peteryates1/jop-spinalhdl/docs/architecture/system-configuration.md

# JOP System Configuration Reference

This document describes the configuration parameters for JOP system generation.
All configuration is via Scala case classes — no external config files are needed.

## Configuration Hierarchy

```
JopConfig                               # Top-level: assembly + systems
├── assembly: SystemAssembly            # Physical hardware (board, FPGA, devices)
│   ├── fpgaBoard: Board                # Board with devices, pin mappings, LEDs
│   └── fpga: FpgaDevice                # FPGA chip (family, package, speed grade)
├── systems: Seq[JopSystem]             # Processor cluster(s)
│   └── JopSystem                       # A single processor system
│       ├── memory: String              # Memory device name or role ("bram" for on-chip)
│       ├── bootMode: BootMode          # Serial, Flash, or Simulation
│       ├── clkFreq: HertzNumber        # System clock frequency (after PLL)
│       ├── cpuCnt: Int                 # Number of CPU cores
│       ├── coreConfig: JopCoreConfig   # Default core configuration
│       ├── perCoreConfigs: Option[Seq[JopCoreConfig]]  # Per-core overrides
│       └── devices: Map[String, DeviceInstance]  # I/O devices (DeviceType + params + board part); core 0 gets them
├── interconnect: Option[InterconnectConfig]  # Cross-system (multi-system only)
└── monitors: Seq[MonitorConfig]        # Hardware monitors (watchdog, etc.)

JopTop(config: JopConfig)              # Unified FPGA top-level Component
├── PLL factory                        # Board-specific PLL BlackBox
├── ResetGenerator                     # 3-bit counter gated by PLL locked
├── JopCluster                         # N cores + arbiter + CmpSync
├── MemoryControllerFactory            # BRAM / SDR / DDR3 dispatch
└── HangDetector                       # Optional diagnostic UART mux

JopCluster                             # Instantiated by JopTop
├── cpuCnt: Int                        # Number of CPU cores
├── baseConfig: JopCoreConfig          # Shared core configuration
│   ├── memConfig: JopMemoryConfig     # Memory layout and bus parameters
│   ├── devices: Map[String, DeviceInstance]  # This core's I/O devices (empty: core 0 takes the system's)
│   ├── useStackCache: Boolean         # 3-bank rotating stack cache with DMA spill/fill
│   └── useIhlu: Boolean               # Per-object hardware locking (vs global lock)
├── debugConfig: DebugConfig           # Optional on-chip debug subsystem
└── separateStackDmaBus: Boolean       # Separate BMB bus for stack DMA (test harness only)
```

### Verilog Generation

All Verilog is generated through `JopTopVerilog` with named presets:

```bash
sbt "runMain jop.system.JopTopVerilog <preset> [args]"
```

| Preset | Board | Memory | Entity Name |
|---|---|---|---|
| `ep4cgx150Serial` | QMTECH EP4CGX150 | SDR SDRAM | `JopSdramTop` |
| `ep4cgx150Smp N` | QMTECH EP4CGX150 | SDR SDRAM | `JopSmpSdramTop` |
| `ep4cgx150HwMath` | QMTECH EP4CGX150 | SDR SDRAM | `JopSdramTop` |
| `ep4cgx150HwFloat` | QMTECH EP4CGX150 | SDR SDRAM | `JopSdramTop` |
| `cyc5000Serial` | Trenz CYC5000 | SDR SDRAM | `JopCyc5000Top` |
| `auSerial` | Alchitry Au V2 | DDR3 | `JopDdr3Top` |
| `wukongSdram` | Wukong XC7A100T | SDR SDRAM | `JopSdramWukongTop` |
| `wukongDdr3` | Wukong XC7A100T | DDR3 | `JopDdr3WukongTop` |
| `wukongBram` | Wukong XC7A100T | BRAM | `JopBramWukongTop` |
| `wukongDdr3AllCu` | Wukong XC7A100T | DDR3 | `JopDdr3WukongTop` |
| `wukongSdrAllCu` | Wukong XC7A100T | SDR SDRAM | `JopSdramWukongTop` |
| `wukongFull` | Wukong XC7A100T | DDR3 | `JopDdr3WukongTop` |
| `wukongSdrFull` | Wukong XC7A100T | SDR SDRAM | `JopSdramWukongTop` |
| `wukongSmp N` | Wukong XC7A100T | DDR3 | `JopSmpDdr3WukongTop` |
| `wukongDualIndependent` | Wukong XC7A100T | DDR3 + SDR | `JopDualWukongTop` |
| `wukongDualSmp N` | Wukong XC7A100T | DDR3 + SDR | `JopDualWukongTop` |
| `ep4cgx150DbFull` | QMTECH EP4CGX150 + DB_FPGA V4 | SDR SDRAM | `JopSdramTop` |
| `ep4cgx150DbV5Mii`, `ep4cgx150DbV5Eth` | QMTECH EP4CGX150 + DB_FPGA V5 | SDR SDRAM | `JopSdramTop` |
| `ae115fbDdr2`, `ae115fbDdr2Eth` | A-E115FB EP4CE115 | DDR2 | `JopDdr2Ae115fbTop` |
| `xc7a100tDbSerial`, `xc7a100tDbEth` | QMTECH XC7A100T + DB_FPGA V5 | DDR3 | `JopDdr3Top` |
| `colorlightI5Sdram` | Colorlight i5 (ECP5) | SDR SDRAM | `JopSdramI5Top` |
| `colorlightDbI9PlusSdram`, `colorlightDbI9PlusEth` | Colorlight i9+ (XC7A50T) on its base board | SDR SDRAM | `JopSdramI9PlusTop` |
| `minimum` | QMTECH EP4CGX150 | SDR SDRAM | `JopSdramTop` |
| `max1000Sdram` | Arrow MAX1000 | SDR SDRAM | `JopMax1000SdramTop` |
| `ep4ce6Sdram` | Generic EP4CE6 | SDR SDRAM | `JopEp4ce6SdramTop` |

This is a selection: the `match` in `JopTopVerilog.scala` is the complete list
(about fifty presets). The entity name is derived, not chosen —
`JopConfig.entityName` builds `Jop[Smp]<memory><board>Top` — so presets for one
board share it.

The `max1000Sdram` and `ep4ce6Sdram` presets use `smallFpgaMemConfig` which disables
object and array caches (`useOcache = false`, `useAcache = false`) to save ~1,900 LEs.
They also auto-select `MemoryStyle.AlteraLpm` for BRAM inference via LPM megafunctions.

Entity names are backward-compatible with existing Quartus/Vivado projects.

## Memory Layout

### Physical Address Space

JOP uses a 32-bit address space partitioned by the top 2 bits:

| Bits [31:30] | Range | Use |
|:---:|---|---|
| `00` | `0x00000000`–`0x3FFFFFFF` | Main memory (BRAM / SDRAM / DDR3) |
| `01` | `0x40000000`–`0x7FFFFFFF` | Reserved |
| `10` | `0x80000000`–`0xBFFFFFFF` | Scratchpad RAM (4KB) |
| `11` | `0xC0000000`–`0xFFFFFFFF` | I/O space |

### Main Memory Map

Without stack cache (`useStackCache = false`):

```
Word Address
0x000000  ┌──────────────────┐
          │   .jop program   │  Code, class data, constants
          │                  │
appEnd    ├──────────────────┤
          │  Handle area     │  handle_cnt * 8 words
          ├──────────────────┤
          │     Heap         │  Object/array data (GC managed)
          │  (grows up →)    │
mem_size  └──────────────────┘
```

With stack cache and per-core stack regions (`stackRegionWordsPerCore > 0`):

```
Word Address
0x000000  ┌──────────────────┐
          │   .jop program   │  Code, class data, constants
          │                  │
appEnd    ├──────────────────┤
          │   Handle area    │  handle_cnt * 8 words
          ├──────────────────┤
          │       Heap       │  Object/array data (GC managed)
          │   (grows up →)   │
memEnd    ├──────────────────┤  memEnd = memWords - cpuCnt * stackRegion
          │  Core N-1 stack  │  Highest-numbered core (lowest address)
          ├──────────────────┤
          │       ...        │
          ├──────────────────┤
          │  Core 1 stack    │
          ├──────────────────┤
          │  Core 0 stack    │  Core 0 at highest address
memWords  └──────────────────┘  Top of physical memory
```

The Java runtime reads `IO_MEM_SIZE` (Sys register 14) to determine `memEnd`.
When `IO_MEM_SIZE` returns 0, `Startup` falls back to `appEnd + 262144`, 1 MB of
heap past the image. JopSim answers the register too, with the end of its own
memory, since 2026-11-11 ([item 154](../current-status.md#item-154)).

### Stack Cache Spill Addressing

Each core's stack spill region starts at `spillBaseAddr` and grows upward:

```
spillBaseAddr = memWords - (cpuId + 1) * stackRegionWordsPerCore
```

Within the region, bank data is written at offset `(bankBase - scratchSize)` words
from `spillBaseAddr`. The 3-bank rotating cache spills/fills individual 192-word
banks via DMA as the virtual stack pointer crosses bank boundaries.

## JopCoreConfig

Unified configuration for a single JOP core. Defined in `jop/config/JopCoreConfig.scala`.

### Core Parameters

| Parameter | Type | Default | Description |
|---|---|---|---|
| `dataWidth` | Int | 32 | Data path width (fixed) |
| `pcWidth` | Int | 11 | Microcode PC width (2K ROM) |
| `instrWidth` | Int | 10 | Microcode instruction width |
| `jpcWidth` | Int | **13** | Java PC width (**8KB** method cache). Was 11 (2KB) until 2026-08-20; raising it is worth **+35 % Kfl** — see current-status item 51 |
| `ramWidth` | Int | 8 | Stack RAM address width (256 entries) |
| `blockBits` | Int | **6** | Method cache block bits (**64 blocks** x 32 words). Block COUNT caps how many methods are resident, and is the parameter that mattered. Costs LUTs (a comparator per block); `jpcWidth` costs only BRAM — see [tuning-guide.md](tuning-guide.md) |

### Memory and I/O

| Parameter | Type | Default | Description |
|---|---|---|---|
| `memConfig` | JopMemoryConfig | default | Memory system configuration |
| `devices` | Map[String, DeviceInstance] | empty | This core's I/O devices, e.g. `"eth" -> DeviceInstance(DeviceType.Ethernet, params = Map("gmii" -> true))`. Empty on core 0 means the system's `devices` |
| `clkFreq` | HertzNumber | 100 MHz | System clock frequency (for Sys microsecond prescaler) |
| `supersetJumpTable` | JumpTableInitData | simulation | Superset jump table (all HW handlers present). Patched by `resolveJumpTable()`. |

### CPU

| Parameter | Type | Default | Description |
|---|---|---|---|
| `cpuId` | Int | 0 | CPU identifier (set per-core by JopCluster) |
| `cpuCnt` | Int | 1 | Total CPU count (set by JopCluster) |

### Feature Flags

| Parameter | Type | Default | Description |
|---|---|---|---|
| `useIhlu` | Boolean | false | Use IHLU per-object lock (vs CmpSync global lock) |
| `useStackCache` | Boolean | false | Enable 3-bank rotating stack cache with DMA |
| `spillBaseAddrOverride` | Option[Int] | None | Override spill address (e.g., `Some(0)` for dedicated spill BRAM) |
| `useDspMul` | Boolean | false | Use 1-cycle DSP multiplier in ALU (bypasses CU for imul) |
| `useSyncRam` | Option[Boolean] | None | Stack RAM read mode: `None` = auto (always sync), `Some(true)` = force readSync, `Some(false)` = force readAsync. Auto-resolved by `JopConfig.resolvedSystems`. |
| `memoryStyle` | Option[MemoryStyle] | None | Memory primitive style: `None` = auto (AlteraLpm for Altera, Generic for others). `AlteraLpm` instantiates `lpm_rom`/`lpm_ram_dp` BlackBoxes with .mif initialization (required for MAX10 BRAM inference). `Generic` uses SpinalHDL `Mem` with init. Auto-resolved by `JopConfig.resolvedSystems` from FPGA manufacturer. |

### Per-Bytecode Implementation Fields

Each field selects the `Implementation` for one bytecode (see below).

**Integer** (IntegerComputeUnit):

| Parameter | Default | Description |
|---|---|---|
| `imul` | Microcode | Microcode=shift-add ~35cyc, Hardware=CU ~22cyc or DSP 2cyc |
| `idiv` | Hardware | Hardware=IntegerComputeUnit DivUnit ~36cyc |
| `irem` | Hardware | Hardware=IntegerComputeUnit DivUnit ~36cyc |

**Float** (FloatComputeUnit):

| Parameter | Default | Description |
|---|---|---|
| `fadd` | Java | IEEE 754 single-precision add |
| `fsub` | Java | IEEE 754 single-precision subtract |
| `fmul` | Java | IEEE 754 single-precision multiply |
| `fdiv` | Java | IEEE 754 single-precision divide |
| `fneg` | Java | Hardware = microcode XOR sign bit (no CU needed) |
| `i2f` | Java | int-to-float conversion |
| `f2i` | Java | float-to-int conversion |
| `fcmpl` | Java | float compare (NaN → -1) |
| `fcmpg` | Java | float compare (NaN → 1) |

**Long** (LongComputeUnit):

| Parameter | Default | Description |
|---|---|---|
| `ladd` | Microcode | 64-bit add |
| `lsub` | Microcode | 64-bit subtract |
| `lmul` | Microcode | 64-bit multiply |
| `lneg` | Microcode | 64-bit negate (implemented as lsub(0L - value)) |
| `lshl` | Microcode | 64-bit shift left |
| `lshr` | Microcode | 64-bit arithmetic shift right |
| `lushr` | Microcode | 64-bit logical shift right |
| `lcmp` | Microcode | 64-bit compare |

**Double** (DoubleComputeUnit):

| Parameter | Default | Description |
|---|---|---|
| `dadd` | Java | IEEE 754 double-precision add |
| `dsub` | Java | IEEE 754 double-precision subtract |
| `dmul` | Java | IEEE 754 double-precision multiply |
| `ddiv` | Java | IEEE 754 double-precision divide |
| `i2d` | Java | int-to-double conversion |
| `d2i` | Java | double-to-int conversion |
| `l2d` | Java | long-to-double conversion |
| `d2l` | Java | double-to-long conversion |
| `f2d` | Java | float-to-double conversion |
| `d2f` | Java | double-to-float conversion |
| `dcmpl` | Java | double compare (NaN → -1) |
| `dcmpg` | Java | double compare (NaN → 1) |

### Per-Bytecode Implementation

Every configurable bytecode has three implementation options:

| Option | Jump Table | Meaning |
|---|---|---|
| `Implementation.Java` | sys_noim | JOPizer replaces with invokestatic -> Java runtime |
| `Implementation.Microcode` | alt handler | Pure microcode handler (no HW compute unit) |
| `Implementation.Hardware` | HW handler | Microcode triggers `sthw` -> compute unit |

Not all options are valid for every bytecode:
- **IMP_ASM bytecodes** (imul, long ops): Java is invalid -- JOPizer doesn't replace them
- **IMP_JAVA bytecodes** (double ops): Microcode is invalid -- no SW handler exists

Derived hardware instantiation:
- `needsIntegerCompute` = any of imul/idiv/irem is Hardware -> IntegerComputeUnit
- `needsFloatCompute` = any float op is Hardware -> FloatComputeUnit
- `needsLongCompute` = any long op is Hardware -> LongComputeUnit
- `needsDoubleCompute` = any double op is Hardware -> DoubleComputeUnit

When `useDspMul = true` and `imul = Hardware`, the jump table is patched to a DSP-specific
handler (`imul_dsp`) that uses a 1-cycle DSP multiply instead of the radix-4 iterative path.

### Superset ROM + Jump Table Patching

The old model of per-variant ROMs (simulationFpu, serialDsp, etc.) has been replaced.
Three superset ROMs exist -- one per boot mode (serial, flash, simulation). Each contains
ALL microcode handlers (HW and SW). At elaboration, `resolveJumpTable` patches entries:

| Boot Mode | Superset ROM | Jump Table |
|---|---|---|
| Serial | `JumpTableInitData.serial` | Patched by `resolveJumpTable` |
| Flash | `JumpTableInitData.flash` | Patched by `resolveJumpTable` |
| Simulation | `JumpTableInitData.simulation` | Patched by `resolveJumpTable` |

`resolveJumpTable` reads the per-bytecode `Implementation` from `JopCoreConfig` and patches:
- **Java** -> `disable(bc)` (redirect to sys_noim)
- **Microcode** -> `useAlt(bc)` (use alternate SW handler)
- **Hardware** -> keep default HW handler (or `useDspAlt(bc)` for DSP imul)

## JopMemoryConfig

Memory system parameters. Defined in `jop/memory/JopMemoryConfig.scala`.

| Parameter | Type | Default | Description |
|---|---|---|---|
| `dataWidth` | Int | 32 | Data path width (fixed) |
| `addressWidth` | Int | 24 | Word address width including 2 type bits (24 = 64MB, 28 max = 256MB) |
| `mainMemSize` | BigInt | 8MB | Main memory size in bytes |
| `scratchSize` | BigInt | 4KB | Scratchpad RAM size in bytes |
| `burstLen` | Int | 0 | DMA burst length: 0=BRAM, 4=SDR, 8=DDR3 |
| `useOcache` | Boolean | true | Enable object cache (16-entry, 8 fields) |
| `ocacheWayBits` | Int | 4 | Object cache entries (log2) |
| `ocacheIndexBits` | Int | 3 | Fields per cache entry (log2) |
| `ocacheMaxIndexBits` | Int | 8 | Max field index (256 fields/object) |
| `useAcache` | Boolean | true | Enable array cache (16-entry, 4 elements/line) |
| `acacheWayBits` | Int | 4 | Array cache entries (log2) |
| `acacheFieldBits` | Int | 2 | Elements per cache line (log2) |
| `acacheMaxIndexBits` | Int | 24 | Max array index width |
| `stackRegionWordsPerCore` | Int | 0 | Per-core stack region size in words (0 = legacy) |

### burstLen Values

| Value | Memory Type | Description |
|:---:|---|---|
| 0 | BRAM | Pipelined single-word reads (no burst) |
| 4 | SDR SDRAM | 4-word burst (16 bytes) |
| 8 | DDR3 | 8-word burst (32 bytes) |

**Note:** `burstLen=0` is incompatible with SMP (`cpuCnt > 1`) due to BMB arbiter
interleaving during BC_FILL. SMP requires `burstLen >= 4`.

### stackRegionWordsPerCore

When set to a non-zero value, each core gets a dedicated stack spill region at the
top of main memory. The usable memory for heap is reduced accordingly. The value is
exposed to the Java runtime via the `IO_MEM_SIZE` I/O register.

Recommended values:
- **8192** (32KB) — sufficient for most Java applications
- **16384** (64KB) — deep recursion or large stack frames

## StackCacheConfig

Stack cache parameters (active when `useStackCache = true`).
Defined in `jop/pipeline/StackStage.scala`.

| Parameter | Type | Default | Description |
|---|---|---|---|
| `numBanks` | Int | 3 | Bank count (fixed: active + ready + anti-thrash) |
| `bankSize` | Int | 192 | Usable entries per bank |
| `scratchSize` | Int | 64 | Scratch area size (addresses 0-63, never rotated) |
| `virtualSpWidth` | Int | 16 | Virtual SP/VP/AR register width |
| `spillBaseAddr` | Int | 0x780000 | Spill area base word address (auto-computed) |
| `burstLen` | Int | 4 | DMA burst length (inherited from JopMemoryConfig) |
| `wordAddrWidth` | Int | 24 | Word address width |

The `spillBaseAddr` is normally computed automatically by `JopCoreConfig`:
- **stackRegionWordsPerCore > 0**: `memWords - (cpuId + 1) * stackRegionWordsPerCore`
- **Legacy BRAM** (burstLen=0): `memWords * 3/4 + cpuId * 4096`
- **Legacy SDRAM/DDR3**: `0x780000 + cpuId * 0x8000`

## Device Configuration

I/O devices are declared per-system via `devices: Map[String, DeviceInstance]`.
Device presence queries (`hasUart`, `hasEth`, etc.) are derived from the device map.
Per-core device distribution is handled by `JopSystem.coreConfigs` (core 0 inherits
system devices, cores 1+ empty by default; `perCoreConfigs` with explicit devices overrides).

### Available Device Types

| Device Type | BMB Component | Description |
|---|---|---|
| `uart` | Uart | TX/RX with 16-entry FIFOs |
| `ethernet` | Eth + Mdio | Ethernet MAC (params: `gmii`, `phyDataWidth`) |
| `sdspi` | SdSpi | SD card via SPI mode |
| `sdnative` | SdNative | SD card native 4-bit mode |
| `vgadma` | VgaBmbDma | VGA framebuffer with DMA |
| `vgatext` | VgaText | VGA text-mode controller |
| `cfgflash` | BmbCfgFlash | SPI config flash (W25Q128/SST26) |

### I/O Address Map

Addresses are dynamically allocated by `IoAddressAllocator`. Fixed addresses:

| ioAddr Range | Peripheral | Notes |
|:---:|---|---|
| `0xEE–0xEF` | Boot device (UART or cfgFlash) | Fixed |
| `0xF0–0xFF` | Sys (system registers) | Fixed |
| `0x80–0xED` | Other devices | Dynamically allocated |

## DebugConfig

On-chip debug subsystem. Defined in `jop/debug/DebugConfig.scala`.

| Parameter | Type | Default | Description |
|---|---|---|---|
| `numBreakpoints` | Int | 4 | Hardware breakpoint slots per core (0-8) |
| `baudRate` | Int | 1000000 | Debug UART baud rate in Hz |
| `hasMemAccess` | Boolean | true | Enable BMB master for memory access |

## CacheConfig (DDR3 L2)

L2 write-back cache for DDR3 memory path. Defined in `jop/ddr3/CacheConfig.scala`.

| Parameter | Type | Default | Description |
|---|---|---|---|
| `addrWidth` | Int | 28 | Address width in bits |
| `dataWidth` | Int | 128 | Cache line width in bits (must be byte-aligned) |
| `setCount` | Int | 256 | Cache sets (must be power-of-2) |
| `wayCount` | Int | 4 | Associativity (1, 2, or 4 way only) |

## Sys I/O Register Map

System I/O device at base address `0xFFFFFF80` (`Const.IO_BASE`).
4-bit sub-address (registers 0-15).

| Addr | Read | Write | Java Constant |
|:---:|---|---|---|
| 0 | Clock cycle counter | Interrupt enable | `IO_CNT` / `IO_INT_ENA` |
| 1 | Microsecond counter | Timer compare value | `IO_US_CNT` / `IO_TIMER` |
| 2 | Interrupt source number | SW interrupt trigger | `IO_INTNR` / `IO_SWINT` |
| 3 | — | Watchdog | `IO_WD` |
| 4 | Exception type | Exception trigger | `IO_EXCPT` |
| 5 | Lock status (halted, error) | Lock acquire | `IO_LOCK` |
| 6 | CPU ID | Lock release | `IO_CPU_ID` / `IO_UNLOCK` |
| 7 | Signal (boot sync) | Signal set | `IO_SIGNAL` |
| 8 | — | Interrupt mask | `IO_INTMASK` |
| 9 | — | Clear all interrupts | `IO_INTCLEARALL` |
| 10 | — | Deadline | `IO_DEADLINE` |
| 11 | CPU count | — | `IO_CPUCNT` |
| 12 | — | Performance counter reset | `IO_PERFCNT` |
| 13 | — | GC halt (freeze other cores) | `IO_GC_HALT` |
| 14 | Usable memory end (words) | — | `IO_MEM_SIZE` |
| 15 | FPU capability (1=present) | — | `IO_FPU_CAP` |

## Board Configurations (JopConfig Presets)

All board configurations are defined as `JopConfig` presets in `jop/config/JopConfig.scala`.
The unified `JopTop(config)` component handles all boards — no per-board top files needed.

### QMTECH EP4CGX150 — SDR SDRAM (Primary)

```scala
JopConfig.ep4cgx150Serial
// JopConfig(
//   assembly = SystemAssembly.qmtechWithDb,
//   systems = Seq(JopSystem(
//     name = "main", memory = "W9825G6JH6", bootMode = BootMode.Serial,
//     clkFreq = 80 MHz,
//     drivers = Seq(DeviceDriver.Uart, DeviceDriver.EthGmii, DeviceDriver.SdNative))))
// SDRAM: W9825G6JH6, 256Mbit, CAS=3
// SMP: JopConfig.ep4cgx150Smp(n) for 2-16 cores
```

### Trenz CYC5000 — SDR SDRAM

```scala
JopConfig.cyc5000Serial
// JopConfig(
//   assembly = SystemAssembly.cyc5000,
//   systems = Seq(JopSystem(
//     name = "main", memory = "W9864G6JT", bootMode = BootMode.Serial,
//     clkFreq = 100 MHz, drivers = Seq(DeviceDriver.UartFt2232))))
// SDRAM: W9864G6JT, 64Mbit, CAS=2
```

### Alchitry Au V2 — DDR3

```scala
JopConfig.auSerial
// JopConfig(
//   assembly = SystemAssembly.alchitryAuV2,
//   systems = Seq(JopSystem(
//     name = "main", memory = "MT41K128M16JT-125:K", bootMode = BootMode.Serial,
//     clkFreq = 250/3 MHz, drivers = Seq(DeviceDriver.UartFt2232))))
// DDR3: MT41K128M16JT, 2Gbit (256MB)
// Write-back cache: 32KB L2 (4-way, 512 sets)
// GC: MAX_HANDLES=65536 caps handle table for large memory
```

### QMTECH XC7A100T Wukong V3 — DDR3 / SDR / BRAM

```scala
JopConfig.wukongDdr3     // DDR3 via MIG, WukongMigBlackBox (no CS pin)
JopConfig.wukongSdram    // SDR SDRAM via SdramCtrlNoCke
JopConfig.wukongBram     // On-chip BRAM (simulation boot mode)
JopConfig.wukongFull     // DDR3 + full HW: ICU+FCU+LCU+DCU+DSP imul, Ethernet, SD
JopConfig.wukongSdrFull  // SDR + full HW: ICU+FCU+LCU+DCU+DSP imul, Ethernet, SD
// All single-system use SystemAssembly.wukong with DeviceDriver.UartCh340

// Dual-cluster (two independent JOP clusters in one bitstream):
JopConfig.wukongDualIndependent  // DDR3 + SDR, both 100 MHz, IDENTICAL cores, 1+1
JopConfig.wukongDualSmp(n)       // DDR3 (all CUs, 100 MHz) + SDR (no CUs, 80 MHz), N+N cores
// wukongDualIndependent is a MEASUREMENT rig: it exists to compare two memory
// systems on one die, so both halves must stay identical in everything except
// the memory (idiv/irem=hw, no DSP multiply, same clock, perf counters on).
// It used to differ -- all CUs one side, defaults the other -- which put a
// compute difference inside a memory experiment. Do not re-introduce one.
// DDR3 -> PICO_UART1 (F4/H4), SDR -> J11_UART (A5/A4): the CH340N at E3/F3 is
// hardwired on the PCB and cannot be tapped, so the on-board Pico 2 W provides
// both ports and the two halves can be profiled simultaneously.
// Entity name: JopDualWukongTop
```

### Compute Unit Presets

| Preset | Compute Units | Notes |
|---|---|---|
| `ep4cgx150HwMath` | ICU (idiv+irem) | IntegerComputeUnit only |
| `ep4cgx150HwFloat` | ICU + FCU | Integer + Float compute |
| `wukongFull` | ICU + FCU + LCU + DCU + DSP imul | All 4 CUs + DSP multiply |
| `wukongSdrFull` | ICU + FCU + LCU + DCU + DSP imul | SDR variant of wukongFull |
| `minimum` | None | Pure microcode imul, Java idiv/irem |

### Minimum Resources

```scala
JopConfig.minimum  // Pure microcode imul, Java idiv/irem, UART only
```

### Simulation Harnesses

```scala
// Unified JopTop BRAM simulation (JopTopBramSim)
JopTop(
  config = JopConfig.wukongBram,
  romInit = romData, ramInit = ramData,
  mainMemInit = Some(mainMemData), mainMemSize = 256 * 1024,
  simulation = true  // Bypasses PLL/reset/MIG for Verilator
)

// Legacy BRAM simulation (JopCoreTestHarness — still works)
JopCoreConfig(
  memConfig = JopMemoryConfig(mainMemSize = 256 * 1024)  // 256KB
)

// Stack cache simulation (JopStackCacheTestHarness)
JopCoreConfig(
  memConfig = JopMemoryConfig(mainMemSize = 512 * 1024),
  useStackCache = true,
  spillBaseAddrOverride = Some(0)  // Dedicated spill BRAM at address 0
)
// Uses separateStackDmaBus=true with 64KB dedicated spill BRAM
```

## JopCluster

System-level integration. Defined in `jop/system/JopCluster.scala`.

| Parameter | Type | Default | Description |
|---|---|---|---|
| `cpuCnt` | Int | (required) | Number of CPU cores (1 = single-core, 2+ = SMP) |
| `baseConfig` | JopCoreConfig | (required) | Base core config (cpuId/cpuCnt overridden per core) |
| `debugConfig` | Option[DebugConfig] | None | Debug subsystem (None = no debug, zero cost) |
| `romInit` | Option[Seq[BigInt]] | None | Microcode ROM initialization |
| `ramInit` | Option[Seq[BigInt]] | None | Stack RAM initialization |
| `jbcInit` | Option[Seq[BigInt]] | None | JBC RAM initialization |
| `separateStackDmaBus` | Boolean | false | Route stack DMA to separate BMB port |
| `perCoreConfigs` | Option[Seq[JopCoreConfig]] | None | Per-core config overrides (devices, bytecodes) |

### SMP Behaviour

- **cpuCnt = 1**: Direct BMB connection (no arbiter overhead)
- **cpuCnt >= 2**: Round-robin BMB arbiter + CmpSync (or IHLU) for synchronization
- Each core gets a unique `cpuId` (0 to cpuCnt-1)
- Devices are per-core: core 0 inherits system `devices`, cores 1+ get empty by default
- Per-core UART: put UART in each core's `perCoreConfigs` devices for SMP debug
- Boot: Core 0 runs init; other cores wait for `IO_SIGNAL`
