peteryates1/jop-spinalhdl/docs/architecture/dual-subsystem-design.md

# Dual-Subsystem Architecture

**Status**: Implemented (Phase 2) — dual independent clusters running concurrently.

**Target board**: QMTECH XC7A100T Wukong V3 (DDR3 + SDR SDRAM on-board).

## Contents

- [Overview](#overview)
- [Motivation](#motivation)
- [Architecture](#architecture)
  - [SDR Subsystem — I/O Cores](#sdr-subsystem--io-cores)
  - [DDR3 Subsystem — Compute Cores](#ddr3-subsystem--compute-cores)
  - [Inter-Subsystem Message Queues](#inter-subsystem-message-queues)
  - [Independent Watchdog FSM](#independent-watchdog-fsm)
- [Hardware Resources](#hardware-resources)
  - [Memory Bandwidth Budget](#memory-bandwidth-budget)
  - [FPGA Resource Budget](#fpga-resource-budget)
- [Software Model](#software-model)
  - [Message Queue I/O Registers](#message-queue-io-registers)
  - [Work Offload Pattern](#work-offload-pattern)
  - [Boot Sequence](#boot-sequence)
- [Implementation Plan](#implementation-plan)
- [Future Extensions](#future-extensions)

## Overview

The QMTECH Wukong V3 board has two independent memory subsystems on-board:
DDR3 (256 MB, 1.35V, Bank 16) and SDR SDRAM (32 MB, 3.3V, Bank 15). This
design exploits both by running two independent JOP clusters — lightweight
cores on SDR for I/O tasks, heavyweight cores on DDR3 for computation — with
FIFO-based message passing and an independent hardware watchdog.

```
┌──────────────────────────────┐    ┌──────────────────────────────┐
│     SDR SDRAM Subsystem      │    │      DDR3 Subsystem          │
│        (100 MHz)             │    │        (100 MHz)             │
│                              │    │                              │
│  Light JOP cores (1-4)       │    │  Heavy JOP cores (1-4)       │
│  - Integer-only microcode    │    │  - DSP multiply              │
│  - No compute units          │    │  - HW integer divider        │
│  - Small method cache        │    │  - Long/Float/Double units   │
│                              │    │  - Larger caches             │
│  I/O peripherals:            │    │  Compute duties:             │
│  - Ethernet (GMII)           │    │  - Application logic         │
│  - SD card (native 4-bit)    │    │  - Math-heavy workloads      │
│  - UART (USB CH340N)         │    │  - Data processing           │
│  - VGA text (80x30)          │    │  - VGA DMA framebuffer       │
│  - GPIO / LEDs               │    │                              │
│                              │    │                              │
│   tx_fifo ──────────────────────────────────────────► rx_fifo    │
│   rx_fifo ◄────────────────────────────────────────── tx_fifo    │
│                              │    │                              │
│   heartbeat ─┐               │    │               ┌─ heartbeat   │
│              │               │    │               │              │
└──────────────┼───────────────┘    └───────────────┼──────────────┘
               │                                    │
        ┌──────┴────────────────────────────────────┴──────┐
        │              Watchdog FSM (pure RTL)             │
        │                                                  │
        │  heartbeat_sdr ──► timeout counter ──► reset_sdr │
        │  heartbeat_ddr3 ──► timeout counter ──► reset_ddr│
        │                                                  │
        │  Clock: raw 50 MHz oscillator (independent)      │
        │  Outputs: reset_n, status LEDs, error flag       │
        └──────────────────────────────────────────────────┘
```

## Motivation

### Heterogeneous Core Complexity

JOP cores vary significantly depending on which bytecode compute units are
enabled:

| Core Variant | Compute Units | Approx. LUTs | Approx. BRAMs |
|---|---|---|---|
| Minimal (integer-only) | None | ~2,000 | ~6 |
| With DSP multiply | `IntMul` | ~2,500 | ~6 |
| With DSP mul + HW div | `IntMul` + `IntDiv` | ~3,500 | ~6 |
| Full (Long/Float/Double) | All | ~10,000-15,000 | ~15-20 |

Putting heavyweight cores on I/O polling tasks wastes FPGA resources. A light
core handles Ethernet MAC polling, SD card transfers, and UART I/O just as
effectively as a full core — bytecodes like `getfield`, `putfield`, `iaload`,
`iastore`, and I/O reads/writes are all integer operations.

### Fault Isolation

Two independent subsystems provide natural fault domains:

- A runaway computation on DDR3 cannot starve I/O cores of memory bandwidth
- A misbehaving peripheral cannot crash the compute subsystem
- The watchdog FSM is pure RTL with no software — nothing can crash it
- Either subsystem can be independently reset without affecting the other

### Bandwidth Matching

| Memory | Peak BW | Effective BW | Suitable For |
|---|---|---|---|
| SDR SDRAM (16-bit, 100 MHz) | ~400 MB/s | ~100-130 MB/s | I/O + 1-4 light cores |
| DDR3 (16-bit, DDR3-1333) | ~2,670 MB/s | ~1,600-1,900 MB/s | Compute + 1-4 heavy cores |

Ethernet at 1 Gbps is ~125 MB/s — SDR handles this alongside a few light
cores. DDR3 is free for computation without I/O contention.

## Architecture

### SDR Subsystem — I/O Cores

Runs on the existing JOP SDRAM controller (`JopSdramTop` style), 100 MHz
system clock derived from the 50 MHz oscillator via PLL.

**Cores**: 1-4 lightweight JOP cores with integer-only microcode. No DSP
multiply, no HW divider, no floating-point units. Stack cache optional
(DMA burst length 4 for SDR).

**Peripherals** (directly connected via BMB I/O):
- Ethernet MAC (GMII, RTL8211EG PHY)
- SD card (native 4-bit interface)
- UART (CH340N USB bridge)
- VGA text controller (80x30, optional)
- GPIO (LEDs, buttons)
- Message queue registers (to DDR3 subsystem)
- Watchdog heartbeat register

**Memory map**: Standard JOP layout — code + heap in SDR SDRAM, I/O at
`0xC0000000`, scratchpad at `0x80000000`.

### DDR3 Subsystem — Compute Cores

Runs on the DDR3 MIG controller (`JopDdr3Top` style), 100 MHz system clock
from MIG `ui_clk`. LruCacheCore L2 cache between BMB arbiter and MIG.

**Cores**: 1-4 heavyweight JOP cores with full compute units enabled:
- DSP multiply (`useDspMul = true`)
- HW integer divider (`useHwDiv = true`)
- Long arithmetic unit (future)
- Float unit (future)
- Double unit (future)

Uses `perCoreConfigs` if cores need different compute unit mixes.

**Peripherals** (minimal I/O):
- Message queue registers (to SDR subsystem)
- Watchdog heartbeat register
- VGA DMA framebuffer (optional — 640x480 or 1080p@30 depending on use case)
- Debug UART (optional, separate from main UART)

**Memory map**: Standard JOP layout — code + heap in DDR3, I/O at
`0xC0000000`, scratchpad at `0x80000000`.

### Inter-Subsystem Message Queues

Two `StreamFifoCC` instances provide bidirectional clock-domain-crossing
communication between the 100 MHz SDR domain and 100 MHz DDR3 domain.

```
     SDR domain (100 MHz)             DDR3 domain (100 MHz)
           │                                   │
           ├──► StreamFifoCC(32 bits, depth N) ►│   SDR → DDR3
           │                                   │
           │◄── StreamFifoCC(32 bits, depth N) ◄┤   DDR3 → SDR
           │                                   │
```

**FIFO parameters**:
- Data width: 32 bits (one JOP word per entry)
- Depth: 16-64 entries (configurable, power of 2 for StreamFifoCC)
- CDC: Gray-code pointer synchronization (built into StreamFifoCC)

**Message format** (application-defined, example):

| Word | Content |
|---|---|
| 0 | Command / message type (upper 8 bits) + length (lower 24 bits) |
| 1..N | Payload words |

Multi-word messages are sent as sequential FIFO pushes. Software is
responsible for framing — the hardware just moves words.

**Backpressure**: StreamFifoCC provides `full` and `empty` signals. Software
polls status before push/pop. No flow control beyond FIFO capacity — sender
must check `full` before writing.

### Independent Watchdog FSM

A pure-RTL finite state machine, outside both JOP clusters, clocked from the
raw 50 MHz oscillator (not from either PLL). This ensures the watchdog runs
even if a PLL loses lock.

**Inputs**:
- `heartbeat_sdr` — toggle signal from SDR subsystem (synchronized to 50 MHz)
- `heartbeat_ddr3` — toggle signal from DDR3 subsystem (synchronized to 50 MHz)

**Outputs**:
- `reset_sdr_n` — active-low reset to SDR subsystem
- `reset_ddr3_n` — active-low reset to DDR3 subsystem
- `status_leds[1:0]` — alive indicators (directly on board LEDs)
- `wd_error` — sticky error flag (optional, directly readable)

**Operation**:
1. Each subsystem toggles its heartbeat register periodically (e.g. every
   10 ms from a timer interrupt or a software loop)
2. The watchdog detects toggles via edge detection (XOR with previous sample)
3. Each toggle resets that subsystem's timeout counter
4. If a counter reaches the timeout threshold (e.g. 50 ms at 50 MHz =
   2,500,000 cycles), the watchdog asserts reset for that subsystem
5. Reset is held for a minimum pulse width (e.g. 1 ms), then released
6. Optional: if one subsystem fails N consecutive times, reset both

**Resource cost**: ~50 LUTs, 2 synchronizer chains, 2 counters. Negligible.

**Software interface**: Each subsystem has a single I/O register. Writing any
value toggles the heartbeat output. Typical usage:

```java
// In main loop or timer interrupt
Native.wr(heartbeat, Native.rd(heartbeat) ^ 1);
```

## Hardware Resources

### Memory Bandwidth Budget

**SDR Subsystem** (W9825G6KH-6, 16-bit, 100 MHz — bandwidth figures below were
computed at the original 80 MHz and have not been rescaled):

| Consumer | Bandwidth | Notes |
|---|---|---|
| 2 light JOP cores | ~100-150 MB/s | ~50-75 MB/s per core |
| Ethernet DMA | ~125 MB/s | 1 Gbps wire rate, bursty |
| VGA text | ~2 MB/s | 80x30 @ 60 Hz, minimal |
| **Total** | ~230-280 MB/s | Fits in ~320 MB/s peak |

With 2 light cores and Ethernet, SDR utilization is ~70-85%. A third core is
possible if Ethernet traffic is bursty (typical). Four cores would need
careful bandwidth management.

**DDR3 Subsystem** (MT41K128M16JT-125, 16-bit, DDR3-1333):

| Consumer | Bandwidth | Notes |
|---|---|---|
| 4 heavy JOP cores | ~200-400 MB/s | ~50-100 MB/s per core |
| VGA DMA (optional) | ~50-150 MB/s | 640x480: 50, 1080p@30: 150 |
| **Total** | ~250-550 MB/s | Well within ~1,600 MB/s effective |

DDR3 utilization with 4 heavy cores + VGA DMA is ~15-35%. Substantial
headroom for memory-intensive workloads or more cores.

### FPGA Resource Budget

XC7A100T-FGG676: 63,400 LUTs, 135,680 FFs, 270 BRAMs (36Kb), 240 DSP48E1.

| Component | LUTs | BRAMs | DSP48 | Notes |
|---|---|---|---|---|
| **SDR Subsystem** | | | | |
| SDR memory controller | ~500 | 0 | 0 | |
| 2x light JOP cores | ~4,000 | ~12 | 0 | Integer-only |
| Ethernet MAC + buffers | ~2,000 | ~4 | 0 | |
| SD card controller | ~500 | ~1 | 0 | |
| UART + VGA text | ~1,000 | ~4 | 0 | Including font ROM |
| BMB arbiter + I/O | ~500 | 0 | 0 | |
| **SDR subtotal** | **~8,500** | **~21** | **0** | |
| **DDR3 Subsystem** | | | | |
| MIG controller | ~5,000 | ~5 | 0 | Xilinx IP |
| LruCacheCore L2 | ~2,000 | ~8 | 0 | 16KB 4-way |
| 2x heavy JOP cores | ~20,000-30,000 | ~30-40 | ~8-16 | Full compute |
| VGA DMA (optional) | ~1,000 | ~2 | 0 | |
| BMB arbiter + I/O | ~500 | 0 | 0 | |
| **DDR3 subtotal** | **~28,500-38,500** | **~45-55** | **~8-16** | |
| **Shared** | | | | |
| Message FIFOs (2x) | ~200 | 0 | 0 | Distributed RAM |
| Watchdog FSM | ~50 | 0 | 0 | |
| PLLs (3x) | 0 | 0 | 0 | MMCM primitives |
| **Shared subtotal** | **~250** | **0** | **0** | |
| | | | | |
| **Total** | **~37,000-47,000** | **~66-76** | **~8-16** | |
| **Available** | 63,400 | 270 | 240 | |
| **Utilization** | 58-74% | 24-28% | 3-7% | |

Comfortable fit. Room for additional cores or larger compute units.

## Software Model

### Message Queue I/O Registers

Each subsystem sees the message queue as memory-mapped I/O registers:

| Offset | Register | R/W | Description |
|---|---|---|---|
| +0 | `MSG_STATUS` | R | Bit 0: TX FIFO full, Bit 1: RX FIFO empty |
| +1 | `MSG_TX` | W | Push one word to TX FIFO (SDR→DDR3 or DDR3→SDR) |
| +2 | `MSG_RX` | R | Pop one word from RX FIFO |

```java
public class MsgQueue {
    public static final int IO_MSG = IO_BASE + 0x50;  // example offset

    public static boolean canSend() {
        return (Native.rd(IO_MSG) & 1) == 0;  // TX not full
    }

    public static boolean hasMessage() {
        return (Native.rd(IO_MSG) & 2) == 0;  // RX not empty
    }

    public static void send(int word) {
        Native.wr(IO_MSG + 1, word);
    }

    public static int receive() {
        return Native.rd(IO_MSG + 2);
    }
}
```

### Work Offload Pattern

The I/O subsystem receives external data (Ethernet packet, SD block, sensor
reading) and offloads processing to the compute subsystem:

```
SDR core                          DDR3 core
   │                                  │
   │  receive Ethernet packet         │
   │  extract payload                 │
   │  send(CMD_PROCESS | len)    ──►  │  receive command
   │  send(word0)                ──►  │  receive data
   │  send(word1)                ──►  │  receive data
   │  ...                             │  process...
   │                                  │  send(RSP_RESULT | len)
   │  receive response           ◄──  │  send(result0)
   │  send reply over Ethernet        │
   │                                  │
```

The message protocol is application-defined. The hardware provides raw
word-level FIFO transport.

### Boot Sequence

Both subsystems boot independently from their respective memories:

1. FPGA configuration loads bitstream from SPI flash
2. Watchdog FSM releases both resets
3. **SDR subsystem** boots from embedded BRAM (or config flash loader),
   initializes I/O peripherals
4. **DDR3 subsystem** waits for MIG calibration, then boots from BRAM
5. Both subsystems begin toggling heartbeat
6. SDR subsystem can optionally load DDR3 application code via message
   queue (enables updating compute firmware over Ethernet/SD)

Alternative: both subsystems have their own config flash loader and boot
independently from SPI flash partitions.

## Implementation Status

### Phase 1: Single-Subsystem DDR3 -- DONE

JOP cluster running on DDR3 via MIG on Wukong. Validated DDR3 memory path,
MIG integration, and pin assignments. Serial boot + GC + 59/59 JVM tests.

### Phase 2: Dual Memory Controllers -- DONE

Two independent JOP clusters running concurrently in a single bitstream.
Each cluster has its own clock domain, memory controller, and UART.

**Implementation**:
- `JopTop` extended with multi-system support: iterates `config.systems`,
  instantiating one `JopCluster` + memory controller per system
- Cluster 0 (DDR3): All compute units (ICU+FCU+LCU+DCU+DSP imul), 100 MHz
  (MIG `ui_clk`), CH340N UART (E3/F3)
- Cluster 1 (SDR SDRAM): No compute units, 100 MHz (`sdr_clk`, was `clk_wiz_1`), J11 header
  UART (A5/A4)
- Each cluster boots independently via serial download on its own UART
- Entity name: `JopDualWukongTop`

**Presets**:
- `wukongDualIndependent` — 1 DDR3 core + 1 SDR core (independent serial boot)
- `wukongDualSmp N` — N DDR3 cores + N SDR cores (SMP within each cluster)

**FPGA utilization** (XC7A100T-2FGG676):

| Config | LUTs | % | WNS |
|---|:----:|:-:|:---:|
| 1+1 cores (`wukongDualIndependent`) | 28,043 | 44.2% | +0.034 ns |
| 2+2 cores (`wukongDualSmp 2`) | 46,644 | 73.6% | +0.013 ns |

**FPGA build**:
```bash
cd fpga/qmtech-xc7a100t-wukong
make dual-generate       # sbt "runMain jop.system.JopTopVerilog wukongDualIndependent"
make ddr3-create-ip      # MIG IP (once); each half's PLL is built with the design
make dual-build          # Vivado synth + impl + bitstream
```

**Clock domains**:
- DDR3 cluster: 100 MHz from MIG `ui_clk` (derived from 200 MHz MIG reference)
- SDR cluster: 100 MHz from `sdr_clk` (was `clk_wiz_1`; 50 MHz oscillator input). 80 MHz hangs
  on hardware -- see "Phase 2 Resolved" below before changing this.
- Both PLLs run from the same 50 MHz board oscillator (M21)

#### Phase 2 Debug: SDR Cluster Hang (2026-03-15)

**Symptom**: DDR3 cluster boots and runs "Hello World" successfully. SDR cluster
accepts serial download (XOR checksum passes) but hangs during GC init — UART
outputs `.Small boot.GC init....` then stops.

**Ruled out by simulation and analysis**:

1. **SdramCtrlNoCke logic at 80 MHz**: `JopSdram80MhzSim` passes with burstLen=0
   at 80 MHz. Takes ~9M cycles (vs ~500k with burstLen=4) because every BC_FILL
   word is an individual SDRAM access. Previous 2M cycle limit was too short.
2. **burstLen=0 logic bug**: Sim passes cleanly. The `buildMultiCoreConfigs` sets
   burstLen=0 for single-core SDR, which is correct — just slower.
3. **Generated Verilog wiring**: All clock domains, reset, SDRAM signals, UART MUX
   verified correct in `JopDualWukongTop.v`.
4. **Internal SDR timing**: clk_100_sdr_clk (was clk_100_clk_wiz_1) domain meets timing (WNS=+0.229ns).
   DDR3 domain (clk_pll_i) also meets (WNS=+0.006ns).
5. **Clock phase shift**: -108° at 80 MHz gives 3.75 ns lead (more margin than
   100 MHz's 3.0 ns). W9825G6KH-6 requires 1.5 ns setup, 0.8 ns hold.

**Suspected at the time — DQ writeEnable IOB packing failure** (later disproved,
see below):

The timing report shows 16 failing endpoints, all `chip_sdram_DQ_writeEnable_reg`
paths from clk_100_sdr_clk (was clk_100_clk_wiz_1) to SDRAM output ports. WNS=-0.378ns. The
writeEnable register (at SLICE_X0Y110) controls the DQ tri-state buffer (OBUFT).
Path breakdown: FDRE C→Q (0.379ns) + routing (1.652ns, fanout=16) + OBUFT
(3.347ns) = 5.378ns vs 5.0ns `set_max_delay` constraint.

This is significant because `writeEnable` controls the DQ tri-state direction.
If it switches late, the FPGA may still drive DQ when SDRAM tries to return read
data (bus contention on reads), or the tri-state may not enable in time for
writes (SDRAM sees floating data lines).

The download checksum does NOT detect this — it's computed from UART-received
data, not SDRAM readback. (Confirmed in microcode: `asm/src/jvm.asm:881`
accumulates `b ^= c` from the word just received, immediately after `stmwd`, so a
completely dead SDRAM still returns a correct checksum. Any future "it downloads
but won't run" symptom should skip the checksum as evidence.)

**Test harness**: `JopSdram80MhzSim` — 80 MHz, burstLen=0, 10M cycle limit.

#### Phase 2 Resolved: SDR Cluster Hang (2026-08-08)

**Fix**: run the dual build's SDR cluster at **100 MHz**, not 80 MHz. This is the
frequency the standalone SDR presets have always used. With it, both clusters run
`DoAll` **66/66 concurrently** from a single programming (SDR on the J11 UART at
115200, DDR3 on the CH340 at 2 Mbaud).

The frequency lived in three uncoupled places that had to agree, and nothing
checked them — `sdrClkMhz` in `JopConfig`, the `getOrElse` defaults in
`JopTopVerilog`, and CLKOUT1/CLKOUT2 in `create_sdram_clk_wiz.tcl`. Since
2026-11-02 (status item 173) each half defines its own PLL from its own clock,
and the build makes the IP from that definition: `sdrClkMhz` is the only place.

(Was `create_sdram_clk_wiz_1.tcl` until 2026-08-17. The dual cluster's SDR clock
had been raised 80→100 MHz, making that script config-identical to the standalone
one, so the two were collapsed into a single function-named `sdr_clk` that both
the dual and standalone SDR flows share. The DDR3 cluster's wizard is `ddr3_clk`;
neither can clobber the other now. Since 2026-11-02 each is the design's own,
generated into the build's `ip/` with its Verilog.)

**The IOB-packing suspect above was disproved by measurement.** Opening both
post-route checkpoints and querying the register directly:

| | standalone (**works**) | dual @80 MHz (**hangs**) |
|---|---|---|
| `chip_sdram_DQ_writeEnable_reg` count | 1 | 1 |
| fanout | 17 | 17 |
| placement | SLICE_X48Y57 | SLICE_X0Y110 |
| `IOB` property | unset | TRUE |

Neither design packs the register into an IOB — with fanout 17 it cannot be, as a
tri-state IOB register serves exactly one pin. The *working* design does not pack
it either, and is placed considerably further from the I/O bank. So the packing
failure is real but is not what breaks the cluster.

Also disproved, for the record:

- **The `set_max_delay 5.0` violation is not the fault.** It persisted unchanged
  across the fix (-0.376 ns at 80 MHz, -0.365 ns at 100 MHz) while behaviour went
  from hanging to 66/66. Note the standalone builds do **not** apply this
  constraint at all, so their WNS figures are for unrelated internal core paths
  and must not be compared against the dual's.
- **Clock frequency was not compensating for the phase shift.** Lowering to
  70 MHz (which changes the `sdram_clk` lead from 3.75 to 4.29 ns) moved WNS by
  0.011 ns and did not help — as expected, since `set_max_delay` is an absolute
  budget and cannot be relaxed by slowing the clock.

**The mechanism remains unexplained.** 80 MHz is the *slower*, nominally easier
operating point, it passes in simulation (`JopSdram80MhzSim`), and it meets
internal timing. Only 100 MHz is validated on hardware; treat any other SDR
frequency in this design as unproven until it is run on a board. If 80 MHz is
wanted for the bandwidth/resource reasons in the Motivation section above, it
needs a proper investigation rather than a config change.

### Phase 3: Message Queues -- Future

`StreamFifoCC` pair between subsystems for cross-cluster communication.

### Phase 4: Watchdog FSM -- Future

Independent watchdog clocked from raw 50 MHz oscillator.

### Phase 5: Heterogeneous Cores -- Partially Done

The dual-cluster design already achieves heterogeneous core differentiation:
DDR3 cluster has full compute units, SDR cluster is integer-only. Remaining
work is I/O peripheral migration (Ethernet, SD to SDR cluster only).

## Open Questions

- **Message queue depth**: 16 vs 64 entries — depends on message size and
  latency tolerance. Larger FIFOs buffer more but cost distributed RAM.
- **Shared BRAM vs FIFO-only**: For bulk data (e.g. Ethernet frames), a
  shared dual-port BRAM may be more efficient than streaming through FIFOs.
  Trade-off is added complexity and potential coherence issues.
- **Boot coordination**: Currently both clusters boot independently via
  serial download. Future: SDR subsystem loads DDR3 firmware, or both boot
  from flash partitions.
- **Interrupt vs polling**: Message arrival could trigger an interrupt instead
  of polling. Adds hardware complexity but reduces latency.
- **Watchdog policy**: Should failure of one subsystem reset the other?
  Application-dependent — safety-critical vs fault-tolerant designs differ.

## Future Extensions

- **DVI-D / HDMI output**: Drive HDMI connector from DDR3 subsystem via
  OSERDESE2 TMDS serializers. VGA DMA framebuffer feeds pixel data.
  640x480@60 or 1080p@30 (74.25 MHz pixel clock).

- **Remote firmware update**: SDR I/O core receives new DDR3 firmware
  over Ethernet, loads via message queue, then triggers DDR3 reset.

- **Hardware mailbox**: Extend message queue with interrupt support
  (IRQ on message arrival) to replace polling.

- **Shared memory region**: Small dual-port BRAM accessible from both
  subsystems for bulk data transfer (bypassing FIFO for large payloads).

- **Triple modular redundancy**: Three light cores on SDR with voting
  for safety-critical I/O control.
