peteryates1/jop-spinalhdl/docs/current-status.md

# Where we are

> ## How to read this file
>
> | you want | go to |
> |---|---|
> | **what to work on next** | [§1 Outstanding now](#1-outstanding-now--in-priority-order) — highest first |
> | **whether item N is open** | [§2 All items](#2-all-items--summary) — the scannable index |
> | **why item N is the way it is** | [§3 Item detail](#3-item-detail-and-journals) — summary and gotchas per item |
> | **the full investigation** | `docs/status/item-N.md` — linked from each item that has one |
> | **where NOT to spend effort** | [item 50](#item-50) and [`architecture/tuning-guide.md`](architecture/tuning-guide.md) — the measured negative results |
>
> **Item numbers are stable IDs**, not reading order, and they are referenced
> from other documents and from commit messages. `#item-N` anchors resolve for
> all of them.
>
> **The longest journals live in `docs/status/`** since 2026-08-31 (item 116).
> This file was 9,671 lines and the review auditing it had to be told not to
> open it whole. The summary, the verdict and the gotchas stay here; the
> narrative of how it was found moved out. Nothing was deleted — the split was
> verified byte-identical.
>
> `make check-build` asserts every item is anchored, no anchor is defined twice,
> every `#item-N` link in the repo resolves, no CLOSED item sits in the priority
> list, every journal is present and linked, and §2 lists every item exactly
> once with its Open list equal to §1 (since 2026-10-13).

## 1. Outstanding now — in priority order

One line each, highest first. **This section is the ground truth for what is
open** — an outstanding item from any other document belongs here too, not only
there. Reasoning and journals are in [section 3](#3-item-detail-and-journals);
closed items stay in [section 2](#2-all-items--summary).

The order is a proposal, not a decree. It puts work that CORRECTS OR PROTECTS
THE RECORD first — a wrong answer about the product costs one bug, but a wrong
answer about the evidence costs confidence in every result built on it — then
correctness defects, then capability gaps, then performance. A broken capability
nothing depends on ranks below a measurement that could mislead someone.

1. **[#180](#item-180)** — Fifteen formal properties have never checked anything: an assertion under `pastValidAfterReset()` is first reached at BMC depth 4 (calibrated 2026-11-12: a guarded `assert(False)` passes at 2 and 3), and they run at depth 2 or 3. The jump table's four are fixed with [item 165](#item-165); `ShiftFormal`'s four, six in `StackStageFormal` and one in `Crc8MaximFormal` remain, and the formal job's pass count includes them
2. **[#130](#item-130)** — `JopTop` silently overrides four `memConfig` fields the preset declares, so presets, summaries and harnesses describe a different machine than the one built. Verified against elaborated RTL
3. **[#178](#item-178)** — The JOP cluster carrier (four i9+ on one board, linked by a mesh) is not made yet: one bitstream serves all four sockets, taking its straps and its UART pins from the PCB's tables, and builds clean in Vivado; the PCB netlist matches pin plan v2, and in the layout each link's lines match in length to 1.1 mm. XDC fixes go back to its designer, and bank VCCO, the speed grade, the ETH1 LED pins, the Ethernet pairs' impedance and what the modules' flash holds stay open. Ranked here because the plan has to settle before the board is made
4. **[#110](#item-110)** — Three corpora have never been reviewed (~106k lines: runtime, tools, RTL, microcode). The frem defect lived on a boundary a single-corpus review cannot see
5. **[#119](#item-119)** — The object handle layout is re-expressed in ~25 places across four languages, and the RTL's only use of it has no test, no formal property and no elaboration check
6. **[#138](#item-138)** — The class-struct layout is restated in four languages and header word 1 has no name: `JVMHelp.java:313,322` read it as `rdMem(p+1)`, and nothing ties `CLS_HEAD` to what JOPizer emits. Nothing is broken today; a header reorder would leave a board with no output at all
7. **[#121](#item-121)** — Absent devices all resolve to 0x80 and the `HAS_*` flags meant to guard them are read by nothing
8. **[#122](#item-122)** — `JopCore` and `ConstGenerator` run the I/O allocator over different device sets
9. **[#124](#item-124)** — On Altera the microcode comes from the `.mif`, one call site decides which variant, and the summary omits it
10. **[#125](#item-125)** — `run_bench` hardcodes the baud per board, uses port paths, and can drive the wrong board
11. **[#126](#item-126)** — The baud derivation is never exercised by its own guard: `check-console-baud.sh` passes `BAUD=` explicitly, so `console.mk`'s grep/awk never runs against a real summary
12. **[#113](#item-113)** — `cold-check` covers 3 boards of 12, and the primary board is not one of them
13. **[#112](#item-112)** — `ConstraintDriftTest` covers 2 presets of 46 — the strongest check in the tree, at 4 % coverage
14. **[#82](#item-82)** — Flash boot has been unbuildable since 2026-03-13; a hardware-verified capability deleted as collateral
15. **[#84](#item-84)** — No MAX1000 configuration fits the 10M08 — single-core overflows it by a third
16. **[#73](#item-73)** — `ep4cgx150DbVgaDma` misses timing by −1.011 ns
17. **[#168](#item-168)** — `xc7a100tDbEth` closes timing by luck: -0.058 ns on 10-12, +0.007 ns on the 10-28 rebuild, the same core fetch path with the same directives, so any rebuild can miss again
18. **[#170](#item-170)** — The XC7A100T on the DB_FPGA V5 loses received frames at 1 Gb/s whenever the data toggles -- 28 of 400 random frames, 0 of 400 alternating -- and each loss blacks the receiver out for seconds; TCP fails there. MII at 100 Mb/s (`xc7a100tDbMii`) passes every check, DoAll 68/68. Open: bounding a frame in the MAC so one glitch costs one frame, and a changed TCP echo at 1 Gb/s that passed the stack's checksum
19. **[#179](#item-179)** — A method call and its return cost ~130 cycles — about half of Kfl's cycles, a third of UdpIp's, over a quarter of Lift's — and `idle/direct` is mostly their memory reads. The largest performance lever, and it keeps predictability: on-chip method tables, a hardware call sequencer, inlining at link time ([analysis](analysis/performance-outlook.md))
20. **[#54](#item-54)** — Statics are Kfl's largest stall category (41 %) and no cache touches them. Counted 2026-11-11: the whole region is 1.6-2.3 KB in every image, so one block RAM holds it, worth about 16 % of Kfl's cycles; the SMP design is what is left
21. **[#55](#item-55)** — The core stalls on writes whose result it never uses — about 3.5-5 % of cycles, not the `idle/direct` share first blamed on it, which is reads ([179](#item-179)). Needs read-after-write forwarding and an SMP story
22. **[#64](#item-64)** — `GcStressTest`'s free memory falls **~0.40 bytes/round** on all seven boards measured and never recovers at a minor collection. Since 2026-09-11 the lead is the METRIC, not a leak: `GC.freeMemory()` measures the current semispace gap, which only a flip restores, and the one board that visibly collects shows a flat high-water mark. Two leak candidates are already ruled out: [item 131](#item-131)'s dropped card marks and [item 141](#item-141)'s stray barrier writes
23. **[#167](#item-167)** — REGRESSION: the A-E115FB's minor-GC copy phase is **13.5 % slower** than in August (12.825 ms against 11.300; worst pause 14.96 ms, still inside the 20 ms target). Cause not isolated: settle it with a control build at the August commit, not by reasoning
24. **[#4](#item-4)** — Copy phase — 79-82% of the minor pause and the dominant remaining term
25. **[#39](#item-39)** — The L2 hit path is serial — 3 cycles per hit, 58-61 % of the DRAM access interval. **[50](#item-50) raises the priority of this**: bytecode fill is a sequential burst and improved only 3 % with a 32 KB L2 in front of DDR3, which is what a 3-cycle hit would predict
26. **[#44](#item-44)** — The compute floor C is per-configuration; re-measure it before trusting any per-operation cost
27. **[#45](#item-45)** — ONE unidentified register is read before it is written; the other ~401 look benign
28. **[#32](#item-32)** — UART corruption on seed 871203250 — no longer reachable, pin removed; cause never found
29. **[#5](#item-5)** — The BMB arbiter sets the clock ceiling — FREQUENCY, not core count
30. **[#31](#item-31)** — The BMB arbiter caps TIMING CLOSURE on both FPGA families (not throughput — see 2026-08-18 note)
31. **[#41](#item-41)** — No 8-core DRAM build closes timing, MSHRs or not, and on DDR2 the 4-core misses too: -3.231 / -5.189 ns at 4 / 8 cores, about 2 ns worse than in August
32. **[#70](#item-70)** — The UART baud is stated three times; console.mk now refuses an unknown one, but the i5 still hardcodes its own
33. **[#67](#item-67)** — `ep4cgx150DbFull` has `useStackCache` off. Its gate, item 14, closed 2026-10-13 — the stack cache is hardware-validated ([item 133](#item-133)) — so turning it on is now a measurement to make
34. **[#75](#item-75)** — `ep4cgx150HwMath` is a byte-identical duplicate of `ep4cgx150Serial`
35. **[#104](#item-104)** — The generators restate board facts as literals: one board's PLL shape, a device-wide I/O standard, a clock port spelled three ways
36. **[#105](#item-105)** — Assembly navigation uses `boards.head` where it means `fpgaBoard`; safe only because every composite lists the core board first
37. **[#106](#item-106)** — The device map is keyed by raw strings in three places — the surviving family of the `"eth"`/`"ethernet"` bug
38. **[#107](#item-107)** — `alchitry-au`'s `bitstream` has no prerequisite on `project` — racy under `make -j`
39. **[#102](#item-102)** — Every preset's generate step depends on `HelloWorld.jop` (`quartus.mk:101`, `vivado.mk:117`), so rebuilding it forces a 30-60 minute refit of serial-boot bitstreams that never contain it. The fix is to ask the generator whether a preset embeds an app
40. **[#3](#item-3)** — Sixteen presets still run classic GC. Safe but slow
41. **[#53](#item-53)** — 4-core Wukong takes `15/6` + `double:java` (64 blocks, DoAll 66/66, 68.5 % LUT). **The preset still does not build at defaults** — threshold needs the 8/12-core data
42. **[#52](#item-52)** — The Java tools hold hand-copied duplicates of the hardware config. Generate them from the preset instead
43. **[#17](#item-17)** — `needs*Compute` predicates understate compute-unit reachability
44. **[#18](#item-18)** — Software/microcode fallback coverage is uneven — 18 of 32 configurables
45. **[#19](#item-19)** — Write the missing `_sw` microcode handlers
46. **[#20](#item-20)** — Decide whether the double group gets microcode at all
47. **[#27](#item-27)** — The `aastore` type check's cost was never measured
48. **[#12](#item-12)** — `LongComputeUnitConfig` has no enable flag for its base 64-bit ALU
49. **[#7](#item-7)** — Root-scan floor: 2.2 / 4.7 / 8.5 ms across SDR / DDR3 / DDR2
50. **[#8](#item-8)** — XC7A100T timing margin is +0.001 ns — one bad run in seven
51. **[#40](#item-40)** — A leaner MSHR entry — each holds a full cache line of write data a read miss never uses
52. **[#42](#item-42)** — Secondary-hit merging is not implemented — a request to a line being filled replays
53. **[#21](#item-21)** — Colorlight i5 is EBR-bound in BRAM-only builds, not logic-bound
54. **[#11](#item-11)** — Application benchmark exists (`java/apps/JbeBench`) — remaining questions it should answer
55. **[#13](#item-13)** — `java/apps/Small` `make clean` deletes `HelloWorld.jop`
56. **[#56](#item-56)** — WBNI: derive the hardware config from the application. **JOPizer static profile DONE**; the remaining bulk is a measurement FRAMEWORK (preferably Java) across the hardware set
57. **[#117](#item-117)** — Nothing prevents an eighth preset that no flow selects
58. **[#115](#item-115)** — Every simulation reports `Elaboration failed (2 errors)` and then succeeds; pre-existing, deterministic, unexplained
59. **[#63](#item-63)** — One unexplained Wukong SDR startup crash in six runs; not reproduced, cause unknown
60. **[#142](#item-142)** — The linked image's `<clinit>` ORDER is decided by hash iteration order in `OldClinitOrder.findOrder()`; any classpath change reshuffles it, and correctness then rests on a dependency analysis that misses `invokeinterface`
61. **[#143](#item-143)** — `setsid` + process-group kill leaks the downloader holding the serial port; the leftover reader then looks exactly like dead hardware
62. **[#149](#item-149)** — Nine Vivado targets read TRACKED constraints, including the DB V5 flagship; item 57 claimed the opposite and the constraint guard reaches only 7 of 12 boards
63. **[#150](#item-150)** — Four test apps and `JopIhluGcBramSim` are executed by nothing, and items 2, 23, 24 and 26 cite them as evidence
64. **[#153](#item-153)** — The Alchitry Au V2's tracked XDC contains no `create_clock`, so its top-level `clk` may be entirely unconstrained; the clk_wiz IP constrains only its own `clk_in` boundary. Any reported timing on that board is suspect until checked
65. **[#159](#item-159)** — The generated Wukong SDR XDC declares no asynchronous clock groups, so every core-to-`sys_clk` crossing is timed; the single-core SDR flows get away with it only because the MMCM happens to give exactly 2x the input clock. Fixed for the SMP flow, latent for the rest
66. **[#155](#item-155)** — `current-status.md` is past **11,000 lines** (2026-10-13), from the 4,828 item 116 left, and many sections exceed the 100-line split threshold in-file. The consistency guards hold; nothing guards SIZE
67. **[#163](#item-163)** — OPTIONAL: restructure the stack cache's same-cycle rotation decisions (victim selection, the SP-mux decision, the spill-region check) so every cached build gets real timing margin instead of ~0.1 ns. Three steps that only pay together; measured, not done

## 2. All items — summary

Scannable index; the numbered sections below carry the reasoning. Each entry
says what is **verified** versus **asserted**, because several things in this
project have looked fine while being wrong.

**Item numbers are stable IDs, not reading order**, and they are written as
`- **N.**` bullets rather than a Markdown ordered list **on purpose**. An
ordered list renumbers from its first marker when rendered, so a source that
read `12. 13. 14. 15. 16. 23.` displayed as `12..17` — item 23 was invisible and
there were two 17s on the page, one of them fictional. Every `item N` reference
in these docs was wrong for anyone reading rendered Markdown. Keep the bullet
form.

IDs are assigned on creation and then grouped by topic, so the page runs 1-16,
24, 25, ... 23, 26, 27, ... 17-22 ... 21. They are referenced from `bugs-and-issues.md`,
the GC design notes and a good many commit messages, so renumbering would
silently invalidate all of that. Use this to find one:

| # | section | # | section | # | section |
|---|---|---|---|---|---|
| 1-3, 34 | Blocking / correctness | 11 | The measurement gap | 21 | Boards |
| 4-7, 24, 25, 37-40, 42, 50, 51, 53-55 | Performance | 12-16, 23, 26, 27, 52, 56, 57 | Smaller | 17-20, 22, 28 | Compute units |
| 8-10, 31, 32, 33, 35, 58 | Hardware / infrastructure | 29, 30, 36 | Smaller (CI flakiness) | | |

**Closed 2026-08-15/16**, the SMP push: **1** (generational GC on SMP — root
cause was `AlteraSdramAdapter`, not the collector), **2** (`JopIhluGcBramSim`
could not fail), **34** (its SDRAM row), **35** (`AlteraSdramAdapter` had no
simulation coverage), **36** (formal-property CI timeout). Still open and
sharpened by that work: **5**/**31** (the arbiter now sets the CLOCK at each core
count rather than capping the count), **3** (presets lacking `hasCardTable`),
**11** (no application benchmark — still gates the arbiter decision).

### Open

Exactly the items in [§1](#1-outstanding-now--in-priority-order), sorted by ID.

- **[3](#item-3)** — Sixteen presets still run classic GC. Safe but slow
- **[4](#item-4)** — Copy phase — 79-82% of the minor pause and the dominant remaining term
- **[5](#item-5)** — The BMB arbiter sets the clock ceiling — FREQUENCY, not core count
- **[7](#item-7)** — Root-scan floor: 2.2 / 4.7 / 8.5 ms across SDR / DDR3 / DDR2
- **[8](#item-8)** — XC7A100T timing margin is +0.001 ns — one bad run in seven
- **[11](#item-11)** — Application benchmark exists (`java/apps/JbeBench`) — remaining questions it should answer
- **[12](#item-12)** — `LongComputeUnitConfig` has no enable flag for its base 64-bit ALU
- **[13](#item-13)** — `java/apps/Small` `make clean` deletes `HelloWorld.jop`
- **[17](#item-17)** — `needs*Compute` predicates understate compute-unit reachability
- **[18](#item-18)** — Software/microcode fallback coverage is uneven — 18 of 32 configurables
- **[19](#item-19)** — Write the missing `_sw` microcode handlers
- **[20](#item-20)** — Decide whether the double group gets microcode at all
- **[21](#item-21)** — Colorlight i5 is EBR-bound in BRAM-only builds, not logic-bound
- **[27](#item-27)** — The `aastore` type check's cost was never measured
- **[31](#item-31)** — The BMB arbiter caps TIMING CLOSURE on both FPGA families (not throughput — see 2026-08-18 note)
- **[32](#item-32)** — UART corruption on seed 871203250 — no longer reachable at HEAD, CI pin REMOVED; cause never found
- **[39](#item-39)** — The L2 hit path is serial — 3 cycles per hit, 58-61 % of the DRAM access interval
- **[40](#item-40)** — A leaner MSHR entry — each holds a full cache line of write data a read miss never uses
- **[41](#item-41)** — No 8-core DRAM build closes timing, MSHRs or not; on DDR2 the 4-core misses too (2026-10-12)
- **[42](#item-42)** — Secondary-hit merging is not implemented — a request to a line being filled replays
- **[44](#item-44)** — The compute floor C is per-configuration; single-core latency decompositions need C re-measured
- **[45](#item-45)** — ONE unidentified register is read before it is written; the other ~401 look benign
- **[52](#item-52)** — The Java tools duplicate the hardware config by hand — three stale copies found while documenting item 51
- **[53](#item-53)** — The 8 KB method cache default broke 4-core Wukong SMP fit — resolved to `15/6` + `double:java` (hardware-validated); the preset itself is still unfixed
- **[54](#item-54)** — Statics are Kfl's largest stall category (41 %) and no cache touches them
- **[55](#item-55)** — The core stalls on writes whose result it never uses — about 3.5-5 % of cycles, not the `idle/direct` share first blamed on it
- **[56](#item-56)** — WBNI: derive the hardware config from the application. JOPizer static profile done; the measurement framework is the bulk
- **[63](#item-63)** — One Wukong SDR startup crash in six runs, not reproduced — recorded so a second sighting is not treated as the first
- **[64](#item-64)** — `GcStressTest`'s free memory declines ~0.40 B/round on all seven boards measured; since 2026-09-11 the suspect is the metric, not a leak
- **[67](#item-67)** — `ep4cgx150DbFull` runs with `useStackCache = false`; the original had it true. Item 14 has closed, so turning it on is now a measurement to make
- **[70](#item-70)** — UART baud is stated in THREE places that disagree — preset override, a 2 Mbaud default, and 12 Makefile constants. Pick one rate and derive the rest
- **[73](#item-73)** — `ep4cgx150DbVgaDma` misses by −1.011 ns on SDRAM command-FIFO arbitration between the core and the VGA DMA — OPEN
- **[75](#item-75)** — `ep4cgx150HwMath` generates byte-identical RTL to `ep4cgx150Serial` — a preset that expresses nothing, with a test that passes trivially
- **[82](#item-82)** — **Flash boot has been unbuildable on BOTH boards since 2026-03-13** — a working, hardware-verified capability removed as collateral by a refactor (OPEN)
- **[84](#item-84)** — No MAX1000 configuration is known to fit — a 1- or 2-core 10M08 setup is wanted (OPEN)
- **[102](#item-102)** — the bitstream depends on a `.jop` it does not contain
- **[104](#item-104)** — the generators restate board facts as literals
- **[105](#item-105)** — assembly navigation assumes the first board is the FPGA
- **[106](#item-106)** — the device map is keyed by raw strings in three places
- **[107](#item-107)** — `alchitry-au`'s bitstream has no prerequisite on its project
- **[110](#item-110)** — three corpora have never been reviewed
- **[112](#item-112)** — `ConstraintDriftTest` covers 2 presets of 46
- **[113](#item-113)** — `cold-check` covers 3 boards of 12
- **[115](#item-115)** — every simulation reports an elaboration failure and then succeeds
- **[117](#item-117)** — nothing prevents a preset that no flow selects
- **[119](#item-119)** — the object handle layout has no single definition and no coverage
- **[121](#item-121)** — absent devices collapse to one address, and the HAS_* flags guarding them are never read
- **[122](#item-122)** — `JopCore` and `ConstGenerator` run the I/O allocator over different device sets
- **[124](#item-124)** — on Altera the microcode comes from the `.mif`, and one call site decides which variant
- **[125](#item-125)** — `run_bench` hardcodes the baud per board and can address the wrong board
- **[126](#item-126)** — the baud derivation is never exercised by its own guard
- **[130](#item-130)** — `JopTop` silently overrides four `memConfig` fields the preset declares
- **[138](#item-138)** — the class-struct layout is restated in four languages and one field has no name at all
- **[142](#item-142)** — The linked image's `<clinit>` ORDER comes from hash iteration order; correctness rests on a dependency analysis nothing checks
- **[143](#item-143)** — `setsid` + process-group kill leaks the serial-holding child, which later looks like dead hardware
- **[149](#item-149)** — Nine Vivado targets still read TRACKED constraints; item 57 claimed otherwise and the guard's board list hid it
- **[150](#item-150)** — Four test apps and `JopIhluGcBramSim` are referenced by nothing, and four closed items rest on them
- **[153](#item-153)** — The Alchitry Au's tracked XDC has NO `create_clock`; its top-level clock may be unconstrained
- **[155](#item-155)** — Item 116's split decayed — past 11,000 lines by 2026-10-13 — and nothing guards section size
- **[159](#item-159)** — No asynchronous clock groups in the generated SDR XDC; a 2:1 clock ratio was hiding it
- **[163](#item-163)** — OPTIONAL: restructure the stack cache's same-cycle rotation decisions for timing margin
- **[167](#item-167)** — REGRESSION: the A-E115FB's minor-GC copy phase is 13.5 % slower than in August
- **[168](#item-168)** — `xc7a100tDbEth` misses timing by 0.058 ns, on a core path
- **[170](#item-170)** — the XC7A100T on the DB_FPGA V5 loses received frames at 1 Gb/s when the data toggles, and each loss blacks the receiver out
- **[178](#item-178)** — The JOP cluster carrier's mesh builds clean as one bitstream for all four sockets, and its PCB netlist matches the plan; questions stay open before it is made
- **[179](#item-179)** — A method call and its return cost ~130 cycles, about half of Kfl's; `idle/direct` is mostly their memory reads
- **[180](#item-180)** — fifteen formal properties check nothing: below BMC depth 4 an assertion under `pastValidAfterReset()` is never reached

### Closed

Marked closed in the heading or here, sorted by ID.

- ~~**[1](#item-1)**~~ — Generational GC is unsound on SMP — RESOLVED (2026-08-15
- ~~**[2](#item-2)**~~ — `JopIhluGcBramSim` cannot fail — CLOSED 2026-08-16
- ~~**[6](#item-6)**~~ — Major GC constant unexplained — LARGELY FIXED 2026-08-06, 2.6-3.2x
- ~~**[9](#item-9)**~~ — Pico USB-Blaster needs a level shifter (74LVC8T245 or 2x 74LVC2T45)
- ~~**[10](#item-10)**~~ — pico-usb-blaster protocol bug — low-level shift works, Quartus handshake does not
- ~~**[14](#item-14)**~~ — Stack cache SDRAM integration — **CLOSED 2026-10-13**, done as [item 133](#item-133): per-core regions, bounded, flushed on halt; `DoAll`, `DeepAll` and `ThreadAll` on the Wukong's DDR3 and SDR
- ~~**[15](#item-15)**~~ — `GcPauseTest` on the Wukong boards — never run — DONE
- ~~**[16](#item-16)**~~ — Colorlight i5 SDRAM ("stage 2" of that board's bring-up — unrelated to
- ~~**[22](#item-22)**~~ — Five `_sw` handlers exist but do not work — RESOLVED. It was two
- ~~**[23](#item-23)**~~ — `f_multianewarray` handles exactly 2 dimensions — FIXED
- ~~**[24](#item-24)**~~ — The evacuation trade is untested at larger object sizes
- ~~**[25](#item-25)**~~ — Two loose ends from the GC work — DONE 2026-08-06
- ~~**[26](#item-26)**~~ — Reference arrays carry no element class — FIXED
- ~~**[28](#item-28)**~~ — `DoAll` dies at `CollectionTest` on the Wukong — FIXED
- ~~**[29](#item-29)**~~ — ~~`BytecodeFetchStage: JumpTable integration` is flaky in CI~~ — **FIXED** (X-state)
- ~~**[30](#item-30)**~~ — ~~`JopJvmTestsBramSim` — the CI baseline job — intermittently dies~~ — **FIXED** (X-state)
- ~~**[33](#item-33)**~~ — `AlteraLpm.createRam` discarded the debug stack-RAM address
- ~~**[34](#item-34)**~~ — 4-CORE STATUS after the fetch-stall fixes — the SDRAM row is
- ~~**[35](#item-35)**~~ — `AlteraSdramAdapter` has NO simulation coverage — DONE
- ~~**[36](#item-36)**~~ — The `stall freezes jpc, jinstr and the dispatch address` formal
- ~~**[37](#item-37)**~~ — The method cache dominates real memory traffic — CLOSED 2026-11-11: since [51](#item-51)'s 8 KB default, bytecode fill is 3-6 % of stall, re-measured at HEAD
- ~~**[38](#item-38)**~~ — ANSWERED: stall share is 34-55 % — Measure DoApp's memory-stall fraction — decides between items 37, 39 and 5/31. Where that 34-55 % GOES was then measured on hardware in [50](#item-50)
- ~~**[43](#item-43)**~~ — Colorlight i5 SDRAM "regression" — FALSE ALARM, my own documented trap
- ~~**[46](#item-46)**~~ — ~~`formal-verification` fails intermittently~~ — **ALREADY FIXED** 2026-08-15 (`6bce639b`, formal timeout 300→900 s)
- ~~**[47](#item-47)**~~ — ~~A push cancelled the nightly scheduled CI run~~ — **FIXED** (concurrency group)
- ~~**[48](#item-48)**~~ — ~~No runtime reset: the FPGA had to be reprogrammed before every download~~ — **DONE** (UART escape + button)
- ~~**[49](#item-49)**~~ — ~~The UART divided the clock by an integer, so the baud was only right on lucky clocks~~ — **FIXED** (`UartBaudTick`)
- ~~**[50](#item-50)**~~ — Memory-stall profile on real memory, on hardware — DONE. Four boards, plus the dual-system run: the L2 as built is worth 3-5 %
- ~~**[51](#item-51)**~~ — Method cache — **CLOSED 2026-08-23. DEFAULT 8 KB/64 blocks, +35 % Kfl / +27.7 % UdpIp on four boards** (DDR2, SDR, DDR3; Quartus/Vivado/nextpnr). Fragmentation, not capacity. Both design options it left open were measured away; the remainder became [54](#item-54) and [55](#item-55)
- ~~**[57](#item-57)**~~ — The XDC/QSF generators exist and nothing uses them — DONE 2026-08-31; every board reads generated constraints, and the tracked files are now ConstraintDriftTest's oracles
- ~~**[58](#item-58)**~~ — `source` inside an XDC was silently ignored by Vivado — **CLOSED 2026-10-12**: the GMII constraints are generated and the shared files deleted
- **[59](#item-59)** — ~~the Colorlight i5 SDRAM build does not meet timing~~ — WITHDRAWN, it passes. I read the wrong line
- ~~**[60](#item-60)**~~ — Everything generated belongs under `build/<config>/` — DONE 2026-09-04: boards finished 2026-08-31, but the legacy path stayed the DEFAULT in both trees for four more days; both branches now deleted and guarded
- ~~**[61](#item-61)**~~ — FIXED 2026-08-24 — no app in `apps/Small` built from clean; the runtime is now bulk-compiled and the app named
- **[62](#item-62)** — ~~`JopFloatCuBramSim` reads a microcode variant that does not exist, so it has never run~~ — CLOSED 2026-11-05: retired; the float CU runs DoAll on the standard microcode, `JopConfigJvmTestsSim ep4cgx150HwFloat` 68/68
- ~~**[66](#item-66)**~~ — The EP4CGX150's Ethernet/VGA/SD was lost in migration `8641942` — **preset written back 2026-08-25, pin-identical to the historical project, 15,270 LE, all clocks MET.** Found a dead `"eth"` vs `"ethernet"` predicate that had silently dropped every `set_clock_groups`
- **[65](#item-65)** — ~~Both SD exercisers fail on hardware~~ — CLOSED 2026-11-01: SdNative wrote inside NWR, SdSpi moved MOSI with SCLK, the SPI exerciser sent no idle byte before a command and gave up early; both pass on a cold card
- **[68](#item-68)** — ~~EP4CGX150 Ethernet: link comes up at 1 Gbps but NO packets move~~ — **FIXED** 2026-10-12: two causes. `BmbMemoryController` re-latched every I/O read after its strobe, so the MAC's pop-on-read RX register reached the CPU one word late (every board; Wukong A/B). And on the EP4CGX150 the generated SDC named `e_rxc` in a clock group but never created it: the receive domain went untimed and its placement failed hold by -1.763 ns. ping, UDP, TCP, DHCP and DNS on both GMII boards
- ~~**[69](#item-69)**~~ — `DoAll` died at `FloatTest` on `wukongFull`. NOT because `"*" -> "hw"` forced hardware for `frem` (it could not — `frem` was absent from the registry): the wildcard drove `SUPPORT_FLOAT` false, which dropped the SoftFloat library `frem` runs in. FIXED 2026-08-31
- **[71](#item-71)** — All three EP4CGX150 **BRAM** presets missed timing at 80 MHz; the BRAM read-data path will not close there — FIXED by reclocking, `hw_verify` now refuses violated bitstreams
- **[72](#item-72)** — `JopTopVerilog` gave every FPGA build the SERIAL microcode regardless of the config's boot mode — FIXED
- ~~**[74](#item-74)**~~ — item 69's scope was too narrow: `"float" -> "hw"` hits the `frem` trap too, not just `"*" -> "hw"` — and `frem` is absent from the bytecode table
- ~~**[80](#item-80)**~~ — `PerfCounterVerifySim` fails on an unassigned ICU register — pre-existing, confirmed by bisect
- **[94](#item-94)** — Nothing generates into the source tree any more (CLOSED)
- ~~**[95](#item-95)**~~ — The README advertises 13 simulation commands; CI watched a different set, and the gap is where four broken sims were hiding — **CLOSED: CI executes the README itself**
- ~~**[96](#item-96)**~~ — `JopCoreWithSdramSim` stalls — WITHDRAWN 2026-08-30, never a bug: the cycle budget was 19x short, and the three-PC steady state was a slow boot seen through a narrow window
- ~~**[97](#item-97)**~~ — `JopSmpBramSim` runs 100 M cycles, both cores boot, then fails its own `GC test start` check
- ~~**[98](#item-98)**~~ — `JopInterruptSim` fires 2 of 5 interrupts — deterministic, reproduced twice
- ~~**[99](#item-99)**~~ — `JopDebugProtocolSim` NPEs during **elaboration** — `JopCluster.gcRootRamAddr()` is null
- ~~**[100](#item-100)**~~ — The EP4CGX150's intermittent level-shifted Pico cable — **CLOSED 2026-10-15**: a Pico cable on the pico-usb-debug-jtag carrier reads 30/30 single-try and configures 10/10; the old cable-or-plug confound died with that Pico
- **[101](#item-101)** — ~~every hardware record before 2026-08-26 was taken when the declared clock could differ from the silicon~~ — LARGELY RESOLVED 2026-08-31
- **[103](#item-103)** — ~~the A-E115FB's JTAG bank is not 3.3 V~~ — CORRECTED 2026-10-13: VTREF is 3.3 V, the JTAG pins run at 2.5 V, and a bare Pico is fine either way
- ~~**[108](#item-108)**~~ — README's 16-core claim rested on figures README itself withdrew — **CLOSED 2026-10-13**: the README and the board doc state the validated 12 and that 16 does not fit
- **[109](#item-109)** — ~~`wukongFull` has never been rebuilt since the frem fix~~ — CLOSED 2026-08-31, DoAll 66/66
- ~~**[111](#item-111)**~~ — checks that cannot fail, and checks that never ran — **CLOSED 2026-09-04**
- **[114](#item-114)** — ~~hardware evidence is discarded after every run~~ — WITHDRAWN 2026-08-31, it never was
- **[116](#item-116)** — ~~`current-status.md` is 491 KB and cannot be read~~ — DONE 2026-08-31
- ~~**[118](#item-118)**~~ — a CANCELLED nightly is silent; a failed one is not — **CLOSED 2026-09-04**
- **[120](#item-120)** — ~~`Const.java`'s dependencies omit every file that decides an I/O address~~ — FIXED 2026-08-31
- **[123](#item-123)** — ~~the `frem` hole is wider than `frem`~~ — FIXED 2026-08-31; `l2f` and `f2l` registered
- ~~**[127](#item-127)**~~ — the boundary review — **COMPLETE 2026-09-02: nine boundaries, nine with findings**
- ~~**[128](#item-128)**~~ — an array-cache hit skipped the bounds check, so out-of-range READS returned adjacent memory — **FIXED 2026-09-01**
- ~~**[129](#item-129)**~~ — `arraylength` had no null check — FIXED 2026-09-05, one condition in `BmbMemoryController`; DoAll 68/68 on all three boards, costs ~5.6 MHz on the i5 (still PASS at 40)
- ~~**[131](#item-131)**~~ — the card-table clear-all dropped every concurrent mark — **FIXED and hardware-validated 2026-09-02**
- ~~**[132](#item-132)**~~ — the card-table read port is stolen by any write, and the invariant that makes that safe is deliberately broken elsewhere — **RTL half FIXED 2026-09-11; the STW half is [item 158](#item-158)**
- **[133](#item-133)** — ~~stack cache: stack walkers served from the spill region~~ — CLOSED 2026-10-02, every arm hardware-validated
- ~~**[136](#item-136)**~~ — a String LITERAL had no valid `OFF_TYPE`, so `instanceof String`, `(String)` and `String[]` stores all failed — **FIXED 2026-09-03**
- ~~**[137](#item-137)**~~ — the `<clinit>` interpreter — FIXED 2026-09-04 (`a6d428b`), scaffolding removed 2026-09-05: 107 dead lines and 7,784 bytes out of every image
- ~~**[139](#item-139)**~~ — `JopCoreWithCacheTestHarness` built no card table, so `JopCardMarkSim` could not elaborate — **FIXED 2026-10-13**: one shared helper wires it in both harnesses, `CARD OK`, and CI runs it
- ~~**[140](#item-140)**~~ — `make -C java/apps/<X>` did not rebuild JOPizer, so a LINKER change silently did not take effect — **FIXED 2026-09-04**
- ~~**[141](#item-141)**~~ — the GC write barrier pushed references BELOW `mem_start` onto the grey list — **FIXED 2026-09-03**
- ~~**[144](#item-144)**~~ — The Java tools were config-dependent because javac inlines `Const` — DONE 2026-09-05: JOPizer reads its four values at runtime and is now built once into `build/java/tools`; JopSim stays per-config on purpose
- **[146](#item-146)** — ~~64 simulations built a Verilator model without the X-state defence, and one of them flaked CI~~ — **FIXED**
- **[147](#item-147)** — ~~The nightly GC sim ends when the heap exhausts, so making the program SMALLER made it slower until it blew CI's 90-minute wall~~ — **FIXED**
- **[148](#item-148)** — ~~The A-E115FB's Pico blaster failed and the board is powered off, so DDR2 has no hardware coverage~~ — **BACK** 2026-10-12 on the Terasic: DoAll 68/68 and Ethernet at 1 Gb/s.
- **[151](#item-151)** — ~~`XdcGenerator` produces WRONG constraints for the DB V5: console TX/RX crossed and `resetn` missing~~ — **FIXED**
- **[154](#item-154)** — ~~JopSim cannot run any image~~ — CLOSED 2026-11-11: it answers `IO_MEM_SIZE` and counts microseconds from its own start, and CI runs HelloWorld in it (`make -C java jopsim-hello`, README step 3b)
- **[156](#item-156)** — ~~two attached boards could not be programmed, and nothing noticed~~ — FIXED 2026-09-11
- **[157](#item-157)** — ~~The stop-the-world leak detector is never incremented~~ — FIXED 2026-09-14: `IO_GC_MUTATOR` counts it in hardware
- **[158](#item-158)** — ~~Stop-the-world has no acknowledgement~~ — FIXED 2026-09-14: `IO_GC_HALTED` + a grant rule; haltLeak 5213 → 0
- **[160](#item-160)** — ~~RT threads could not be constructed, and the scheduler had never run~~ — CLOSED 2026-10-02, ThreadAll 3/3 on hardware
- **[161](#item-161)** — ~~a core parked in `cpux_loop` occasionally leaves it early when a GC halt lands~~ — CLOSED 2026-10-07: a read command held through the flush stall, confirmed on hardware
- **[162](#item-162)** — ~~the stack cache's spill-region detection is the Wukong DDR3's critical path~~ — CLOSED 2026-10-03, the Wukong SDR closes timing at 100 MHz
- **[164](#item-164)** — ~~the single-core Wukong SDR does not run at 80 MHz, although every timing constraint is met~~ — CLOSED 2026-10-10: the clock IP gave the SDRAM a different frequency from the logic
- **[165](#item-165)** — ~~a GC halt stops a core only at its next memory access, so a collection can run while another core executes, and without a stack cache corrupt that core's locals~~ — CLOSED 2026-11-12: a halted core stops at its next bytecode boundary (`sys_gcstop`) and is acknowledged only once stopped; on the EP4CGX150 at 8 cores the unfixed control computed 51 wrong sums, the fixed build none in 3 runs, and `SmpGcTest` passed 3 of 3
- **[166](#item-166)** — ~~EP4CGX150 Ethernet at 1 Gb/s loses frames~~ -- **WORKED AROUND** 2026-10-12: extra RX_CLK edges when six or more RXD lines rise together (a hardware limit; no PLL can take the pin), so both EP4CGX150 presets run MII at 100 Mb/s, verified clean on the DB_FPGA V4 and V5
- **[169](#item-169)** — ~~stray bytes in the serial-boot handshake shift the microcode stack, and the checksum leak then overwrites the constant table~~ — CLOSED 2026-10-28: the loader's stack is balanced, test-first (`SerialBootStackTest`); the i5 boots cleanly through 10 and 20 stray bytes
- **[171](#item-171)** — ~~NetTest's TCP echo never serves again after a connection that does not close cleanly~~ — CLOSED 2026-10-31: every pool slot serves a client, aborted connections are released, silent ones dropped after 30 s; `net_echo_check.py`
- **[172](#item-172)** — ~~Parts.scala named every Artix-7 at speed grade -1, and three Vivado boards build -2~~ — CLOSED 2026-10-28: a part lists its grades with the slowest as default, each board sets its own; `FpgaPartTest`
- **[173](#item-173)** — ~~generic JOP, hardware support and one lab's setup are not separated~~ — CLOSED 2026-11-03: the setup is `setup/`, the hardware layer `hardware/` -- an sbt project that does not depend on JOP, so the compiler holds the direction -- and JOP `spinalhdl/`; `check-setup-layer.sh`, `check-generated-deps.sh`
- **[174](#item-174)** — ~~every JOP image has the same MAC and IP, so two boards cannot share the LAN~~ — CLOSED 2026-10-31: board instances give each unit on the LAN its own MAC and hostname, and NetTest takes a DHCP lease; `InstanceTest`
- **[175](#item-175)** — ~~the i5's Fmax moved with unrelated logic: yosys gives ABC9 no block-RAM clock-to-out~~ — CLOSED 2026-11-02: both i5 board flows read a DP16KD model with one; `colorlightDbI5Sdram` 41.61 -> 48.98 MHz; `check-ecp5-bram-timing.sh`
- **[176](#item-176)** — ~~`JopTopBramSim` hangs in `GC.init` under a green CI walk-through, and no `JopConfigBramSim` variant can build~~ — CLOSED 2026-11-05: `builtCoreConfig` built every BRAM system as SDR, so the Wukong BRAM read 8192 of its words; one `builtMemType` answers now, the README sims and their runner need a `PASS:` line, and `runSim` infers its memories; and the image loader refuses a program its memory cannot hold, where it truncated DoAll in silence; `BramBuildTest`, `run-readme-walkthrough.sh`, `SimVerdictTest`, `ImageFitTest`
- **[177](#item-177)** — ~~CI's all-compute-units job stopped at a count of 59 written into it, so DoAll's last nine tests never ran with the compute units on~~ — CLOSED 2026-11-05: the sim runs to DoAll's own count, and CI judges every JVM-suite log by it; every DoAll sim judges by its own count (`check-doall-verdict.sh`); `check-doall-log.sh`, `SimVerdictTest`, `check-doall-verdict.sh`

### Records

Un-struck sections that §1 does not list: records of completed work. Three
open findings sat here unranked until 2026-10-13; [102](#item-102) and
[138](#item-138) are in §1 now, and [139](#item-139) is fixed.

- **[76](#item-76)** — the 4-core BRAM SMP stall no longer reproduces, and timing was tested as the cause and REFUTED
- **[77](#item-77)** — the EP4CGX150 SDRAM Makefile is converted: 701 → 195 lines, and ~150 of those lines were flows DEAD since March
- **[78](#item-78)** — the A-E115FB DDR2 project is generated now, and building it found four separate defects
- **[78b](#item-78b)** — a vendor DRAM PHY owns its own clock constraints
- **[79](#item-79)** — the A-E115FB Makefiles: one converted, one retired
- **[81](#item-81)** — Build port, phase 0 — the ten superseded project files deleted, and three leftovers from my own conversions
- **[83](#item-83)** — Build port, phase 1 — the board-by-board flow audit, and a live wrong-board programming hazard on the DB_FPGA V5
- **[85](#item-85)** — Build port, phase 2 — the SDRAM exerciser folded onto the shared flow, and the baud it never reported
- **[86](#item-86)** — Build port, phase 3a — three shared Vivado scripts, proven equivalent by control build; and the DB_FPGA DDR3 build has quietly got 43 % smaller
- **[87](#item-87)** — Build port, phase 3b — `vivado.mk` finally has a user, and it found a live baud bug and a latent one
- **[88](#item-88)** — CI "formal verification failure" was a yosys cache that hits and rebuilds anyway — not the push, not the proofs
- **[89](#item-89)** — Build port — the DB_FPGA V5 was the last board generating in-tree; now on `vivado.mk` and the build tree
- **[90](#item-90)** — Build port — the Alchitry Au converted; and a cosmetic-warning "fix" that unconstrained the UART
- **[91](#item-91)** — Two Altera boards, two cables, and a check that finally has a reason
- **[92](#item-92)** — The tree did not build from a clean clone, and the working tree hid it
- **[93](#item-93)** — Every converted board, cold — and six layers of hidden dependency
- **[134](#item-134)** — the array-cache line fill is 0.0 % of Kfl's stall, and the benchmark that would show otherwise was never reached
- **[135](#item-135)** — the shell's `grep` is a ugrep wrapper that SILENTLY returns nothing for a common invocation

## 3. Item detail and journals

Stable IDs, grouped as they were created. Every entry that had a journal
keeps it verbatim.

### Item 1 — ~~Generational GC is unsound on SMP — RESOLVED (2026-08-15~~

~~**Generational GC is unsound on SMP**~~ — **RESOLVED (2026-08-15,
`ef36d99`); the core-count guard is GONE as of 2026-08-16.** The long-standing
>2-core failure was **not a GC bug and not a card-table bug**. It was two
response-path defects in `AlteraSdramAdapter` that corrupted reads to zero
(Avalon `readdatavalid` is a pulse and was dropped whenever the consumer
stalled; locally-generated write responses, which hardcode `data := 0`, could
overtake outstanding reads, which the consumer matches BY ORDER). It surfaced
as an array-bounds exception on a valid index, which killed a publisher
thread and wedged the cluster. Full narrative and every retraction along the
way in the item-1 section below, entries (b1)-(b10).

**[Full journal →](status/item-1.md)** — 1837 lines of investigation detail.

### Item 2 — ~~`JopIhluGcBramSim` cannot fail — CLOSED 2026-08-16~~

> **CORRECTED 2026-09-10 (audit of closed items).** This item says generational
> is active at 2 cores *"now that the guard is `<= 12`"*. **There is no such
> guard.** `GC.java:638` is `genActive = USE_GENERATIONAL && cardShift0 != 0` —
> no `cpuCnt` term at all, because [item 1](#item-1) removed it entirely the
> same week. The conclusion is *more* true than stated; the mechanism cited is
> gone. Residue: `GC.java:596` still computes an unused `cpuCnt0`.
>
> **Still open, and load-bearing:** nothing runs `JopIhluGcBramSim`. The
> anti-vacuity work this item did — the `verified == 0` check, the stop
> condition, the minor count — is preserved only by nobody editing the file.
> See [item 150](#item-150).

~~**`JopIhluGcBramSim` cannot fail**~~ — **CLOSED 2026-08-16.** It loaded
`java/apps/Small/HelloWorld.jop`, a single-core app, so core 1 parked in the
boot-wait loop and IHLU was never exercised — verified at the time by running
to 49M cycles with core 1 never moving.

It now loads `SmpGcTest.jop`, the multi-core allocating workload item 1
needed, and has three ways to fail rather than none:

- the payload not reaching `SmpGcTest done`;
- `SMPGC FAIL`, i.e. cross-core references lost;
- **`verified == 0`** — the specific anti-vacuous guard. `verified N` counts
 holders core 0 checked *after another core stored into them*, so a non-zero
 N is proof the second core executed. This is the check the old payload
 could never have satisfied.

**Result:** `PASS: 2 cores, verified=192, 10 minor GCs — IHLU and shared card
table exercised`, 20.2M cycles. Both cores run, `SMPGC OK`, minors 10 /
verified 192 / errors 0. Generational is active at 2 cores now that the guard
is `<= 12`, so this exercises the shared card table as well as IHLU — the
entry's original "INCONCLUSIVE while the SMP guard is on" caveat no longer
applies.

**Demonstrated failing, not assumed.** Pointed back at `HelloWorld.jop` with a
short cycle cap it exits non-zero with `FAIL: SmpGcTest did not run to
completion`. A test that has never failed has not been shown to be able to —
the same discipline item 35 sets, and it is worth the two minutes.

Also fixed while here: the verdict used `findFirstMatchIn` for the minor-GC
count and so picked up `STACKROOT minors 6`, a mid-run probe, reporting 6
where the run's own summary says 10. A verdict that under-reports what it
exercised is a small lie in the one place that has to be trustworthy.

### Item 34 — ~~4-CORE STATUS after the fetch-stall fixes — the SDRAM row is~~

~~**4-CORE STATUS after the fetch-stall fixes**~~ — **the SDRAM row is
SOLVED (2026-08-16); one BRAM-sim row remains open.** Kept because the table
below is the clean statement of which combinations were tried, and because
two of its entries were retracted in ways worth not repeating.

**The `SmpGcTest / Ihlu / SDRAM hardware / STALL` row was the
`AlteraSdramAdapter` bug** (`ef36d99`) -- Avalon read data dropped when the
consumer stalled, and write responses overtaking outstanding reads and
answering them with 0. Nothing to do with Ihlu, the lock, or 4 cores as such;
the core count only decided how often `rsp.ready` dropped. Full account in
item 1. Generational SMP now runs at up to 12 cores.

**[Full journal →](status/item-34.md)** — 385 lines of investigation detail.

### Item 33 — ~~`AlteraLpm.createRam` discarded the debug stack-RAM address~~

~~**`AlteraLpm.createRam` discarded the debug stack-RAM address**~~ —
**FIXED `8ef6aa9`, HARDWARE-VERIFIED 2026-08-12.** The debug read port returned
the wrong word on every Altera build, which is why the cross-core root scan
read `cands 0`. The fix steals the RAM's read port when a debug read is in
flight, so the risk was breaking NORMAL stack reads — and **no simulation
covers this**: every sim uses `MemoryStyle.Generic`.
EP4CGX150 single-core, fresh build, timing met (+2.445 ns setup, TNS 0.000):
**DoAll 66/66, `JVM exit!`**, checksum 0x88e4f517. That also puts `89da8fb`
(the `sys_exc` fix) on silicon for the first time — DoAll fires real hardware
exceptions (`Except`, `HwExceptionTest`, `NullPointer`, `DivZero`,
`AthrowTest`) and all pass.
**STILL NOT COVERED: debug READS themselves.** A plain boot never drives
`debugRamAddr`, so this is "no regression from the fix", not "debug reads
work". Closing that needs the DebugController or a 2-core build, where
`scanOtherCoreRoots` exercises the port via `rootRead`.
Two procedure notes, both of which cost attempts here:
~~**download at 1.5 Mbaud, not 2**~~ — **NO LONGER NEEDED (2026-08-15).** That
was the preset/PLL mismatch: `ep4cgx150Serial` declared 80 MHz while the
shared `dram_pll.vhd` was hardwired to 60, so the console ran at 2e6 x 60/80.
The PLL is now generated from the preset, an `ep4cgx150Serial` build really
does run at 80 MHz, and 2 Mbaud is correct. Still true: **reprogram
immediately before each download** — the ready handshake is consumed once and the board
then waits for data, so a download run standalone times out on `0xAA`.
When probing the port by hand, listen for **>500 ms**: that is the ready-byte
period, and a shorter window reads zero bytes and looks like a dead board.

### Item 35 — ~~`AlteraSdramAdapter` has NO simulation coverage — DONE~~

~~**`AlteraSdramAdapter` has NO simulation coverage**~~ — **DONE
2026-08-15**, `spinalhdl/src/test/scala/jop/memory/AlteraSdramAdapterTest.scala`
+ `src/test/resources/altera_sdram_tri_controller_stub.v`. Picked up by the
existing `simulation-tests` CI job, which already runs `jop.memory.*`.

The blocker was that `altera_sdram_tri_controller` is a BlackBox with no
Verilog body, so Verilator cannot build any design containing it. Solved with
a behavioural Avalon stub attached via `addRTLPath` **in test scope only** —
the production adapter is untouched. The stub models the Avalon contract, not
SDRAM: `readdatavalid` as a one-cycle pulse with no back-pressure,
`waitrequest` stalling commands unpredictably, in-order variable read
latency. It drives `avs_readdata` to X between pulses on purpose, so a
consumer that samples a cycle late fails loudly instead of reading a stale
value that happens to be right.

Four tests, and the three that matter were **confirmed to fail against the
pre-`ef36d99` adapter** before being kept:

| test | on the broken adapter |
|---|---|
| read data survives a stalling consumer | `WRONG READ DATA ctx=0 @0x0: expected 0xa5a5, got 0xa5f1` |
| a write response never answers a read | `MISPAIRED: expected ctx=2 (read), got ctx=3` (the write) |
| a read returns the last value written | `MISPAIRED: expected ctx=15, got ctx=16` |
| back-to-back, never-stalling (control) | **passes** — kept deliberately |

The control passing on the broken adapter is the point: it is the shape the
adapter was developed against, and it is why this went unnoticed.

**Two things worth carrying to the next test of this kind.** First, bug 1
presents as wrong DATA with a correct response COUNT and correct context
order — the old adapter popped its context FIFO on `rsp.ready` while taking
data from a pulse already gone, so contexts marched in order while data slid.
Any check built on counting responses, or on outstanding-transaction
arithmetic, sails straight past it; only content-and-pairing catches it.

Second, the first version of this file **passed against the broken adapter**,
because the producer loop ended with `if (failure.isDefined) return` — a
non-local return that left the method before `failure.foreach(fail)`, so a
detected fault was swallowed. It looked like four healthy green tests. That is
exactly the failure mode this item was written to prevent, and it was caught
only by running against the old file first. **Do that step; it is not
ceremony.**

### Item 32 — UART data corruption on seed 871203250 — no longer reachable; CI pin REMOVED

**RESCOPED 2026-08-18 — the CI seed pin is removed, but this is not "fixed".**
The failure no longer reproduces at HEAD, and nobody knows why.

| run | seed | X-state | ok | corrupt |
|---|---|---|---|---|
| D | **871203250** (the documented bad seed) | **random** | 132 | 0 |
| E | **871203250** | zeroed | 132 | 0 |
| F | 284409762 (CI's old pin) | zeroed | 132 | 0 |
| G | −1337 | zeroed | 132 | 0 |
| H | 20260818 | zeroed | 132 | 0 |

Run **D** is the one that matters: the documented bad seed, with randomisation
still on, now passes. So the pin was guarding against something that no longer
happens, and `--x-initial 0` makes the seed irrelevant to these sims anyway —
there is no other source of run-to-run variation in them, so pinning one seed
is now meaningless. Pin removed; `matrix.seed` still works if a future seed
misbehaves.

**Do not read this as a fix.** The corruption was real when measured (`ok=0
corrupt=61`, confirmed pre-existing by an A/B at `f65b05b`). What changed
since is the netlist — the MSHR work moved a lot of the memory path — and a
seed names an initial state only relative to a fixed netlist, so 871203250
simply does not select the same state any more. The item stays open as
**observed once, not currently reachable**, which is weaker than understood.

The claim below that this is "not X-state" is **unsupported**: its reasoning
("it reproduces from the seed alone") is the same backwards inference
corrected in items 29 and 30, and the A/B that would have settled it is
inconclusive because the control (run D) failed to reproduce the bug.

**Original analysis, retained:**

**UART data corruption on seed 871203250 — CI seed now PINNED around it.**
`JopJvmTestsMcFallbackSim` fails with every UART character corrupted, bits 1
and 3 cleared: `"ArrayTest2 ok"` prints as `"Adteaequpep ea"` and `"failed!"`
as `"daaded!"` (`o`->`e`, `k`->`a` diff 0x0A; `f`->`d` 0x02; `i`->`a`,
`l`->`d` 0x08). The suite reaches `JVM exit!` but every result line is
mangled, so the CI check reports "no results found" rather than a test
failure. A DATA-path fault, not control flow.
**Verified pre-existing, not caused by the `sys_exc` fix**: an A/B on the same
seed gives `ok=0 corrupt=61` both at HEAD and with `BytecodeFetchStage.scala`
+ `asm/src/jvm.asm` reverted to `f65b05b`. Random seeds pass 132 ok either
way; CI simply drew this seed for the first time on `3f173e4`.
**Not X-state** — it reproduces from the seed alone, so `--x-initial 0` would
mask a real bug rather than stabilise a flaky test. Do not add it here.
CI pins `JOP_SIM_SEED=284409762` for this job only (`.github/workflows/ci.yml`,
`matrix.seed`), which keeps the job honest about REGRESSIONS while this is
open. **The pin is not a fix and must come out once this is understood.**
Reproduce:
`JOP_SIM_SEED=871203250 sbt "Test/runMain jop.system.JopJvmTestsMcFallbackSim"`
Only seen in the microcode-fallback config so far; the baseline and
all-compute-unit jobs passed on the same commit.

### Item 3 — Sixteen presets still run classic GC. Safe but slow

**Sixteen presets still run classic GC.** Safe but slow. The cause is a
missing `hasCardTable` in each preset, NOT the old SMP guard -- that is gone
(item 1), so `GC.init` now selects generational on any preset that has a card
table, at any core count. `hasCardTable` is one line each and the boot line
confirms it took effect.
~~The Wukong presets are elaboration-verified only~~ — **confirmed on
hardware 2026-08-07**: a Wukong was attached for the first time and
`wukongFull` boots `GC: generational, 512-word cards`. The sixteen other
presets remain unverified.

### Performance

### Item 4 — Copy phase — 79-82% of the minor pause and the dominant remaining term

**Copy phase — 79-82% of the minor pause** and the dominant remaining term.
Latency-bound, not clock-bound: 132 cycles/handle at 75 MHz against 162 at
100 MHz. The handle table is 2 MB against a 32 KB cache and a handle is
exactly one 256-bit line, so ~6400 compulsory misses to find ~66 survivors.
Plan in [gc/copy-phase-redesign.md](gc/copy-phase-redesign.md). The 5-8x
estimate is **asserted from transaction counts, not measured**.

### Item 167 — REGRESSION: the A-E115FB's minor-GC copy phase is 13.5 % slower than in August

**Found 2026-10-12**, re-measuring `GcPauseTest` on the A-E115FB at HEAD after
the board's month off (the figures are under [item 141](#item-141)'s pause
table): worst pause **14.963 ms** against August's 14.143, the copy phase
**12.825 ms** against 11.300 (+13.5 %), the sweep 2003 ns/handle against 1766.
The other phases got faster: card scan 1.293 ms from 1.931, stack and statics
0.339 from 0.647. The pause repeats to 0.2 % over 63 collections, so the rise
is real, and the total is still inside the 20 ms target.

**Not isolated.** One candidate is the August `LruCacheCore` restructure for
MSHRs, measured ~6.5 % slower single-core at one MSHR, which is this board's
default. Settle it with a control build at the August commit on the same
board, not by reasoning; re-measuring a DDR3 board against its own August
figure would show whether the change follows the L2.

### Item 5 — The BMB arbiter sets the clock ceiling — FREQUENCY, not core count

**The BMB arbiter sets the clock ceiling at every core count** (headline
corrected 2026-08-16 -- it read "caps SMP at 2 cores @ 100 MHz", which is no
longer true: 12 cores run on the EP4CGX150 and 8 on Wukong DDR3, each at its
own clock). What the arbiter costs is FREQUENCY, not core count: 60 MHz at 4,
50 at 8, 36 at 12 on the EP4CGX150; 100 MHz at 4 and 91.68 at 6-8 on Wukong.
The measurements below stand and the path is unchanged. Path is
`coreX zeroCur -> arbiter -> coreY memCtrl state machine`, widening with core
count. Measured on EP4CGX150: 1 core 7,870 LE (~107 MHz), 2 cores 19,439 LE
(+0.270 ns at 100 MHz), 4 cores 38,372 LE (**65.3 MHz**). Area allows ~12
cores at 73% with full caches; BRAM never binds (~52% at 16). Pipelining the
arbiter costs a cycle on every memory access — see item 11 before committing.

**2026-08-18.** Still true, and still about FREQUENCY. Worth separating from the
throughput question now that the latter has been measured: the MSHR work found
the DRAM *throughput* ceiling was `LruCacheCore`'s serial miss FSM, not the
arbiter, and removing it took eight-core DDR2 from 1.81x to 4.28x and DDR3 from
1.75x to 4.38x with the arbiter untouched. So this item is a clock-closure
problem, and pipelining the arbiter buys Fmax at the cost of one cycle on every
memory access — which item 38 should price before anyone commits.

### Item 6 — ~~Major GC constant unexplained — LARGELY FIXED 2026-08-06, 2.6-3.2x~~

~~**Major GC constant unexplained**~~ — **LARGELY FIXED 2026-08-06, 2.6-3.2x.**
At 36k live objects, from three changes: an `imul` in `push()` (bug 29),
hoisting `push()`'s loop-invariant statics, and replacing sliding compaction
with **evacuation**, which removes the O(n log n) address sort entirely.

| board | before | after |
|---|---:|---:|
| EP4CGX150 SDR 100 MHz | 2214.9 ms | **859.1 ms** |
| CYC5000 SDR 80 MHz | — | **846.4 ms** |
| XC7A100T DDR3 100 MHz | 2214.9 ms | **689.8 ms** * |

\* the only figure still measured with `GC_SORT_TRACE`/`GC_MARK_TRACE` on,
so it is ~6 ms pessimistic; not re-run since item 25 turned them off.
The CYC5000 beating the EP4CGX150 on a slower clock is the latency-bound
behaviour showing through. `GcPauseTest`'s explicit `GC.gc()` went
161 -> 12.4 ms. Minor GC unchanged (1344 / 1315 ns/handle).
Detail: [gc/major-gc-evacuation.md](gc/major-gc-evacuation.md).

**Mark is now ~64% of what remains.** The one lever left is inlining `push`
into `mark`'s two loops to save its ~142-cycle call — worth ~102 ms of a
542 ms mark, against duplicating GC logic in the most safety-critical loop
in the collector. Not obviously worth it.

### Item 24 — ~~The evacuation trade is untested at larger object sizes~~

~~**The evacuation trade is untested at larger object sizes**~~ —
**MEASURED 2026-08-06, and the obvious fix was wrong.** `GcObjSizeTest`
holds handles fixed at 12024 and varies payload size: mark stays flat at
99.4 ms and copy is linear in live words at **0.673 µs/word**, so the
predicted ~38-word crossover measured at ~43 (XC7A100T) / ~40 (EP4CGX150) —
the one prediction all day that held.

**The size threshold that followed from it made every large-object row
325 ms worse and was reverted.** Sliding copies exactly as much as
evacuating under churn (1624.4 ms vs 1624.1 at 200 words), so it is strictly
worse by the whole sort. The crossover only exists in the *steady state*,
where a stable live set leaves objects already in position
(`GcMajorPauseTest`: slide copy 10 ms vs evacuation's 86). Deciding needs to
know how far objects are from their slide destination, which is not
derivable from live size and handle count. Left always-evacuate, both
regimes recorded in `chooseEvacDest`'s contract.

**So evacuation is not a strict improvement**: much better under churn,
worse for large objects in the steady state. An application benchmark
(item 11) is what would say which regime real code sits in.

**Validated on a third memory system (CYC5000, Cyclone V SDR, 80 MHz,
2026-08-07)**, which is the one board whose *clock* differs and whose 8 MB
heap forces the sort-and-slide fallback deliberately rather than by
accident. Major pause **846.4 ms** at 36k live (against 859.1 on the
100 MHz EP4CGX150 — slower clock, faster collection, consistent with the
pause being latency-bound). `GcObjSizeTest`: evacuation at 2/10/40 words,
**fallback engaging at 100 words** (`sort_ms` 299.4), and the 200-word case
cleanly refused as too large for the heap. `corrupt 0`, `OBJSIZE OK`.
`GcPauseTest`: minor worst **9.292 ms**, sweep 1315 ns/handle, MAJOR OK,
retained 64/64, born-bad 0.

Note `GcObjSizeTest`'s `passes` column reads 0 regardless now — it is under
`GC_SORT_TRACE`, which item 25 switched off. Read `sort_ms` to tell which
strategy ran.

### Item 25 — ~~Two loose ends from the GC work — DONE 2026-08-06~~

~~**Two loose ends from the GC work**~~ — **DONE 2026-08-06.**
`GC_SORT_TRACE` and `GC_MARK_TRACE` now default `false`; having them on cost
6.4 ms of the 865.6 ms pause, which matches the estimate made when they were
added. `prepareCompact` is now documented as **deliberately frozen** rather
than merely untouched — it is the last caller of `sortListByAddress`, still
slides to `heapStart`, and was not converted because the incremental
collector is unexercised (item 2) and evacuation needs its destination
reserved before the walk starts, which does not obviously survive being cut
into `COMPACT_STEP` pieces. Its comment warns that the pause figures in
`major-gc-evacuation.md` do not apply to that path.

### Item 7 — Root-scan floor: 2.2 / 4.7 / 8.5 ms across SDR / DDR3 / DDR2

**Root-scan floor: 2.2 / 4.7 / 8.5 ms** across SDR / DDR3 / DDR2. Tracks
memory latency, not clock (the SDR and DDR3 boards are both 100 MHz yet
differ 2.1x), so it will grow again on slower memory.

### Hardware / infrastructure

### Item 8 — XC7A100T timing margin is +0.001 ns — one bad run in seven

**XC7A100T timing margin is +0.001 ns**, with one bad run in seven during
regression testing. A regression platform with no margin manufactures false
failures. Re-implement for margin.

### Item 9 — ~~Pico USB-Blaster needs a level shifter~~ — BUILT, then REGRESSED

> **Status 2026-08-31.** The level shifter exists and worked: the
> `pico-usb-debug-jtag` carrier (SN74LVC1T45 per signal, referenced to the
> target's VTREF on header pin 4) configured a 4.93 MB `jop_sdram.sof` on the
> EP4CGX150 in 43 s on 2026-08-29, and the board then ran HelloWorld.
>
> **It regressed the next day** — 1 detection in 10, `found 0xFFFFFFFF` (a
> floating TDO), programming failing after 410 s. VTREF measures 2.53 V, so the
> shifter has its reference.
>
> **This item is closed** — the shifter was the ask, and it exists and is
> proven. The cable's dependability is a separate problem and is
> [item 100](#item-100), which carries the evidence.

**Pico USB-Blaster needs a level shifter** — 74LVC8T245 (or 2x 74LVC2T45)
with `VCCB` from JTAG header pin 4. No firmware change can fix it: the clone
drives a fixed 3.3 V into a 2.5 V bank and reads 2.5 V against an RP2040
V_IH of ~2.15 V. Unblocks having both Altera boards connected at once. The
pull-up fix and `jtag_pintest.c` are **uncommitted** in `~/workspaces/pico-usb-blaster`.

### Item 10 — ~~pico-usb-blaster protocol bug — Quartus handshake does not work~~ — FIXED

> **Closed 2026-08-31.** It does work: `598c1a0` records a full
> `jop_sdram.sof` configuring the EP4CGX150 in 43 s through this cable, with
> Quartus reporting "Configuration succeeded". The remaining problem is
> reliability, not protocol — see [item 100](#item-100).

**pico-usb-blaster protocol bug** — low-level shift works (IDCODE reads
correctly), so the fault is in byte-shift-mode or response framing. Lower
priority now the level shifter is understood as the real blocker.

### Item 31 — The BMB arbiter caps TIMING CLOSURE on both FPGA families (not throughput — see 2026-08-18 note)

**The BMB arbiter caps TIMING CLOSURE on both FPGA families (not throughput — see 2026-08-18 note).**
Measured 2026-08-09 while validating item 1, and worth stating plainly
because it is easy to blame whatever feature was added last:

| build | cores | result |
|---|---|---|
| EP4CGX150 @80 MHz | 2 | MET +0.133 ns |
| EP4CGX150 @80 MHz | 4 | **VIOLATED -2.399 ns** |
| EP4CGX150 @65 MHz | 4 | VIOLATED -0.070 ns |
| EP4CGX150 @60 MHz | 4 | MET +0.302 ns |
| Wukong `wukongSmpMinimal` @100 MHz | 4 | MET +0.192 ns |
| Wukong `wukongSmpMinimal` @100 MHz | 8 | **VIOLATED -0.227 ns** |
| Wukong `wukongDdr3Smp` @100 MHz | 4 | MET +0.081 ns, 55.4 % LUT |
| Wukong `wukongDdr3Smp` @100 MHz | 6 | VIOLATED -0.156 ns, 69.6 % LUT |
| Wukong `wukongDdr3Smp` @100 MHz | 8 | VIOLATED -0.805 ns, 86.9 % LUT |
| Wukong `wukongDdr3Smp` @91.68 MHz | 6 | **MET +0.018 ns**, 68.4 % LUT — validated |
| Wukong `wukongSdrSmp` @100 MHz | 2 | **VIOLATED -2.327 ns** (default flow) |
| Wukong `wukongSdrSmp` @100 MHz | 2 | VIOLATED -1.451 ns (closure directives) |
| Wukong `wukongSdrSmp` @75 MHz | 2 | **MET +0.315 ns**, 23.7 % LUT |

**SDR SMP joins the pattern, 2026-09-23, and at only TWO cores.** The worst
path is the combinational ready chain
`stackStg -> memCtrl -> bmbArbiter -> sdramCtrl -> memCtrl FSM enable`, 20
logic levels, 67 % routing — it leaves the core, crosses the arbiter AND the
SDRAM controller, and comes back to gate the core's own state machine.
TNS -224.5 ns over **292 failing endpoints**, so it is the ceiling and not a
stray path. Fit is irrelevant here (23.7 % LUT): this is frequency, exactly as
the 2026-08-18 note says.

Two cores rather than four because SMP SDR switches the memory controller to
`burstLen = 4` (`JopConfig.builtCoreConfig`: `cpuCnt > 1 && isSdr`), a deeper
design than the single-core SDR the "SDR builds have margin" assumption in
`fpga/qmtech-xc7a100t-wukong/Makefile` was measured on. That flow now uses the
closure directives like every other JOP build on the board; they bought
0.876 ns, which was not enough on its own.

**[Full journal →](status/item-31.md)** — 121 lines of investigation detail.

### Item 159 — The generated SDR XDC declares no asynchronous clock groups, and a 2:1 clock ratio was hiding it

**Found 2026-09-23 while lowering the Wukong SMP SDR clock to close timing
([item 31](#item-31)), and it is a measurement-integrity defect rather than a
functional one.**

The design runs on the MMCM's system output; the board's 50 MHz input
(`sys_clk`) drives only the reset generator and the hang detector. The debug
signals the hang detector watches — `pc`, `jpc`, `memBusy`, `uart_txd`,
`debugMemState` — cross between those domains through SpinalHDL `BufferCC`
instances, which is the correct structure for an unrelated clock. Nothing ever
declared the domains asynchronous: `XdcGenerator` emits no `set_clock_groups`
and no `set_false_path` at all, while the hand-written `wukong_ddr3.xdc` carries
three.

**Why it never showed.** At 100 MHz the MMCM output is exactly 2x the 50 MHz
input, so the two clocks are phase-related and every crossing has a clean
capture relationship. Ask for 80 and the MMCM delivers 79.927, which is
mutually unrelated to 50 — Vivado then aligns the worst-case edges over the
common period and demands

```
Requirement: 0.091 ns   (fetch/romAddrReg_reg -> io_pc_0_buffercc)
```

which nothing can meet at any frequency. WNS went from -1.451 ns at 100 MHz to
-3.303 ns at 80: a SLOWER clock with WORSE slack, which is impossible on one
path and was the clue that it was a different path in a different clock group.
Split by group, the design path had MET at +0.027 ns and the violation was
entirely this crossing.

**This is [item 153](#item-153) one board over**: a timing result that looks
fine because of an accident of the clock setup rather than because the design
was constrained. It also means the 100 MHz SDR timing numbers were never
*wrong*, but they were never *evidence* about these crossings either.

**FIXED for the SMP flow only**, by
`fpga/qmtech-xc7a100t-wukong/vivado/constraints/wukong_sdr_cdc.xdc`, which the
`jop-sdram-smp-bitstream` target now reads alongside the generated XDC. With it
the 75 MHz build reports `sys_clk` +15.367 ns and `clk_100_sdr_clk` +0.315 ns.

**STILL OPEN, and this is the item:**

- The single-core SDR flows (`jop-sdram-build`, the SDRAM exerciser) do not
  read that file. They are safe only while they stay at exactly 2x the input
  clock, and nothing enforces or records that dependency.
  **`jop-sdram-build` READS IT since 2026-10-03** ([item 162](#item-162)): its
  first 80 MHz build hit exactly this, WNS -3.616 ns on these crossings. The
  SDRAM exerciser still does not, at an exact 2x.
- The constraint is hand-written per board rather than generated. Every other
  Vivado board has the same crossing shape and the same silence in
  `XdcGenerator`. Whether the DB V5 and the Alchitry are exposed is UNCHECKED.
- Declaring the groups asynchronous MASKS any future crossing added WITHOUT a
  synchroniser. That is the cost of the fix, and the reason it was scoped to
  one flow rather than written into the generator — but the scoping is a
  holding position, not an answer.

**Do not read the fix as closing the class.** Closing every instance is not
closing the class; only a guard closes a class. Nothing yet checks that a
board's XDC declares its asynchronous domains, which is the shape a real fix
would take.

### Item 11 — Application benchmark exists (`java/apps/JbeBench`) — remaining questions it should answer

**Application benchmark exists (`java/apps/JbeBench`) — remaining questions it should answer
one of the five decisions is settled, four remain.**

JavaBenchEmbedded ported from the original JOP tree — Kfl, UdpIp, Lift, via
`jbe.DoApp`. Baseline, EP4CGX150 single core @80 MHz: Kfl 7742, UdpIp 3524,
Lift 12681 iterations/s.

**SETTLED — the caches earn their area.** `ep4cgx150NoCache` A/B, single
variable:

| | with caches | no caches | gain |
|---|---|---|---|
| Kfl | 7742 | 7386 | +4.8 % |
| UdpIp | 3524 | 2761 | +27.6 % |
| Lift | 12681 | 6400 | **+98.1 %** |
| area | 8,784 LE | 6,386 LE | caches cost **2,398 LE**, +37.6 % |

+37.6 % area for +98 % / +28 % is a trade nothing else in the core
approaches. Kfl at +4.8 % is the marginal case.

**A METHOD NOTE THAT COST A WRONG PREDICTION.** Clock-scaling (running the
same build at 36 vs 80 MHz) shows whether a workload is memory-bound *in its
current configuration*, NOT whether it is memory-intensive. Lift scaled
almost linearly with clock and I read that as compute-bound — then it nearly
halved without caches, because its working set FITS the caches and so it
rarely reaches SDRAM. Only an A/B against the feature itself separates the
two. Full account in the JbeBench README.

**Still open, and what each now needs:**
- item 5/31, arbiter latency vs core count — needs slice B, a parallel
  throughput harness. Note the finding above reframes it: Kfl and UdpIp do
  ~25 % more work per MHz at 36 MHz than 80, so a pipelined arbiter costing
  a cycle per access is a worse deal for memory-bound work than a
  clock-focused reading suggests.
- item 4, whether the copy redesign helps real workloads — JbeBench can
  answer it now; needs an allocation-profile report alongside throughput.
- item 20, whether the double bytecodes deserve microcode — needs the
  `DoMicro`/`DoKernel` drivers, which already compile and just need a second
  `.jop` with a different main class.
- item 24, churn vs steady-state regime — needs the same allocation profile
  as item 4.

*Original entry:* **There is no application benchmark, and four decisions rest on it:**
whether a cycle of arbiter latency is worth 4+ cores (item 5); whether the
caches (2,213 LE/core, 33% of a core) earn their area; whether the copy
redesign helps real workloads (item 4); and whether the double bytecodes are
used enough to deserve microcode at all (item 20); and — added 2026-08-07 —
whether real workloads sit in the churn or steady-state regime, which is
what decides evacuate-versus-slide (item 24). Currently all five are
reasoned rather than measured. Probably the highest-leverage thing to build next —
and items 1 and 2 need a multi-core allocating application anyway, so the
first slice of this is already on the critical path (see *Coupling*).

### Smaller

### Item 36 — ~~The `stall freezes jpc, jinstr and the dispatch address` formal~~

~~**The `stall freezes jpc, jinstr and the dispatch address` formal
property timed out in CI**~~ — **FIXED 2026-08-15**, timeout 300 -> 900 s.
Not a regression and not a counterexample: SymbiYosys was killed at the wall
having reached BMC step 5, reported as `*** FAILED *** (5 minutes, 2
seconds)` + `java.lang.Exception: SymbiYosys failure`. The property takes
**2m47s locally** and CI's runner is roughly twice as slow, so it failed or
passed according to how busy the runner was — including on commits touching
no RTL at all (`fb3e8b6` is Java and docs only, and failed; `0da41f1` has
the same RTL and passed). Worth recognising the signature: a formal
"failure" with no counterexample and a duration equal to the timeout is a
timeout.

Tried and rejected: pinning `jbcWrAddr`/`jbcWrData`, which under
`assume(!jbcWrEn)` cannot affect anything and so looked like 19 free bits
per step the BMC need not carry. It made the property **slower**, 2m47s ->
3m42s — extra assumes change the solver's search and here for the worse.
The note is left in the source so it is not re-attempted.

This property is worth its runtime: it is the one that pins the freeze
invariant behind the three cascading fetch bugs, and no whole-system sim
catches that class.

### Item 29 — ~~`BytecodeFetchStage: JumpTable integration` is flaky in CI — FIXED~~

**FIXED 2026-08-18 — Verilator X-state. Same root cause as items 30 and 32.**
The analysis below was correct in every particular and stopped one step short:
"randomised post-reset state" *is* the answer, and the fix is to stop
randomising. `TestVectorUtils.simWave` now applies `--x-initial 0`, so every
unit test built on it starts from zero, as an FPGA does.

Closed A/B on the original failing seed, local Verilator 5.032:

| X-state | seed 360571106 | result |
|---|---|---|
| randomised (old behaviour) | 360571106 | **FAILS** — `1868 did not equal 550`, byte-identical to CI |
| zeroed, `--x-initial 0` (new default) | 360571106 | **PASSES** |

The seed is now **pinned in the test as a regression guard**, not removed: it
is a known-adversarial seed, so if anyone drops the flag this test is the
alarm. Check the guard still bites with
`JOP_SIM_XINIT=random sbt 'testOnly jop.pipeline.BytecodeFetchStageTest -- -z "JumpTable integration"'`.

The register that actually powers up dirty is still worth an `init()` — see
the note under item 30 on why zeroing is a floor, not a ceiling.

**Original analysis, retained:**

**`BytecodeFetchStage: JumpTable integration` is flaky in CI
failure is seed-dependent.** It broke the 2026-08-08 push and a rerun of the
*same commit* passed, so it is not a regression. Reproduce on demand:

```scala
// BytecodeFetchStageTest.scala:161
bcfSimConfig.compile(createDut(jbcData)).doSim(seed = 360571106) { dut =>
```

gives the CI failure exactly — `1868 did not equal 550, NOP should map to
0x226, got 0x74C`. `0x74C` is `entries[0xEC]`, and `0xEC` is an *undefined*
bytecode (the highest address in the table, the not-implemented handler), so
the DUT sampled an undefined bytecode rather than byte 0/1/2 of the test ROM
— randomised post-reset state, not a mis-timed read. Adding a settle cycle
does **not** fix it (tried; identical failure), so the cause is upstream in
what the JBC RAM or `jpc` hold after reset.

Ruled out, each of which looks plausible until checked: stale generated
artifacts (`asm/generated/` is gitignored and CI rebuilds it, but
regenerating locally with CI's exact `make && make serial && make
flash-altera` gives **byte-identical** output); parallel test collisions
(`build.sbt` sets `Test / parallelExecution := false`).

### Item 30 — ~~`JopJvmTestsBramSim` — the CI baseline job — intermittently dies — FIXED~~

**FIXED 2026-08-18 — Verilator X-state, the same cause as items 29 and 32.**

**The proof is an A/B that needed no new instrumentation** — the fingerprints
added on 2026-08-09 for exactly this purpose. Commit `caa8abbb` ran twice:

| run | seed | outcome |
|---|---|---|
| [31915456539](https://github.com/peteryates1/jop-spinalhdl/actions/runs/31915456539) | **−748081925** | hangs, **0** results |
| [31925196175](https://github.com/peteryates1/jop-spinalhdl/actions/runs/31925196175) | **564015666** | **132 ok**, 0 failed |

**[Full journal →](status/item-30.md)** — 190 lines of investigation detail.

### Item 45 — ONE unidentified register is read before it is written; the other ~401 look benign

**RESCOPED 2026-08-19 after the sweep. The "~405 registers" framing is not what
the evidence supports, and two of my own diagnoses of it were wrong.**

Across five seeds x 471 tests with X-state randomised, the register class
produced **zero** failures. The one reproducible symptom is
`BytecodeFetchStage: JumpTable integration` reading `entries[0xEC]` — an
undefined bytecode — instead of NOP's `entries[0x00]`.

**[Full journal →](status/item-45.md)** — 146 lines of investigation detail.

### Item 47 — ~~A push cancelled the nightly scheduled CI run — FIXED~~

**FIXED 2026-08-18.** `concurrency.group` was
`${{ github.workflow }}-${{ github.ref }}`. On `refs/heads/main` a push and the
nightly `schedule` share that group, and `cancel-in-progress: true` then lets a
push **kill an in-progress scheduled run** — which is what happened to
[32096717541](https://github.com/peteryates1/jop-spinalhdl/actions/runs/32096717541)
at 03:47 on 2026-08-18 (1 of 13 scheduled runs in the sample).

That is the expensive one to lose: several jobs are schedule-only precisely
because they are 60M-cycle Verilator runs too slow for every push, so a
cancelled nightly is a silent hole in exactly the coverage the comment above
`jvm-suite-sims` exists to protect. It reports as `cancelled`, not `failure`,
so nothing draws attention to it.

Adding `-${{ github.event_name }}` to the group separates them. Pushes still
cancel each other, which was the original intent.

### Item 49 — ~~The UART divided the clock by an integer, so the baud was only right on lucky clocks — FIXED~~

**FIXED 2026-08-18.** `UartCtrl.setClockDivider` computes
`round(clkFreq / baud / samplesPerBit) - 1` and ticks on an integer count, so
the achievable rate is `clkFreq / (N x 5)` and nothing else. On this project's
clocks that is exact by luck, not design:

| board | clk | want | N | integer divider gives | error |
|---|---|---|---|---|---|
| EP4CGX150 SDR | 80.000 MHz | 2 M | 8 | 2,000,000 | exact |
| XC7A100T DB V5 | 100.000 MHz | 2 M | 10 | 2,000,000 | exact |
| Colorlight i5 | 40.000 MHz | 1 M | 8 | 1,000,000 | exact |
| A-E115FB DDR2 | 75.000 MHz | 1 M | 15 | 1,000,000 | exact |
| **A-E115FB @ 2 M** | 75.000 MHz | 2 M | 7 | 2,142,857 | **+7.14 %** |
| **Wukong Ddr3_366** | 91.676 MHz | 2 M | 9 | 2,037,244 | **+1.86 %** |

The two inexact rows are exactly the two documented gotchas: the A-E115FB's
"baud must divide 75 MHz / 5 exactly, 2 M does NOT", and the Wukong's
`DDR3_UART_BAUD = 2037000`. No integer can fix either -- 2 Mbaud from
91.676 MHz needs 45.838 clocks per bit.

**`jop.io.UartBaudTick`** replaces the divider with a phase accumulator (an
NCO): add `round(2^24 x baud x samplesPerBit / clkFreq)` each clock, tick on
the carry. `JopUartCtrl` wraps the stock `UartCtrlTx`/`UartCtrlRx` with it, and
both `jop.io.Uart` and `UartResetEscape` use it -- from one place, so the reset
escape can never decode at a different rate from the UART the host is tuned to.
Cost is an adder and 24 flip-flops.

Measured in simulation, in clock cycles so the testbench clock cannot flatter
it: Wukong **45.8379 cycles/bit against an ideal 45.8380 (-0.0002 %)** where
the divider was +1.86 %; A-E115FB at 2 M **37.5002 vs 37.5000 (+0.0006 %)**
where the divider was +7.14 %; EP4CGX150 unchanged at exactly 40.0000.

**Hardware.** EP4CGX150 download OK with an unchanged checksum and **8/8**
reset-and-redownload; Wukong downloads at a plain **2000000** instead of
2037000, **6/6** reset-and-redownload, `CARD OK`. Quartus +0.756 ns, Vivado
MET at WNS +0.109 ns.

**PROVEN ON HARDWARE 2026-08-18, both directions.** The A-E115FB now runs at
**2 Mbaud** — download OK, 6/6 then 4/4 reset-and-redownload, Quartus +0.762 ns,
download time roughly halved. The phase increment is `0x222222`, exactly
`round(2^24 x 2M x 5 / 75 MHz)`.

And the counterfactual was measured rather than argued. A CONTROL bitstream was
built with the preset at **2,142,857** — the rate the old integer divider
produced — leaving everything else identical:

| host rate | result against the control board |
|---|---|
| 2,000,000 | download fails, "no ready signal" |
| 2,142,857 (nominal) | garbage `\xda\xd2\xca` |
| 2.1 M / 2.2 M / 2.4 M / 1 M | garbage |

The board was demonstrably alive throughout, transmitting on the ~0.5 s ready
cadence. **No rate the CH340 can produce decodes it.** So 2 Mbaud really was
unreachable here before the fractional generator.

**The reason is stronger than this document used to claim.** The old note said
"+7.14 %, far outside UART tolerance", which is true but incomplete: even
*asking* the host for 2,142,857 does not help, because the CH340's divisors are
quantised and it cannot generate that rate either. There was no host rate that
matched. Tolerance is the second reason, not the first.

**A measurement trap worth keeping.** The first attempt at this control was
invalid and looked like a refutation: reading the 2 Mbaud board at a *requested*
2,142,857 returned 27/27 clean lines, which appears to disprove the intolerance
claim. It does not — the CH340 silently ignored the request and stayed at
2,000,000, so a perfectly matched link was being measured. Worse, opening it at
that rate wedged the bridge and produced a spurious 0/6 on the following reset
loop, which reprogramming cleared. Put the awkward rate on the FPGA side, where
the fractional generator makes it exact, and keep the host on a standard rate it
can actually synthesise.

**Do not oversell this.** On the Wukong it is TIDINESS, not a repair: 1.86 % is
inside 8N1 tolerance, both 2000000 and 2037000 decode cleanly against the new
bitstream, and the old pairing worked. What it buys there is a round number and
one less per-board constant. The functional win is the A-E115FB, where +7.14 %
is outside tolerance and 2 Mbaud was simply unavailable -- and that board is
**not attached, so that row is simulation only**. Its preset still asks for
1 Mbaud; raising it to 2 M would halve download time and should be tried when
the board is next connected.

Bitstreams built before 2026-08-18 still need 2037000 on the Wukong;
`run_bench`, the Makefile and the board doc all say so.

### Item 48 — ~~No runtime reset: the FPGA had to be reprogrammed before every download — DONE~~

**DONE 2026-08-18, hardware-verified on the EP4CGX150.** Programmed once, then
`HelloWorld -> reset -> CardMarkTest (CARD OK) -> HelloWorld`, with JTAG
untouched after the initial configuration.

**What the problem actually was.** Not the missing resets (item 45) -- the
missing reset SOURCE. `ResetGenerator`'s `res_cnt` is `resetKind = BOOT`, so it
initialises when the FPGA is CONFIGURED and never again, and `pll.io.areset` is
tied `False`. Reprogramming was not a habit, it was the only reset in the
design. The Xilinx boards were the accident: they already carry a `resetn` port
into the clock wizard, which is why only Altera and Lattice felt the pain.

**[Full journal →](status/item-48.md)** — 141 lines of investigation detail.

### Item 46 — ~~`formal-verification` fails intermittently — ALREADY FIXED (2026-08-15)~~

**Filed and closed the same day, 2026-08-18 — the fix predates the
investigation.** Recorded because the failure pattern is still visible in the
CI history and will otherwise be re-discovered.

`formal-verification` was the only failing job in **5** of the 20 CI failures
in the 200 runs to 2026-08-18 (31883019262, 31877585619, 31695840571,
31691895916, 31530822513), signature:

```
##   0:02:51  Checking assertions in step 5..
- formal_stall freezes jpc, jinstr and the dispatch address *** FAILED *** (5 minutes, 2 seconds)
  java.lang.Exception: SymbiYosys failure
```

No counterexample and no trace: the run died, the proof did not fail. It was
the SymbiYosys wall clock, then **300 s**. `6bce639b` (2026-08-15 12:54)
raised it to **900 s** with the reasoning written into
`BytecodeFetchStageFormal.scala` — *"a formal timeout should mean 'this
property has become intractable', not 'the runner was busy'."*

**The last formal-only failure was 2026-08-15 11:49, 65 minutes BEFORE that
commit, and there has been none since.** Confirmed independently here: the
property passes locally in **2 min 58 s** against a 900 s budget, and CI's
runner is roughly half the speed — so the headroom is real.

Lesson worth keeping: a `*** FAILED ***` whose only detail is a duration and a
backend exception is a resource limit, not a disproof. Check the configured
budget against the elapsed time **before** filing it as a bug — this item was
opened on the guess "timeout", corrected to "cause unknown" for lack of
evidence, and then closed on finding the budget in the source. Only the last
step involved reading the code.

### Item 12 — `LongComputeUnitConfig` has no enable flag for its base 64-bit ALU

**`LongComputeUnitConfig` has no enable flag** for its base 64-bit ALU
(`ladd/lsub/lneg/lcmp`), unlike `FloatComputeUnitConfig.withAdd`. Worked
around at the `ComputeUnitTop` level (conditional instantiation), but the
config asymmetry remains and would bite anyone relying on the `with*` flags
alone.

### Item 13 — `java/apps/Small` `make clean` deletes `HelloWorld.jop`

**`java/apps/Small` `make clean` deletes `HelloWorld.jop`** — `JOP_OUT`
derives from `APP_NAME`, which defaults to HelloWorld. Cost a sim failure
and nearly a wrong SMP result. Build HelloWorld last, or `rm -rf build`.

### Item 14 — ~~Stack cache SDRAM integration — 3-bank rotation verified in BRAM, needs per-core regions~~ — CLOSED 2026-10-13: done, as item 133

> **CLOSED 2026-10-13, by the docs review that found this line stale.** The
> work it asked for landed under [item 133](#item-133): per-core spill regions
> (`spillBaseAddr`, `stackRegionWordsPerCore`), the region bounded and its
> overflow wired to `EXC_SPOV` (2026-09-15), the cache flushed on a GC halt so
> SMP and deep stacks coexist (2026-09-16), and hardware passes on external
> memory: `DoAll` 68/68, `DeepAll` and `ThreadAll` on the Wukong's DDR3
> (2026-10-02) and SDR (2026-10-03, [item 162](#item-162)). Nothing open
> remains under this number. Turning it on for `ep4cgx150DbFull` is
> [item 67](#item-67), and timing margin is [item 163](#item-163).

**Stack cache SDRAM integration** — pre-existing; 3-bank rotation verified
in BRAM simulation, needs per-core stack regions on SDRAM.

### Item 15 — ~~`GcPauseTest` on the Wukong boards — never run — DONE~~

~~**`GcPauseTest` on the Wukong boards** — never run~~ — **DONE
2026-08-07.** Wukong XC7A100T + DDR3, `wukongFull` at 100 MHz: minor pause
**worst 11.840 ms / mean 11.813** over 63 collections, sweep 1624
ns/handle, copy **87%** of the pause (the other boards are 79-82%), major
`MAJOR OK` with retained 64/64 and `corrupt 0`, free 262 MB.
`GcMajorPauseTest` at 36k live: **681.2 ms**, the best of the four boards
measured — sort never runs. (The CYC5000 was measured too — see item 24.)
The A-E115FB DDR2, 2026-10-12: **779.0 ms** at 36k live (mark 447.1, compact
330.3), linear from 223.2 ms at 6k, corrupt 0.

### Item 16 — ~~Colorlight i5 SDRAM ("stage 2" of that board's bring-up — unrelated to~~

~~**Colorlight i5 SDRAM ("stage 2" of that board's bring-up — unrelated to
the GC stages elsewhere in this document)**~~ — **DONE** (`a7fdf93`). 8 MB working on
hardware, DoAll 66/66 at 1 Mbaud. `BmbSdramCtrlWide` added for the 32-bit
part; `MemoryControllerFactory.createSdr` selects on `layout.dataWidth`.
Remaining i5 work is ordinary: raise the clock above 40 MHz, and try SMP now
that block RAM is only 21% used. See `docs/boards/colorlight-i5-bringup.md`.

### Item 23 — ~~`f_multianewarray` handles exactly 2 dimensions — FIXED~~

~~**`f_multianewarray` handles exactly 2 dimensions**~~ — **FIXED
2026-08-06.** It was hardcoded to `dim == 2` and printed "dimensions not
supported" for anything else, so `new int[a][b][c]` was an unimplemented
trap. `JVMHelp.multiNew` now builds any nest up to `MAX_ARRAY_DIM = 8` by
recursing one level at a time. The spec allows 255, but a runaway nest would
overflow the stack part-way through allocating and leave a half-built
structure, which is worse than a clean refusal.

The part that mattered was never the loop, it was the **GC metadata**: only
the innermost level carries the element type and every level above it is a
reference array. Getting that wrong at two levels was `78cc968` — inner
arrays typed `IS_OBJ`, collector unable to size them or scan their elements,
premature collection with no visible fault. `MultiDimTest` checks 3-D and
4-D primitive, 3-D reference and the degenerate zero-length shapes **after**
30k rounds of churn and two full mark-compacts, because DoAll's `MultiArray`
passed throughout that defect and reading values back proves nothing.
10/10 on EP4CGX150 and XC7A100T, `MultiArrayGcTest` OK, DoAll 66/66.

What it did **not** close is the missing element class — now **item 26**,
so it is not buried inside a finished item.

### Item 26 — ~~Reference arrays carry no element class — FIXED~~

~~**Reference arrays carry no element class**~~ — **FIXED
2026-08-07.** Arrays now carry a descriptor `(dim << 24) | elem` in handle
word **`GC.OFF_ELEM = 6`**, and JOPizer emits the same encoding for array
constant-pool entries. `elem` is a primitive code 4..11 or the element
class's struct address (always >= 16, so they never collide). This is the
information HotSpot keeps in an `ObjArrayKlass` — `_element_klass` plus
`_dimension` — so `checkcast`/`instanceof` are now the ordinary check:
equal dimensions, then an element subtype walk, with covariance falling out.

**Costs no memory.** `HANDLE_SIZE` is 8 and only 0-5 were used, so word 6
was already allocated. `OFF_TYPE` stays a small code, so the GC's tracing
paths are untouched — that was the constraint that mattered.

`anewarray` turned out to already *receive* the component type and discard
it (`// ignore cons ... should be different for the GC!!!`). Because a plain
class address has a zero dim field, `desc = cons + (1 << 24)` promotes
either a class or an existing descriptor by exactly one dimension, which
makes `new Foo[n]` and `new int[n][]` the same line of code.

Now exact, all previously wrong: `(Derived[]) x` where x is `Base[]`
**rejected** (was accepted), `(Base[]) derivedArray` accepted (covariance),
`int[][]` distinguished from `int[]` in both directions. `ArrayCastTest`
23/23 on **EP4CGX150, XC7A100T and Colorlight i5**; `MultiDimTest` 10/10 on
all three; DoAll 66/66, `MultiArrayGcTest` OK, `GcStressTest` 240k+ rounds
clean.

**The three follow-ups are done too (2026-08-07).**
- `f_aastore` now performs the covariant store check and throws
  `ArrayStoreException` (a class JOP's JDK subset did not have — likely part
  of why this was never implemented). The common case is inlined: a 1-D
  reference array whose element class is exactly the value's class, three
  reads and no call, because a helper call is ~142 cycles on a hot path.
- `(Cloneable) arr` and `(Serializable) arr` now succeed. Arrays have no
  interface table, so JOPizer emits the two class-info addresses into the
  special-pointer block and `JVMHelp.init` reads them — the equivalent of
  HotSpot's `ArrayKlass` declaring those interfaces.
- The **WCET bound is unchanged at `@WCA loop <= 5`**, and the earlier
  concern was wrong: the array path and the object path in `f_checkcast`
  are mutually exclusive, so it is still one walk. The new element walk in
  `classAssignable` is annotated accordingly.

`ArrayCastTest` is now **36 checks**, passing on EP4CGX150, XC7A100T and
Colorlight i5. DoAll 66/66, `MultiDimTest` OK, `GcStressTest` 240k+ clean.

### Item 27 — The `aastore` type check's cost was never measured

**The `aastore` type check's cost was never measured.** Item 26 added
a covariant store check to `f_aastore`, which every reference-array store
goes through. The common case is inlined — three reads and no call, chosen
because a helper call is ~142 cycles — but "chosen because" is reasoning,
not measurement, and this document's record on that is four wrong out of
five. Nothing in the suite times array stores, so the check could be costing
a few percent or a third and nobody would know. Needs a store-heavy
microbenchmark, or the item 11 application benchmark, before the design is
called settled.

### Item 28 — ~~`DoAll` dies at `CollectionTest` on the Wukong — FIXED~~

~~**`DoAll` dies at `CollectionTest` on the Wukong**~~ — **FIXED
2026-08-08. Three real hardware defects, `wukongFull` now DoAll 66/66** with
every compute unit in hardware (was 59/66 with a crash).

| # | defect | symptom |
|---|---|---|
| 1 | **FCU compare**: a lone zero operand fell through to the exponent compare | `0.75f <= 0` TRUE |
| 2 | **DCU compare**: identical defect in the sibling unit | same, for double |
| 3 | **DCU divider**: dropped its last quotient bit | `Math.sqrt(9.0)` = 3.345 |

**[Full journal →](status/item-28.md)** — 207 lines of investigation detail.

### Item 17 — `needs*Compute` predicates understate compute-unit reachability

**`needs*Compute` predicates understate compute-unit reachability.**
`621aac7` used them to skip instantiating unused CUs and regressed the JVM
suite 66/66 -> 56/66; reverted in `eda6de7`. The area win is real (~474 LE
per core, ~5,700 across 12 cores) and worth recovering, but needs a
predicate that asks *"can any dispatch path reach this unit"* rather than
*"is any bytecode set to Hardware"*. Two known ways the current ones
understate it:
- `needs*Compute` is `isHw(...)`, i.e. `impl == Hardware` only. A bytecode
  set to `Microcode` that reaches a CU is invisible. The `lmul` require at
  `JopCoreConfig.scala:353` documents exactly that (`lmul_sw` drives the ICU
  via `sthw`), so the predicates were known incomplete *before* `621aac7`
  relied on them.
- ~~`JumpTable.useAlt` fails open~~ — **fixed** (`useAlt` now throws). It had
  kept the `_hw` (CU) handler when a bytecode was set to `Microcode` with no
  `_sw` alternate. `BytecodeConfig.validate` was supposed to catch that via
  the `NoMicrocode` constraint, but only 12 of the 19 bytecodes lacking a
  `_sw` were marked — `idiv`, `irem`, `fneg`, `i2f`, `f2i`, `fcmpl` and
  `fcmpg` were `JavaOk`, so `mc` passed validation and then silently
  dispatched to a compute unit. (`fneg` turned out to be the opposite case:
  pure microcode already, with no `_hw` variant at all. It needed the
  missing `fneg_sw` label, not a restriction — now fixed, so 18 remain.) Both layers are now correct and
  `JumpTableResolutionTest` pins them against each other.

**The exact dispatch path is still unexplained** — on paper the default
config reaches no CU at all, so removing them should be free. Reproduce with
`JopJvmTestsBramSim` (default config, no board involved); it fails in ~15 min.
Do not re-land the optimisation without that sim passing 66/66.

### Item 18 — Software/microcode fallback coverage is uneven — 18 of 32 configurables

**Software/microcode fallback coverage is uneven** — 18 of 32 configurable
bytecodes have no `_sw` microcode handler, so their only non-hardware path
is the Java trap. Per-operation cycle costs already exist in
`docs/architecture/compute-unit-design.md` (ICU/FCU/LCU/DCU tables); what
follows is the coverage summary.

| group | has `_sw` | no `_sw` (Java trap only) |
|---|---|---|
| int | imul | idiv, irem |
| long | ladd, lsub, lmul, lneg, lshl, lshr, lushr, lcmp | — |
| float | fneg, fcmpl, fcmpg | fadd, fsub, fmul, fdiv, i2f, f2i |
| double | — | all 12 (dadd, dsub, dmul, ddiv, i2d, d2i, l2d, d2l, f2d, d2f, dcmpl, dcmpg) |

All 20 without one default to `Java`, which the jump table turns into
`invokestatic`, and all 20 are now marked `NoMicrocode` so asking for `mc`
is rejected rather than silently dispatched to a compute unit (item 17).

**The silent-misconfiguration part of this is closed**: `useAlt` throws, the
constraint table matches the ROM, and the four bogus float alternates are
gone. What remains is purely how much microcode to write — items 19 and 20.

**Long is fully covered, float has three of nine, double none.**

### Item 19 — Write the missing `_sw` microcode handlers

**Write the missing `_sw` microcode handlers.** Goal: a microcode fallback
for *all or most* configurable bytecodes, so that any board can trade area
for cycles without dropping to the Java trap.

**Coverage vehicle: `ep4cgx150McFallback`** — selects 11 of the 12 `_sw`
handlers and is the regression build for this item.

Eleven, not twelve, because **`imul_sw` and `lmul_sw` are mutually
exclusive** and no single build can run both. `imul_sw` is a self-contained
shift-add loop that touches no compute unit, and it is selected by
`imul = mc`. `lmul_sw` computes its partial products on the ICU's
`imul`/`imul_wide`, and that multiplier is only built when `imul = hw`
(`IntegerComputeUnitConfig.withMul` is `needsIntMul`). So `imul = mc` gives
`imul_sw` but breaks `lmul_sw`, and `imul = hw` fixes `lmul_sw` but stops
selecting `imul_sw`. This preset takes `imul = hw` and covers `lmul_sw`.
`imul_sw` is covered instead by every default-config sim, since `imul`
defaults to `Microcode` — so the *set* of tests covers all 12 even though no
single one does. It paid for itself on its
first run by surfacing the `lmul` configuration defect (item 22). Run it with
`make -C fpga/qmtech-ep4cgx150-sdram full-mc-fallback`, or in simulation via
`JopJvmTestsMcFallbackSim` (nightly in CI). **New handlers must be added to
it**, or they get no coverage at all: JOP's defaults select very few `_sw`
handlers, which is how `lmul` went years without anything executing it.
Six of the eight gaps outside the double group are small; the double group
is item 20.

Per-operation cycle costs for the alternatives are already tabulated in
`docs/architecture/compute-unit-design.md`.

~~`fneg`~~ — **done**, and it cost nothing: its default handler was already
pure microcode (`ldi 0x80000000; xor`), it simply lacked the `fneg_sw` label
that `useAlt` looks for. Two labels on one address, ROM byte-identical.

~~tier 1 (`fcmpl`, `fcmpg`)~~ — **done**. `fcmpl_sw`/`fcmpg_sw`, 97 ROM
words for the pair, sharing one body that differs only in the NaN result.
**No new `ldi` constants**: the serial pool is the binding one at 30 of 32
and `ldi` is a hard 5-bit field, while the ROM had ~2000 words free, so
0x7FFFFFFF and 0x7F800000 are derived from constants already present
(`-1 >>> 1`, `(255 << 24) >>> 1`) rather than added. Verified against IEEE
semantics over 1152 cases (NaN, ±0, ±Inf, denormals, non-canonical NaN
payloads), by `JopJvmTestsMcFcmpSim` (DoAll 66/66 in simulation with both set
to `mc`), and **on hardware** — `colorlightI5Sdram` now selects them, so the
i5 runs DoAll 66/66 with the microcode actually executing. That preset
change is the point: a build left on the default Java path never executes
these handlers, so "DoAll passed on hardware" would otherwise have said
nothing about them.

The i5 is a natural home for that because it has no FCU, so its alternative
was the ~600-cycle SoftFloat32 trap against ~30 cycles of microcode. It is
**not** the only one: `ep4cgx150McFallback` selects the same handlers plus
every other working `_sw`, and passes DoAll 66/66 on EP4CGX150 hardware
(worst-case setup slack +0.970 ns). Two boards, so unplugging either does
not lose the coverage.

| tier | bytecodes | effort | why |
|---|---|---|---|
| 2 | `i2f`, `f2i` | moderate | normalise/denormalise: count leading zeros, shift, assemble exponent |
| 3 | `idiv`, `irem` | moderate | restoring division loop. Lowest value of the three: the ICU already does it in ~36 cycles and the Java trap in ~1300, so this only pays for a board that wants neither |

Each one is done when: the `_sw` handler exists in `asm/src/jvm.asm`, its
`BytecodeEntry` constraint moves `NoMicrocode` -> `JavaOk`, the coverage
expectation in `JumpTableResolutionTest` is updated (it is deliberately
pinned so this cannot pass unnoticed), and DoAll passes 66/66 with that
bytecode set to `mc` — not merely with the default config, which would not
execute the new handler at all.

20a. **`lmul` in microcode on a board with no multiplier — a gap, but not
worth closing.** Raised because `imul = mc, lmul = mc` is rejected, which
looks like a hole in "a microcode fallback for all or most bytecodes".

It is a gap in the *matrix*, not in *capability*. The zero-multiplier
configuration is the **default** — `imul` defaults to `Microcode` (a
self-contained shift-add loop needing no CU) and `lmul` to `Java` — and it
passes DoAll 66/66 in `JopJvmTestsBramSim`. So a board with no ICU
multiplier already has a working `lmul`.

Closing the gap means a CU-free `lmul_sw` built from three shift-add
products. `imul_sw` alone is ~775 cycles for one 32x32, so three partial
products is **~2300+ cycles against the Java trap's ~1200** — the microcode
version would be roughly twice as slow as what it replaced. That inverts the
usual argument for microcode fallbacks, which exists because the Java trap is
normally 20-100x worse.

Caveat on the comparison: the ~1200 figure is from
`compute-unit-design.md` and Java `f_lmul` computes its partial products with
the `imul` *bytecode*, so its real cost tracks whatever `imul` is set to. It
has not been measured with `imul = mc`. The direction is clear enough to not
act on, but the number is not load-bearing — measure before revisiting.

### Item 20 — Decide whether the double group gets microcode at all

**Decide whether the double group gets microcode at all** — measure before
committing. All 12 (`dadd`, `dsub`, `dmul`, `ddiv`, `i2d`, `d2i`, `l2d`,
`d2l`, `f2d`, `d2f`, `dcmpl`, `dcmpg`) currently reach only SoftFloat64 at
~3000-5000 cycles, against ~14 cycles on the DCU. Microcode would land
somewhere between, but it is a large piece of work for a group most JOP
applications use rarely.

**ROM budget is not the constraint for items 19 or 20's smaller tiers.**
The ROM is 4096 words (`pcWidth = 12`) and the largest variant, serial,
uses 2055 — so ~2040 words are free, and `pcWidth` can go to 16 if it ever
is the constraint. For scale: all 13 existing `_sw` handlers together are
176 words, the largest being `lsub_sw` at 38. Tier 1-3 would add perhaps
150-250. A full software double group is the only thing on this list large
enough to make ROM size worth checking again — the DCU's 12 dispatch stubs
are 90 words, but real SoftFloat64-equivalent microcode is a different
order.

Unlike item 19 this is a genuine question, not a task: the honest answer may
be that double stays Java-trap-or-DCU. Worth deferring until there is an
application benchmark (item 11) that shows whether double is on any hot
path. `dcmpl`/`dcmpg` are the exception — they are as cheap as their float
counterparts in tier 1 and could be done with them.

### Item 22 — ~~Five `_sw` handlers exist but do not work — RESOLVED. It was two~~

~~**Five `_sw` handlers exist but do not work**~~ — **RESOLVED**. It was two
different faults, and only one was in microcode.

**`lmul_sw` was never broken.** It needs the ICU's *multiplier*, and
`IntegerComputeUnitConfig.withMul` is `needsIntMul`, i.e. `imul == Hardware`
specifically. The `require` guarding it checked `needsIntegerCompute`
(`isHw("imul","idiv","irem")`), which `idiv = hw` satisfies on its own — so
`idiv = hw, imul = mc, lmul = mc` passed validation and then built an ICU
with **no multiplier at all**. `sthw 3` had nothing to dispatch to and lmul
returned garbage: 6 DoAll failures, the float and double ones because
SoftFloat32/64 call lmul for mantissa multiplication.

With `imul = hw` the same handler passes DoAll 66/66. The `require` now
checks `needsIntMul` and says why `idiv/irem = hw` is not sufficient.

Worth recording how this looked from outside: a handler that had never been
executed, documented as broken, produced exactly the failure signature of a
broken handler — and was fine. The evidence that it was "broken" and the
evidence that it was "fixed" were both inference rather than measurement.

**`fadd_sw`/`fsub_sw`/`fmul_sw`/`fdiv_sw` were genuinely dead** — I/O
handlers for the BmbFpu peripheral, writing to 0xF0-0xF3 which stopped
decoding when that peripheral was removed. Deleted, along with their
`fpu_*` address constants. Those four bytecodes are now `NoMicrocode`, which
is true rather than merely enforced.

Net: `altEntries` goes 16 -> 12, and all 12 are real. "Has an alternate" and
"has a *working* alternate" mean the same thing again, so
`JumpTableResolutionTest`'s `noSw == noMc` invariant is now sufficient as
well as necessary.

### Boards

### Item 21 — Colorlight i5 is EBR-bound in BRAM-only builds, not logic-bound

**Colorlight i5 is EBR-bound in BRAM-only builds, not logic-bound** — with
64 KB of on-chip main memory it sat at 71% block RAM against 30% of LUTs.
Moving main memory to SDRAM inverts that to **21% block RAM / 42% LUTs**, so
SMP and extra compute units are now worth trying; they were not possible
while a single core consumed 71% of the EBR, which is why the board went to
SDRAM before anything else. It is also the only board on the open-source
toolchain, so it is the natural place to notice yosys/nextpnr-specific
breakage before it reaches the vendor flows.

### Coupling — read before sequencing any of this

**Items 1, 2 and 11 share one missing artefact: a multi-core application that
allocates.** They look independent and are not.

- Item 1 (shared card table) is ~1-2 days, and the *test* is the bulk of it. The
bug is "a young object reachable only from a tenured object written by another
core is collected while live". Demonstrating that needs two cores allocating
and storing cross-generation references — i.e. exactly such an application.
- Item 2 is vacuous today *because* no such application exists:
`JopIhluGcBramSim` falls back to a single-core app, so core 1 never boots.
- Item 11 needs the same thing as its first slice, before it grows into a
benchmark that can answer the arbiter and cache questions.

So build the application once and it serves all three: it makes item 2's test
meaningful, gives item 1 something that can fail before the RTL changes, and is
the beginning of item 11. Doing them in the other order means writing a
throwaway harness twice.

**Third coupling**: item 20 (does double deserve microcode?) is not answerable
without item 11 either. It is a cost/benefit question about a group of bytecodes
whose usage frequency nobody here has measured, and writing ~12 handlers to find
out is the expensive way round. Item 19's three tiers are *not* coupled to it —
they are small enough to be worth doing on their own merits.

**Second coupling, weaker**: items 4 and 6 may be the same defect. The copy
phase's problem is placement — the handle table is far larger than the cache and
a handle is exactly one cache line. `compactAndSweep` walks `useList` the same
way, so the unexplained major-GC constant may have the same cause. Check that
before treating them as separate projects.

---

**Confirmed with a number, 2026-08-18.** The SDRAM stage uses **12/56 DP16KD
(21 %)**; the BRAM stage, for only **64 KB** of main memory, uses **40/56
(71 %)** with 16 blocks free. So the BRAM stage cannot be grown enough to hold
an application benchmark — `JbeBench.jop` alone is 64 KB of code before any
heap — which is why the i5 has to run its benchmarks over SDRAM.

### Item 37 — ~~The method cache dominates real memory traffic — 62 % of DoApp's BMB transactions~~ — CLOSED 2026-11-11: since item 51's 8 KB default, bytecode fill is 3-6 % of stall

**CLOSED 2026-11-11: the method cache stopped dominating when
[item 51](#item-51) made 8 KB/64 blocks the default (2026-08-20), and a
re-measurement at HEAD finds it still doesn't.** `DoAppPerf` on the Wukong's
dual build (`wukongDualIndependent`, de2dfe4), both halves at once:

| bytecode fill | Kfl | UdpIp | Lift |
|---|---|---|---|
| share of stall, SDR 100 MHz | 5.0 % | 3.0 % | 2.7 % |
| share of stall, DDR3 100 MHz | 5.6 % | 3.6 % | 3.0 % |
| share of all cycles, SDR / DDR3 | 1.5 / 1.6 % | 1.1 / 1.2 % | 0.9 / 0.9 % |
| cycles per iteration, both memories | 92 | 157 | 48 |

- **Before:** with the 2 KB cache, bytecode fill was 47-63 % of Kfl's and UdpIp's
  stall on three boards ([item 50](#item-50)).
- **Unchanged since August.** The fills cost the same cycles per iteration as on
  2026-08-20 to within 0.1 %, and so do Kfl and Lift in total, on both memories.
  UdpIp is 1.2 % slower on SDR (indirection +14 %, `idle/direct` −6 %) and 0.3 %
  slower on DDR3. Not investigated. One difference: the image is 63 KB against
  August's 65 KB, so code and data sit at different addresses.
- **Where stall goes now:**
  - `idle/direct`, 30-41 % of stall, which is mostly the calls' reads
    ([item 179](#item-179));
  - statics, 40-42 % of Kfl's ([item 54](#item-54));
  - handle and array indirection, 57-61 % of Lift's.

Captures: `docs/measurements/perfcnt/2026-11-11-wukong-{sdr,ddr3}-recheck.txt`.
Timing on that build fails by 0.364 ns on the SDR controller's `sdram_DQ` output
enables, the same 16 endpoints as the August builds; every core path meets.

**No guard.** This is a measurement, and the check is to re-run `DoAppPerf` on a
board.

**The method cache dominates real memory traffic.** `DoAppAcacheSweepSim`
attributes every BMB transaction to the memory-controller state that issued
it, over Kfl + UdpIp + Lift: **bytecode fill 62.3 %**, direct access 18.5 %,
statics 15.0 %, and ALL array traffic 4.2 %. If real-application memory cost
is worth attacking, it is here.

**MEASURED IN TIME 2026-08-19 (`DoAppMemTimeSim`), and the headline above is
wrong in two ways.** `memBusy` is what stalls the pipeline, so counting the
cycles it is high and attributing each to `debugMemState` converts transactions
into time. Every state is named, so nothing is unattributed.

**First correction: the 62 % was Kfl alone, not "Kfl + UdpIp + Lift".**
`DoAppAcacheSweepSim` samples a 12 M-cycle window at the default 100 MHz, and
DoApp calibrates each benchmark to one simulated second — so the window never
reaches UdpIp or Lift. Dropping the declared clock to 5 MHz shrinks the
calibration 20x and fits all three.

**Second correction: the mix is completely different per benchmark.**

| stall share | Kfl | UdpIp | Lift |
|---|---|---|---|
| **bytecode fill** | **65.9 %** | 45.1 % | **14.6 %** |
| handle deref + element + bounds | 8.6 % | 35.9 % | **78.1 %** |
| statics | 25.5 % | 13.5 % | 7.2 % |
| idle/direct | **0 %** | **0 %** | **0 %** |
| stalled cycles | 13.1 % | 11.2 % | 8.1 % |

Weighted over all three, bytecode fill is **47.7 %** of stall cycles, handle and
array indirection **33.0 %**, statics **17.7 %**.

**So the method cache is the right target for Kfl, half the story for UdpIp,
and the wrong target for Lift**, where handle dereference and array element
access dominate at 78 %. Optimising it would have looked like a 62 % win and
delivered nothing on a third of the suite.

**Three things worth keeping:**

1. *Direct access is free.* 18-38 % of transactions issue from `IDLE`, and
  `READ_WAIT`/`WRITE_WAIT` are explicitly not-busy states (matching VHDL
  rd1/wr1) — the core does not wait. **Zero** stall cycles on every benchmark.
  Strike it from the attack surface.
2. *Lift's few bytecode fills are enormous:* 2,595 transactions for 151,485
  stall cycles, **58.4 cycles each**, against 1.40 for Kfl. Rare misses on large
  methods, not a steady stream. A bigger cache and a faster fill are different
  fixes; Lift needs the former, Kfl the latter.
3. *Statics cost exactly 2 cycles every time* on all three — one in
  `GS_READ`/`PS_WRITE`, one in `LAST`. A predictable, uniform 17.7 % that no
  cache currently touches.

**MEASURED ON SDR 2026-08-19 (`DoAppMemTimeSdrSim`), and the BRAM caveat was
justified — one conclusion above does NOT survive.** Same instrumentation
(`MemProfile`), real W9825G6JH6 timings at a real 80 MHz, Kfl:

| Kfl | BRAM | **SDR 80 MHz** |
|---|---|---|
| stalled cycles | 13.1 % | **53.9 %** |
| bytecode fill | 65.9 % | 58.7 % |
| **idle/direct** | **0 %** | **18.4 %** |
| statics | 25.5 % | 17.7 % |
| handle + element + bounds | 8.6 % | 5.2 % |
| cyc/txn (bytecode fill) | 1.40 | 8.68 |

**The harness is validated:** 53.9 % independently reproduces item 38's 53.8 %
for Kfl, measured a completely different way (BRAM-vs-SDR throughput ratio
there, cycle attribution here).

**"Direct access is free" was a BRAM artefact.** It costs 0 % of stall on BRAM
because `READ_WAIT`/`WRITE_WAIT` complete next cycle, and 18.4 % on SDR where a
read is ~8.5 cycles. Striking it from the attack surface, as recorded above,
would have been wrong on every real board.

The clock cannot be scaled down for an SDR run the way it can for BRAM:
`clockFreqHz` feeds both the controller's ns-to-cycle conversion and DoApp's
one-second calibration, so lowering it makes memory artificially cheap. Kfl
alone therefore takes 272 M cycles; UdpIp and Lift need either a much longer
run or the hardware counters (item 50), which is the better route now they
exist.

### Item 50 — ~~Memory-stall profile measured on real memory, on hardware — DONE~~

**DONE 2026-08-19.** The BRAM profile in item 37 was never going to transfer,
and it did not. Measured with the `IO_PERFCNT` counters on three boards
covering two memory technologies, two FPGA vendors and three toolchains, plus
an SDR simulation as a cross-check.

| board | bench | stall % | bytecode fill | idle/direct | statics | indirection |
|---|---|---|---|---|---|---|
| A-E115FB **DDR2** 75 MHz | Kfl | 52.2 % | **62.8 %** | 15.6 % | 16.6 % | 5.1 % |
| | UdpIp | 51.9 % | 53.0 % | 19.0 % | 7.8 % | 17.1 % |
| | Lift | 30.0 % | 3.1 % | 29.5 % | 6.8 % | **60.7 %** |
| CYC5000 SDR 80 MHz | Kfl | 61.4 % | 56.8 % | 20.9 % | 18.1 % | 4.4 % |
| | UdpIp | 60.8 % | 46.6 % | 25.2 % | 9.4 % | 15.6 % |
| | Lift | 38.9 % | 2.2 % | 42.1 % | 8.0 % | 48.0 % |
| Colorlight i5 SDR 40 MHz | Kfl | 46.4 % | 61.5 % | 16.1 % | 17.1 % | 5.5 % |
| | UdpIp | 46.0 % | 50.3 % | 19.8 % | 8.6 % | 18.2 % |
| | Lift | 26.0 % | 4.0 % | 29.7 % | 7.6 % | 59.2 % |

**[Full journal →](status/item-50.md)** — 391 lines of investigation detail.

### Item 51 — ~~The method cache is capped at 2 KB~~ — FIXED. Default is now 8 KB/64 blocks: **+35 % Kfl, +27.7 % UdpIp**, validated on FOUR BOARDS

**Why this matters.** Item 50 measured where stall time goes on real memory:
bytecode fill is **62.8 % of Kfl's stall and 52.9 % of UdpIp's**, and stall is
~52 % of all cycles. So the method cache owns roughly **a third of every cycle
Kfl executes** (0.522 x 0.628 = 32.8 %; UdpIp 27.5 %; Lift 0.9 %). It is the
largest single line item in the whole profile, and item 50 also showed that a
32 KB L2 in front of DRAM takes only 3 % off it — the fix has to be in the
method cache itself, not behind it.

**[Full journal →](status/item-51.md)** — 398 lines of investigation detail.

### Item 38 — ~~Measure DoApp's memory-stall fraction~~ — **ANSWERED 2026-08-18: 34-55 %**

`DoAppBramSim` runs the same binary against BRAM and compares per MHz with the
EP4CGX150 SDR hardware figures:

| benchmark | BRAM /MHz | SDR @80 /MHz | **stall share** |
|---|---|---|---|
| Kfl | 209.6 | 96.8 | **53.8 %** |
| UdpIp | 97.4 | 44.0 | **54.8 %** |
| Lift | 240.2 | 158.6 | **34.0 %** |

**Real applications lose a third to a half of their throughput to memory
latency.** So memory-system work IS worth doing on real code — which was the
open question — and this is the ceiling on all of it: roughly **2x on Kfl and
UdpIp, 1.5x on Lift**, if memory latency were eliminated entirely.

Internally consistent with what was already known: Lift has the LOWEST stall
share, matching the cache A/B where Lift gained most from the object/array
caches (its working set fits them), while Kfl and UdpIp stay partly
memory-bound even with caches and showed the per-MHz gain at 36 MHz.

**Method note worth reusing.** DoApp calibrates each benchmark to one *simulated*
second, which at a declared 100 MHz is 100 M cycles apiece — the first attempt
ran out at 400 M cycles without finishing Kfl. The harness now takes a declared
`clkMhz`, and lowering it to 5 shrinks the calibration target proportionally
**with no effect on the per-MHz result**: reported rate is `N x clkFreq /
cycles`, so `rate / (clkFreq/1e6)` is `N x 1e6 / cycles` — iterations per
million cycles, with `clkFreq` cancelled.

**Caveats.** BRAM is not zero-latency (single-cycle accept, next-cycle
response), so the true stall share is slightly higher. The figures are for the
EP4CGX150 SDR path; a DRAM board with an L2 will differ.

### Item 39 — The L2 hit path is serial — 3 cycles per hit, 58-61 % of the DRAM access interval

**`LruCacheCore` serves every request through one FSM, hit or miss.**
`IDLE -> TAG_COMPARE -> CHECK_HIT` is 3 cycles for a read hit, 4 with
`WRITE_HIT`. On `jbe.Scale` that floor is 28 cycles/access with no misses at
all, against 48.7 measured on DDR3 and 46.5 on DDR2 — **58 % and 61 % of the
whole interval is the cache servicing hits one at a time.**

The MSHR work made MISSES concurrent; hits were left strictly serial. Worth
at most 48.7 -> 28 on that benchmark, and gated by item 38 for real code.

### Item 40 — A leaner MSHR entry — each holds a full cache line of write data a read miss never uses

**Each MSHR entry stores a whole cache line of write data** (128 bits
on DDR3, 256 on DDR2) even though a read miss needs none of it and only a
partial write miss does. That is what makes **8 MSHRs unroutable at 8 cores**
on the XC7A100T (94 % LUT at synthesis, congestion level 5, 27,257 node
overlaps).

Since 4 MSHRs is already an under-provision for 8 cores — each core holds one
outstanding BMB transaction — the measured 4.38x is a FLOOR for the approach,
not its best. Storing write data only for write entries, or merging into the
line at allocation, is the obvious fix.

### Item 41 — Neither 8-core DRAM build closes timing, MSHRs or not

**8-core builds do not close timing on either DRAM board**, and did not
before the MSHR work either: DDR2 -3.056 ns (was -3.059), DDR3 -0.501 ns
blocking and -0.465 ns with MSHRs. `jbe.Scale`'s `CHECK` is bit-identical
across every build, which is what makes measuring on them defensible — but
they are **measurement vehicles, not shippable bitstreams**.

The DDR2 case cannot be fixed by lowering the clock: `mem_if_clk_mhz` 150.0
at half rate floors the system clock at 62.5 MHz against the ~61 MHz needed.
The shared root cause is the `BmbMemoryController -> cmdFifo` path — item 5.

**2026-10-12, the A-E115FB back: both DDR2 builds are WORSE than August's, and
`SmpGcTest` passes on both anyway.**

| build | logic | WNS, Slow 100C (August) |
|---|---|---|
| `ae115fbDdr2SmpMshr 4 4` | 73,335 LE (64 %) | **-3.231 ns** (-1.524) |
| `ae115fbDdr2SmpMshr 8 4` | does not fit: 7,259 LABs of 7,155 ([item 53](#item-53)) | -- |
| `ae115fbDdr2SmpMshr 8 4 mcache=12/5` | 104,687 LE (91 %) | **-5.189 ns** (-3.056) |

The worst paths are the item-5 family, about 2 ns deeper: a core's `StackStage`
A register through the memory controller and arbiter into `LruCacheCore`'s
`cmdFifo` and `CardTable.mAddr` (four cores) or `BmbCacheBridge.burstAddr`
(eight). Not isolated; the logic grew ~3,000 LE at four cores since August.

`SmpGcTest` at room temperature: **`SMPGC OK`** at 4 and at 8 cores, eight
rounds each, `lost 0`, `haltLeak 0`, and the other cores' stacks scanned -- the
first multi-core GC run on DDR2. On violating bitstreams, so measurements, not
verifications; the 8-core one with the 4 KB method cache August had.

### Item 42 — Secondary-hit merging is not implemented — a request to a line being filled replays

**Secondary hits replay rather than attach.** A request to a line
already being filled is bounced back through `IDLE` instead of joining the
MSHR that is already fetching it. Deliberate: the one-in-flight-miss-per-set
rule makes merging an optimisation rather than a correctness requirement, and
leaving it out kept the first implementation tractable. Pure throughput, no
correctness impact.

### Item 43 — ~~Colorlight i5 SDRAM stage is silent~~ — FALSE ALARM, retracted same day

**Retracted 2026-08-18, hours after being raised.** The i5 SDRAM stage is fine.
It builds (49.65 MHz PASS at 40), programs, boots, and runs both benchmarks:

| | |
|---|---|
| `jbe.DoApp` | Kfl **5580**, UdpIp **2547**, Lift **7713** 1/s at 40 MHz |
| `jbe.Scale` | **287 kacc/s** single core, `CHECK 1645838336` — the same value every other board produces |

**How the false alarm happened, because it is worth not repeating.** The test
sequence was: program, run a download, download fails, then listen raw at a
sweep of bauds — silence at every one. But **the failed download had already
consumed the ready handshake**, which is precisely the trap documented the same
morning in `fpga/scripts/run_bench` and the Wukong board notes: *a previous
download attempt makes a live board look completely silent.* Reprogramming and
listening immediately gives a clean `0xAA` stream.

The download failure underneath it was mundane and also mine: `download.py`
output is block-buffered when piped, so `timeout` killed it and discarded the
buffer, producing no diagnostics at all. `fpga/scripts/run_bench` now runs it
with `python3 -u`.

**Two lessons, both already written down and both ignored in the moment:**

- **Order matters when diagnosing a silent board.** Reprogram immediately before
  listening, or the handshake state confounds the measurement. Writing the trap
  into a script does not help if the debugging is done by hand around it.
- **Silence versus garbage is a real discriminator** — and it only means what it
  is supposed to mean if the board has not been disturbed first.

### Item 44 — The compute floor C is per-configuration, so single-core latency decompositions are unsafe

**Found 2026-08-18** by trying to falsify the transaction-cost model on the
Colorlight i5 — the only board with a **32-bit SDRAM** (`BmbSdramCtrlWide`, one
op per BMB beat against the 16-bit boards' two), and therefore the only
available discriminator.

The test: subtract the compute floor C from measured cycles/access, divide by
transactions and ops-per-beat, and check the implied **ns per SDRAM operation**
is roughly a device property. It is not.

| board | SDRAM | MHz | kacc/s | cyc/acc | implied ns/SDRAM op |
|---|---|---|---|---|---|
| Colorlight i5 | 32-bit, 1 op/beat | 40 | 287 | 139.4 | **135.0** |
| Wukong SDR | 16-bit, 2 ops/beat | 100 | 621 | 161.0 | **38.9** |
| EP4CGX150 SDR | 16-bit, 2 ops/beat | 36 | 188 | 191.5 | **154.6** |

**The two boards that share a memory width AND a controller disagree by 4x**, so
the premise collapses before the i5 is considered — the test cannot
discriminate. What it does establish is that **C = 90.3 cycles/access is not
portable.** C was measured on one core configuration (the default BRAM harness);
`ep4cgx150Serial` and the Wukong SDR preset have different bytecode maps and
compute units. Subtracting the wrong C throws the entire remainder off.

**Consequence: do not derive per-operation costs from a single C.** Any
decomposition of the form `(cycles/access − C) / transactions` needs C measured
for *that* configuration. `JbeScaleBramSim` already does it; it just has to be
run per core config instead of once.

**What this does NOT invalidate:** the eight-core aggregate figure in
[the MSHR plan](architecture/nonblocking-cache-mshr-plan.md) —
`36.2 cyc/access / 9.09 txns / 2 halves = 1.99 cyc per 16-bit op` — uses no C at
all. It is a service RATE, not a latency decomposition, and stands.

**The i5 is healthy and is now a genuine third data point**: different fabric
(ECP5), different toolchain (yosys/nextpnr/ecppack), different memory width. Per
MHz on `jbe.DoApp` it beats every other board measured — figures in
[`../java/apps/JbeBench/README.md`](../java/apps/JbeBench/README.md), not
repeated here.

Two effects are confounded and separating them is the open work: a lower clock
makes fixed-ns memory latency cost fewer cycles (already documented for 36 vs
80 MHz on one board), and the 1:1 SDRAM halves operations per beat. The i5 at
40 MHz beats the EP4CGX150 at 36 MHz by 14-18 %, which is the right order for
the ops-per-beat effect but is not proof of it.

### Item 52 — The Java tools duplicate the hardware config by hand, and the copies are silently stale

**How this surfaced.** Item 51 changed one number in one place —
`JopCoreConfig.jpcWidth` 11 -> 13, `blockBits` 4 -> 6. Documenting that change
turned up **three** hand-maintained copies of the same geometry in the Java
tree, none of which moved with it, and none of which anything checks:

| copy | file | held | should be |
|---|---|---|---|
| `CACHE_BLOCKS` | `JOPConfig.java` | 16 | 64 |
| `CACHE_SIZE_WORDS` | `JOPConfig.java` | 1024 | 2048 |
| `getMaxMethodSize()` | `JOPModel.java` | `return 512;` | unclear — see below |

The first two are corrected as of 2026-08-20. **That is a patch, not a fix**,
and the next configuration change will break them again.

**Why it is worth an item rather than a shrug.** `CACHE_SIZE_WORDS` was
*already* wrong before item 51 — it declared 1024 against a hardware 512. That
error had been in the tree for years and was harmless by luck: it overstated the
cache, but in the direction that made WCET analysis pessimistic. After item 51
the same stale 1024 understates a 2048-word cache, and a WCET bound computed
from it would be **unsound** rather than merely loose. The value did not change;
the direction of its wrongness did, because the hardware moved past it. A
duplicated constant is not a small problem in a WCET tool — being conservative
by accident is not the same as being conservative.

Nothing in the current build flow reads any of them, which is the only reason
this has been survivable: `CACHE_BLOCKS` and `CACHE_SIZE_WORDS` are registered
in `jopOptions[]` but the `JOPConfig` constructor never reads them into a field
and there is no getter, and `getMaxMethodSize()` has no caller anywhere in
`java/tools`. They are dead today and wrong today. The failure mode is someone
wiring up the WCET analyser later and inheriting the drift without ever seeing
it happen.

**`getMaxMethodSize()` is left alone deliberately.** It carries its own
`// TODO get this from cache config` and its unit is ambiguous: JOP returns
512, which matched the *old* cache capacity in WORDS, while `JVMModel` and
`JamuthModel` both return 65535, which is the classfile limit in BYTES. One of
those readings is wrong and the code does not say which. Guessing a new number
for a WCET input is worse than leaving a stale one next to a TODO, so it stays
until someone establishes the unit.

**Note the constraint inverted.** Method size used to be bound by the cache
(`min(1024, 512) = 512` words); it is now bound by `METHOD_SIZE_BITS`
(`min(1024, 2048) = 1024`). Any code or analysis carrying "the cache is the
limit" is now wrong — see
[architecture/constant-dependencies.md](architecture/constant-dependencies.md)
section 3.

#### What to build instead

Two configs, not one hand-edited set:

1. **A generated config per preset.** `JopCoreConfig` is already the single
   source of truth in the SpinalHDL tree; emit the Java-side constants from it
   at generation time, the way `DramPllGen` now emits the PLL rather than
   having it hand-edited in `dram_pll.vhd` (see the EP4CGX150 PLL trap in
   section 8 — same species of bug, already solved once here).
2. **A checked-in default** for tools run without a preset, so `java/tools`
   still builds and runs standalone.

[architecture/configuration-driven-plan.md](architecture/configuration-driven-plan.md)
section 3c already proposes exactly this (`JopSimConfig.java` generated from
`JopCoreConfig`, then `JopSim.java` and `JOPConfig.java` importing from it).
That plan predates item 51 and was never executed; item 51 is the evidence for
why it should be. The plan's own example values were themselves stale (`// 16`,
`// 512`) and were corrected on 2026-08-20 — a plan to stop hand-maintaining
constants, whose constants had to be hand-maintained.

**Minimum acceptable outcome** if the full generator is too much: a build-time
cross-check that fails loudly when the Java copies and `JopCoreConfig` disagree.
The drift is only dangerous because it is silent. `constant-dependencies.md`
lists several other pairs with "NO LINK" against them (`METHOD_SIZE_BITS` vs
`MAX_BC`, `pcWidth` vs `Jopa.ADDRBITS`, `ramWidth` vs `Jopa.RAM_LEN`), so a
general checker would pay for itself well beyond the method cache.

### Item 53 — REGRESSION: the 8 KB method cache default broke 4-core Wukong SMP fit

**Found 2026-08-22 while measuring the L2 under SMP, not by anyone building
SMP** — which is the point. Memory records 4/6/8-core Wukong DDR3 SMP validated
on **2026-08-16**. The 8 KB/64-block method cache became the default on
**2026-08-20** (item 51). Nothing rebuilt an SMP bitstream in between, so the
regression sat undetected for two days.

**[Full journal →](status/item-53.md)** — 147 lines of investigation detail.

**The A-E115FB's 8-core DDR2 stopped fitting too** (2026-10-12):
`ae115fbDdr2SmpMshr 8 4` needs 7,259 LABs and the EP4CE115 has 7,155 (99 % of
LEs); August's 8-core, with the 4 KB cache, used 93 %. `mcache=12/5` fits it at
91 % ([item 41](#item-41)).

### Item 54 — Statics are Kfl's largest stall category (41 %) and no cache touches them

**Promoted out of [item 51](#item-51) on 2026-08-23**, which fixed the category
that used to dominate. This is what the profile looks like underneath it.

On the A-E115FB with the 4 KB/32-block cache, Kfl's stall decomposes to
**statics 41.2 %** (692 cycles per iteration), `idle/direct` 38.8 % (652,
[item 55](#item-55)), indirection 213, bytecode fill 123. Those absolute figures
are the load-bearing ones: item 51 showed every category except bytecode fill was
unchanged **to the cycle** across the geometry change, so the shares moved only
because the total shrank.

**Statics are a uniform 7-18 % of stall on every board and every workload**
measured in item 50 — before the method cache fix, when they were third-order.
They are now first.

**Why they are addressable.** The static region is small and its size is known at
link time, so it can live in on-chip RAM instead of going to DRAM. Nothing caches
it today: the object cache keys on handle+offset and the array cache on array
elements, and a `getstatic`/`putstatic` is neither.

**What is not yet established** — and should be, before any RTL:

- **How big the region actually is** across the benchmark set and DoAll. It is
  asserted to be small; it has not been counted.
- **Whether the cost is latency or bandwidth.** 692 cycles/iteration is a
  category total, not a per-access cost, and the access count was never
  extracted. A handful of very hot statics behaves differently from a large
  working set, and only the first is fixed by a small BRAM.
- **The SMP story.** A per-core static RAM is wrong — statics are shared mutable
  state and JOP's memory model expects them coherent. A shared arbitrated port is
  another consumer on the arbiter, which items [5](#item-5) and [31](#item-31)
  already identify as the clock ceiling. This may make the multicore case a
  different design from the single-core one.

**Suggested first step, no RTL:** count static accesses and distinct static
addresses per benchmark, from a simulation trace. That distinguishes the three
cases above and is the same discipline that made item 51 tractable — the sweep
before the design.

**Counted 2026-11-11** ([performance outlook](analysis/performance-outlook.md),
section 2.4). Two of the three questions are answered, and the third stands.

- **Size: small.** Each image's link map gives the whole static region. It is
  1.6-2.3 KB everywhere checked: DoAll 2.3 KB, DeepAll 1.6, NetTest 2.0,
  SmpGcTest 1.7, and the JbeBench loops 1.7-2.3. One RAMB36 holds any of them,
  with no tags.
- **Cost: latency.** From JopSim, run over 10,000 iterations of each benchmark
  loop:
  - Kfl makes 75.3 static accesses per iteration, UdpIp 79.1 and Lift 12.1.
  - They touch only 85, 61 and 43 distinct statics. 90 % of the accesses go to
    27, 15 and 4 of them.
  - 11-22 % of the accesses are writes.
  - Against the 2026-08-20 Wukong SDR capture, each access stalls 10-12 cycles.
    A `getstatic` is five microinstructions plus that stall, and JOPizer
    already puts the address in the operand.
  - An on-chip RAM at about two cycles an access would save about 16 % of Kfl's
    cycles, 8 % of UdpIp's and 3 % of Lift's (estimated).
- **SMP: unchanged.** The shared-state argument above still decides the design.
  A single shared RAM with fixed time-slot arbitration would keep it
  predictable.

Since this count, statics are the second performance lever, not the first:
calls, [item 179](#item-179), cost about three times as much on Kfl.

### Item 55 — The core stalls on writes whose result it never uses — about 3.5-5 % of cycles, not the `idle/direct` share first blamed on it

**Corrected 2026-11-11: `idle/direct` is reads, not these writes.** The mechanism
below is real, but the share it was given was not its own.

- **What the counter counts.** `catOf` in `Sys.scala` puts the memory
  controller's states 0-2 in the `idle/direct` category: `IDLE`, which is never
  busy, `READ_WAIT` and `WRITE_WAIT`. Those are the microcode's simple reads and
  writes (`stmra`, `stmrac`, `stmraf`, `stmwd`).
- **Where these writes wait instead.** `putfield` and `iastore` wait in
  `HANDLE_DATA_WAIT`, which is counted as `element`. `putstatic` waits in
  `LAST`, which is counted as `statics`. Their waits were never in
  `idle/direct`.
- **What `idle/direct` is.** The microcode issues a fixed number of simple reads
  per bytecode: three for `invokestatic`, one for each return, and so on.
  Counting them in JopSim and dividing `idle/direct` by them gives the same cost
  on all three benchmarks: 8.1, 8.6 and 8.5 cycles per read for Kfl, UdpIp and
  Lift. Of those reads, 98 %, 69 % and 78 % are a call's. The rest are mostly
  `ldc` on UdpIp and `arraylength` on Lift. See [item 179](#item-179).
- **What these writes are worth.** Kfl makes 22.9 writes per iteration, UdpIp
  56.0 and Lift 34.0, each stalling 8-10 cycles. That is 3.5 %, 4.0 % and
  5.0 % of the cycles, and it is the ceiling for a write buffer.

Section 2.3 of the
[performance outlook](analysis/performance-outlook.md) has the tables. The text
below is as written on 2026-08-23. Read its 39 % as `idle/direct`'s share, not
these writes'.

**Promoted out of [item 51](#item-51) on 2026-08-23.** Kfl's second-largest
category after statics: `idle/direct` is **38.8 %** of stall, 652 cycles per
iteration on the A-E115FB, and 16-42 % of stall across the boards in item 50.

**The mechanism is known and is a genuine defect of the memory path, not a
tuning parameter.** `WRITE_WAIT` in `BmbMemoryController` is *busy until
`rsp.valid`* — the core blocks until the write is acknowledged. But
`putfield`, `iastore` and `putstatic` are **unconditionally write-through**
(`BmbMemoryController:1101-1104` issues the BMB write regardless of tag hit;
the "only on tag hit" condition gates the cache UPDATE, not the write). So the
core waits for a result it does not consume.

**What a fix needs, and why it is not a small change:**

- **Read-after-write forwarding.** Once writes are posted, a subsequent read of
  the same address must see the buffered value rather than stale memory. This is
  the part that makes it a correctness change rather than a latency change.
- **An SMP coherence story.** Posted writes are visible to the issuing core
  before other cores, which is exactly the class of bug that cost days in the
  global-lock work ([the lock is not reentrant](#item-1) presented as corruption,
  not deadlock). `CmpSync`, the card-marking barrier and the GC's cross-core root
  scan all assume writes have landed.
- **A bound for WCET.** A write buffer that can be full turns a fixed stall into
  a variable one; the analysis needs a depth and a drain rate.

**Not yet established:** how much of the 39 % is actually the write wait. The
`idle/direct` counter aggregates write stalls with other direct-path idle
cycles, and nothing has separated them. **Do that first** — it sets the ceiling
on the whole exercise, and item 51's history is that the category names in this
profile do not always mean what they sound like.

*(Settled 2026-11-11, at the top of this item: almost none of it is.)*

### Item 179 — A method call and its return cost ~130 cycles, about half of Kfl's; `idle/direct` is mostly their memory reads

**Raised 2026-11-11**, from the cycle accounting in the
[performance outlook](analysis/performance-outlook.md), section 2. This is the
largest performance lever found so far, and it can be fixed without giving up
predictability.

**What a call costs (from the microcode, `asm/src/jvm_call.inc`).**

- `invokestatic` runs about 73 microinstructions (`invokestatic`,
  `invoke_main`, `invoke`, `invoke_vpsave`). `return` runs about 21.
- Between them they make four simple memory reads and two method-cache lookups.
  The reads are the constant-pool entry, two words of the method structure, and
  on return the caller's structure.
- At the ~8 stall cycles a read measured below, that is about 130 cycles.
  NetBench measured 129 for an empty static call on the i9+ (2026-11-10).
- Other invokes cost more: `invokevirtual` and `invokespecial` make four reads,
  `invokesuper` five and `invokeinterface` six.

**How much it costs (JopSim counts, 10,000 iterations of each loop).**

| Per iteration | Calls | Cycles in calls (estimated) | Measured cycles |
|---|---|---|---|
| Kfl | 22.9 | ~2,980 (~49 %) | 6,128 |
| UdpIp | 38.0 | ~4,940 (~35 %) | 14,296 |
| Lift | 12.0 | ~1,560 (~28 %) | 5,545 |

Measured cycles are from the Wukong SDR at 100 MHz, the 2026-08-20 perf-counter
capture. For Kfl, the same per-operation accounting sums to within 1 % of the
measured total: statics 18 %, branches 13 %, stack-only bytecodes 11 %.

**`idle/direct` is the calls' reads.** Every simple read lands in `READ_WAIT`,
which the counter files under `idle/direct`. Dividing the category by the reads
the microcode issues gives the same cost on all three workloads:

| Per iteration | Simple reads | Share from calls | `idle/direct` cycles | Cycles per read |
|---|---|---|---|---|
| Kfl | 93.2 | 98 % | 758 | 8.1 |
| UdpIp | 240.1 | 69 % | 2,060 | 8.6 |
| Lift | 68.1 | 78 % | 578 | 8.5 |

This corrects [item 55](#item-55), which took the category for write waits.

**What would fix it, keeping predictability.**

- **Method structures and the constant pool in on-chip memory.** They are
  read-only and fixed at link time, so they are as analysable as the method
  cache. This removes the four reads, which are all of `idle/direct` that calls
  account for, and speeds `ldc` too.
- **A hardware call/return sequencer.** The microcode saves and restores sp, pc,
  vp, cp and mp one register per microinstruction; hardware can do it in
  parallel.
- **Inlining small static, private and final methods in JOPizer.** The Kfl
  image's median method is 9 bytes of bytecode, so the call costs more than the
  callee. The method cache's block count has to absorb the larger code.

If a call and return came down from ~130 cycles to ~30, Kfl would run about
1.6x faster, UdpIp 1.36x and Lift 1.28x (estimated).

**Not yet established.**

- A cycle-accurate measurement of one call and return at 100 MHz. The ~130 rests
  on the i9+'s 129 at 50 MHz and on the read cost above.
- How the cost splits among the remedies.

Measure both in simulation before choosing a remedy.

### Item 180 — fifteen formal properties check nothing: below BMC depth 4 an assertion under `pastValidAfterReset()` is never reached

**Found 2026-11-12** while proving a new jump-table property could fail ([item
165](#item-165)): with the jump table's GC-stop branch disabled, it still passed.

**Calibrated in this flow** (SpinalHDL 1.12.2, SymbiYosys, Z3), against the
jump table:

| assertion | depth 2 | depth 3 | depth 4 |
|---|---|---|---|
| `assert(False)` under `pastValidAfterReset()` | passes | passes | **fails** |
| the GC-stop property, branch disabled | -- | passes | **fails** |

An unguarded `assert(False)` passes at depth 2 as well.

**Fifteen tests assert only under that guard, at depth 3 or less,** so they have
never checked anything -- found by scanning each `test(` block for `withBMC(d)`,
d <= 3, together with the guard:

- **`JumpTableFormal`, all four.** FIXED with item 165: at depth 4 all four hold
  on the RTL, and the GC-stop one fails with its branch disabled.
- **`ShiftFormal`, all four** (USHR, SHL, SHR, full shift by 31), at depth 2.
- **`StackStageFormal`, six:** the zero, negative and equal flags, and SP
  decrement, increment and hold, at depth 3.
- **`Crc8MaximFormal`, "clear resets CRC to zero",** at depth 3.

The formal job's pass count (147 on 2026-11-12) has included them all along.

**Next:** raise each to depth 4 or more, prove each red with its feature broken,
and guard the class -- no formal test may assert under `pastValidAfterReset()`
below depth 4. A property that has never been checked may be false the first
time it is, so expect to debug some of them, not only change a number.

**No guard.** Open.

### Item 56 — WBNI: derive the hardware configuration from the application, instead of picking a preset

**Raised 2026-08-23.** Build the core for the program it will run: analyse the
Java application, work out what it actually needs, emit a `JopConfig`, then
build the FPGA. Light on doubles, leave the DCU out. The flow would be

```
develop on host JDK/sim -> analyser -> .jop + JopConfig for this target
                        -> FPGA build -> remote debug if needed
```

**[Full journal →](status/item-56.md)** — 106 lines of investigation detail.

### Item 57 — ~~The XDC/QSF generators exist and NOTHING USES THEM~~ — DONE

> **CORRECTED 2026-09-10 (audit of closed items). The headline claim was false
> when it was written.** This item said *"every board build now reads generated
> constraints"* and *"the tracked `.xdc`/`.qsf` files that remain are no longer
> INPUTS"*.
>
> **As of 2026-08-31**, nine Vivado targets passed **tracked** `.xdc` on the
> command line, including the flagship DB V5 DDR3 build — and `git log -L` dates
> two of those lines to 2026-08-26, five days *before* this item closed.
>
> **As of 2026-09-10** the DB V5 flagship, the Wukong SMP DDR3 path and
> `wukong_jop_bram` are converted and the rest are declared: **9 by design,
> 6 gap**. The live number is whatever `make check-build` prints — this
> paragraph is dated because the previous version of it said "nine … including
> the flagship DB V5 build" in the present tense and was false within a day of
> being written. A count in prose is a snapshot; the guard is the fact.
>
> **Why nothing caught it:** `check-generated-deps.sh` enumerates boards by
> `include ../quartus.mk`, reaching **7 of 12**. Every flow that would have
> contradicted the claim sat outside the guard's own board list. *A guard that
> enumerates its own subjects decides what it is allowed to find.*
>
> **The claim is now CHECKABLE, which is the actual fix.** Every tracked
> constraint a build reads must be declared in `check-generated-deps.sh`, in one
> of two categories, and an undeclared one fails the build:
>
> | | count | meaning |
> |---|---|---|
> | **by design** | 9 | nothing in a `JopConfig` knows these facts — PHY clock and false paths, `set_clock_groups` on an IP-created clock, SPI flash properties, stand-alone bring-up exercisers |
> | **gap** | 6 | should be generated; each names what blocks it |
>
> Separating those two is the point. Item 57 could claim "every board build"
> only because hand-written-on-purpose and not-yet-generated were never
> distinguished — and **this guard repeated the mistake one level down**: it
> matched `$(CONSTRAINTS)/` and `$(XDC)/` but not `$(SHARED_XDC)/`, so the three
> references to the deliberately hand-written set in `fpga/constraints/` were
> excluded *by a regex rather than by a decision*. They are declared now, which
> is why the total went 13 → 15 while the work shrank.
>
> Converted and hardware-proven 2026-09-10: the DB V5 flagship (`DoAll` 3/3),
> the Wukong SMP DDR3 path, and `wukong_jop_bram` (generated == tracked,
> diff=0). The six remaining gaps are [item 149](#item-149).
>
> Guard: `.github/scripts/check-generated-deps.sh` — an undeclared tracked
> constraint fails, and so does a declaration nothing reads any more. Both
> proved red 2026-09-10.
>
> **This item stays DONE, and the DONE is honest for its TITLE:** the generators
> existed and nothing used them; things use them now. What was false is the
> closing summary below, which generalised from "the flows I converted" to
> "every board build". Corrected in place rather than left for the next reader
> to trip over.

> **Closed 2026-08-31.** ~~Every board build now reads generated constraints.~~
> **FALSE — see the correction above.** What was true on that date: the Wukong
> and i5 Makefiles invoke `XdcGeneratorMain` / `LpfGeneratorMain`, the EP4CGX150
> takes a generated `pins.tcl`, and `quartus.mk` generates the `.sdc` and the
> project Tcl. ~~the Wukong's SMP SDR flow — the last one reading a tracked
> file~~ — it was not the last: nine Vivado targets still read tracked `.xdc`,
> two of them since 2026-08-26.
>
> ~~The tracked `.xdc`/`.qsf` files that remain are no longer INPUTS.~~ **Also
> false.** Some are oracles — `ConstraintDriftTest` checks the generators
> against them, and deleting those as "unused" would remove the only thing that
> would notice the generator drifting. Others are still INPUTS, named on
> `JOP_XDC=` command lines. Both kinds live in the same directory, which is
> exactly why the distinction was easy to lose.
>
> And some are correctly hand-maintained and always will be: PHY timing
> (`create_clock e_rxc`), clock-group exclusions on IP-created clocks, SPI flash
> configuration, and the stand-alone bring-up exercisers. Nothing in a
> `JopConfig` knows those exist.

**[Full journal →](status/item-57.md)** — 124 lines of investigation detail.

### Item 58 — ~~`source` inside an XDC is silently ignored by Vivado — four shared constraint files have never been applied~~ — CLOSED 2026-10-12

> **CLOSED 2026-10-12 — the Ethernet half went with `f7e435f`.** `XdcGenerator`
> emits the GMII constraints for every GMII design (`e_rxc` created, the clock
> wizard's 125 MHz output grouped, RX captured in IOB flops), the Wukong reads
> the generated block, and `rtl8211eg_gmii.{xdc,sdc,qsf}` are deleted. No
> tracked `.xdc` or `.sdc` contains a `source` line any more. Guard:
> `spinalhdl/src/test/scala/jop/config/GeneratedConstraintsTest.scala` pins the
> generated GMII constraints; nothing scans tracked constraint files for a
> `source` line.

> **Partially closed 2026-08-31.** The SDR SDRAM IOB packing named below is now
> applied: the Wukong's SMP SDR flow was reading a tracked `wukong_jop_sdram.xdc`
> that lacked `set_property IOB TRUE` on `sdram_DQ`/`sdram_DQM`, while the
> generated file carries both. Pointing that flow at the generated constraints
> applied them for the first time. The Ethernet GMII half of this item is
> untouched.

**[Full journal →](status/item-58.md)** — 122 lines of investigation detail.

### Item 59 — ~~the Colorlight i5 SDRAM build does not meet timing~~ — WITHDRAWN, it passes. I read the wrong line

**Raised and withdrawn 2026-08-24. There is no failure and no regression.** The
i5 meets its 40 MHz target and always did:

| i5 build | LUT4s | DP16KD | Fmax (final) |
|---|---|---|---|
| `89da8fb^`, 08-12 code | 9,364 (38 %) | 12 | **47.45 MHz PASS** |
| BRAM stage, 08-18 | 8,847 (36 %) | 40 | **48.62 MHz PASS** |
| current default, 08-24 | 13,318 (54 %) | 15 | **49.40 MHz PASS** |

**The error.** A nextpnr log contains TWO "Max frequency" lines per clock: an
estimate after PLACEMENT, and the real figure after ROUTING. In this design they
differ by 17 MHz --

```
line 195:  32.56 MHz (FAIL at 40.00 MHz)   <- post-placement estimate
line 488:  49.40 MHz (PASS at 40.00 MHz)   <- final, post-routing
```

-- and I grepped the first match every time. The Makefile already does it
correctly, `grep -E "Max frequency" ... | tail -1`, which is where the reporting
convention was available to be read.

**What survives, and is worth keeping.** The method cache default DID cost this
board area: 9,364 -> 13,318 LUT4s and 12 -> 15 DP16KD, the latter being exactly
2 KB -> 8 KB of JBC RAM (1 -> 4 blocks). But it cost NO timing -- 47.45 ->
49.40 MHz, slightly faster. So the i5 absorbed the change that broke the 4-core
Wukong and the 12-core EP4CGX150, which fits: it is a single-core build at 54 %
LUT, not a multi-core build at 90 %+.

**And the critical-path reading stands**: the post-placement path does start at
`jbcRamWord`, the JBC RAM output mux. That is a real property of the design on
this part, and the reason `jpcWidth` rather than `blockBits` would be the knob
if this board ever did need one.

**The lesson is not about the i5.** Three claims were built on one mis-read
line, each of which sounded plausible and reinforced the last: a board failing
timing, a regression to bisect, and recorded passes contradicted by the logs.
The prior reporting was right the whole time; the check that broke the chain was
being asked "are we sure we are correct and prior reporting is wrong?" -- at
which point the surviving PASS lines were sitting in the same files I had
already grepped.

### Item 60 — ~~Everything generated should live under `build/<config>/`~~ — DONE

> **Closed 2026-08-31.** `fpga/` went from 1,775 MB to 7 MB; no board directory
> is a build directory any more, and `4471933` records the last of it. See also
> [item 94](#item-94), which states the same completion and disagreed with this
> heading for six days.

> **Reopened and finished 2026-09-04 — and WHY it read as done when it was
> not.** Every board flow had been converted, so every *build* landed in the
> right place. What survived was the DEFAULT: `BUILDTREE ?= 0` in `java/`, and
> `spinalhdl/generated` unless a caller passed `buildtree`. The correct layout
> needed a flag and the legacy layout was what you got by not asking, so
> anything not explicitly converted — a bare `make -C java`, 63 sims, five
> auxiliary scripts, 22 standalone generators — silently kept writing into the
> source tree. Both branches are now deleted; there is one layout, and
> `check-no-legacy-rtl-path.sh` / `check-no-intree-jop-path.sh` fail the build
> if either comes back.
>
> **A conversion is not finished while the old path is still the default.**
> Counting converted boards measured the wrong thing: the boards were all
> converted on 2026-08-31 and the source tree was still collecting build
> products four days later. What made it invisible was `.gitignore` — lifting
> the rules exposed a `Const.java` holding another configuration's constants,
> 28 stale `.jop` images and 83 JOPizer sidecars, none of them seen in months.
> An ignore rule on a path nothing should write is not tidiness; it is how a
> stale artefact survives.
>
> The justifying comment had also gone stale: it claimed 51 Makefiles and TCL
> scripts across ten boards read the legacy path, and by removal the real count
> was five auxiliary scripts. Same failure as the EP4CGX150 PLL comment — a
> reason to keep something outliving the thing that made it true.

**Raised 2026-08-23, in progress.** The goal the user set: *nothing generated or
built ends up anywhere other than under that build directory*, one directory per
build CONFIGURATION (preset plus arguments — not `entityName`, which collapses
core counts and overrides together). The layout itself is data
(`jop.generate.BuildLayout`), so it can be changed later without another sweep.

**[Full journal →](status/item-60.md)** — 241 lines of investigation detail.

### Item 144 — ~~The Java tools are per-configuration only because javac inlines constants~~ — DONE

> **CORRECTED 2026-09-10 (audit of closed items).** The item is sound — the built
> `jopizer.jar` contains no `Const.class` (`unzip -l` confirms) — but a **guard
> now argues the opposite**: `check-no-intree-jop-path.sh` still explains itself
> with *"jopizer.jar embeds Const.class … so it is a PER-CONFIGURATION
> artefact"*, which this item made false. The guard's assertion still works;
> only its stated reason misleads. Corrected 2026-09-10.

> **Closed 2026-09-04.** JOPizer is now ONE artefact that is told which machine
> it is linking for. It lives in `build/java/tools/jopizer.jar` and contains no
> `Const.class`.

**What it was.** `JopMethodInfo` read `Const.METHOD_MAX_SIZE`, derived from the
preset's method cache. `Const`'s fields are `static final int`, so javac
**inlines** them: the limit was baked into the class file, jopizer.jar became a
per-configuration artefact, and in one shared location it went stale in a way
make could not see — the current config's `Const.java` is older than the jar the
previous config left behind, so a preset switch rebuilt nothing. Reproduced:
build A ran 2 compile steps, building B ran **0**, and B linked with A's
constants.

**The whole dependence was four values** — `METHOD_MAX_SIZE`,
`METHOD_MAX_LOCALS`, `METHOD_MAX_ARGS` (JopMethodInfo) and `MEM_TM_MAGIC`
(ReplaceAtomicAnnotation). `ConstGenerator` now emits them as data beside
`Const.java` (`jop-linker.properties`), and `com.jopdesign.build.LinkerConfig`
reads them at runtime from `-Djop.linker.config=<file>`, which every app
Makefile passes. **No defaults**: linking with another machine's limits yields
an image whose methods cannot be invoked, discovered on hardware rather than at
link time.

Verified: every app image is byte-identical to the compiled-in version
(`DoAll.jop` 2,954,863 bytes), and `jopizer.jar` carries no `Const.class`.

**A second defect found while testing this, and fixed.** JOPizer ended with
`catch(Exception e) { e.printStackTrace(); }` — every link error was printed and
then swallowed, so it **exited 0 and left a zero-byte `.jop`**. The build
reported success. It now removes the partial file and exits 1: leaving it means
the next make finds a `.jop` newer than its prerequisites and skips the
rebuild, so one failed link silently poisons every build after it. Found only
because the "missing config must fail loudly" test asserted on the exit status
as well as the message.

**JopSim stays per-configuration, deliberately.** Its 38 `Const` references are
the I/O map — `IOSimMin` models the addresses the hardware decodes. That is not
a tool setting the simulator should be handed; it is the machine being
simulated. It also produces no artefact anything else consumes, so a stale one
misleads a person reading its output rather than corrupting a build. It keeps
`build/<config>/java/tools`.

### Item 142 — The `<clinit>` order is decided by hash iteration order

**Raised 2026-09-04.** `OldClinitOrder.findOrder()` is a topological sort over
`clinit`, a Map keyed by `OldClassInfo`:

```java
Set cliSet = clinit.keySet();     // iteration order is not defined
```

Classes with no remaining dependencies are appended **in map iteration order**,
so every tie is broken by hashing rather than by anything meaningful. The result
is a valid topological order — one of many — and which one you get depends on
the JVM's iteration order for that map.

**How it surfaced.** Moving `jopizer.jar` out of `java/tools/dist` and giving
each jar its own classes directory (commit `d31ee3b`) changed what is on the
tool classpath. That alone permuted the `<clinit>` list and changed **every**
`.jop` image by 559 bytes — same (address, class) pairs, different order,
identical file size. A pure build-layout change altered the linked program.

**Why that is only half safe.** Any topological order satisfies the
dependencies the analyser FOUND. If a `<clinit>` depends on another class in a
way the analysis misses, the old order was correct by luck and the new one may
not be. Nothing checks the analysis for completeness, and the failure mode is a
board that does not boot — after the image has been signed off.

**Measured, not assumed:** the order is deterministic for identical inputs (two
clones at different paths produced byte-identical images), so this is not
run-to-run flakiness. It is *input*-sensitive in a way nobody would predict.

**Validated after the change:** DoAll 68/68 on EP4CGX150, Wukong and
Colorlight i5 with the reordered image, so the current order is good on all
three. That is evidence, not a guarantee — the next classpath change reshuffles
it again.

**Fix direction.** Make the tie-break explicit and stable — sort by class name
before appending, or use a `LinkedHashMap`/`TreeMap` keyed on the name — so the
image stops depending on hashing. That makes images reproducible across tool
layouts, and it makes any future change in behaviour a real change rather than a
reshuffle. Separately, the dependency analysis deserves a check: if the order is
arbitrary among valid orders, the build should be able to say so.

### Item 143 — `setsid` + process-group kill leaks the child holding the serial port

**Raised 2026-09-04.** Board tests run the downloader as

```
setsid make download ... &        # then: kill -TERM -$!
```

`setsid` puts the child in its OWN session and process group, so `kill -$!`
signals the group the *make* is in, not the group `download.py` ended up in.
The python survives.

**What that costs.** Three `download.py` processes were found still running
**7h54m** after their board test finished, each holding a serial port open. The
next download on the Wukong failed with

```
serial.serialutil.SerialException: device reports readiness to read but
returned no data (device disconnected or multiple access on port?)
```

which reads exactly like a dead board or the stalled CH340 of item 108 — the
same symptom, an entirely different cause. Nothing in the flow notices, because
the leaked process is not a child of anything the shell still knows about.

**How to kill it properly:** match the actual process, not the group —

```
p=$(ps -eo pid,args | awk '/[d]ownload\.py/ {print $1}'); [ -n "$p" ] && kill -9 $p
```

The bracket in `[d]ownload` keeps the `awk` from matching itself, which is the
same self-match trap as `pgrep -f`.

**Worth doing:** the board Makefiles' `download` target could take a timeout, or
the console flow could refuse to start when the port is already held and say by
what. A leaked holder that presents as broken hardware is expensive to diagnose
twice.

### Item 146 — ~~64 simulations built a Verilator model without the X-state defence~~ — FIXED

**Verilator randomises every unreset register from the simulation seed** — about
405 of them in this design. An FPGA powers up at zero, so a seed-dependent
failure is a simulator artefact, not a hardware bug. `--x-initial 0` removes the
class, and `jop.utils.JopSimDefaults` is where that flag lives.

This was already the SINGLE root cause of three CI flakes — items
[29](#item-29), [30](#item-30) and [32](#item-32). Each was closed by routing
**one** sim through the defence. **The class was never closed**: 64 sims still
built their own config from a bare `SimConfig` and took the randomisation.

**It bit again.** The scheduled run of `44fd48e` (2026-09-07 08:21) failed
`readme-walkthrough` step 7:

```
Per-core WD toggles: C0=0 C1=0
FAIL: Did not see 'NCoreHelloWorld' from core 0
```

Neither core toggled its watchdog, so nothing ran at all. The same job passed on
the next push. `JopSmpNCoreHelloWorldSim` is defined in `JopSmpBramSim.scala`,
which used a bare `SimConfig` at three sites.

**Fixed** by routing all 64 through `JopSimDefaults.config`, and by a guard —
`.github/scripts/check-sim-xstate.sh`, in `make check-build` — that fails if any
file which calls `.compile`/`.doSim` reaches `SimConfig` without going through
`JopSimDefaults` or `TestVectorUtils.simWave`.

**Why a structural guard rather than a seed replay.** A seed names an initial
state only relative to a fixed netlist *and* a fixed Verilator build; CI runs
5.020 and a Debian workstation runs 5.032, so CI's seed reproduces nothing
locally and a clean local sweep proves nothing about CI. Catching a
probabilistic failure is not a test. The guard is deterministic, runs in a
second, and cannot pass for the wrong reason. That reasoning is recorded in the
guard itself, because it is exactly the argument that lost twice before.

**Evidence.** Guard red on the unfixed tree naming 64 files; green after.
`Test/compile` recompiled exactly those 64. `JopSmpNCoreHelloWorldSim` then ran
with `Sim X-state: zeroed` and reported `Per-core WD toggles: C0=1 C1=1` /
`PASS: All 2 cores running` — the same counters that read `C0=0 C1=0` in the
failure.

**Gotcha — the escape hatch still matters.** `JOP_SIM_XINIT=random` restores
randomisation. Zeroing hides genuinely missing resets, which are worth fixing on
their own merits; the point is that CI should be a regression detector, not a
random number generator.

### Item 147 — ~~A cleanup made a test slower until it blew CI's wall~~ — FIXED

`JopSmpBramSim` ends at the **first observed GC**, which arrives when the heap
first exhausts. Its runtime is therefore the time spent **filling** memory, not
the time spent testing — and filling takes longer when the program is smaller.

Item 137 removed ~190 lines of dead interpreter scaffolding from `Startup`. That
left **+644 words** of free heap (34748 → 35392), pushing the GC **28 rounds**
further out — about 6% more cycles. The nightly job had been using **81 of its
90 minutes**, so 6% was enough, and `readme-walkthrough-long` was cancelled
three nights running. **A cleanup was punished with a red build.**

**The amplifier.** Free heap is `memSize - image`, a difference of two similar
quantities, so it magnifies any change in image size. Halving the heap does not
halve free memory — measured, it cut it 6.1x:

| heap | free at R0 | rounds to GC | cycles | wall |
|---|---|---|---|---|
| 128 KB | 35392 | 464 | 58.0M | 48m 23s |
| 64 KB | 5776 | 16 | 2.7M | 46s |

**The assertion is identical in both** — `1 GC cycles observed` with 2 cores.
The 464 rounds are the countdown to the assertion, not the assertion. What they
do buy is soak: sustained two-core allocation.

**Fixed** by making the choice explicit rather than inherited:

- default heap **64 KB** — same assertion, 56x less wall clock, deterministic
- `JOP_SMP_GC_HEAP=131072` — the deliberate soak, still available
- a **cycle budget** (10M default) replacing the flat 100M ceiling
- the CI job's wall cut 90 → 30 minutes

**Gotcha — two failures used to read the same.** Running out of cycles while
free memory is still *falling* means the test never reached its assertion; the
collector is not implicated. It now says so, naming the trend and the levers:

```
FAIL: no GC within the 1000000-cycle budget -- free was still FALLING
(5776 -> 4496 over 5 rounds). The heap is 64KB; this test ends when the heap
first exhausts, so a SMALLER program takes LONGER to get here.
```

Before this, that same condition reached CI as `The operation was canceled` and
took a log diff against the last good run to identify.

**Evidence.** Red: budget below the GC point fails with the message above.
Green: default 64 KB passes in 46 s, 2.69M of 10M cycles. Soak: 128 KB via the
env var reproduces the old 464-round run.

### Item 148 — ~~The DDR2 board is off, and its blaster is what failed~~ — BACK 2026-10-12 on the Terasic blaster

> **BACK 2026-10-12.** The Terasic blaster moved from the EP4CGX150 (which has
> no cable now) to the A-E115FB, and `ae115fbDdr2Eth` passes **DoAll 68/68**:
> DDR2 has hardware coverage again, on a bitstream built at HEAD after a month
> of changes, including the I/O-read re-latch removal (item 68). The same
> build brought up the bottom board's Ethernet at 1 Gb/s
> (`docs/peripherals/networking.md`). Its console CH340 is "USB2.0-Serial" as
> before. The Pico `e6616408` is still dead, so [item 100](#item-100)'s
> experiment stays blocked.

The level-shifted Pico blaster `e6616408` stopped working, and the **A-E115FB
EP4CE115 + 1 GB DDR2 was powered off** as a result (user, 2026-09-07). This is a
decision, not an open fault on the board.

**What it costs: DDR2 has no hardware coverage.** The A-E115FB is the only DDR2
board. Anything touching `CacheToDdr2Adapter`, `ae115fbDdr2` or the DDR2 path is
**simulation-only** until it returns. That is not a theoretical gap —
`CacheToDdr2Adapter` has already produced **two** defects that only hardware or
an ordering-faithful model catches: it never responded to writes at all (the
first dirty eviction deadlocked `LruCacheCore`), and later it acked writes at
**accept** time, which corrupts silently once misses overlap. `CacheToDdr2AdapterSim`
missed the first because it drives the adapter alone; a uniform-latency backend
model cannot find the second by construction.

Report hardware results accordingly: **"3/3 primary boards pass" covers SDR,
32-bit SDRAM and DDR3, not DDR2.**

**It also blocks [item 100](#item-100).** That item's remaining question is a
confound — the 2026-08-31 swap changed the cable *and* re-seated both plugs, and
the resolution was to put the Pico back on the EP4CGX150 and see whether 3/10
returned. That experiment needs a working Pico blaster. It cannot be run.

**Gotcha — the failure looks exactly like a fault worth chasing.** Cable
enumerates, `--assert-device` reports "no device in 10 attempts, TDO came back
empty", `--health` shows the port re-enumerating, and the CH340 console opens
cleanly and returns nothing. Every one of those also describes a real dead
cable, so the diagnosis runs to completion before arriving at a state that was
already known and intended. `jtag_probe_map`'s registry entry now says so at the
point of use.

**Open.** Closing it needs either a working blaster on that board (a replacement
Pico, or the Terasic moved back, which then costs the EP4CGX150 its cable) or a
second DDR2 target.

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
