peteryates1/jop-spinalhdl/docs/sample-applications.md

# Sample Applications

All sample applications run on the QMTECH EP4CGX150 + DB_FPGA platform. They
are built with the Small runtime and downloaded via serial UART.

## Application Index

| App | Source | Extra Modules | Port/Interface | Description |
|-----|---|---|---|---|
| HelloWorld | `src/test/HelloWorld.java` | — | UART | Prints "Hello World" to serial |
| NCoreHelloWorld | `src/test/NCoreHelloWorld.java` | — | UART | Multi-core hello (SMP test) |
| VgaTest | `src/test/VgaTest.java` | — | VGA | Text mode 80x30 display test |
| VgaDmaTest | `src/test/VgaDmaTest.java` | — | VGA | DMA framebuffer RGB565 test |
| SdTest | `src/test/SdTest.java` | — | SD card | SD native interface read/write test |
| Fat32Test | `fat32/src/test/Fat32Test.java` | `fat32/src` | SD card | FAT32 filesystem: create, read, write, LFN (30 checks) |
| EthTest | `src/test/EthTest.java` | — | Ethernet | Raw Ethernet frame test |
| NetTest | `src/test/NetTest.java` | `net/src` | Ethernet | UDP+TCP echo on port 7, ICMP ping |
| DhcpTest | `src/test/DhcpTest.java` | `net/src` | Ethernet | DHCP+DNS, then UDP+TCP echo |
| HttpServer | `src/test/HttpServer.java` | `net/src fat32/src` | Ethernet+SD | HTTP/1.0 file server on port 80 |
| SmpUartTest | `src/test/SmpUartTest.java` | — | UART (per-core) | 8-core SMP test, each core prints C&lt;id&gt; on JP1 |

All source paths are relative to `java/apps/Small/`.

## Build

All apps use the same build system:

```bash
cd java/apps/Small
make clean all JOP_PRESET=ep4cgx150DbFull APP_NAME=<name> [EXTRA_SRC="<paths>"]
```

**`JOP_PRESET` must match the bitstream the app will run on.** The generated
`Const.java` gives each device its I/O address, and on a preset without the
device that address points at nothing (status
[item 121](current-status.md#item-121)). It defaults to `ep4cgx150Serial`,
which has only the UART, so every app below that touches the DB_FPGA needs
`ep4cgx150DbFull` (or `ep4cgx150DbVgaDma` for `VgaDmaTest`). The image lands in
`build/<preset>/java/apps/Small/<name>.jop`.

### Examples

```bash
# Simple apps (no extra modules)
make clean all JOP_PRESET=ep4cgx150DbFull APP_NAME=HelloWorld
make clean all JOP_PRESET=ep4cgx150DbFull APP_NAME=VgaTest
make clean all JOP_PRESET=ep4cgx150DbFull APP_NAME=SdTest

# Fat32 (needs fat32 module)
make clean all JOP_PRESET=ep4cgx150DbFull APP_NAME=Fat32Test EXTRA_SRC=../../fat32/src

# Networking (needs net module)
make clean all JOP_PRESET=ep4cgx150DbFull APP_NAME=NetTest EXTRA_SRC=../../net/src
make clean all JOP_PRESET=ep4cgx150DbFull APP_NAME=DhcpTest EXTRA_SRC=../../net/src

# HTTP server (needs both net and fat32)
make clean all JOP_PRESET=ep4cgx150DbFull APP_NAME=HttpServer "EXTRA_SRC=../../net/src ../../fat32/src"
```

## Download and Run

```bash
cd fpga/qmtech-ep4cgx150-sdram

# Build and load the DB_FPGA bitstream (if not already configured)
make dbfpga dbfpga-program

# Download the app. The console port and baud are resolved from the build;
# never pass a /dev/tty path, they renumber on every replug.
make download CFG=ep4cgx150DbFull JOP_FILE=../../build/ep4cgx150DbFull/java/apps/Small/<name>.jop
```

The Ethernet on this build runs MII at 100 Mb/s
([networking](peripherals/networking.md)).

The download script monitors UART output after transfer. Press Ctrl+C to exit.

## FPGA Configurations

Some apps require specific FPGA builds due to mutually exclusive peripherals:

| Preset | Build Target | Peripherals |
|---|---|---|
| `ep4cgx150DbFull` | `make dbfpga` | VGA text, SD, Ethernet (MII) |
| `ep4cgx150DbVgaDma` | `make dbfpga-vgadma` | VGA DMA, SD, Ethernet (MII); misses timing by 1.011 ns (status [item 73](current-status.md#item-73)) |
| `ep4cgx150Smp 8` | `make smp CORES=8` | UART only (8 cores) |

VGA text and VGA DMA share the same pins and cannot be used simultaneously.

## App Details

### HelloWorld

Minimal test — prints "Hello World" to UART. Useful for verifying the basic
build/download/run cycle.

### Fat32Test

Comprehensive FAT32 filesystem test (30 checks). Requires a MBR-partitioned
FAT32 SD card. Tests: mount, directory listing, file create, read, write,
long file names (LFN), short 8.3 names, file size tracking.

```bash
make clean all JOP_PRESET=ep4cgx150DbFull APP_NAME=Fat32Test EXTRA_SRC=../../fat32/src
```

### NetTest

UDP and TCP echo server on port 7 with ICMP ping support. Prints periodic
diagnostics (RX/TX counts, MAC errors/drops). Takes its address from DHCP,
sending its unit's name as hostname (its board instance, in `setup/units.toml`),
and prints `IP=`. There is no static fallback: with no lease in 30 s it prints
`DHCP: no lease` and stops. The TCP echo serves one client per connection-pool
slot (`NetConfig.MAX_TCP_CONN`, 4) and drops a client silent for 30 s.

```bash
make clean all JOP_PRESET=ep4cgx150DbFull APP_NAME=NetTest EXTRA_SRC=../../net/src

# Test from host -- by name where the DHCP server registers names (Pi-hole
# here, domain lan), else by the IP= the console printed
ping jop-ep4cgx150-1.lan
echo "hello" | nc -u -w1 jop-ep4cgx150-1.lan 7    # UDP echo
echo "hello" | nc -w1 jop-ep4cgx150-1.lan 7       # TCP echo
fpga/scripts/net_echo_check.py jop-ep4cgx150-1.lan   # TCP echo survives RSTs,
                                                     # idle and dead clients
```

### DhcpTest

DHCP client test — obtains IP from network DHCP server, resolves a hostname
via DNS, then runs UDP+TCP echo on port 7. The TCP echo is written on
`java.net.ServerSocket`/`Socket` and behaves like NetTest's
(`fpga/scripts/net_echo_check.py`).

```bash
make clean all JOP_PRESET=ep4cgx150DbFull APP_NAME=DhcpTest EXTRA_SRC=../../net/src
```
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
