peteryates1/jop-spinalhdl/docs/boards/images/10cl025-u7-pinout.png

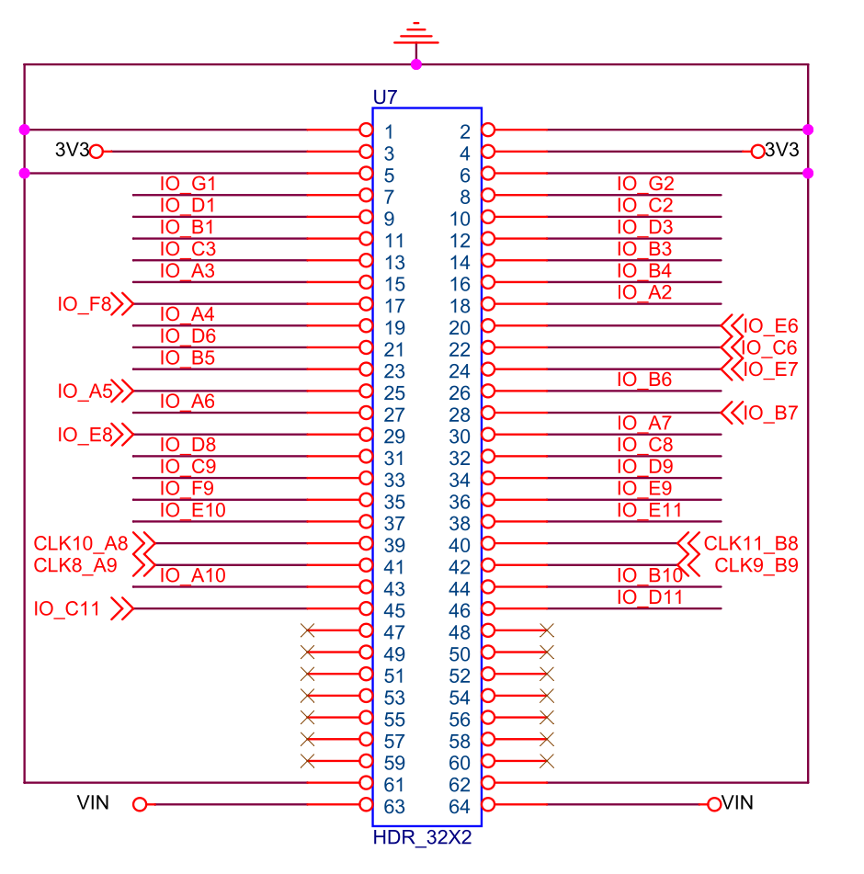
docs/boards/images/10cl025-u7-pinout.png
