peteryates1/jop-spinalhdl/docs/boards/images/dbfpga-v4-7seg.png

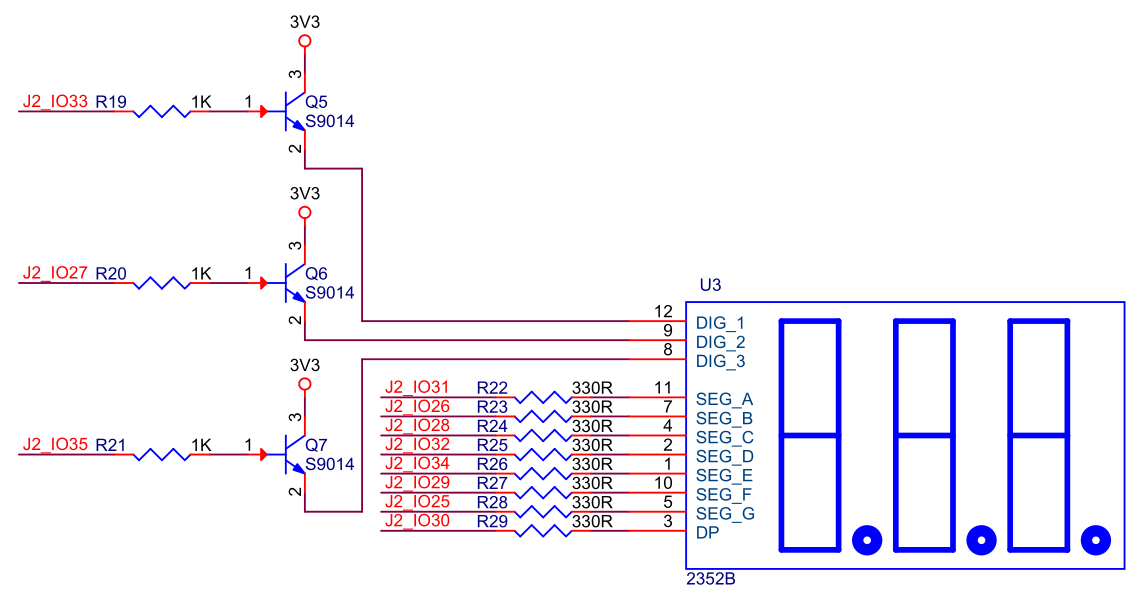
docs/boards/images/dbfpga-v4-7seg.png
