peteryates1/jop-spinalhdl/docs/boards/images/dbfpga-v4-cp2102n.png

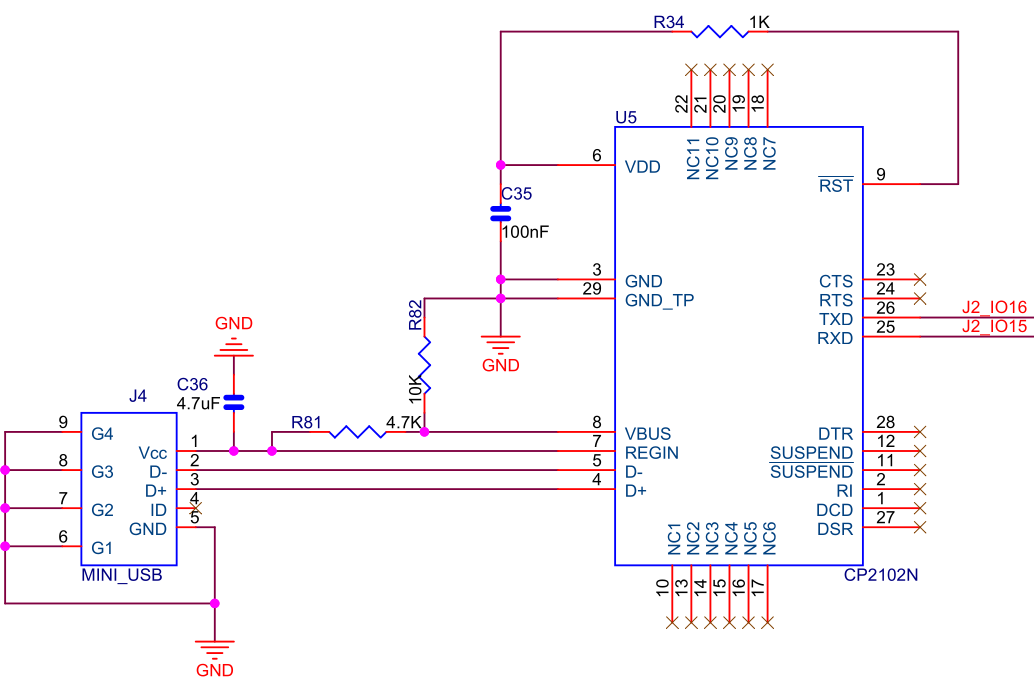
docs/boards/images/dbfpga-v4-cp2102n.png
