peteryates1/jop-spinalhdl/docs/boards/images/dbfpga-v4-ethernet.png

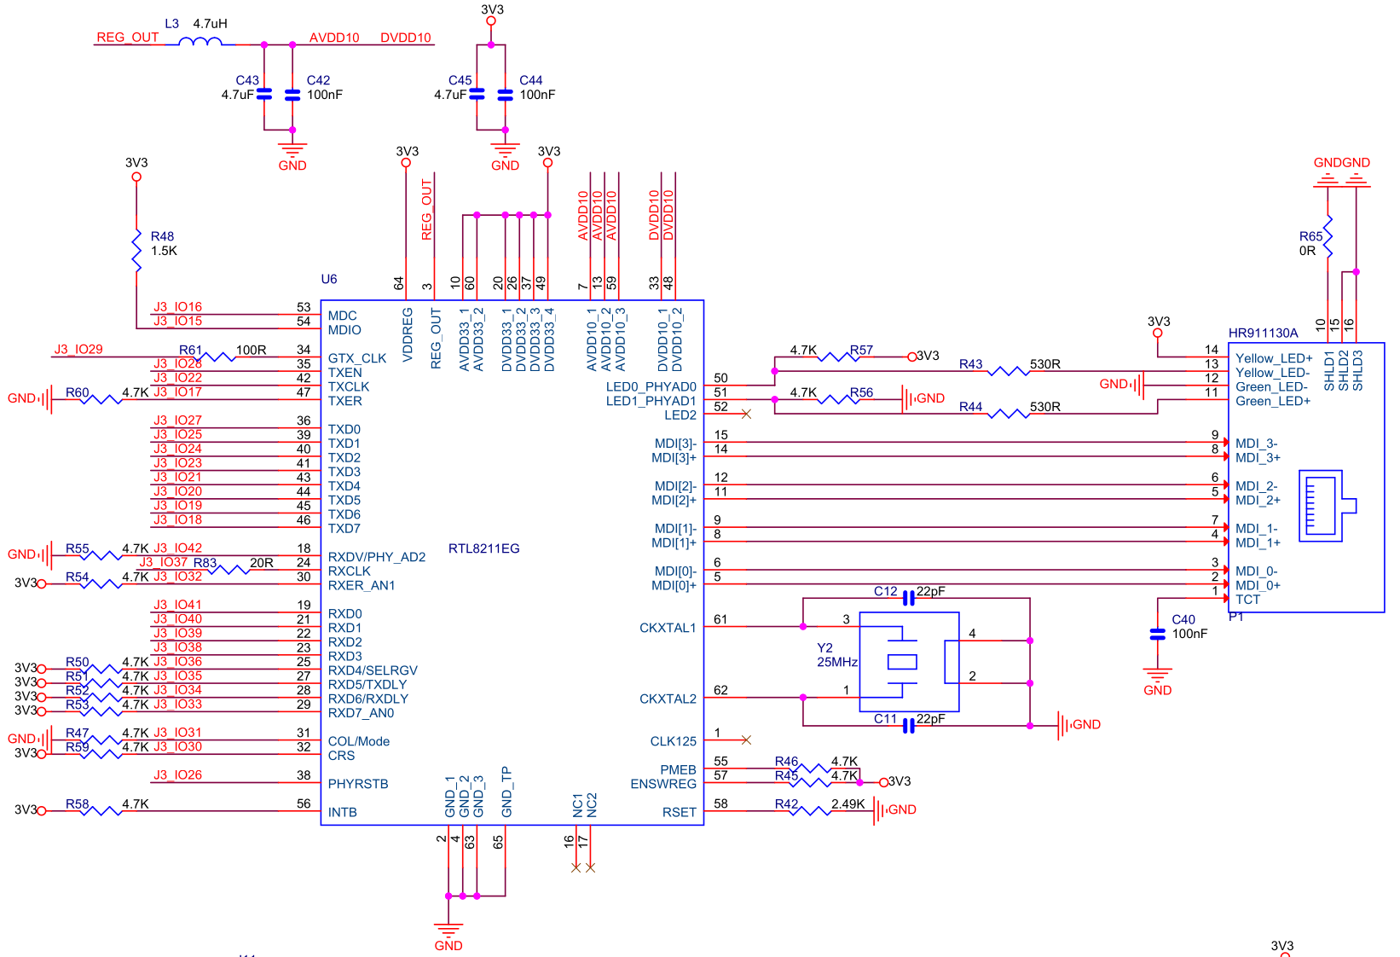
docs/boards/images/dbfpga-v4-ethernet.png
