peteryates1/jop-spinalhdl/docs/boards/images/dbfpga-v4-j2-pinout.png

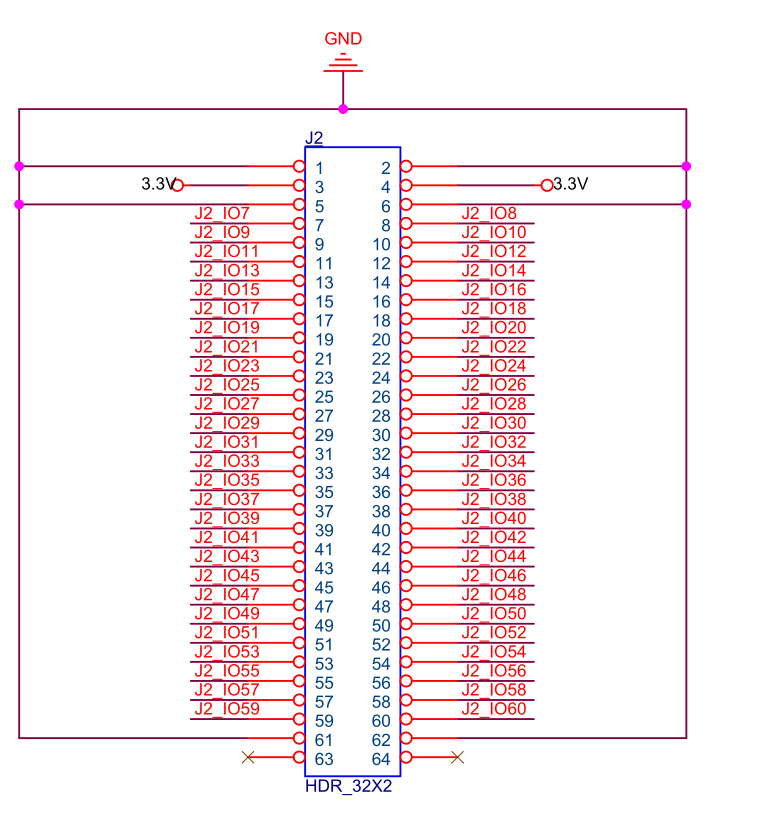
docs/boards/images/dbfpga-v4-j2-pinout.png
