peteryates1/jop-spinalhdl/docs/boards/images/dbfpga-v4-j3-pinout.png

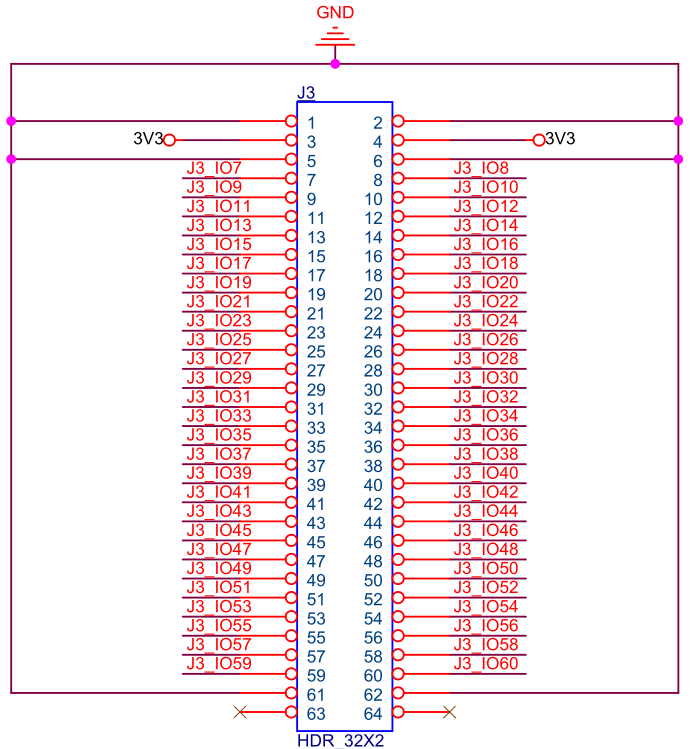
docs/boards/images/dbfpga-v4-j3-pinout.png
