peteryates1/jop-spinalhdl/docs/boards/images/dbfpga-v4-j10-j11.png

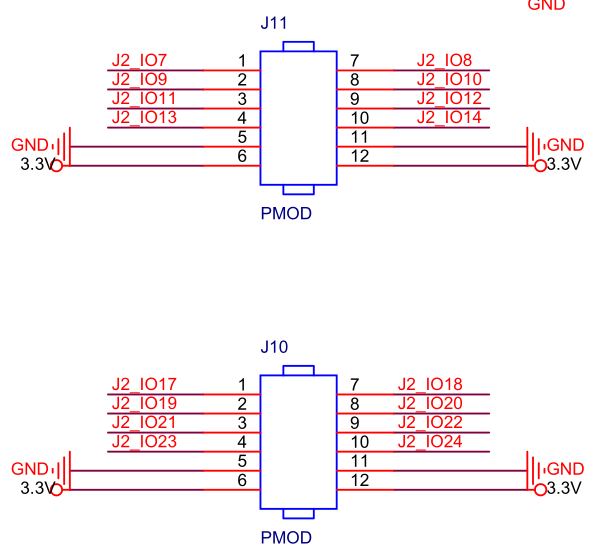
docs/boards/images/dbfpga-v4-j10-j11.png
