peteryates1/jop-spinalhdl/docs/boards/images/dbfpga-v4-jp1.png

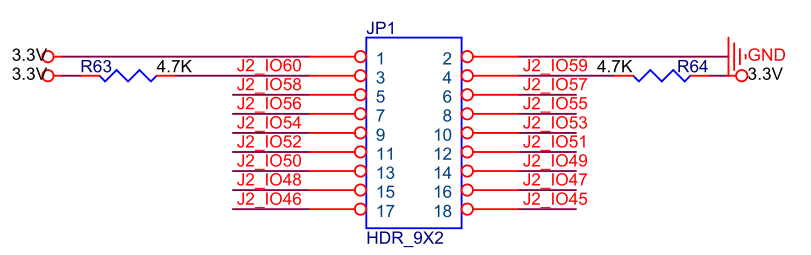
docs/boards/images/dbfpga-v4-jp1.png
