peteryates1/jop-spinalhdl/docs/boards/images/dbfpga-v4-led.png

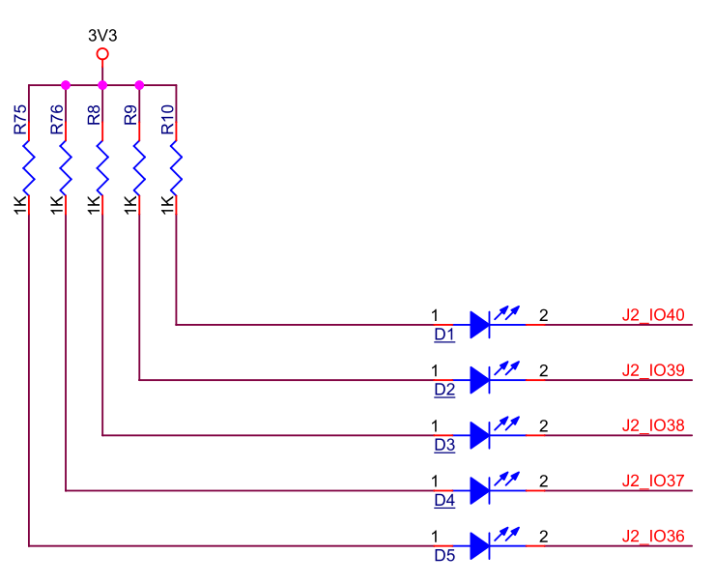
docs/boards/images/dbfpga-v4-led.png
