peteryates1/jop-spinalhdl/docs/boards/images/dbfpga-v4-sdcard.png

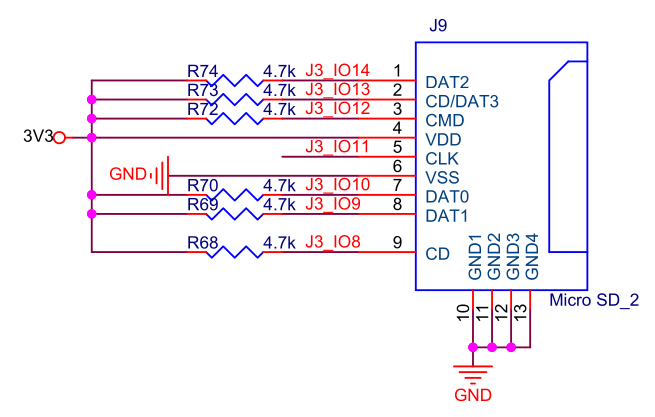
docs/boards/images/dbfpga-v4-sdcard.png
