peteryates1/jop-spinalhdl/docs/boards/images/dbfpga-v4-switches.png

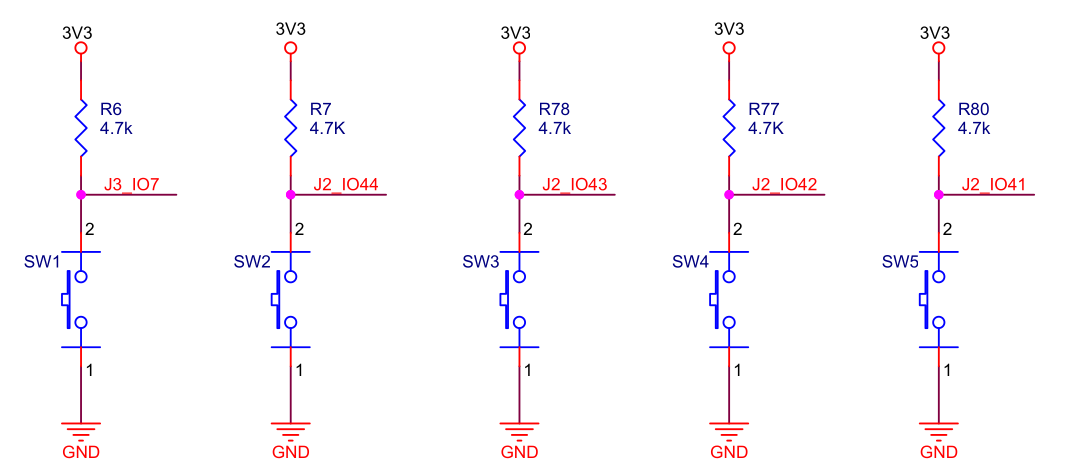
docs/boards/images/dbfpga-v4-switches.png
