peteryates1/jop-spinalhdl/docs/boards/images/dbfpga-v4-vga.png

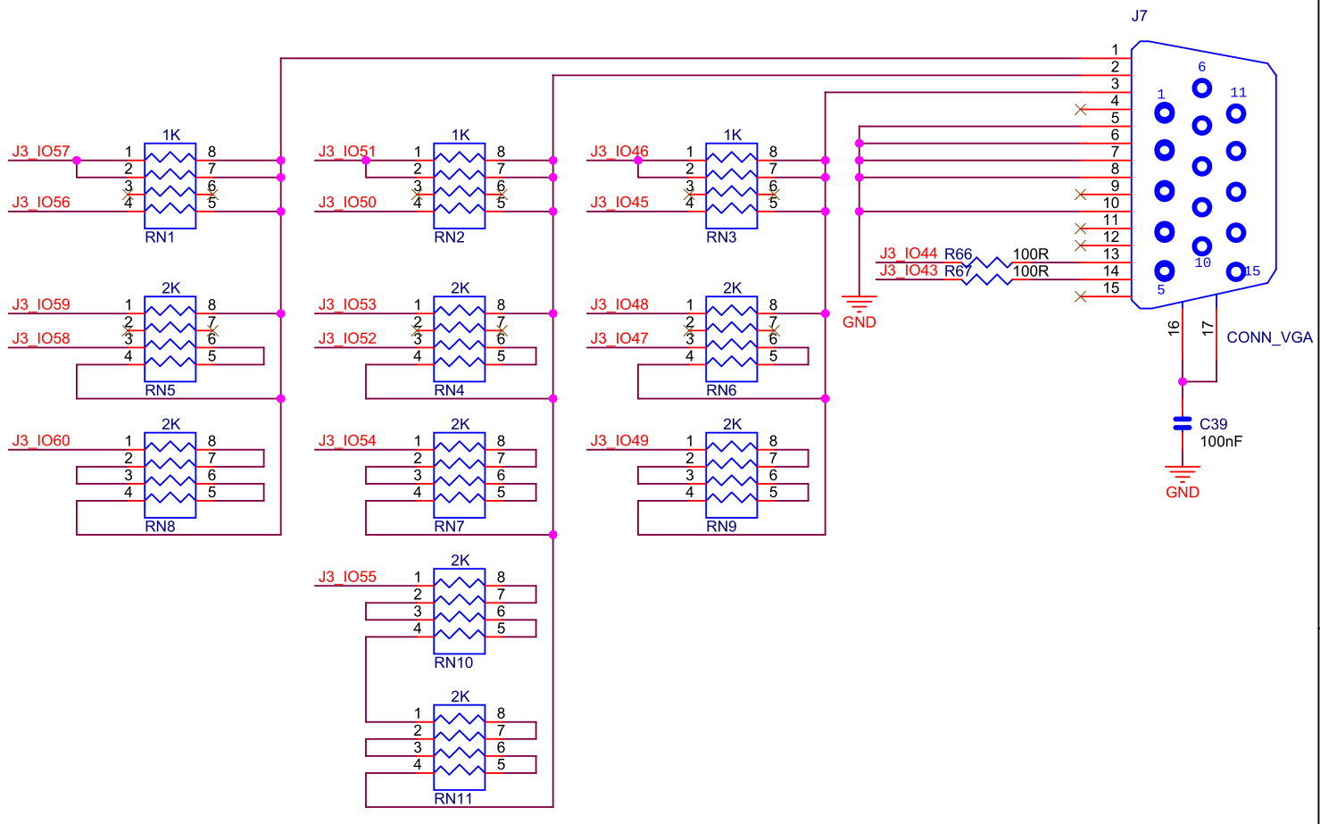
docs/boards/images/dbfpga-v4-vga.png
