peteryates1/jop-spinalhdl/docs/boards/images/dbfpga-v5-rp2040.png

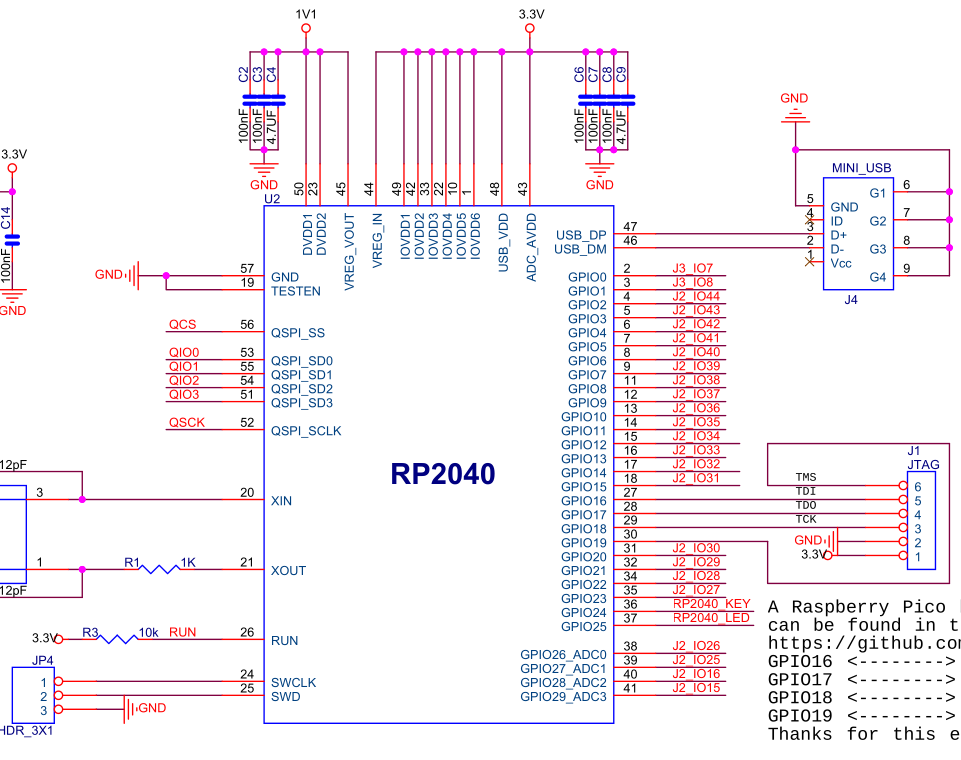
docs/boards/images/dbfpga-v5-rp2040.png
