peteryates1/jop-spinalhdl/docs/boards/images/ep4cgx150-leds.png

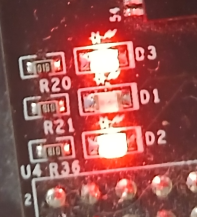
docs/boards/images/ep4cgx150-leds.png
