peteryates1/jop-spinalhdl/docs/boards/images/ep4cgx150-switches.png

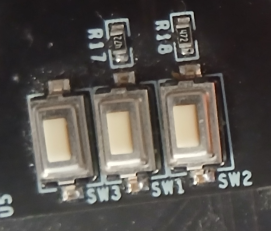
docs/boards/images/ep4cgx150-switches.png
