peteryates1/jop-spinalhdl/docs/boards/images/ep4cgx150-u4-pinout.png

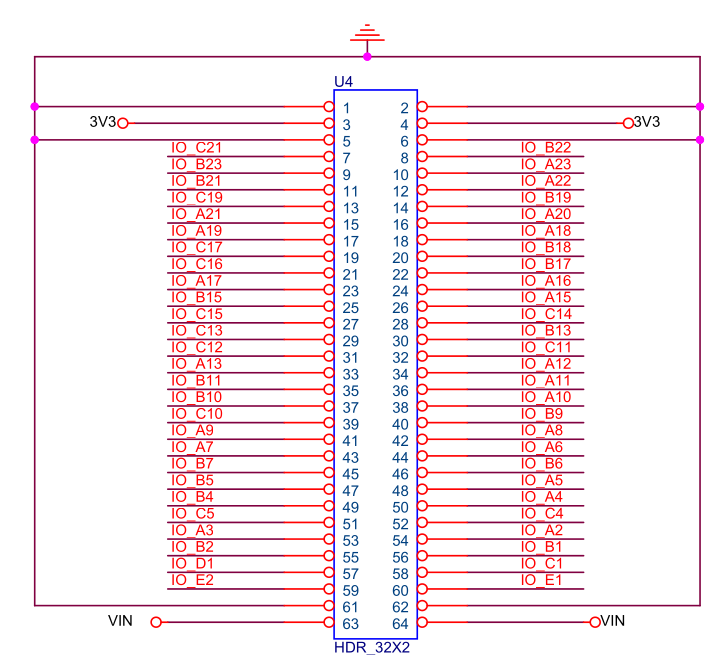
docs/boards/images/ep4cgx150-u4-pinout.png
