peteryates1/jop-spinalhdl/docs/boards/images/ep4cgx150-u5-pinout.png

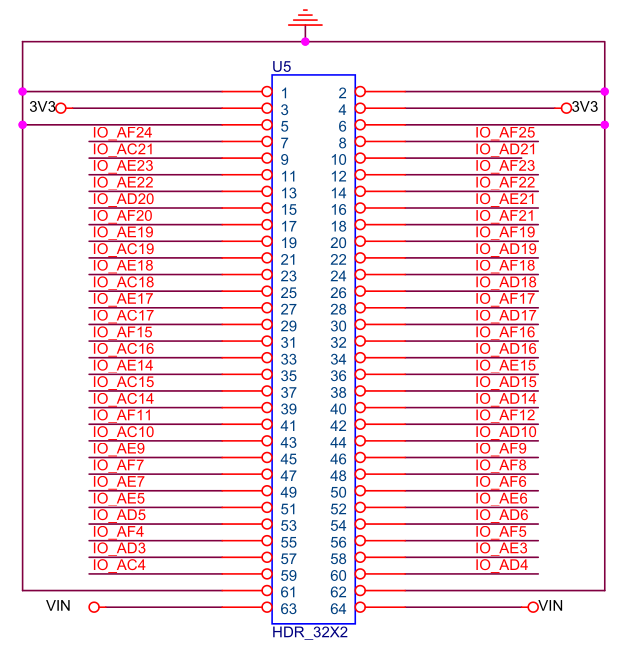
docs/boards/images/ep4cgx150-u5-pinout.png
