peteryates1/jop-spinalhdl/docs/boards/images/J10_J11_JP1_Connectors.png

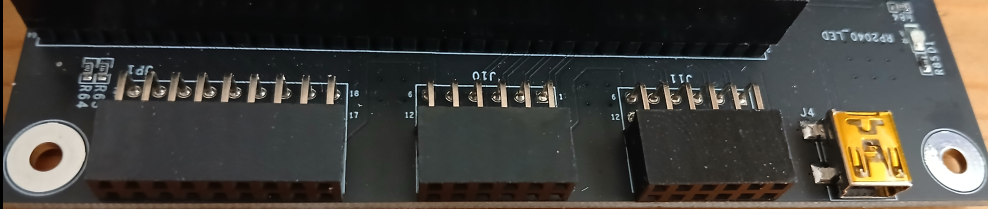
docs/boards/images/J10_J11_JP1_Connectors.png
