peteryates1/jop-spinalhdl/docs/boards/images/wukong-top-labelled-connectors.png

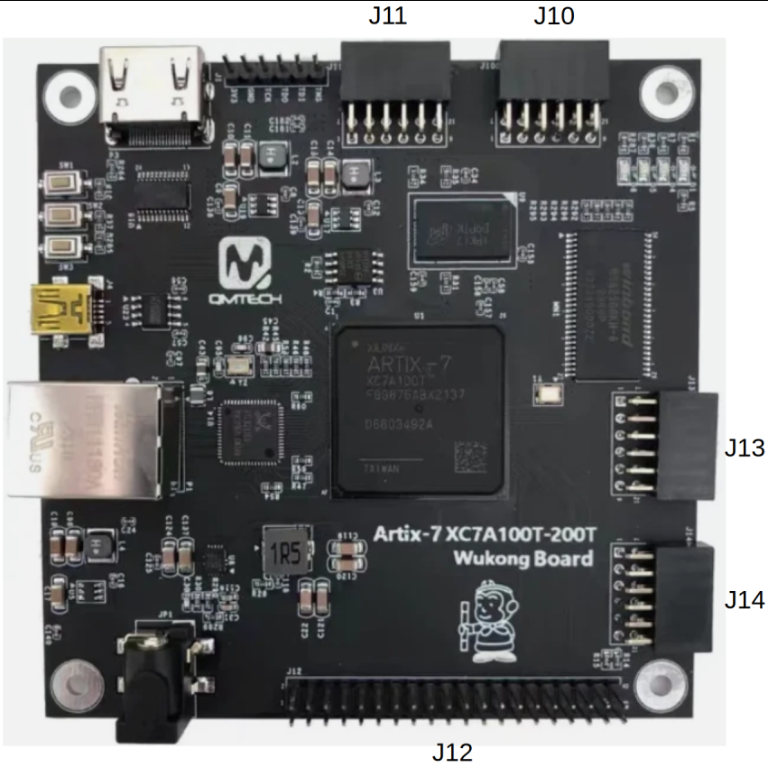
docs/boards/images/wukong-top-labelled-connectors.png
