peteryates1/jop-spinalhdl/docs/boards/images/xc7a100t-u2-pinout.png

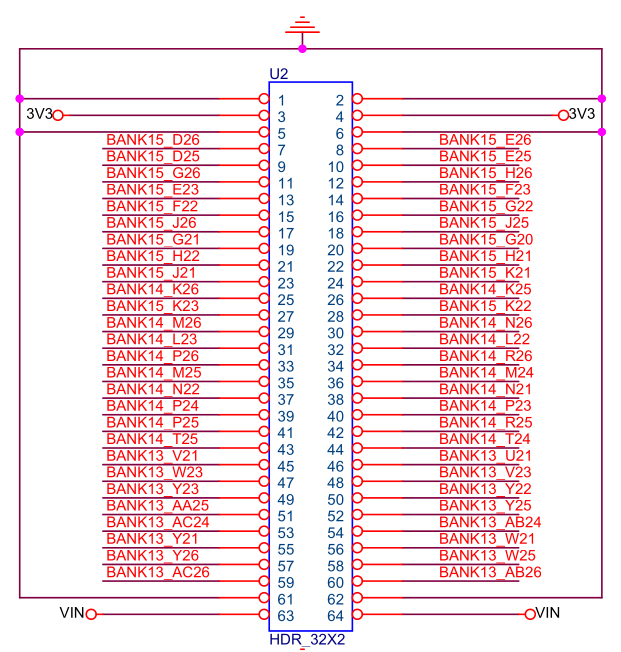
docs/boards/images/xc7a100t-u2-pinout.png
