peteryates1/jop-spinalhdl/docs/peripherals/vga-text-screenshot.jpg

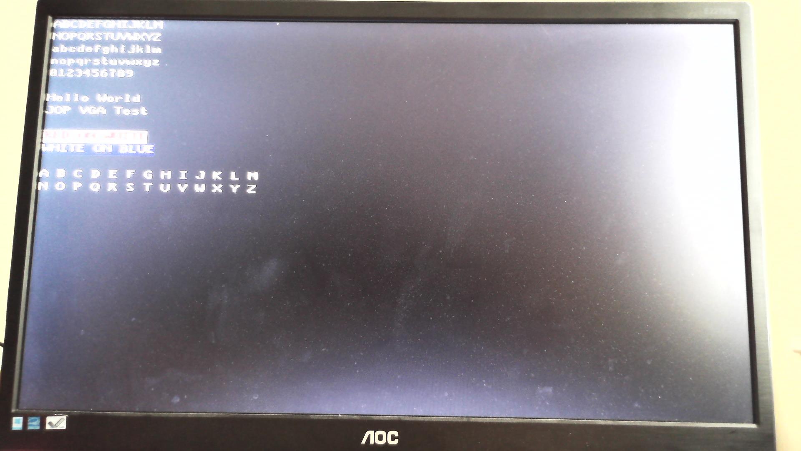
docs/peripherals/vga-text-screenshot.jpg
