peteryates1/jop-spinalhdl/docs/pico-dirtyjtag-setup.md

# FPGA Programming with pico-dirtyJtag

Program JOP FPGA bitstreams using a Raspberry Pi Pico as a USB JTAG adapter
via [pico-dirtyJtag](https://github.com/phdussud/pico-dirtyJtag) and
[openFPGALoader](https://github.com/trabucayre/openFPGALoader).

This is an alternative to the Altera USB-Blaster or Quartus Programmer.
It works with any FPGA that openFPGALoader supports, including all Altera
Cyclone and Xilinx Artix-7 boards used by this project.

## Requirements

- Raspberry Pi Pico (RP2040)
- [Pico SDK 2.2.0](https://github.com/raspberrypi/pico-sdk) at `~/pico-sdk`
- openFPGALoader: `sudo apt install openfpgaloader`
- Debug probe (CMSIS-DAP) for flashing the Pico, or USB cable for UF2 drag-and-drop

## Wiring

Connect the Pico to the FPGA's JTAG header:

| Signal | Pico GPIO | Pico Pin | FPGA |
|---|---|---|---|
| TCK | GP2 | 4 | TCK  |
| TMS | GP3 | 5 | TMS  |
| TDI | GP4 | 6 | TDI  |
| TDO | GP5 | 7 | TDO  |
| GND | — | 3 or 8 | GND  |

These are the same pins used by the pico-fpga firmware, so no rewiring
is needed when switching between firmwares.

## Building the Firmware

The pico-dirtyJtag source is at `~/pico-dirtyJtag` with these local
modifications from upstream:

1. **Custom pin assignments** in `dirtyJtagConfig.h` — TCK=GP2, TMS=GP3,
   TDI=GP4, TDO=GP5 (upstream defaults are GP16–19).
2. **Multicore disabled** in `dirtyJtag.c` — `#define MULTICORE` commented
   out. The multicore USB handling causes bulk transfer timeouts with Pico
   SDK 2.2.0.
3. **CDC↔UART bridge reliability fixes** in `cdc_uart.c` — used as the JOP
   serial console/download bridge (FPGA UART0 ↔ host `/dev/ttyACM1`):
   - `dma_handler` NULL-guard for uninitialised interfaces (master
     `488f86f`) — an uninitialised `uart_devices[1]` corrupted the TX DMA
     write address so nothing was transmitted.
   - RX→USB forwarding rewrite (master `36809d0`) — the stock
     `FULL_SWO_PACKET`/`n_checks>4` batching (from the SWO-trace use case)
     dropped the tail of small bursts, so the 4-byte JOP download checksum
     came back short and console output lost characters. Now forwards
     received bytes immediately and clamps each `tud_cdc_n_write` to the
     contiguous span before the ring-buffer wrap. Verified: reliable JOP
     downloads at full 2 Mbaud with no host-side throttling.

```bash
cd ~/pico-dirtyJtag/build
PICO_SDK_PATH=~/pico-sdk cmake ..
make -j$(nproc)
```

## Flashing the Pico

Via SWD debug probe:

```bash
sudo openocd -f interface/cmsis-dap.cfg -f target/rp2040.cfg \
  -c "adapter speed 5000; program ~/pico-dirtyJtag/build/dirtyJtag.elf verify reset exit"
```

Or via UF2: hold BOOTSEL, connect USB, copy `dirtyJtag.uf2` to the
RPI-RP2 mass storage drive.

The Pico appears as USB device `1209:c0ca` ("DirtyJTAG"). Verify with:

```bash
lsusb | grep 1209
```

## Programming FPGAs

### Detect

```bash
sudo openFPGALoader -c dirtyJtag --detect
```

Example output for the A-E115FB (EP4CE115):

```
index 0:
    idcode 0x20f70dd
    manufacturer altera
    family cyclone III/IV/10 LP
    model  EP3C120/EP4CE115/10CL120
    irlength 10
```

### Program SRAM (volatile — lost on power cycle)

```bash
# Altera Cyclone IV (.rbf)
sudo openFPGALoader -c dirtyJtag -m output_files/jop_bram.rbf

# Xilinx Artix-7 (.bit)
sudo openFPGALoader -c dirtyJtag design.bit
```

### Makefile targets

**No board offers a `program-djtag` target any more** — `grep program-djtag`
over every Makefile returns nothing. The Xilinx boards program over dirtyJtag
through `program-bit` in `fpga/vivado.mk`, which resolves the probe by serial
(`jtag_probe_map --busdev`); the Altera boards use `program-sof` and
`quartus_pgm`. Use the openFPGALoader commands above directly for a board with
no flow of its own.

The example here used to be `fpga/a-e115fb-bram`, which was retired on
2026-08-26: it had no Quartus project and generated `ep4cgx150Bram`, another
board's preset. That board builds from `fpga/a-e115fb-ddr2` now.

> **The over-voltage explanation was WRONG, and so was its first correction.**
> This said the board's own Pico "drove 3.3 V into a JTAG bank that is not
> 3.3 V". **VTREF on header pin 4 measures 3.25 V** (2026-08-31), and that was
> read as "the JTAG bank is 3.3 V nominal". It is not: VTREF is tied to 3.3 V,
> while the FPGA's JTAG pins run from bank 1, which jumper J2 sets — 2.5 V on
> this board (checked 2026-10-12;
> [board doc](boards/ep4ce115-ddr2-board.md#io-bank-voltages-jumpers-j1-j2)).
> A bare Pico is still fine: Cyclone IV JTAG inputs take up to 4.1 V AC at
> VCCIO 2.5-3.3 V, so a 3.3 V cable is within rating.
>
> The board genuinely HAS 1.8 V banks — 3 to 6 carry the DDR2 interface at
> SSTL-18 — and that 1.8 V was once attributed to the JTAG bank, which is not
> among them.
>
> So the original Pico failure on this board had some other cause. A loose
> board-side JTAG plug was found on 2026-08-31 and is the leading candidate.

Level shifting is solved by the
[pico-usb-debug-jtag](https://github.com/peteryates1/pico-usb-debug-jtag)
carrier: an SN74LVC1T45 per signal referenced to the target's own VTREF (header
pin 4).

**As of 2026-08-29 that Pico (`e6616408`) is level-shifted, ending the shared
cable.** It was on the EP4CGX150 for two days; the boards were SWAPPED on
2026-08-31, putting the **Terasic on the EP4CGX150** and the **Pico on the
A-E115FB** -- the opposite of what this paragraph said until 2026-09-09. That
Pico has since failed (item 148). **On 2026-10-12 the Terasic moved to the
A-E115FB**, which is back on hardware. The EP4CGX150 had no cable until
2026-10-15, when JTAG0 of the pico-usb-debug-jtag carrier — a level-shifted
Pico running pico-usb-blaster, serial `e66440a2` — took it over. **On
2026-10-27 the two swapped again**: the Terasic back to the EP4CGX150 and the
carrier to the A-E115FB, whose chain the Terasic was dropping mid-stream.

Note the word this paragraph used to carry: *permanently*. It was wrong within
two days, again a week later, and again on 2026-10-12. `jtag_probe_map --cable <alias>` is the
authoritative answer; prose about cables decays every time one moves. A full
`jop_sdram.sof` configures the EP4CGX150 in 43 s and the board then runs
`HelloWorld` over its UART.

The Pico cable is correct but slower, and the reason is **not** the clock --
both cables run 6 MHz and both are full-speed USB with 64-byte bulk endpoints.
Measured, splitting at Quartus's `Started/Ended Programmer operation`:

| | Terasic | Pico |
|---|---|---|
| chain detect | 1 s | 31 s |
| configuration | 6 s (3.57 MB) | 43 s (4.93 MB) |
| throughput | 595 KB/s | 115 KB/s |

The ~30 s of fixed detection cost is the largest single term and is independent
of bitstream size and Quartus version. The limit is USB **latency**: full-speed
carries ~1.2 MB/s and 6 MHz byte-shift needs 750 KB/s, so neither bandwidth nor
TCK is binding -- the Terasic keeps 9-10 bulk packets in flight per 1 ms frame,
the Pico about two. Chain detection is many tiny transactions, which is why it
suffers worst; with the board powered off (no device, no transactions) the same
scan returns in ~0 s on both cables.

That is the trade for never moving a cable between boards.

The A-E115FB has no Pico of its own at present: the shifted one failed, and the
Terasic serves it since 2026-10-12. It needs no shifter (see the note above),
so a bare Pico would do; that has **not** been tried.

**MEASURED 2026-08-31: VTREF = 3.25 V. CORRECTED 2026-10-13: VTREF is not the
JTAG bank.** This note once compared 1.8 V here with 2.5 V in `README.md`, and
the VTREF reading was taken to settle it at 3.3 V. The 1.8 V was wrong; the
2.5 V was right for the pins — bank 1, set by J2 — while VTREF is tied to
3.3 V. Two documents deferred to each other about a number neither had
measured, and then a measurement of a different node settled it.

## Tested Boards

| Board | FPGA | Status |
|---|---|---|
| A-E115FB | Altera Cyclone IV EP4CE115F23I7 | Working — SRAM programming verified |
| QMTECH EP4CGX150 | Altera Cyclone IV GX | Should work (same openFPGALoader Altera flow) |
| Trenz CYC5000 | Altera Cyclone V | Should work |
| Alchitry Au V2 | Xilinx Artix-7 XC7A35T | Should work (openFPGALoader supports Artix-7) |

## Performance

Programming 3.5 MB (EP4CE115) takes about 60 seconds at the default
6 MHz JTAG clock. This is slower than a USB-Blaster (~6 seconds) but
requires only a $4 Pico and four wires.

## Switching Firmwares

The same Pico and wiring supports two firmwares:

- **pico-dirtyJtag** — FPGA programming via openFPGALoader
- **pico-fpga** — logic analyzer, UART bridge, JTAG scripting

Switch by flashing the desired firmware:

```bash
# To dirtyJtag (FPGA programming)
sudo openocd -f interface/cmsis-dap.cfg -f target/rp2040.cfg \
  -c "adapter speed 5000; program ~/pico-dirtyJtag/build/dirtyJtag.elf verify reset exit"

# To pico-fpga (debug tool)
sudo openocd -f interface/cmsis-dap.cfg -f target/rp2040.cfg \
  -c "adapter speed 5000; program ~/pico-fpga/build/pico_fpga.elf verify reset exit"
```

## VM USB Passthrough

When running inside a VM (QEMU/KVM), the DirtyJTAG USB device must be
passed through to the guest. The VID:PID is `1209:c0ca`, which is
different from the pico-fpga device (`2e8a:000a`). Both need separate
passthrough rules if switching between firmwares.

## Troubleshooting

**"fails to open device"** — run with `sudo`, or add a udev rule:
```bash
# /etc/udev/rules.d/99-dirtyjtag.rules
SUBSYSTEM=="usb", ATTR{idVendor}=="1209", ATTR{idProduct}=="c0ca", MODE="0666"
```
Then: `sudo udevadm control --reload-rules && sudo udevadm trigger`

**"usb bulk read failed -7"** — the multicore build has this issue with
SDK 2.2.0. Ensure `#define MULTICORE` is commented out in `dirtyJtag.c`
and rebuild.

**Device not detected after flash** — in a VM, you need to add the
`1209:c0ca` USB device to the guest after flashing. The old `2e8a:000a`
passthrough rule won't match the new firmware.
