peteryates1/jop-spinalhdl/docs/programmers-guide.md

# I/O Programmer's Guide

This document describes the Java API for JOP's I/O devices. Each device has a
**hardware object** (`com.jopdesign.hw.*`) that maps volatile fields directly
to I/O registers — field reads and writes become I/O reads and writes with no
overhead. Hardware objects are the recommended way to access I/O.

## Hardware Object Pattern

Each device is a singleton obtained via `getInstance()`. Fields are `volatile`
and map sequentially to I/O registers starting at the device's base address.
Reading a field reads the corresponding hardware register; writing a field
writes it.

```java
import com.jopdesign.hw.VgaText;

VgaText vga = VgaText.getInstance();
vga.statusControl = 1;                    // enable VGA (write to register +0)
int status = vga.statusControl;           // read status (read from register +0)
```

All hardware object classes are in `java/runtime/src/jop/com/jopdesign/hw/`.

## Available Devices

| Class | Device | Java Constant | Preset device |
|---|---|---|---|
| `SysDevice` | System registers | `IO_BASE + 0x00` | always |
| `SerialPort` | UART serial port | `IO_UART` | `DeviceType.Uart` |
| `EthMac` | Ethernet MAC | `IO_ETH` | `DeviceType.Ethernet` |
| `Mdio` | MDIO PHY management | `IO_MDIO` | `DeviceType.Ethernet` |
| `SdSpi` | SD card (SPI mode) | `IO_SD_SPI` | `DeviceType.SdSpi` |
| `SdNative` | SD card (native 4-bit) | `IO_SD` | `DeviceType.SdNative` |
| `VgaText` | VGA text controller | `IO_VGA` | `DeviceType.VgaText` |
| `VgaDma` | VGA DMA framebuffer | `IO_VGA_DMA` | `DeviceType.VgaDma` |

A device is present when the preset lists it in its `devices` map, e.g.
`"eth" -> DeviceInstance(DeviceType.Ethernet, ...)` in `JopConfig.scala`. The
generated `Const.java` gives every device an address, and the optional ones a
presence flag (`HAS_ETHERNET`, `HAS_SD_CARD`, `HAS_VGA`, `HAS_CONFIG_FLASH`). An
absent device's address resolves to `IO_BASE + 0`, which decodes to nothing and
reads 0, so check the flag before driving one (status
[item 121](current-status.md#item-121)). SD SPI and SD Native are mutually
exclusive. VGA Text and VGA DMA are mutually exclusive (same output pins).

---

## SysDevice -- System Registers

```java
SysDevice sys = SysDevice.getInstance();
```

| Field | Register | Read | Write |
|---|:---:|---|---|
| `cntInt` | +0 | Clock cycle counter | Interrupt enable |
| `uscntTimer` | +1 | Microsecond counter | Timer compare |
| `intNr` | +2 | Interrupt source | SW interrupt trigger |
| `wd` | +3 | -- | Watchdog |
| `exception` | +4 | Exception type | Exception trigger |
| `lock_acquire` | +5 | Lock status (halted) | Lock acquire |
| `cpuId` | +6 | CPU ID | Lock release |
| `signal` | +7 | Boot signal | Boot signal set |
| `intMask` | +8 | -- | Interrupt mask |
| `clearInt` | +9 | -- | Clear all interrupts |
| `deadLine` | +10 | -- | Deadline |
| `nrCpu` | +11 | CPU count | -- |
| `perfCounter` | +12 | -- | Performance counter reset |

### Timing

```java
SysDevice sys = SysDevice.getInstance();
int start = sys.cntInt;
// ... work ...
int cycles = sys.cntInt - start;
```

### Watchdog

Toggle bit 0 periodically to prove liveness (bit 0 drives an LED):

```java
sys.wd = sys.wd ^ 1;
```

---

## SerialPort -- UART

```java
SerialPort uart = SerialPort.instance0;
```

| Field | Register | Read | Write |
|---|:---:|---|---|
| `status` | +0 | Status (TDRE, RDRF) | -- |
| `data` | +1 | RX byte (consumes from FIFO) | TX byte (pushes to FIFO) |

**Status bits**: `MASK_TDRE = 1` (TX has space), `MASK_RDRF = 2` (RX has data).

UART config: 8N1, 1 Mbaud, 16-entry TX and RX FIFOs.

### Send / Receive

```java
// Blocking send
while (!uart.txEmpty()) { }
uart.write('A');

// Blocking receive
while (!uart.rxFull()) { }
int ch = uart.read();

// Non-blocking receive
if (uart.rxFull()) {
    int ch = uart.read();
}
```

### Multi-Core Note

Only core 0 has a UART. Other cores' reads return 0.

---

## EthMac -- Ethernet MAC

```java
EthMac eth = EthMac.getInstance();
```

| Field | Register | Read | Write |
|---|:---:|---|---|
| `statusControl` | +0 | Status | Control (flush) |
| `txAvailability` | +1 | TX free words | -- |
| `txData` | +2 | -- | TX data push |
| `rxData` | +3 | RX data pop | -- |
| `rxStats` | +4 | Errors/drops (auto-clear) | -- |

Registers +5 to +7 exist only in a build with the MAC's receive capture
(`rxCapture`, a diagnostic; see `Mac.scala`).

The register interface is the same whatever the PHY link: GMII at 1 Gb/s, MII at
100 Mb/s, or RGMII at 100 Mb/s; the preset decides. Which board runs which, and
how to test it: [networking.md](peripherals/networking.md); the DB_FPGA's PHY:
[db-fpga-ethernet.md](peripherals/db-fpga-ethernet.md).

### Status Bits

| Constant | Bit | Meaning |
|---|---|---|
| `STATUS_TX_FLUSH` | 0 | TX flush active |
| `STATUS_TX_READY` | 1 | TX ready |
| `STATUS_RX_FLUSH` | 4 | RX flush active |
| `STATUS_RX_VALID` | 5 | RX frame available |

### Transmit

Write frame length in bits first, then data words (little-endian byte order):

```java
int frameBytes = 42;
eth.txData = frameBytes * 8;                       // length in bits
eth.txData = EthMac.le(0xFF, 0xFF, 0xFF, 0xFF);   // dst MAC [0:3]
eth.txData = EthMac.le(0xFF, 0xFF, 0x02, 0x00);   // dst [4:5] + src [0:1]
// ... remaining words ...
```

### Receive

```java
if (eth.rxValid()) {
    int bitLen = eth.rxData;                // first pop = frame length in bits
    int words = (bitLen + 31) / 32;
    for (int i = 0; i < words; i++) {
        int word = eth.rxData;              // data words (auto-pop)
    }
}
```

### Stats and Flush

```java
int stats = eth.rxStats;                    // auto-clears on read
int errors = EthMac.errors(stats);
int drops = EthMac.drops(stats);

eth.flush();                                // flush TX + RX
// ... wait ...
eth.unflush();
```

---

## Mdio -- MDIO PHY Management

```java
Mdio mdio = Mdio.getInstance();
```

| Field | Register | Read | Write |
|---|:---:|---|---|
| `command` | +0 | bit0=busy | go/write |
| `data` | +1 | Read data [15:0] | Write data [15:0] |
| `address` | +2 | -- | regAddr[4:0], phyAddr[9:5] |
| `phyReset` | +3 | -- | PHY reset (bit0) |
| `intControl` | +4 | Interrupt pending | Interrupt enable mask |

### Read / Write PHY Register

```java
int phyId = mdio.read(0, 2);     // read PHY 0, register 2 (ID1)

mdio.write(0, 0, 0x1200);        // write PHY 0, register 0 (restart auto-neg)
```

These methods handle addressing, go/busy polling, and return the result.

### PHY Reset

```java
mdio.assertReset();
// delay ~10ms
mdio.releaseReset();
// delay ~150ms for PHY to initialize
```

### Interrupt Control

| Constant | Bit | Source |
|---|---|---|
| `INT_ETH_RX` | 0 | Ethernet RX frame available |
| `INT_ETH_TX` | 1 | Ethernet TX complete |
| `INT_MDIO` | 2 | MDIO operation complete |

---

## SdSpi -- SD Card (SPI Mode)

```java
SdSpi sd = SdSpi.getInstance();
```

| Field | Register | Read | Write |
|---|:---:|---|---|
| `statusControl` | +0 | Status | Control (CS, intEnable) |
| `txRxData` | +1 | RX byte [7:0] | TX byte (starts transfer) |
| `clockDivider` | +2 | Clock divider [15:0] | Set divider |

SPI Mode 0 (CPOL=0, CPHA=0). `SPI_CLK = sys_clk / (2 * (divider + 1))`.
Default divider=199 gives ~200 kHz at 80 MHz.

**Note**: SD SPI and SD Native are mutually exclusive (share pins).

### Status Bits

| Constant | Bit | Meaning |
|---|---|---|
| `STATUS_BUSY` | 0 | SPI transfer in progress |
| `STATUS_CARD_PRESENT` | 1 | SD card detected |
| `STATUS_INT_ENABLE` | 2 | Interrupt enabled |

### SPI Transfer

```java
sd.csAssert();                       // CS low
int rx = sd.transfer(0x40 | 0);      // send CMD0, receive response
sd.csDeassert();                     // CS high

sd.send(0xFF);                       // send byte, ignore response
int b = sd.receive();                // send 0xFF, return response
```

### Clock Speed

```java
sd.setClockDivider(1);  // ~20 MHz at 80 MHz sys clock
```

### Card Detection

```java
if (sd.isCardPresent()) { ... }
```

---

## SdNative -- SD Card (Native 4-bit Mode)

```java
SdNative sd = SdNative.getInstance();
```

| Field | Register | Read | Write |
|---|:---:|---|---|
| `statusControl` | +0 | Status | Control (sendCmd/abort/openDrain) |
| `cmdArgResponse0` | +1 | CMD response [31:0] | CMD argument |
| `cmdIndexResponse1` | +2 | CMD response [63:32] | CMD index/flags |
| `response2` | +3 | CMD response [95:64] | -- |
| `response3` | +4 | CMD response [127:96] | -- |
| `dataFifo` | +5 | FIFO pop | FIFO push |
| `occupancyClkDiv` | +6 | RX FIFO occupancy | Clock divider [9:0] |
| `crcDataCtrl` | +7 | CRC error flags | Data xfer control |
| `cardBusWidth` | +8 | cardPresent, busWidth4 | Set busWidth4 |
| `blockLength` | +9 | -- | Block length in bytes |

Hardware handles CRC7 (CMD) and CRC16 (DATA). 512-byte block FIFO.

### Status Bits

| Constant | Bit | Meaning |
|---|---|---|
| `STATUS_CMD_BUSY` | 0 | CMD in progress |
| `STATUS_CMD_RESP_VALID` | 1 | Response received |
| `STATUS_CMD_RESP_ERR` | 2 | Response CRC error |
| `STATUS_CMD_TIMEOUT` | 3 | CMD timeout |
| `STATUS_DATA_BUSY` | 4 | Data transfer in progress |
| `STATUS_DATA_CRC_ERR` | 5 | Data CRC error |
| `STATUS_DATA_TIMEOUT` | 6 | Data timeout |
| `STATUS_DATA_DONE` | 7 | Data transfer complete |
| `STATUS_CARD_PRESENT` | 8 | Card detected |
| `STATUS_FIFO_FULL` | 9 | FIFO full |
| `STATUS_FIFO_EMPTY` | 10 | FIFO empty |
| `STATUS_FIFO_HAS_DATA` | 11 | FIFO has data |

### Send Command

```java
// CMD0 (GO_IDLE): no argument, no response
sd.sendCmd(0, 0, false, false);
sd.waitCmd();

// CMD17 (READ_SINGLE_BLOCK): arg=block address, short response
sd.sendCmd(17, blockAddr, true, false);
int st = sd.waitCmd();
int resp = sd.cmdArgResponse0;  // R1 response
```

### Data Read

```java
sd.setBlockLength(512);
sd.sendCmd(17, blockAddr, true, false);
sd.waitCmd();
sd.startRead();
sd.waitData();
for (int i = 0; i < 128; i++) {   // 512 bytes = 128 words
    int word = sd.dataFifo;
}
```

### Data Write

```java
sd.setBlockLength(512);
// Fill FIFO before sending CMD24
for (int i = 0; i < 128; i++) {
    sd.dataFifo = data[i];
}
sd.sendCmd(24, blockAddr, true, false);
sd.waitCmd();
sd.startWrite();
int st = sd.waitData();
if ((st & SdNative.STATUS_DATA_CRC_ERR) != 0) {
    // card rejected the write (CRC error)
}
```

`startRead()` and `startWrite()` both clear `dataCrcError`, `dataTimeout`,
and `dataCrcFlags`. The FIFO is only reset on `startRead()` or abort, so
write data must be pushed to the FIFO before calling `startWrite()`.

### Configuration

```java
sd.setClockDivider(3);      // 10 MHz at 80 MHz sys clock
sd.setBusWidth4(true);       // enable 4-bit data bus
```

Clock formula: `SD_CLK = sys_clk / (2 * (div + 1))`. Common divider
values at 80 MHz: 0 = 40 MHz, 1 = 20 MHz, 3 = 10 MHz, 99 = 400 kHz
(init speed). Default divider is 99 (~400 kHz for SD card initialization).

### Hardware Notes

- **Control register caveat**: Writing the control register (addr +0)
  always updates `openDrain` from bit 2. Use `CTRL_OPEN_DRAIN` during
  card init (CMD0 through CMD2), clear it after CMD3.
- **Response register persistence**: The CMD response register is NOT
  cleared on `sendCmd`. If a command times out, the response register
  retains the stale value from the previous successful command.
- **Clock speed constraints**: On the QMTECH EP4CGX150 + DB_FPGA board,
  CMD24 (WRITE_BLOCK) times out at 20 MHz (divider=1) and 13.3 MHz
  (divider=2) due to signal integrity on the SD card traces. CMD17
  (READ_SINGLE_BLOCK) works at 20 MHz. Use divider=3 (10 MHz) or
  slower for reliable operation. Other boards may differ.

---

## VgaText -- VGA Text Controller

```java
VgaText vga = VgaText.getInstance();
```

| Field | Register | Read | Write |
|---|:---:|---|---|
| `statusControl` | +0 | Status | Control (enable) |
| `cursorPos` | +1 | Cursor position | Set cursor |
| `charAttr` | +2 | -- | Write char+attr (auto-advance) |
| `defaultAttr` | +3 | Default attribute | Set default attr |
| `paletteWrite` | +4 | -- | Palette write |
| `columns` | +5 | Columns (80) | -- |
| `rows` | +6 | Rows (30) | -- |
| `directWrite` | +7 | -- | Direct write (no cursor change) |
| `clearScreen` | +8 | -- | Clear screen |
| `scrollUp` | +9 | -- | Scroll up 1 row |

80x30 characters, 8x16 font, 640x480@60Hz, RGB565 output.
See [db-fpga-vga-text.md](peripherals/db-fpga-vga-text.md) for hardware setup.

### Status Bits

| Constant | Bit | Meaning |
|---|---|---|
| `STATUS_ENABLED` | 0 | Output active |
| `STATUS_VBLANK` | 1 | Vertical blanking |
| `STATUS_BUSY` | 2 | Scroll/clear in progress |

### Quick Start

```java
VgaText vga = VgaText.getInstance();
vga.enable();
vga.clear(VgaText.attr(VgaText.WHITE, VgaText.BLACK));
vga.setCursor(0, 0);
vga.writeString("Hello VGA!", VgaText.attr(VgaText.YELLOW, VgaText.BLUE));
```

### Text Output

```java
vga.setCursor(10, 5);                                       // column 10, row 5
vga.writeChar('A', VgaText.attr(VgaText.WHITE, VgaText.BLACK));  // at cursor, advances
vga.writeString("Hello", 0x0F);                              // string at cursor
vga.writeAt('X', 0x1E, 79, 0);                              // direct: col 79, row 0
```

### Screen Operations

```java
vga.setDefaultAttr(VgaText.attr(VgaText.WHITE, VgaText.BLUE));
vga.clear();               // clears with default attr, waits for completion
vga.clear(0x0F);           // clears with specific attr
vga.scroll();              // scroll up, clears bottom row
```

### Color Constants

```java
VgaText.BLACK, VgaText.BLUE, VgaText.GREEN, VgaText.CYAN,
VgaText.RED, VgaText.MAGENTA, VgaText.BROWN, VgaText.LIGHT_GRAY,
VgaText.DARK_GRAY, VgaText.LIGHT_BLUE, VgaText.LIGHT_GREEN, VgaText.LIGHT_CYAN,
VgaText.LIGHT_RED, VgaText.LIGHT_MAGENTA, VgaText.YELLOW, VgaText.WHITE
```

Build attribute: `VgaText.attr(fg, bg)` returns `(bg << 4) | fg`.

See `java/apps/Small/src/test/VgaTest.java` for a complete hardware test.

---

## VgaDma -- VGA DMA Framebuffer Controller

```java
VgaDma vga = VgaDma.getInstance();
```

| Field | Register | Read | Write |
|---|:---:|---|---|
| `statusControl` | +0 | Status (enabled/vsync/underrun) | Control (enable/clearVsync) |
| `baseAddr` | +1 | Framebuffer base address | Set base address (byte addr) |
| `fbSize` | +2 | Framebuffer size in bytes | Set size |

Reads an RGB565 framebuffer from SDRAM via DMA and outputs 640x480@60Hz VGA.
Two RGB565 pixels per 32-bit word: low 16 bits = first pixel, high 16 bits =
second pixel. Default framebuffer size: 640x480x2 = 614,400 bytes.

**Mutually exclusive** with VGA Text (same output pins). Present in the
`ep4cgx150DbVgaDma` preset, which swaps `ep4cgx150DbFull`'s VGA text device for
`DeviceType.VgaDma`. Build with `make -C fpga/qmtech-ep4cgx150-sdram dbfpga-vgadma`.
That preset misses timing by 1.011 ns (status [item 73](current-status.md#item-73)).

### Status Bits (read)

| Constant | Bit | Meaning |
|---|---|---|
| `STATUS_ENABLED` | 0 | DMA output active |
| `STATUS_VSYNC_PENDING` | 1 | Vsync event occurred (cleared by write) |
| `STATUS_UNDERRUN` | 2 | FIFO underrun (pixels lost) |

### Control Bits (write)

| Constant | Bit | Meaning |
|---|---|---|
| `CTRL_ENABLE` | 0 | Enable DMA display |
| `CTRL_CLEAR_VSYNC` | 1 | Clear vsync pending flag |

### Quick Start

```java
VgaDma vga = VgaDma.getInstance();

// Allocate framebuffer in SDRAM (word address → byte address)
int[] fb = new int[153600];   // 640*480/2 words
int ref = Native.toInt(fb);
int dataWordAddr = Native.rdMem(ref);
int byteAddr = dataWordAddr << 2;

vga.setFramebuffer(byteAddr, 640 * 480 * 2);
vga.enable();
```

### Framebuffer Format

RGB565: `R[15:11] G[10:5] B[4:0]`. Each 32-bit word contains two pixels:

```
Word:  [pixel1(31:16)][pixel0(15:0)]
        ─────────────  ─────────────
        second pixel    first pixel
```

Common RGB565 colors:

| Color | Value |
|---|---|
| Red | `0xF800` |
| Green | `0x07E0` |
| Blue | `0x001F` |
| White | `0xFFFF` |
| Black | `0x0000` |
| Cyan | `0x07FF` |
| Magenta | `0xF81F` |
| Yellow | `0xFFE0` |

### Writing Pixels

Pack two RGB565 pixels into a word and write to the framebuffer array:

```java
// Pack two pixels: pixel0 in low half, pixel1 in high half
int word = (pixel0 & 0xFFFF) | ((pixel1 & 0xFFFF) << 16);
fb[y * 320 + x/2] = word;    // 320 words per line (640 pixels / 2)
```

For direct SDRAM writes (bypassing Java arrays), use `Native.wrMem()`:

```java
int fbWordAddr = fbByteAddr >> 2;
Native.wrMem(word, fbWordAddr + y * 320 + x/2);
```

### Vsync Synchronization

The controller generates a vsync interrupt at the start of each vertical
blanking period (~60 Hz). Use this to synchronize framebuffer updates:

```java
vga.clearVsync();
while (!vga.isVsyncPending()) { }  // wait for next vsync
// Safe to update framebuffer here
```

### Underrun Detection

A FIFO underrun means the DMA couldn't keep up with pixel output, causing
black pixels. Check after enabling:

```java
if (vga.isUnderrun()) {
    // DMA bandwidth insufficient — reduce SDRAM contention
}
```

### DMA Timing

The DMA engine reads one full frame per refresh cycle. It restarts at the end
of vsync (start of back porch), giving 33 lines (~26,400 pixel clocks) to
pre-fill the CDC FIFO before active display begins. The FIFO is drained during
vertical blanking to prevent stale data at frame boundaries.

See `java/apps/Small/src/test/VgaDmaTest.java` for a complete hardware test.

---

## Fat32FileSystem -- FAT32 Filesystem

`Fat32FileSystem` is a pure-Java FAT32 filesystem layer — not a hardware
object. It runs on top of the `SdNative` or `SdSpi` block device interface.
Source: `java/fat32/src/com/jopdesign/fat32/`.

### Key Classes

| Class | Description |
|---|---|
| `BlockDevice` | Interface: `init()`, `readBlock(sector, buf)`, `writeBlock(sector, buf)` |
| `SdNativeBlockDevice` | `BlockDevice` using SD Native mode (4-bit bus) |
| `SdSpiBlockDevice` | `BlockDevice` using SD SPI mode (1-bit bus) |
| `Sector` | `int[128]` sector buffer with byte/LE16/LE32 accessors and dirty tracking |
| `Fat32FileSystem` | Mount, FAT access, directory listing, file create/delete/open |
| `Fat32InputStream` | `InputStream` for reading files (follows FAT chain) |
| `Fat32OutputStream` | `OutputStream` for writing files (extends chain, updates dir on close) |
| `DirEntry` | Directory entry: short name, long name (LFN), attributes, cluster, size |

### Quick Start

```java
import com.jopdesign.fat32.*;

// Init block device and mount
SdNativeBlockDevice sd = new SdNativeBlockDevice();
sd.init();
Fat32FileSystem fs = new Fat32FileSystem(sd);
fs.mount(0);  // partition 0

// List root directory
DirEntry[] entries = fs.listDir(fs.getRootCluster());
for (int i = 0; i < entries.length; i++) {
    JVMHelp.wr(entries[i].getName());
    JVMHelp.wr('\n');
}

// Create and write a file (LFN names supported)
DirEntry file = fs.createFile(fs.getRootCluster(), "Hello from JOP.txt");
Fat32OutputStream out = fs.openFileForWrite(file);
String msg = "Hello, World!\r\n";
for (int i = 0; i < msg.length(); i++) out.write(msg.charAt(i));
out.close();  // mandatory

// Read a file
DirEntry found = fs.findFile(fs.getRootCluster(), "Hello from JOP.txt");
Fat32InputStream in = fs.openFile(found);
int ch;
while ((ch = in.read()) != -1) JVMHelp.wr((char) ch);
in.close();

// Delete a file
fs.deleteFile(found);
```

### Build

The FAT32 module lives outside the standard JOP source tree. Add it with
`EXTRA_SRC`:

```bash
cd java/apps/Small
make clean && make all APP_NAME=Fat32Test EXTRA_SRC=../../fat32/src
```

For full documentation see [FAT32 Filesystem](peripherals/fat32-filesystem.md).

---

## Low-Level I/O Access

All I/O can also be accessed directly via `Native.rd(addr)` and
`Native.wr(value, addr)` using constants from `Const.java`. This is useful
for hardware debugging or when a hardware object is not available.

### I/O Address Map

Base address: `Const.IO_BASE` (`0xFFFFFF80`). The low 7 bits form an 8-bit
`ioAddr` used for device routing by the memory controller.

| ioAddr Range | Size | Java Base | Device |
|---|---|---|---|
| `0x80`--`0x8F` | 16 regs | `IO_BASE + 0x00` | Sys |
| `0x90`--`0x93` | 4 regs | `IO_BASE + 0x10` | Uart |
| `0x98`--`0x9F` | 8 regs | `IO_BASE + 0x18` | Eth |
| `0xA0`--`0xA7` | 8 regs | `IO_BASE + 0x20` | Mdio |
| `0xA8`--`0xAB` | 4 regs | `IO_BASE + 0x28` | SdSpi |
| `0xB0`--`0xBF` | 16 regs | `IO_BASE + 0x30` | SdNative |
| `0xAC`--`0xAF` | 4 regs | `IO_BASE + 0x2C` | VgaBmbDma |
| `0xC0`--`0xCF` | 16 regs | `IO_BASE + 0x40` | VgaText |
| `0xD0`--`0xD3` | 4 regs | `IO_BASE + 0x50` | ConfigFlash |
| `0xF0`--`0xF3` | 4 regs | `IO_BASE + 0x70` | ~~BmbFpu~~ (removed -- replaced by FloatComputeUnit) |

### Low-Level Example

```java
// Direct register access (equivalent to VgaText methods)
Native.wr(1, Const.IO_VGA + 0);                          // enable
Native.wr(0x0F, Const.IO_VGA + 3);                       // default attr
Native.wr(0, Const.IO_VGA + 8);                          // clear
while ((Native.rd(Const.IO_VGA + 0) & 4) != 0) { }      // wait busy

Native.wr((0 & 0x7F) | ((0 & 0x1F) << 8), Const.IO_VGA + 1);  // cursor (0,0)
Native.wr(('H' & 0xFF) | ((0x0F & 0xFF) << 8), Const.IO_VGA + 2);  // write 'H'
```

### I/O Routing

The memory controller detects I/O addresses by bits [31:30] = `11`. I/O reads
and writes are single-cycle (no wait states). The 8-bit `ioAddr` is decoded
by `JopIoSpace` predicates in `JopMemoryConfig.scala`.

Source files: `JopMemoryConfig.scala` (`JopIoSpace`), `JopCore.scala`.

## See Also

- [DB_FPGA Ethernet](peripherals/db-fpga-ethernet.md) -- GMII architecture, pin mapping, PHY config
- [DB_FPGA SD Card](peripherals/db-fpga-sd-card.md) -- SD Native and SPI mode, pin mapping, clock constraints
- [DB_FPGA VGA Text](peripherals/db-fpga-vga-text.md) -- VGA text setup guide and troubleshooting
- [DB_FPGA VGA DMA](peripherals/db-fpga-vga-dma.md) -- VGA DMA framebuffer setup guide
- [System Configuration](architecture/system-configuration.md) -- presets, device maps, board configs
- [Implementation Notes](architecture/implementation-notes.md) -- Architecture details
