peteryates1/jop-spinalhdl/fpga/bringup/README.md

# Bring-up jigs

Small designs used to prove a board, a cable or a connector is alive. **They are
deliberately independent of the JOP config and build system, and must stay that
way.**

## Why they are not converted

A jig that shares machinery with the thing under test is compromised as a
diagnostic. If `JopTop` will not elaborate, or the constraint generators emit
the wrong pins, or a preset is missing — you still need a way to prove the board
and the cable work. That answer must not depend on any of the machinery in
question.

`WukongUartLoopback.v` already said as much in its own header: *"a test fixture,
not part of any design, and three assigns do not warrant a generator entry."*

So the risk is not that these are hand-written. It is that they LOOK like
ordinary flows, and someone converts them on a tidy-up — which removes their
value silently, because a converted jig still passes right up until the moment
you need it to be independent.

Hence: one directory per jig, all under here, each self-contained.

## What is here

| jig | board | what it proves |
|-----|---|---|
| `a-e115fb-uart-loopback` | A-E115FB (EP4CE115) | UART wiring: RX looped back to TX |
| `wukong-uart-loopback` | QMTECH Wukong (XC7A100T) | the same, three assigns of Verilog |
| `ep4cgx150-eth-ref` | EP4CGX150 + DB_FPGA V4 | a THIRD-PARTY Ethernet reference design on the RTL8211EG PHY |
| `colorlight-db-i9plus` | fpga-db-colorlight-i5 base board + i9+ (XC7A50T) | LEDs, buttons, both RP2040-STAMP CDC UARTs (one jig console, one wired loopback), and a 4-pass test of the 128K×8 SRAM |
| `colorlight-db-i9plus-eth` | the same base board + i9+ | RJ1, its magnetics and the module's B50612D PHYs: an MDIO probe (stage 1), then RGMII receive and transmit at 100 Mb/s (stage 2, `EthRgmiiTest.v`) |
| `colorlight-i9plus-idle` | an i9+ module, on any carrier | not a test: the module's power-up flash image, which drives nothing off the module, so whatever carrier it lands on is safe |
| `colorlight-i5-idle` | a Colorlight i5 module, on either carrier | not a test: the same idea for the i5 (only LED D2 is driven; its ball also reaches SODIMM 41, which has no net on the base board); USERCODE `0x1D1E0005`, checked over JTAG by `make check` |
| `colorlight-db-i5-eth` | the fpga-db-colorlight-i5 base board + i5 (ECP5) | RJ1, its magnetics and the module's B50612D PHYs: the i9+ MDIO probe (stage 1) and RGMII test (stage 2, ported to the ECP5's PLL and ODDRX1F) on the i5's own PHY pins. RJ1 = U28 at MDIO 1; 1000BASE-T FD link, and RGMII frames both ways at 100 Mb/s (2026-10-27) |

`ep4cgx150-eth-ref` is worth knowing about for a second reason. It is an
independent implementation against the same PHY as our own MAC, so when the JOP
Ethernet links but passes no packets, as it did until status item 68 was fixed,
it separates "the board, PHY and cable are fine" from "our MAC is at fault" —
which nothing else here can do.

## Rules

- No dependency on `jop.config`, `build/<config>/`, or the generators.
- Hand-written constraints are correct here. Do not replace them with generated
  ones.
- If a jig stops building, fix it or retire it — do not convert it.
