peteryates1/jop-spinalhdl/fpga/bringup/colorlight-i9plus-idle/README.md

# Colorlight i9+ idle image (module flash)

The power-up image for an i9+ module's SPI flash (MX25L12833F, 16 MB). It
drives nothing outside the module: the module's 25 MHz clock (K4) in, and the
module LED D2 (A18) blinking at about 0.75 Hz out. Every other ball is unused,
so high-Z with no pull.

Why: the flash image travels with the MODULE. The factory image drives pins on
the fpga-db-colorlight-i5 base board (seen on the console pin), and once that
board's HDMI caps became 0 Ω links, a driven HDMI ball would go DC into the
monitor's terminations. The bring-up jig (`../colorlight-db-i9plus`) drives
the base board's LEDs, SRAM and UARTs, and those would land on whatever another
carrier wires to the same balls. This image is safe on any carrier.

The bitstream is compressed and configures at 33 MHz x1, so it boots in well
under a second. x4 would need the flash's QE bit.

    vivado -mode batch -source build.tcl
    ./flash_idle.sh "$(../../scripts/jop_setup.py unit jop-i9plus-1 probe)"
                         # all of the steps below, each checked; prints IDLE IMAGE FLASHED AND BOOTED

By hand:

    B=$(../../scripts/jtag_probe_map --busdev colorlight-db)
    # 1. the factory leaves the WHOLE flash block-protected (status 0x3c, BP=0xF):
    #    clear it on its own first -- see the trap below
    sudo openFPGALoader -c dirtyJtag --busdev-num $B --fpga-part xc7a50tfgg484 --unprotect-flash
    # 2. write (persistent) WITH --verify; back the old contents up first
    sudo openFPGALoader -c dirtyJtag --busdev-num $B --fpga-part xc7a50tfgg484 --verify -f build/I9PlusIdle.bit
    # 3. reload from flash without a power cycle, then check DONE/CRC
    sudo openFPGALoader -c dirtyJtag --busdev-num $B -r
    sudo openFPGALoader -c dirtyJtag --busdev-num $B --fpga-part xc7a50tfgg484 --read-register STAT

**Trap: `-f --unprotect-flash` together can write NOTHING and exit 0.** openFPGALoader
v1.1.1's database entry for the MX25L12833 says `bp_len = 5` but lists four BP bit offsets,
so the protected range it computes is garbage (`00000000-3fffffff` on one run,
`c1000000-00ffffff` on the next). On the second it decided address 0 was unprotected,
skipped the unlock, and "erased" and "wrote" a chip that ignored all of it: exit 0, 100 %,
and the flash read back byte-identical to the factory image. `--verify` catches it. The
standalone `--unprotect-flash` (no file) doesn't use that range, so it works.

JTAG loading over it is volatile: a power cycle returns to this image. **But
this image boots fast enough to break openFPGALoader v1.1.1's JTAG loads on
dirtyJtag.** After JPROGRAM, the FPGA starts loading this image as soon as
INIT_B rises, and it is DONE about 55-60 ms later. openFPGALoader waits 240 ms
before CFG_IN (120,000 TCK, which dirtyJtag clocks at about 0.5 MHz). Its
bitstream therefore lands on a running FPGA. The load reports DONE=1, but the
design's registers do not start from INIT, and JOP fails. The installed loader
has been patched since 2026-10-11: it waits 16 TCK and refuses the load if DONE
is already set. The measurements are in `../colorlight-db-i9plus-eth/README.md`.
An image that boots more slowly than any loader's wait, for example uncompressed
at the default 3 MHz rate, would avoid this on a host with a stock loader.

Written 2026-10-10 to the module on the base board: `--verify` passed, an independent
read-back matched the bitstream from the sync word with the rest of the 256 KB erased,
and after `-r` the STAT register read DONE=1, no CRC error. The flash was left
UNPROTECTED (BP=0). Its factory contents are backed up (two identical 16 MB reads,
md5 29015ce7...) in `~/workspaces/colorlight-db-backup/i9plus-module-factory-flash.bin`;
to restore, unprotect and write that file back raw at offset 0.

**V6.0 modules take it too.** The modules above are v6.1. Two v6.0 modules, DNA
0x00409c286b5a2854 and 0x005c85046b5a2854, were written on 2026-11-10 with `flash_idle.sh`,
which passed on both. They have the same FPGA (IDCODE 0362C093) and the same flash
(MX25L12833, factory status 0x3c, BP=0xF). Their factory flash holds the same two bitstreams
as the v6.1 backup, byte for byte (at 0x30 and 0x240030). Only the LED receiver's settings
differ (25 KB in 0xA80000-0xAA005B), and the two v6.0s differ from each other in just 3 bytes
there (0xA8F003-0xA8F007). Colorlight ships one FPGA design for both versions. D2 blinks on
both v6.0s, so K4 and A18 are the same on v6.0. The first still blinked after a cold power
cycle, and STAT then read DONE=1 with no CRC error. The base board's eight LEDs, which the
factory image left partly lit, are dark. Both factory images are backed up (two identical
16 MB reads each, md5 8c2b9b10... and c0c818b6...) in `~/workspaces/colorlight-db-backup/`,
as `i9plus-v6.0-dna<DNA>-factory-flash.bin`.
