peteryates1/jop-spinalhdl/fpga/bringup/a-e115fb-uart-loopback/README.md

# a-e115fb-uart-loopback — bring-up jig

Deliberately independent of the JOP build system. See ../README.md for why.
