peteryates1/jop-spinalhdl/docs/boards/colorlight-i5-bringup.md

# Colorlight i5 v7.0 — bring-up

**Status: Stage 2 (SDRAM) working on hardware.** 8 MB of SDRAM, `HelloWorld.jop`
and the 283 KB `DoAll.jop` JVM suite both download over the DAPLink and run.

This is the project's first board on a fully open-source toolchain — every other
target goes through Quartus or Vivado. Nothing is shared with those flows.

"Stage 1" and "Stage 2" throughout this document mean **this board's bring-up
steps** — BRAM first, then SDRAM. They have nothing to do with the GC stages
(card marking, generational, pause work) numbered elsewhere in the project.

## Hardware

| | |
|---|---|
| Module | Colorlight i5 v7.0 |
| FPGA | LFE5U-25F-6BG381C (ECP5, CABGA381, speed grade 6) |
| Carrier | i5 ext board (the "breakout" board) |
| SDRAM | EM638325BK-6H, 8 MB, **32-bit wide** |
| Flash | GD25Q16, 2 MB — ships **write-locked** |
| Debug | ARM mbed DAPLink (`0d28:0204`), JTAG + CDC serial on one USB cable |
| Baud | 1 Mbaud (verified) — 46 KB download in 0.7 s at 63 KB/s |
| JVM suite | DoAll 66/66 on hardware |

Only the USB cable is connected. JTAG programming and the JOP serial download
both go through the DAPLink, so no second cable or external adapter is needed.

## Pins

| Signal | Pin | Source |
|---|---|---|
| `clk_in` (25 MHz) | P3 | Colorlight-FPGA-Projects README, "Clock" |
| `ser_txd` | J17 | `src/i5/uart_tx/top.lpf`, `src/i5/picosoc/top.lpf` |
| `ser_rxd` | H18 | as above |
| `led[0]` (D2) | U16 | README "LED"; also SODIMM pin 41 |

### Do not use U16/R16 for the UART

`riscvOnColorlight-5A-75B/README.md` lists `Uart TX U16 / Uart RX R16`. That is the
**5A-75B**, a different module. On the i5, U16 is the LED and R16 is not bonded out
to the SODIMM connector at all. The pins above come from Colorlight's own i5
examples, which agree with each other and are confirmed working on hardware.

## Clock

25 MHz oscillator → `EHXPLLL` → **40 MHz** system clock.

The PLL wrapper is **generated from the preset**, not kept in this directory.
`make generate` runs

```
sbt "runMain jop.generate.PllGenMain colorlightI5Sdram --module pll_jop_i5 --out build/colorlightI5Sdram/ip"
```

which invokes `ecppll` with the frequency the preset declares and writes
`build/colorlightI5Sdram/ip/pll_jop_i5.v`. `fpga/colorlight-i5/` contains only a
Makefile; a `.v` dropped there is ignored.

This page previously said the wrapper lived in the board directory and should be
regenerated by hand with `ecppll --clkin 25 --clkout0 40 ...`. That stopped being
true when the PLL moved behind `PllGenMain`, and it mattered more here than
elsewhere: README sends first-time hardware users to this board.

Do not hand-edit the dividers, and do not pass a frequency to `ecppll` directly
— change `clkFreq` in the preset, which is what the generator reads. `ecppll` picks a set it guarantees will lock
(Fpfd 5 MHz, Fvco 600 MHz — inside the legal 400–800 band). An out-of-band Fvco
gives a PLL that never asserts LOCK, which presents as the core sitting silently
in reset with no other symptom to go on.

### Why 40 MHz and not 50

The design is strongly seed-sensitive. At a 50 MHz target it routed anywhere from
**47.6 to 50.6 MHz** across nextpnr seeds 1–5:

| seed | 1 | 2 | 3 | 4 | 5 |
|---|---|---|---|---|---|
| Fmax | 49.51 | **50.56** | 49.85 | 47.61 | 49.16 |

Seed 2 passes 50 MHz — by 0.56 MHz, on a ±3 MHz spread. That is seed noise, not
headroom, and every future edit re-rolls it. At 40 MHz the design closes at
**46.11 MHz (seed 1)**, ~15% margin, and the seed stops mattering.

The critical path is the familiar JOP one: JBC RAM output → bytecode byte select →
`branchOffset` → `fetch.pcMux`, of which 5.8 ns is DP16KD clock-to-out. Shortening
that is how to earn 50 MHz properly — a luckier seed is not a fix.

## Resource usage (Stage 1, 64 KB BRAM, single core)

| Resource | Used | Available | % |
|---|---|---|---|
| TRELLIS_COMB (LUT4) | 7379 | 24288 | 30% |
| TRELLIS_FF | 3348 | 24288 | 13% |
| **DP16KD (EBR)** | **40** | **56** | **71%** |
| MULT18X18D | 0 | 28 | 0% |
| EHXPLLL | 1 | 2 | 50% |

**Block RAM is the binding constraint, not logic.** Main memory is 64 KB, not the
128 KB the EP4CGX150 BRAM preset uses: the LFE5U-25F has 1008 Kbit of EBR in total
and 128 KB alone would be 1024 Kbit before a single cache or the microcode store.
There is plenty of logic headroom (70% of LUTs free) — SMP or extra compute units
are limited by EBR, so they need SDRAM first.

## Build and run

```
cd fpga/colorlight-i5
make                 # generate -> yosys -> nextpnr-ecp5 -> ecppack
make program         # load into SRAM over DAPLink
make download        # send HelloWorld.jop over the DAPLink serial port (1 Mbaud)
```

**Superseded 2026-08-18 — a runtime reset now exists** (item 48). The i5 gets
the UART escape, so `download.py -r <app>` resets the core and downloads
without reprogramming; `-R` resets only. It is the UART path only here: no user
button pin is documented for this board, so unlike the EP4CGX150 there is no
`reset_n`. Original note follows, and still applies to any bitstream built
before that date.

The FPGA must be reprogrammed before each download — the serial bootloader only

`make program` loads SRAM only (volatile). Flash boot is not available: the i5's
GD25Q16 ships write-locked, and unlocking needs the procedure from
[kazkojima/colorlight-i5-tips#spiflash](https://github.com/kazkojima/colorlight-i5-tips#spiflash).

### Baud rate

1 Mbaud, verified on hardware. 40 MHz divides exactly for it — `UartCtrl` divides
by baud x 5 samples, so `40e6/(1e6*5) = 8` with no remainder — which is why this
rate rather than a rounder-looking one. There is no baud error to trade off, only
the DAPLink CDC firmware's own limit.

Measured on the 46 KB `HelloWorld.jop`:

| baud | time | rate |
|---|---|---|
| 115200 | 4.1 s | 11 KB/s |
| **1000000** | **0.7 s** | **63 KB/s** |

2 Mbaud also divides exactly (divider 4) if the DAPLink will take it — untested.

### Serial port

The DAPLink CDC endpoint is addressed by serial number, not `/dev/ttyACMn` — the
ACM numbers renumber across replugs and this host has other CMSIS-DAP and CDC
devices. Interface `-if01` is the CDC data endpoint; `-if00` is the HID debug
endpoint openFPGALoader uses. See `fpga/scripts/usb_serial_map`.

## Expected output

```
Small boot
GC init...
GC: classic (no card table - generational disabled)
GC done
CI
OK
M0
Hello World!
```

`GC: classic` is **correct** for Stage 1, not a fault. The preset has no card
table, so `GC.genActive` disables the generational collector at boot rather than
running it with a permanently empty remembered set. A card table follows once
SDRAM lands and there is a heap worth collecting.

## Stage 2 — SDRAM

Working on hardware. 8 MB EM638325BK-6H at 40 MHz, single core, card table enabled.

| | Stage 1 (BRAM) | Stage 2 (SDRAM) |
|---|---|---|
| Main memory | 64 KB on-chip | **8 MB external** |
| Fmax (target 40 MHz) | 46.11 MHz | **47.67 MHz** |
| LUT4 | 30% | 39% |
| Block RAM | **71%** | **21%** |
| GC mode at boot | `classic` (no card table) | `generational, 32-word cards` |

Block RAM drops from 71% to 21% because main memory left the chip — which is what
makes SMP or extra compute units conceivable here, since logic was never the
constraint.

### The 32-bit-wide SDRAM

The EM638325BK-6H is **32 bits wide**, unlike every other SDR part in this project.
`BmbSdramCtrl32` is a 32-bit-BMB-to-**16**-bit-SDRAM bridge that issues two SDRAM
operations per BMB beat, splitting and reassembling halves — the wrong shape here.

Stage 2 adds `BmbSdramCtrlWide`: 32-bit BMB to 32-bit SDRAM, **one operation per
beat**, so all the half-splitting machinery disappears (no `sendingHigh`, no
`isHigh` context, no reassembly register, burst counts are word counts).
`MemoryControllerFactory.createSdr` picks between the two on `layout.dataWidth`,
so no board or preset has to name a bridge.

It is a separate component rather than a width switch inside `BmbSdramCtrl32`:
that one is hardware-validated on three boards and its command/response FSM is
subtle, so threading a width parameter through every state would risk those
boards to save a file.

### CKE, CS and DQM do not exist here

All are strapped on the PCB — CKE to VCC, CS to GND, all four DQM to GND — and
none reach the FPGA. Two consequences:

1. `SdramCtrlNoCke` is used, as on the other boards, and CKE goes nowhere.
2. **No byte masking exists.** Every write writes all four bytes. This is safe
   only because JOP issues full-word writes exclusively —
   `BmbMemoryController:317`, `StackCacheDma` and `DebugController` all drive
   `mask := B"1111"` unconditionally. It is a property of *JOP*, not of the
   bridge, and cannot be checked at elaboration because the mask is a runtime
   value. If a narrower write path is ever added to JOP, this is the board that
   breaks, and it breaks silently.

Conveniently, JOP's memory is word-addressed, so one JOP word is exactly one
SDRAM access and nothing needs masking in the first place.

The generated top still carries `sdram_CKE`, `sdram_CSn` and `sdram_DQM[3:0]`
ports because `SdramInterface` is a fixed bundle. The `.lpf` parks them on unused
ext-board header balls. The alternative, nextpnr's `--lpf-allow-unconstrained`,
lets the placer put them on *any* free ball including connected ones — trading a
documented harmless output for an undocumented possibly-harmful one.

### Verification

`BmbSdramCtrlWideTest` (12 tests) covers the bridge against an `SdramModel`:
read/write, 1:1 address mapping (with a decoy at the address a doubled mapping
would hit, since a doubled mapping still passes write-then-read), burst reads,
a single read after a burst, block fill including empty and inverted ranges,
back-to-back adjacent single-word access, and DQM masking.

## Why the JVM suite needed Stage 2 (resolved)

`DoAll.jop` is 72,428 words = **283 KB**. Stage 1 had 64 KB of main memory, so it
was 4.4x too big — but the more useful figure is that the LFE5U-25F has **126 KB
of EBR in total**, so DoAll would not have fit even with every block RAM on the
chip assigned to main memory and nothing left for the microcode ROM, JBC cache,
stack cache or jump table.

The suite was therefore gated on SDRAM categorically, not on tuning the BRAM
split — worth stating because it is the kind of limit someone otherwise spends a
day trying to tune around. `HelloWorld.jop` (11,929 words = 47 KB) is what Stage 1
could host; Stage 2's 8 MB now runs DoAll at 66/66.

## Gotcha hit during bring-up: stale generated Verilog

Changing the preset's `clkFreq` from 50 to 40 MHz reprograms the PLL — which lives
in `fpga/colorlight-i5/`, not in the generated Verilog — but the old **UART baud
divider stayed baked into the `.v`** because the Makefile's `.v` target had no
dependency on the Scala sources.

The result was not silence but plausible garbage: the board transmitted at
40e6/86/5 = **93023 baud** while the host listened at 115200, producing a steady
`d6 96 94` pattern instead of `aa aa aa`. Same family as the stale-`.jop` traps
elsewhere in this project — a wrong artefact that still *does something*.

The Makefile now makes `$(GENDIR)/$(TOP).v` depend on `$(SCALA_SRC)` and the
microcode `.dat` files. If the UART ever emits a stable repeating non-`0xAA`
pattern, suspect a clock/baud mismatch before suspecting the wiring.

## Bytecode implementation choices

This board has no compute units beyond the ICU, so it is the one that exercises
JOP's microcode fallbacks on real hardware:

| bytecode | choice | why |
|---|---|---|
| `idiv`, `irem` | `hw` (ICU) | ~36 cycles vs ~1300 for the Java trap; every other hardware preset does the same |
| `fcmpl`, `fcmpg` | `mc` | no FCU here, so the alternative is SoftFloat32 at ~600 cycles; the microcode is ~30, for 97 ROM words out of ~1940 free |

The `fcmpl`/`fcmpg` choice is deliberate and load-bearing for testing, not just
for speed: a build left on the default Java path never executes
`fcmpl_sw`/`fcmpg_sw` at all, so it could pass DoAll while saying nothing about
them. This is the only configuration in the project that runs them.

## Next

Ordinary work now, no known blockers:

- **Raise the clock.** 40 MHz was chosen for bring-up; the SDRAM build closes at
  48.08 MHz, and the limit is the usual JOP fetch/branch path rather than
  anything ECP5-specific.
- **Try SMP.** Block RAM is only 21% used now that main memory is off-chip, and
  LUTs are at 42%. This was impossible in Stage 1, where EBR bound at 71% with a
  single core.
- **Flash boot** needs the GD25Q16 unlock procedure
  ([kazkojima/colorlight-i5-tips#spiflash](https://github.com/kazkojima/colorlight-i5-tips#spiflash)).
- **2 Mbaud** divides exactly at 40 MHz (divider 4) if the DAPLink CDC will take it.

## A trap this board exposed, which was not this board's fault

Stage 2 first came up with the JVM suite at 56/66 — ten failures, all in
long/float/double arithmetic and the formatting that depends on it, while
`FloatField` and `LongStaticField` passed. That reads exactly like a bug in a
brand-new 32-bit SDRAM bridge, and two plausible hypotheses (software `idiv`, a
stale `.jop`) were both tested and both wrong.

Running the *same* `DoAll.jop` under `JopJvmTestsBramSim` — default config, no
SDRAM, no ECP5 — reproduced the identical ten failures. The regression was
`621aac7`, committed earlier the same day, and affected every board; reverting it
restored 66/66 in the sim and 66/66 on this hardware. See item 17 in
`docs/current-status.md`.

The lesson is cheap to reuse: **when a new platform fails a suite, run the same
image on a known platform before debugging the new one.** It cost one 15-minute
simulation and would have cost a day of bridge debugging.

## References

- `/srv/git/Colorlight-FPGA-Projects` — [wuxx/Colorlight-FPGA-Projects](https://github.com/wuxx/Colorlight-FPGA-Projects); pinouts and i5 examples
- `/srv/git/riscvOnColorlight-5A-75B` — [ghent360/riscvOnColorlight-5A-75B](https://github.com/ghent360/riscvOnColorlight-5A-75B); **5A-75B, different pinout**
- `/srv/git/atari800-spinalhdl/boards/i5-7v0` — prior ECP5 work in this workspace; PLL example, no UART

## Fit, and where the benchmark numbers live (2026-08-18)

40 MHz, SDRAM stage, single core, downloaded at 1 Mbaud over the DAPLink CDC.

| | |
|---|---|
| fit | **49.65 MHz** (PASS at 40) |
| logic | TRELLIS_COMB 10111/24288 (41 %), TRELLIS_FF 4500/24288 (18 %) |
| block RAM | DP16KD **12/56 (21 %)** — against 40/56 for the BRAM stage's 64 KB, which is why benchmarks run over SDRAM here (current-status item 21) |

**Benchmark results are in [`../../java/apps/JbeBench/README.md`](../../java/apps/JbeBench/README.md)**,
which is the single home for them — see the Colorlight i5 section. Not repeated
here: this project has already had duplicate benchmark tables drift apart within
two days (the GC docs), so board docs carry fit and operating detail and the
benchmark README carries results.

What the numbers are *for*, in one line: the i5 is the only board with a 32-bit
SDRAM (one op per BMB beat against the 16-bit boards' two) and the only
open-source toolchain, which makes it the project's independent check on both.
Analysis in current-status item 44.

### If it looks dead, check this first

A board that has already had a **failed download attempt** looks completely
silent, because the serial boot loader's ready handshake has been consumed.
**Reprogram immediately before listening.** This cost an hour and a wrongly-filed
regression on 2026-08-18 — the SDRAM stage was healthy the whole time.

Use `fpga/scripts/run_bench`, which reprograms first. If driving `download.py`
by hand, give it `python3 -u`: it block-buffers when piped, so a `timeout` kill
discards every diagnostic and you get no error at all.
