peteryates1/jop-spinalhdl/docs/boards/ae115fb-ddr2-bringup.md

# A-E115FB DDR2 bring-up plan

Getting JOP running against the 1 GB DDR2 SODIMM on the A-E115FB (EP4CE115).
Board reference: [ep4ce115-ddr2-board.md](ep4ce115-ddr2-board.md).

Status: **DDR2 WORKS ON HARDWARE (2026-08-03).** Calibration completes against
the real 1 GB SODIMM and a write/read/verify pass runs clean:

```
DDR2 i=1 s=5 w=0fff r=1000 e=0000
```

**FULL 1 GB VERIFIED.** The sweep covers the whole 25-bit space:

```
DDR2 i=1 s=5 w=1ffffff r=2000000 e=0000
```

`w=0x1FFFFFF` = 33,554,431 words written, `r=0x2000000` = 33,554,432 read back,
zero errors. Over a 130 s window: **77 complete 1 GB passes, ~154 GB of traffic,
and the only error count ever observed was 0000**, each pass using a different
seed so stale data cannot pass twice. Sustained ~1.2 GB/s combined
(write + read), which is command-rate limited — single-word commands
(`local_size=1`), no bursting.

This exercises row, bank AND rank decoding, including the `mem_cs_n` rank
boundary near the top of the space.

---

## Already de-risked

- **The DDR2 IP is already generated.** ALTMEMPHY DDR2 High Performance
  Controller v13.1 at
  `/srv/git/cycloneEthernet/A-E115FB_core_V2/E115_core_test/read_write_1G/DDR667_read_write/ddr2_64bit/`
  — including `ddr2_64bit_bb.v` (exact blackbox port list) and
  `quartus/ddr2_64bit_pin_assignments.tcl` (504 lines of DDR2 pin constraints).
  We do **not** need to regenerate IP; Quartus 18.1 is installed as a fallback
  (25.1 cannot generate Cyclone IV DDR2 IP, but compiles fine with pre-generated
  RTL).
- **A working reference design** — `ddr2_sodimm.v` / `ddr2_read_write.v` with
  `.qsf`. Device `EP4CE115F23I7`, family `Cyclone IV E`, clk `AB11`, rst_n `N21`.
- **Programming works** — pico-usb-blaster via Quartus, verified 2026-08-02
  (IDCODE `020F70DD`). See the probe map in memory / `fpga/scripts/jtag_probe_map`.
- **UART works** — the board's own CH340 (FPGA TX `H5`, RX `N1`), proven by
  loopback in commit `a32434b`. The Pico is not needed for serial here, which is
  why it could be switched to pico-usb-blaster (that firmware has no CDC).
- **`addressWidth = 30` (1 GB) already elaborates** — Stage 1 Part A
  parameterised the datapath; `Ddr3WidthElabTest` builds a 30-bit config.
- **`LruCacheCore` is already line-width parameterised** — `CacheConfig.dataWidth`
  drives every register, memory and mask. `CacheWidthElabTest` confirms clean
  elaboration at **128 / 256 / 512** bits with the fill path enabled, at a 30-bit
  address width. No RTL work needed to widen the line.
- **The GC is ready for a big heap** — a major GC is now O(live) rather than
  O(heap) and `zeroMem` chunks the hardware fill (`5e0a3a0`). At 1 GB the old
  whole-heap bulk zero would have been catastrophic.

## Local interface (from the generated IP)

| Signal | Width | Notes |
|---|---:|---|
| `local_address` | 26 | 128-bit granularity → 2^26 × 16 B = **1 GB** |
| `local_wdata` / `local_rdata` | 128 | |
| `local_be` | 16 | byte enables |
| `local_ready` | 1 | one signal for command **and** write data |
| `local_rdata_valid` | 1 | read data valid pulse |
| `local_read_req` / `local_write_req` | 1 | |
| `local_burstbegin`, `local_size` | | multi-beat bursts |
| `local_init_done` | 1 | calibration complete — boot must gate on this |
| `phy_clk` | 1 | **user logic runs on this**, ~83 MHz at DDR2-667 half-rate |

Simpler than the Xilinx MIG: single `local_ready` (MIG splits command and
write-data channels), `local_wdata` accepted on the same cycle as
`local_write_req` (no `app_wdf_*` handshake), and a single clock domain.

## Done so far

- `Parts.scala`: added `EP4CE115F23I7` and a **Cyclone IV E** family (the
  existing `CycloneIV` hardcodes "Cyclone IV GX", which is a different Quartus
  family). Noted in passing that `EP4CE6E22C8` looks mis-assigned to GX as well —
  left alone rather than changed blind.
- `jop.ddr2.Ddr2BlackBox` — ports transcribed from `ddr2_64bit_bb.v`.
- `jop.system.Ddr2ExerciserTop` — drives the local interface directly, with an
  address-derived pattern, UART reporting and LED status.
- `fpga/a-e115fb-ddr2/` — Quartus project. The vendor IP is **not** vendored into
  the repo (~3.7 MB, vendor licence, not regenerable after 18.1); `make ip` links
  it from `DDR2_IP_DIR`.
- Build result: **6,534 LEs (6%)**, 118 pins, `.sof` produced with Quartus 18.1.

Three things the vendor reference taught us that were not in the plan:
- `mem_addr[10]` sits on **K22, the nCEO configuration pin** — needs
  `CYCLONEII_RESERVE_NCEO_AFTER_CONFIGURATION "USE AS REGULAR IO"`.
- `clk`, `rst_n` and the LEDs are in banks shared with DDR2, so they must use the
  **1.8 V** I/O standard, not 3.3-V LVTTL.
- The UART pins (H5/N1) are in banks 1/2, which are *not* DDR2 banks, so they can
  and should be explicitly 3.3-V LVTTL — left unconstrained they defaulted to
  2.5 V, marginal into the CH340.

## Timing: closed, but only just

**`phy_clk` is 166 MHz, not the ~83 MHz the plan assumed.** The IP was generated
with `local_if_drate = Full` and `mem_if_clk = 166 MHz`, so the local interface
carries 128 bits per memory clock. Confirmed from the timing report, not
inferred: `clk` base 40.000 ns (25 MHz), `pll1|clk[1..4]` 6.021 ns (166.0 MHz).

The SDC turned out to be **fine**, contrary to a first reading. The real
constraints come from `ddr2_64bit_phy_ddr_timing.sdc`, pulled in by
`ddr2_64bit_phy.qip`, and they do `create_clock` on the 25 MHz reference plus
`derive_pll_clocks`. The inapplicable `ddr2_64bit_example_top.sdc` contains only
three `set_false_path`s to ports we do not have — noisy warnings, nothing more.
`ddr2_exerciser.sdc` was added for our own pins (reset, UART, LEDs) so they stop
appearing as unconstrained.

Getting to closure, worst setup slack at Slow 1200mV 100C:

| step | slack |
|---|---|
| first build | -2.151 ns (our 128-bit read compare) |
| pipeline the compare | -0.329 ns |
| split compare from the error-counter increment | -0.439 ns (now inside the IP) |
| project SDC | -0.079 ns |
| `SEED 3` + `HIGH PERFORMANCE EFFORT` | **+0.008 ns** |

Our logic is off the critical path; the residual was always inside
`ddr2_64bit_controller_phy`. **+0.008 ns is a seed-dependent close, not real
margin** — treat it as "will probably work on the bench", not as timing closure
you can build on.

## JOP on DDR2 — builds and runs, serial handshake not yet working

`make PROJECT=jop_ddr2 all` builds `JopDdr2Ae115fbTop`:
**30,765 LE (27%)**, 585 Kbit BRAM (15%), worst setup slack **+0.123 ns**.
It programs, and the design comes up and drives the UART. It does NOT yet
complete the serial-boot handshake.

Three real problems were found and fixed getting this far:

1. **Reset must be gated on `local_init_done`, not just `reset_phy_clk_n`.**
   The latter deasserts as soon as phy_clk is stable, but the memory is unusable
   until calibration finishes, so JOP started executing against uncalibrated
   DRAM. The MIG needs no equivalent because `ui_clk_sync_rst` already spans
   calibration.
2. **83 MHz was unachievable.** `LruCacheCore` missed by -1.053 ns
   (`pendingIndex -> compVictimIsDirty`) on this -7 part. The IP was regenerated
   at a 150 MHz memory clock, so phy_clk is 75 MHz — that fixes every path at
   once, and DDR2 bandwidth is not the constraint (the exerciser was
   command-rate limited at 1.2 GB/s, not clock limited).
3. **UART baud quantisation.** `UartCtrl` divides by `baud x 5 samples`, so at
   75 MHz a 2 Mbaud request gives a divider of 7.5 -> 7 = 2.143 Mbaud, **+7%**,
   far outside UART tolerance — the line was unframeable at every host rate. At
   115200 the divider is 130 (+0.16%) and the stream decodes cleanly. Small
   dividers quantise badly; keep the divider comfortably large.

### `0x4D` diagnosed: it *is* `0xAA`, mis-framed

The design emitted a clean, correctly framed, continuous stream of `0x4D`
instead of the `0xAA` ready byte. It turned out JOP was sending `0xAA`
correctly all along — the **receiver** was locked onto the wrong bit.

A gapless back-to-back stream of 8N1 `0xAA` frames is the repeating 10-bit
pattern `0010101011`. That pattern contains four phases at which a receiver can
see a falling edge, sample eight bits, and find a **valid stop bit** — four
*stable* locks, not transient glitches:

| lock phase | decodes as |
|---|---|
| 0 (correct) | `0xAA` |
| 3 | `0x35` |
| 5 | **`0x4D`** ← what we saw |
| 7 | `0x53` |

Once in a false lock there is no way out without an idle line, which is why the
stream looked perfectly framed and perfectly wrong. A sweep of every
clock/divider combination that yields a single stable byte confirms `0x4D` is
not reachable by any baud error (`0x35` is, at several).

**Root cause**: `rdy_send` polled for the ACK using a bare instruction counter
(`ldi 78`), not a time interval. An instruction count scales with clock but not
with baud, so the resend rate and the byte rate drift apart per board:

| board | resend interval | byte time | result |
|---|---|---|---|
| EP4CGX150 / XC7A100T @ 2 Mbaud | ~14 us | 5 us | ~9 us idle gap, receiver resyncs every byte |
| A-E115FB @ 115200 | ~19-31 us @ 75 MHz | **87 us** | loop outruns the UART ~4x, 16-deep TX FIFO never drains, **zero idle** |

Dropping to 115200 — forced by the 75 MHz divider quantisation — made the
resend loop faster than the transmitter for the first time, so the line never
went idle. **The idle gap between ready bytes is load-bearing**, not incidental.

**Fix**: `rdy_send` now computes a deadline from `io_us_cnt` (the 32-bit
microsecond counter in `Sys`, previously defined in `jvm.asm` but never used)
and tests the sign of `deadline - now`, which is wrap-safe across the counter's
~71-minute rollover. `rdy_timeout_us = 500000` was already defined, and already
matches what `download.py`'s docstring claims. The handshake is now
baud-independent. Constant-pool cost is zero: `ldi` indexes a 32-entry pool via
a 5-bit operand, and dropping `78` paid for `500000` (`0x80000000` for the sign
test was already there).

Two leads recorded here earlier were both dead ends, worth stating so nobody
re-walks them:
- **`Startup.java:161`'s memory probe cannot be involved.** `0xAA` comes from
  microcode, before the download; `Startup` runs only after the transfer.
- **The ROM/RAM pair was already correct** —
  `JopDdr2Ae115fbTop.summary.txt` records `asm/generated/serial/`, selected by
  `bootMode = Serial`.
- **Control that still passes**: reprogramming `ddr2_exerciser.sof` prints
  `i=1 ... e=0000` cleanly, so the board, the DDR2 interface and the CH340 path
  are all healthy — the problem was confined to the JOP design.

Status: **fixed and confirmed on hardware (2026-08-03).** The board now emits
`0xAA` at a measured 0.51 s cadence (12 bytes in 6 s), `download.py` prints
`ready!`, and all 11,477 words stream at full line rate. Build: 30,731 LE (27%),
worst-case setup slack **+0.584 ns** at Slow 1200mV 100C, zero TNS.

### Next blocker: the first dirty cache-line eviction deadlocks

With the handshake working, the download itself now fails — and it fails at an
exact, repeatable boundary.

| image size | result |
|---|---|
| 16 words | checksum returned, MATCH |
| 1024 / 2048 / 2049 / 3072 | MATCH |
| 6144 / 8192 words (32,768 B) | MATCH |
| **8193 words (32,772 B)** | **no checksum, JOP hangs** |
| 8256 / 8320 / 8448 / 8704 / 9216 / 10240 / 11477 | hangs |

**8192 words is exactly the cache size.** `createDdr2Path` builds
`LruCacheCore` with `setCount = 256`, `dataWidth = 256`, and `wayCount = 4`
(the `CacheConfig` default): 4 x 256 x 32 B = **32 KB = 8192 words**. The
download writes sequentially from word 0, so it fills all 1024 line slots with
dirty lines; at exactly 8192 words the cache is precisely full and no eviction
is ever needed. **Word 8192 is the first write that must evict a dirty line, and
that write never completes** — the microcode blocks forever in the `wait` after
`stmwd`.

That it is a hard hang, not lost data, was confirmed by feeding 3,553 padding
bytes (888 words) after a failed transfer: the loop never advanced and no
checksum appeared.

**Root cause: `CacheToDdr2Adapter` never responded to writes.**

`LruCacheCore` issues an eviction as a `memCmd` **write** and then blocks in
`WAIT_EVICT_RSP` until a `memRsp` arrives — exactly as it blocks after a refill
read. Its contract is *one response per command, writes included*.
`CacheToMigAdapter` satisfies this by pushing a dummy response for every
accepted write (`CacheToMigAdapter.scala:101`). The DDR2 adapter pushed only
from `local_rdata_valid`, and a write never produces one — so the first dirty
eviction hung the whole memory path.

The deadlock guess recorded here first (a writeback blocked behind read-FIFO
space) was wrong: writes were never gated on read room. The bug was simpler and
one level up — a contract mismatch, not a flow-control one.

**Why the tests missed it**: `CacheToDdr2AdapterSim` drives the adapter directly
and only enqueued an expected response per *read*, mirroring the DDR2 interface,
where a write is genuinely fire-and-forget on `local_ready`. That is the right
model of the hardware and the wrong model of the cache above it. The testbench
never instantiated `LruCacheCore`, so nothing ever waited for a write response.

**Second latent hang, same cause**: `FILL_DRAIN` finishes only when
`fillRsp === fillIssued`, counting `memRsp` for the writes that `FILL_WRITE`
issues. With `hasBackendFill = true`, the GC's hardware zero-fill would have
deadlocked identically the first time it ran — which matters, because the GC
suite is the entire point of this board.

**Fix**: the adapter now emits a response for every accepted command. Two
details it has to get right:

- Read data cannot be stalled, so it always wins the single FIFO push port; a
  write acknowledgement that collides with it waits one cycle in `ackPending`,
  and no new command is accepted while one is pending, which preserves ordering.
- The reservation counter now counts to the **pop**, not to the FIFO push. The
  old counter bounded reads *in flight* but ignored responses already queued, so
  a stalled consumer could hold `rspDepth` entries while further reads were
  still issued — an overflow that would have silently dropped read data. Both
  draw on the same budget now.

**Tests**: `CacheDdr2EvictSim` (new) wires the real `LruCacheCore` to the real
adapter with a shrunk geometry (4 sets x 4 ways x 32 B = 16 lines), so the same
eviction happens after 17 line writes instead of 1025. It reproduced the hang
exactly — 16/17 completions, one evict write issued and then silence — and now
passes 200 line writes through 184 evictions with every line read back and
verified. `CacheToDdr2AdapterSim` was corrected to expect a response per
command; 401/401, 0 mismatches.

A trap worth keeping: the first version of `CacheDdr2EvictSim` checked
`frontend.req.ready` and reported PASS while deadlocked, because the cache has a
4-deep input FIFO that keeps accepting requests after the pipeline behind it has
stopped. **Measure completions, not acceptances.**

Useful harness: `fpga/scripts/download_sizetest.py <n_words>` streams a
synthetic N-word image with a correct size word and checks the returned XOR
checksum, isolating the memory path from anything Java. Reprogram between runs —
the FPGA accepts one download per configuration.

## GC suite at 1 GB — the payoff (2026-08-03)

All green, at 1 Mbaud, on the timing-closed build:

| test | result |
|---|---|
| `DoAll` (JVM suite) | **66/66 ok**, 0 fail, `JVM exit!` |
| `GcStressTest` | **537,119 rounds** (~5.4M allocations), 0 errors, no exhaustion |
| `MultiArrayGcTest` | `MULTIARRAY GC OK` — corrupt 0, badYoung 0, badCompact 0 |
| `IntHandlerGcTest` | `INTHANDLER GC OK` — handler tag intact across minor+major GC |
| `GcPauseTest` | ran; **pause bound violated, see below** |

`free 1,067,359,856 bytes` confirms the full ~1.07 GB heap in use.

### The pause bound does not hold on this board

`GcPauseTest`, 42 minor collections:

| | |
|---|---|
| worst / mean / last | **25.376** / 25.089 / 25.173 ms |
| roots | 8.530 ms (33%) |
| mark | 0.264 ms (1%) |
| copy (the O(handles) sweep) | 16.581 ms (65%) |
| zero / cards | 0.000 / 0.001 ms |
| swept handles | 9687 — **exactly `MAX_YOUNG_OBJECTS`** |
| sweep ns/handle | **1711** |

The cap is doing its job — the sweep stops at exactly the derived 9687 handles.
The *model* is what is wrong, and by much more than clock scaling explains:

| constant | value | measured here | error |
|---|---:|---:|---:|
| `SWEEP_NS_PER_HANDLE` | 1600 | 1711 | +7% |
| `MINOR_FIXED_US` | 4500 | **8795** | **+95%** |
| resulting pause | 20.0 ms (target) | **25.4 ms** | +27% |

`SWEEP_NS_PER_HANDLE` is nearly right. **The error is almost entirely the root
scan**: 8.53 ms against a 4.5 ms budget that is supposed to cover roots + mark +
cards together. 75 MHz vs the 100 MHz the constant was measured at accounts for
only 1.33x (3.9 -> 5.2 ms), so the rest is DDR2 latency on the root walk.

To hold 20 ms here the cap would have to be **6548** instead of 9687 — a 32%
cut, i.e. 1.48x more frequent minor GCs **on every board**, including the two
that already meet the bound. That is the open decision: a single global constant
cannot bound the pause across heterogeneous boards without taxing the fast ones.
Options are (a) adopt this board's numbers per the existing "slowest measured
board" policy and accept the throughput cost everywhere, (b) make the two
constants per-board config rather than `static final`, or (c) derive the cap at
runtime from the first few measured collections. **Do not change them before
re-measuring the EP4CGX150 and XC7A100T** — they have not been re-run since the
microcode change, and (a) is only defensible with all three numbers in hand.

### Major GC

`count 2, worst 120.623 ms, last 14.126 ms`, `MAJOR OK`, retained 64/64,
corrupt 0. Not comparable to the 2.2 s at 36k live objects seen on DDR3 — this
test retains only 64 objects, so the O(live) constant is untested at scale here.

### The 1 GB heap is real (and the GC trace lies about it)

The first boot printed
`[carve hStart=35768 hSize=91496 nBase=78688 nSize=48576 copy=35768]`, which
reads as a ~500 KB heap on a 1 GB board. It is not. `GC.wrIntG`
(`GC.java:1179`) begins at `if (v >= 10000)` and so emits **only the low five
digits**; on this board that truncates everything it prints. Reconstructed:

| printed | actual | derivation |
|---|---:|---|
| `copy` / `hStart` | 535,768 | `mem_start` 11,480 + handle area 524,288 |
| `hSize` | 267,891,496 | 268,427,264 - 535,768 |
| `nBase` | 267,378,688 | top - 1,048,576 |
| `nSize` | 1,048,576 | exactly `NURSERY_MAX_WORDS` (1 << 20) |

`mem_size` = 268,427,264 = 2^28 - 8192, exactly `usableMemWords` for 1 GB minus
the per-core stack region — so `IO_MEM_SIZE` is reaching Java correctly and the
handle table is capped at `MAX_HANDLES` as intended. **The heap is ~1.02 GB and
everything reconciles.** Worth fixing the printer before reading GC traces here.

### Clock choice: 75 MHz is a good baud clock, and 1 Mbaud is exact

Worth recording because the instinct is to blame the odd frequency. `UartCtrl`
divides by `baud x 5`, and 75 MHz divides *exactly* into several standard rates:

| baud | divider @ 75 MHz | error |
|---|---:|---|
| 115200 | 130 | +0.16% |
| **1000000** | **15** | **0.00%** |
| **1500000** | **10** | **0.00%** |
| 2000000 | 7 | +7.14% — unusable |
| **3000000** | **5** | **0.00%** |

Only 2 Mbaud is unreachable. 83 MHz (the frequency we backed away from) is
*worse*: it misses 1 M by 3.8% and 3 M by 10.7%. Changing the memory clock would
mean regenerating the ALTMEMPHY IP through the fragile `qmegawiz` path and
re-closing timing, to fix a problem the clock never caused.

The preset was brought up at 115200 and now runs at **1 Mbaud** (divider 15,
0.00% error), which takes a 44 KB download from 4.0 s to ~0.5 s. Pass the baud
explicitly — `download.py` still defaults to 2 Mbaud:

```bash
python3 fpga/scripts/download.py -e <app.jop> /dev/ttyUSB0 1000000
```

## Still to prove

- The GC suite at 1 GB, which is the actual point of the exercise. That needs
  `CacheToDdr2Adapter` + the JOP preset (items 3, 4, 6 below).
- Bursting. At `local_size=1` the interface is command-rate limited to ~1.2 GB/s
  against a ~5.3 GB/s DDR2-667 peak. A 256-bit local word already equals the
  BL=4 burst, so multi-word bursts are the next bandwidth lever if the cache
  path needs it.

**Gotcha found while scaling the sweep**: the periodic status line reset the test
state machine when it fired, which was invisible at 4096 words (a pass finished
between ticks) but restarts a 1 GB pass forever. Only a send triggered *by*
completion may advance the pass — see `sendFromReport`.

## Getting it programmed — what actually mattered

Two days of the bring-up went on programming rather than DDR2, so:

- **The pico-usb-blaster clone never successfully configured this board.** It
  reads IDCODE reliably but a 3.5 MB configuration stream ends with CONF_DONE
  low. The Terasic cable + `quartus_pgm` worked first time. Suspect the flying
  leads from the Pico to the JTAG header.
- **A ghost USB device wasted most of the effort.** The VM held stale
  passthrough entries: a disconnected board still appeared in `lsusb`/sysfs, and
  writes to it "succeeded" at a plausible rate while reaching nothing. Every
  firmware theory (TCK too fast, FIFO desync, stale binary) was chasing that
  artefact. **Tell: transfers succeed but produce no observable effect on the
  target, and no firmware change alters the throughput.** Disconnect and replug
  everything when that pattern appears.
- **Tools that pick the first matching VID:PID are a trap.** A genuine Altera
  cable and the clone are both `09fb:6001`. `openFPGALoader` ignores
  `--busdev-num` on both its dirtyJtag *and* usb-blaster backends, and
  `program_fpga` used `libusb_open_device_with_vid_pid()`. `quartus_pgm -c
  "<cable name>"` is the one that selects correctly.
- **The LEDs lied.** The board auto-loads a factory EPCS demo at power-up, which
  blinks LED0 and lights the rest — identical to what a running design looks
  like. LED0 blinked with the FPGA unconfigured, which is what exposed it. Use
  the UART, not the LEDs.

## Preset and top-level: done (elaboration)

`JopConfig.ae115fbDdr2` → `JopDdr2Ae115fbTop`. The DDR2 path follows the DDR3
structure in `JopTop`: the controller sits outside the main clocking area and
the whole system runs in the clock it produces. Two differences from DDR3:

- **No board PLL.** ALTMEMPHY contains its own, takes the 25 MHz oscillator as
  its reference, and sources `phy_clk` (83 MHz half-rate) for everything. The
  board declares no `pllType`, and `Pll.create` throws if called — so the DDR2
  path skips it.
- **Reset is active-LOW and asynchronous** (`reset_phy_clk_n`), where the MIG's
  `ui_clk_sync_rst` is synchronous active-HIGH.

Also needed, and easy to miss because each fails in a different place:
`MemoryDevice.byName` must know the part (otherwise `resolveMemory` returns None
and the board silently looks like BRAM); the entity-name derivation needs a DDR2
branch; and the device-derived `addressWidth` override in `JopTop` applied only
to DDR3, so the adapter came out 24-bit instead of 30-bit.

Top-level ports match `Ddr2ExerciserTop`, so `ddr2_exerciser.qsf`'s pin
assignments carry over to the JOP build.

## Adapter: done (simulation)

`jop.ddr2.CacheToDdr2Adapter` bridges `LruCacheCore`'s memCmd/memRsp to the
local interface. Two asymmetries with the MIG that are easy to get wrong:

- **Mask polarity inverts.** The cache's `mask` is a KEEP mask (1 = leave this
  byte alone), which happens to match MIG's `app_wdf_mask` so that adapter
  passes it through. DDR2's `local_be` is a byte ENABLE, so `local_be := ~mask`.
- **Reads cannot be back-pressured.** `local_rdata_valid` arrives when the
  controller decides and cannot be stalled, but the cache's memRsp is a Stream
  that can. Responses therefore land in a FIFO and reads in flight are capped at
  the space available — otherwise a slow consumer silently loses returned data.

`CacheToDdr2AdapterSim` drives it against a behavioural model with random
`local_ready` back-pressure, 3-9 cycle read latency and a stalling consumer:
201 writes, 200 reads, **0 mismatches**, and the masked write confirms the byte
enables. Not yet exercised on hardware.

**Testbench gotcha worth remembering**: the model first randomised `local_ready`
and then used that new value to decide whether the DUT's current command had
been accepted — but the DUT saw the PREVIOUS value. The model and DUT then
disagreed about which commands were taken, producing duplicated reads that
looked exactly like an RTL ordering bug (`got[n] == want[n-1]`). Always decide
acceptance from the signal value the DUT actually saw at that edge.

## Half rate: done

The IP is now regenerated at half rate, and it resolved all three problems at
once:

| | full rate | half rate |
|---|---|---|
| `phy_clk` | 166.09 MHz | **83.04 MHz** |
| `local_wdata`/`local_rdata` | 128 bits | **256 bits** |
| `local_be` | 16 | 32 |
| `local_address` | 26 bits | **25 bits** (2^25 x 32 B = 1 GB) |
| worst setup slack | +0.008 ns, seed-dependent | **+1.086 ns** |
| logic | 6,517 LE | 7,430 LE (6%) |

83 MHz is within reach of JOP, and a 256-bit local word equals the DDR2 BL=4
burst (32 bytes) — so the "cache line width" open decision below answers itself:
go straight to a 256-bit line.

### How the IP is regenerated

`make ip` rebuilds it from `ip-src/ddr2_64bit.v`, a ~30 KB variation file under
version control; the ~3.7 MB of generated Verilog is derived and is not. Needs
Quartus **18.1** — Intel dropped Cyclone IV DDR2 ALTMEMPHY after that, which is
why 18.1 is installed.

Getting `qmegawiz` to regenerate headlessly took three attempts, worth recording:

- `qmegawiz -silent -xmlin ddr2_64bit.xml` fails with *"No launch command line
  found for megafunction wizard plug-in Uninstalled/Unknown MegaWizard"*, and
  consumes the XML. Editing the XML's `version=` does not help.
- The wizard is found by the name in the **first line of the `.v`**:
  `// megafunction wizard: %DDR2 High Performance Controller v13.1%`. The
  installed plug-in registers aliases for **v18.1 / v18.0 / v9.0** only
  (`/opt/altera/18.1/ip/altera/ddr2_high_perf/lib/*.lst`), so v13.1 is not
  matched — bump it to v18.1.
- Parameters come from the **"Retrieval info" comments in the `.v`**, not from
  the XML. `local_if_drate` is set there; the wizard recomputes the derived
  values (`local_if_dwidth_label` 128 -> 256, `local_if_clk_mhz_label` 166 -> 83).
- `qmegawiz` generates against the project's family/device, so it needs a
  minimal `.qpf`/`.qsf` in the working directory. The Makefile writes them.

## Work items

1. **`Parts.scala`** — add `EP4CE115F23I7`. Note the existing `CycloneIV` entry
   hardcodes `quartusFamilyName = "Cyclone IV GX"`; this board is Cyclone IV **E**,
   so the family needs splitting.
2. **`Ddr2BlackBox`** — wrap `ddr2_64bit` from `ddr2_64bit_bb.v`.
3. **`CacheToDdr2Adapter`** — DONE (`jop.ddr2.CacheToDdr2Adapter`).
4. **DDR2 local-interface sim model** — DONE (`CacheToDdr2AdapterSim`), passes:
   200 reads, 0 mismatches, byte enables and the FIFO bound both verified.
5. **`Ddr2ExerciserTop`** — *first hardware milestone*. Model on
   `Ddr3ExerciserTop`: bring up the IP, wait for `local_init_done`, run read/write
   patterns over 1 GB. Proves BlackBox + adapter + pins + calibration in
   isolation, before JOP is in the picture.
6. **Preset + top-level** — DONE. `JopConfig.ae115fbDdr2` generates
   `JopDdr2Ae115fbTop`, with a 25-bit `local_address` (1 GB of 256-bit words)
   derived from the memory device, not hardcoded. Existing presets
   (xc7a100tDbSerial, ep4cgx150Serial, wukongDdr3) still elaborate cleanly.
7. **Quartus project** `fpga/a-e115fb-ddr2/` — Makefile modelled on
   `fpga/qmtech-ep4cgx150-sdram/`, sourcing the IP `.qip` and the pin-assignment
   TCL verbatim. Select the cable with
   `jtag_probe_map --cable ae115fb`.
8. **Re-run the GC suite at 1 GB** — DoAll, GcStressTest, GcPauseTest,
   MultiArrayGcTest. This is the payoff: the first real exercise of
   `addressWidth=30` and of the O(live) major GC at a heap size where it matters.

## Open decisions

- **Cache line width — SETTLED: use 256 bits.** DDR2 BL=4 on a 64-bit bus is 32
  bytes = 256 bits, which is also exactly the half-rate local word, so a 128-bit
  line would waste half of every burst. `LruCacheCore` elaborates at 128/256/512
  (`CacheWidthElabTest`) **and now passes 7/7 functionally at 32/128/256/512**
  (`LruCacheCoreUnitSim <width>`) — the vectors are derived from the cache
  geometry instead of hardcoded, so a 256-bit line is verified, not assumed.
- **`MAX_HANDLES`** is 65536, which caps the handle table regardless of heap size.
  At 1 GB that is worth revisiting — it bounds how many live objects the heap can
  hold, independent of free space.
- **Core count.** Resource budget suggests 12 cores fit; start at 1.
