peteryates1/jop-spinalhdl/docs/bugs-and-issues.md

# Bugs and Issues

Master index of all bugs found and fixed during the SpinalHDL JOP port, plus
open JVM issues requiring workarounds. For detailed investigation notes on
each bug, see [Implementation Notes](architecture/implementation-notes.md).

---

## Fixed since mid-August — indexed by status item

The numbered tables further down stop before mid-August 2026. Defects fixed
since are recorded as items in [current-status.md](current-status.md), with the
evidence; this is their index.

| Fixed | Defect | Record |
|---|---|---|
| 2026-08-15 | `AlteraSdramAdapter` dropped read data when the consumer stalled, and let write responses answer outstanding reads with 0 — the cause of the >2-core SMP GC failure (`ef36d99`) | [item 1](current-status.md#item-1), [item 35](current-status.md#item-35) |
| 2026-08-17 | `CacheToDdr2Adapter` acked a write before an earlier read had answered: silent corruption once misses overlap (`4ab36ee`) | [item 148](current-status.md#item-148) |
| 2026-08-31 | `"*" -> "hw"` dropped the SoftFloat library that `frem` runs in, so `wukongFull` died at `FloatTest` | [item 69](current-status.md#item-69) |
| 2026-09-01 | An array-cache hit skipped the bounds check, so out-of-range reads returned adjacent memory | [item 128](current-status.md#item-128) |
| 2026-09-02 | The card-table clear-all dropped every mark that arrived during it | [item 131](current-status.md#item-131) |
| 2026-09-03 | A String literal had no valid `OFF_TYPE` | [item 136](current-status.md#item-136) |
| 2026-09-03 | The GC write barrier pushed references below `mem_start` onto the grey list | [item 141](current-status.md#item-141) |
| 2026-09-05 | `arraylength` had no null check | [item 129](current-status.md#item-129) |
| 2026-09-11 | The card-table read port could be stolen by any write (the RTL half) | [item 132](current-status.md#item-132) |
| 2026-09-14 | Stop-the-world had no acknowledgement, and its leak detector was never incremented | [item 157](current-status.md#item-157), [item 158](current-status.md#item-158) |
| 2026-10-02 | Stack walkers were not served from the stack cache's spill region; RT threads could not be constructed | [item 133](current-status.md#item-133), [item 160](current-status.md#item-160) |
| 2026-10-07 | A core parked in `cpux_loop` left it early: a read command was held through the flush stall | [item 161](current-status.md#item-161) |
| 2026-10-10 | The Wukong's clock IP gave the SDRAM a different frequency from the logic at 80 MHz | [item 164](current-status.md#item-164) |
| 2026-10-12 | `BmbMemoryController` re-latched every I/O read, so pop-on-read registers returned the next value (Ethernet RX one word late, UART bursts one byte late); and the GMII receive clock was never created, so it went untimed | [item 68](current-status.md#item-68) |

Still open: a halted core can dirty its stack after the stop-the-world flush
([item 165](current-status.md#item-165)).

---

## JVM Runtime Issues (All Fixed)

These were limitations in the JOP JVM runtime. All have been fixed.

### 1. System.arraycopy (FIXED — was misdiagnosed)

Originally reported as "`System.arraycopy()` crashes with a stack overflow".
The actual root cause was bug #2: `StringBuilder` had no `toString()` method,
so any `StringBuilder` operation ending in `.toString()` triggered infinite
recursion via `Object.toString()` → `"Object " + hashCode()` → new
`StringBuilder` → `.toString()` → ... → stack overflow.

With `StringBuilder.toString()` fixed (bug #2), `System.arraycopy` works
correctly. `StringConcat` test T7 verifies this: appends 20 chars to a
default-capacity (16) `StringBuilder`, forcing `ensureCapacity()` →
`System.arraycopy()` resize. Passes in simulation.

The two-pass `char[]` workarounds in `DirEntry.formatShortName()` and
`Fat32FileSystem.stripIllegalChars()` are no longer necessary but harmless.

### 2. String Concatenation with int (FIXED)

`"text" + intValue` compiles to `StringBuilder.append(int)` which calls
`Integer.toString()`. `StringBuilder` had no `toString()` method, so it
fell back to `Object.toString()` which does `"Object " + hashCode()` —
another string concatenation with int, creating infinite recursion and
stack overflow.

**Fix**: Added `StringBuilder.toString()` returning `new String(value, 0, count)`.

**Test**: `StringConcat` in JvmTests (60/60 pass). Tests `"x=" + 42`,
negative ints, zero, `String.valueOf(int)`, and multiple appends.

**Affected code**: Any Java source using `"text" + intValue` or
`String.valueOf(int)`. The existing hardware test programs already used
character-by-character workarounds which remain valid but are no longer
strictly necessary.

### 3. Object Memory Not Zeroed on Allocation (FIXED)

JOP's `GC.newObject()` and `GC.newArray()` did not zero the allocated data
area. All fields — especially references — contained garbage from whatever
previously occupied that memory. A `field == null` check would fail on an
uninitialized reference field because it contained a non-null garbage value.

The original code had a TODO comment acknowledging this: `// TODO: memory
initialization is needed // either on scope creation+exit or in new`.

**Fix**: Added zeroing loops in `GC.newObject()` and `GC.newArray()` that
write 0 to each word of the newly allocated data area (inside the
synchronized block, after `allocPtr -= size`). This is eager zeroing —
cost is proportional to object size, bounded and predictable for real-time.

Explicit constructors in existing code (FAT32 classes, etc.) are now
redundant but harmless — they serve as documentation of the expected defaults.

### 5. String(StringBuffer) Infinite Recursion (FIXED)

`String(StringBuffer sb)` constructor called `sb.toString()` which calls
`new String(this)` — creating infinite recursion and stack overflow. Any code
path converting StringBuffer to String (e.g., `DecimalFormat.format()` returning
`.toString()`) would hang on JOP.

**Fix**: Changed `String(StringBuffer)` to directly copy chars with a for loop
instead of calling `sb.toString()`.

```java
// BEFORE (infinite recursion):
public String(StringBuffer sb) { this(sb.toString().toCharArray()); }

// AFTER:
public String(StringBuffer sb) {
    int len = sb.length();
    value = new char[len];
    for (int i = 0; i < len; i++)
        value[i] = sb.charAt(i);
}
```

**Test**: TextFormatStandalone (14 tests) and TextFormatTest in DoAll — all pass
on FPGA hardware.

### 6. multianewarray Mis-typed Reference Inner Arrays (FIXED)

`JVM.f_multianewarray` takes the inner arrays' type from a constant-pool entry
that holds a primitive type code (4–11) for a primitive element type but **0**
for a reference element type — there is no primitive code for that case. The 0
was passed straight to `f_newarray`, so the inner arrays of any `Object[][]`
were created with `OFF_TYPE = IS_OBJ`.

Two consequences. The collector dereferenced their length as a method table,
computing a size larger than the heap; and far worse, it never scanned their
elements as references, so anything reachable *only* through them was collected
as garbage.

That is the shape of `JVMHelp.ih = new Runnable[cpus][NUM_INTERRUPTS]`
(`JVMHelp.java:177`) — any handler registered via `addInterruptHandler` was
invisible to the GC. No crash had been observed only because nothing in the
test suite registers a handler, leaving the slots null.

**Fix**: `if (type == 0) type = 1;` (IS_REFARR) in `f_multianewarray`, matching
the convention `f_anewarray` already uses.

Primitive 2-D arrays were unaffected (`new int[7][5]` resolves correctly).

**Why the existing tests missed it**: DoAll's `MultiArray` and `ArrayMulti`
pass either way, because `OFF_TYPE` is never consulted by `iaload`/`iastore` —
only by the collector. The arrays work perfectly while being invisible-broken
to the GC.

**Test**: `MultiArrayGcTest` (`java/apps/Small`) retains an `int[7][5]` and a
`Cell[7][5]` across many minor GCs and a full mark-compact, then checks contents
*and* the collector's bad-handle censuses. Without the fix: 34 of 35 cells
corrupt, 13 bad-handle sightings. With it: all zero. Verified on both boards.

`addInterruptHandler` under GC is now covered too, by `IntHandlerGcTest` — it
registers a handler whose only reference is `ih[core][INT_NR]`, fires it via
`IO_SWINT` after many minor GCs and a full mark-compact, and checks its field
survived. Verified on EP4CGX150 and XC7A100T. With this fix reverted the run
dies during the churn phase, so the signal is a crash, not a FAIL line. See
[GC Stage 3 follow-ups](gc/stage3-followups.md).

### 4. Hardware Division-by-Zero Exception Not Catchable

JOP's `idiv`/`irem` bytecodes are implemented in Java (not microcode) because
the original microcode had a bug with `0x80000000` operands. The Java
implementation handles division correctly, but the division-by-zero path
fires a hardware exception asynchronously (after JPC has advanced past the
`idiv` bytecode). The exception unwinds at the wrong JPC and cannot find a
matching `catch (ArithmeticException)` handler.

**Workaround**: Check for zero before dividing.

```java
// May not be catchable on JOP:
try {
    int result = a / b;
} catch (ArithmeticException e) {
    // handler may not be reached
}

// CORRECT — explicit check:
if (b == 0) {
    // handle error
} else {
    int result = a / b;
}
```

See [Division by Zero Analysis](analysis/div-by-zero-analysis.md) for the full
investigation.

---

## Fixed Bugs — RTL / Hardware

### SD Card Controller (SdNative)

Three bugs found during hardware verification. All passed in simulation
because the testbench does not model real card timing.

| # | Bug | Fix | Found by |
|---|-----|-----|---|
| 27 | WAIT_CRC_STATUS sampled immediately without waiting for start bit (DAT0 low) — falsely reported CRC errors on successful writes | Wait for DAT0 low before counting CRC status bits, with timeout | SD Native Exerciser |
| 28 | `dataTimeoutCnt` not reset on `startWrite` (only on `startRead`) — stale timeout values on writes after reads | Added `dataTimeoutCnt := 0` to `startWrite` handler | Code review after #27 |
| 29 | WAIT_BUSY checked for DAT0 high without first confirming DAT0 went low — false exit on CRC status end bit, next command issued during card programming | Two-phase wait: first DAT0 low (busy start), then DAT0 high (busy end) | FAT32 filesystem testing |

See [DB_FPGA SD Card](peripherals/db-fpga-sd-card.md) for full details.

### VGA Text Controller (VgaText)

| # | Bug | Fix |
|---|-----|-----|
| — | Pixel pipeline `bitIndex` used pipelined `hCounter` instead of `hLookAhead` (hCounter+3), causing 3-pixel circular shift within each character cell | `bitIndex` now uses pipelined `hLookAhead` for correct 3-stage pipeline alignment |

### Ethernet (GMII)

| # | Bug | Fix |
|---|-----|-----|
| — | `e_rxd[5]` and `e_rxd[6]` pin assignments swapped vs reference design | Corrected pin assignments — 100% CRC failure resolved |
| — | SDC never declared `create_clock` for PHY clocks — entire PHY clock domains unconstrained | Added explicit `create_clock` for `e_rxc`, corrected PLL clock names |
| — | Mesochronous PLL RX clocking caused 14-34% packet loss at 1Gbps — random phase between PLL and PHY CDR-recovered clock corrupted data | Changed to source-synchronous e_rxc + `FAST_INPUT_REGISTER ON` for I/O block registers — 0% loss |

See [DB_FPGA Ethernet](peripherals/db-fpga-ethernet.md) for full details.

### TCP Stack

| # | Bug | Fix |
|---|-----|-----|
| — | `TCPConnection.poll()` called `sendSegment()` on every round-robin poll in SYN_RCVD/SYN_SENT — each call advanced `sndNext`, corrupting all subsequent sequence numbers | Guard in `poll()`: return early if `sndNext != sndUnack` in SYN_RCVD/SYN_SENT (SYN already sent, waiting for ACK) |
| — | `TCP.sendSegment()` only attached data in STATE_ESTABLISHED — echo data in CLOSE_WAIT was never sent | Extended data attachment condition to include STATE_CLOSE_WAIT (RFC 793 permits sending in CLOSE_WAIT) |
| — | Same SYN re-send bug class for FIN: `sendSegment()` set `flags |= FLAG_FIN` unconditionally when `flushAndClose` true, advancing `sndNext` on every poll in FIN_WAIT_1/CLOSING/LAST_ACK | Guard in `poll()`: return early if `sndNext != sndUnack` in FIN states (FIN already sent, waiting for ACK) |
| — | LAST_ACK returned early in `poll()` before retransmission check — lost final FIN never retransmitted | Moved LAST_ACK timeout to after retransmission check so FIN can be retransmitted |
| — | Pool exhaustion on rapid TCP connection cycling: 4 slots with 2s TIME_WAIT exhausted by >4 connections in 2 seconds | Recycle oldest TIME_WAIT connection when no free slots; recover listener in NetTest.java |
| — | Echo app `oStream.write()` return value ignored — bytes silently lost when output buffer full, causing ~300 byte loss on 10KB transfers | Added `pendingByte` tracking: save failed byte, retry before reading more from `iStream`; defer `close()` until all data echoed |
| — | `rcvWindow` only updated on data receive or zero-window check — ACKs carried stale (too small) window, slowing remote sender | Update `rcvWindow` from `iStream.getFreeBufferSpace()` at start of every `poll()` cycle |
| — | Window reopening required entire 4KB buffer empty (`getFreeBufferSpace() >= TCP_WINDOW`) — strict stop-and-wait at window level | Lower threshold to MSS (1460 bytes) for SWS avoidance per RFC 813 |
| — | FIN processed even when segment data only partially consumed (iStream nearly full) — remaining bytes lost, connection closed prematurely | Guard FIN: only process when `rcvNext == seqNr + dataLength` (all data consumed); retransmit delivers remaining data |

See [Networking](peripherals/networking.md) for full details.

### PLL Device Family

| # | Bug | Fix |
|---|-----|-----|
| — | `dram_pll.vhd` had `intended_device_family => "Cyclone II"` instead of `"Cyclone IV GX"` — c3 output stuck at GND | Changed to correct device family |

### SDR SDRAM

| # | Bug | Fix |
|---|-----|-----|
| — | SpinalHDL `SdramCtrl` placed DQ flip-flops in fabric instead of dedicated I/O cells — setup/hold violations invisible to STA | Replaced with Altera `altera_sdram_tri_controller` BlackBox |

See [SDR SDRAM GC Hang](gc/sdr-sdram-gc-hang.md) for the full investigation.

---

## Fixed Bugs — Pipeline and Microcode

29 bugs found during the SpinalHDL port. These are numbered in the
[Implementation Notes](architecture/implementation-notes.md). Key categories:

### Microcode Bugs (Latent in Original VHDL JOP)

| # | Bug | Impact |
|---|-----|---|
| 22 | `sys_exc` called `jjhp+6` (monitorState) instead of `jjhp+8` (except) — all hardware exceptions threw `IllegalMonitorStateException` | All NPE/ABE showed wrong exception type |
| 23 | `invokevirtual`/`invokeinterface` null check missing 2 delay slot NOPs — stack corruption on null invocation | Stack corruption |
| 25 | Method cache tag=0 false hit — evicted blocks matched addr=0 lookups (no tagValid bit) | Corrupt instruction fetch |

### Pipeline Bugs

| # | Bug | Impact |
|---|-----|---|
| 7 | `iastore` 3-operand timing — captured addrReg before stack shifted (IAST_WAIT state missing) | Static field corruption on array stores |
| 11 | `putfield` bcopd not ready — `stpf` microcode has no `opd` flag, index captured as 0 (PF_WAIT state missing) | All putfield writes went to field 0 |
| 20 | Branch type remapping missing for `if_acmpeq`, `if_acmpne`, `ifnull`, `ifnonnull` — tested wrong conditions | Branch condition evaluation wrong |
| 29 | `BytecodeFetchStage` jopd corruption during stack cache rotation stall — `jopd(7:0)` updated every cycle during 770+ cycle stalls | Processor hang on deep recursion (200+ levels) |

### Memory Controller Bugs

| # | Bug | Impact |
|---|-----|---|
| 8 | HANDLE_ACCESS missing I/O routing — HardwareObject field reads returned 0 | All `SysDevice` fields unreadable |
| 12 | BmbSdramCtrl32 burst data corruption — stale non-burst responses incremented burst word counter | Bytecode corruption in 4+ core SDRAM |
| 18 | Array cache no cross-core invalidation — `iastore` on Core X invisible to Core Y's A$ | 4-core + A$ failure |
| 19 | A$ fill interleaving — 4 single-word reads could be interleaved by arbiter | Core hang in 4+ core SDRAM |
| 21 | `System.arraycopy` doesn't invalidate A$ — `wrMem()` bypasses cache invalidation | Stale array data after copy |
| 26 | Hardware exception wrote to I/O 0x04 instead of 0x84 after I/O base change | Exceptions silently ignored |
| 30 | A$ `lineEnc` uses `hitTagVec` (handle-only) instead of `hitVec` (full match) — corrupted RAM address when multiple regions of same array cached | `Arrays.sort()` failure, data corruption on multi-region array access |

### Other Pipeline/I/O Bugs

| # | Bug | Impact |
|---|-----|---|
| 1 | BC fill write address off-by-one | Bytecode RAM corruption |
| 2 | iaload/caload +1 offset | Wrong array access results |
| 3 | JBC RAM read-write collision (SpinalHDL `readSync` dontCare) | Bytecode fetch corruption |
| 4 | Pipeline stall missing for high-latency memory | Incorrect memory results |
| 5 | UartCtrl RX one-cycle valid pulse (not buffered) | Dropped UART bytes |
| 9 | Sys missing IO_LOCK and IO_CPUCNT registers | GC deadlock, SMP failure |
| 10 | cpuStart NPE on core 1 boot (GC not ready) | SMP boot failure |
| 13 | SdramCtrl CKE gating creates response pipeline misalignment (simulation only) | Data corruption in sim |
| 17 | readAcache/readOcache flags persist across I/O reads — cache data returned instead of I/O | UART output 4x expansion |

### Debug Subsystem Bugs

| # | Bug | Impact |
|---|-----|---|
| 14 | DebugProtocol GOT_CORE used wrong byte for payload length | All debug commands with payload dropped |
| 15 | DebugController `packWord` bit extraction on narrow signals — elaboration crash | Debug controller won't build |
| 16 | `debugHalted` wired to CmpSync halt instead of debug halt input | Halted status always False |

---

## Fixed Bugs — Software / Java Runtime

| # | Bug | Fix |
|---|-----|-----|
| 24 | `GC.push()` dereferences null handle (address 0) during conservative stack scanning — triggers hardware NPE during GC | Added `if (ref == 0) return;` guard |
| 10 | `Startup.java` cpuStart array requires GC before GC is ready — NPE on multi-core boot | Removed array; direct main loop entry |
| 21 | `System.arraycopy` raw writes (`wrMem`) don't invalidate array cache — stale data | Added `Native.invalidate()` after copy |
| 25 | `sortListByAddress` was insertion sort, O(n²) — a major GC on the 256 MB board sorts ~33k handles and appeared to hang | Bottom-up linked-list merge sort, O(n log n), O(1) space |
| 26 | `gc()` bulk-zeroed the whole free region after compacting (zapSemi legacy) — 254 MB per collection on the 256 MB board, never completed | Removed; every allocation path already zeroes its own data. Major GC is now O(live), not O(heap) |
| 27 | A single hardware zero-fill request spanning the whole heap ran away and overwrote memory (the CPU then executed garbage) | `zeroMem` issues the fill in bounded 4 MB chunks — the size ZeroBench validates — and guards `from >= to` |
| 28 | Generational `copyAndSweepYoung` rejected legal **zero-size** objects (`size <= 0`); a class with no instance fields has size 0, which `compactAndSweep` has always allowed | Only `size < 0` is treated as corrupt. Previously every zero-field object became an unpromoted zombie holding a stale nursery pointer |
| 29 | `push()` / `pushYoung()` screened every candidate root against `mem_start + handle_cnt*HANDLE_SIZE` — three main-memory static reads plus an **`imul` bytecode**, which is a ~775-cycle microcode shift-add loop on any preset without an ICU multiplier. Halved the major-GC mark phase | Precompute `handleEnd` once in `init()`. Mark 915.8 -> 422.2 ms at 36k live, major pause -22%, minor pause 12.523 -> 11.757 ms |

Bugs 25–27 were pre-existing and affected the **classic** collector too — a full
mark-compact GC on the 256 MB DDR3 board had simply never been exercised, since
DoAll and GcStressTest never trigger one. Reproduced with
`USE_GENERATIONAL=false` before fixing.

Bug 29 is a reminder that on JOP a plain `*` is not free: `HANDLE_SIZE` is a
power of two and the same product is written `<< 3` twenty lines earlier in the
same file, but javac does not strength-reduce and `imul` is only hardware when a
preset asks for an ICU multiplier. Any per-object GC path doing arithmetic on
statics is worth reading with that in mind. It was found by instrumenting a
pause, not by reading the code — the code had looked fine for years.

### DecimalFormat Bugs (3 fixes for Phase 8)

Three bugs in the JOP-ported `DecimalFormat.java` found during FPGA testing:

| Bug | Symptom | Fix |
|-----|---|-----|
| Digit truncation | `format(42)` with pattern "0" returned "40" — `digitList.set(isNeg, number, maxIntDigits)` passed maxIntDigits=1, rounding 42 to 1 significant digit | Call 2-arg `set(isNeg, number)` without digit limit |
| Grouping leak | `format(1000000)` with pattern "0" returned "1,000,000" — `NumberFormat.groupingUsed` defaults to `true` and was never reset by `applyPattern()` | Added `setGroupingUsed(false)` in `applyPattern()` when pattern has no grouping separators |
| maxIntegerDigits too small | `applyPattern("0")` set maxIntegerDigits=1, truncating any number >9 | Changed to JDK default: `maxInt > 0 ? 309 : 0` (309 = max decimal digits for double) |

---

## Known Timing Issues

### Stack Cache Timing — Three Fixes Applied, One Systemic Issue Remaining

The 3-bank rotating stack cache (`useStackCache = true`) had three timing
violations on the EP4CGX150 at 80 MHz. All three have been addressed:

**1. Read path (FIXED)**: `ramRdaddrReg → bank address subtract (×3) →
readAsync (3 banks) → priority MUX → a register` had **-5.5 ns violation**.
Fixed by pipelining address translation: subtract + range check computed from
`rdaddr` (pre-register), registered, then only `readAsync + MUX` after.

**2. Write path (FIXED)**: `wrAddrDly → bank RAM write address` had **-1.7 ns
violation**. Same fix pattern: write address translation pre-computed from
`wraddr` and registered before bank RAM write port.

**3. DMA fill path (FIXED)**: `SDRAM za_valid → bankWrData` had **-2.2 ns
violation**. Added pipeline stage in StackCacheDma: BMB response data captured
into register one cycle, written to bank RAM the next cycle (3 new states:
FILL_WRITE, FILL_WRITE_BURST, FILL_WRITE_LAST).

**Remaining issue**: After all three fixes, the worst path is still
`za_valid → spillData` at **-2.7 ns**. This is the SDRAM controller response
assembly path (BmbSdramCtrl32 assembles two 16-bit SDRAM reads into one 32-bit
word combinationally). This is a systemic issue affecting any register capturing
SDRAM response data — also visible in Ethernet (`za_data → MacRxBuffer` at
-1.8 ns). Not stack-cache-specific; needs a pipeline register in
BmbSdramCtrl32's response path.

**Status**: the figures above are from the original EP4CGX150 work, on
`JopDbFpgaTopVerilog`, which was disabled pending a BmbSdramCtrl32 response
pipeline. Its successor preset, `ep4cgx150DbFull`, still runs without the stack
cache ([item 67](current-status.md#item-67)). The stack cache itself has passed
on hardware since 2026-10-02 — DoAll, `DeepAll` and `ThreadAll` on the Wukong's
DDR3 and SDR ([item 133](current-status.md#item-133)); whether this SDR response
path still misses on the EP4CGX150 has not been re-measured. The cache's own
timing margin is [item 163](current-status.md#item-163).

---

## Design Quirks (Not Bugs)

### SpinalHDL `+|` vs `+^`

`+|` is **saturating** add (clamps at max value). `+^` is **expanding** add
(result is 1 bit wider). Use `+^` when you need overflow-safe increment
(e.g., BMB length to byte count: `length +^ 1`). Using `+|` silently clamps
instead of expanding, which can be very hard to debug.

### SD Card Write Clock Speed

CMD24 (WRITE_BLOCK) fails at 20 MHz and 13.3 MHz on the QMTECH DB_FPGA
board due to signal integrity on SD card traces. Reads work at all speeds.
Use divider=3 (~10 MHz) for data transfers. See
[DB_FPGA SD Card](peripherals/db-fpga-sd-card.md).

### Hardware Division-by-Zero

The `idiv`/`irem` microcode implementation has a known bug with `0x80000000`
operands (noted in comments from 2004). Division is now implemented in Java
(`JVM.java`) which handles this case correctly. The microcode is commented
out in `asm/src/jvm.asm`. See [Division by Zero Analysis](analysis/div-by-zero-analysis.md).
