peteryates1/jop-spinalhdl/asm/src/jvm.asm

//
//  This file is a part of JOP, the Java Optimized Processor
//
//  Copyright (C) 2001-2008, Martin Schoeberl (martin@jopdesign.com)
//
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

//
//	jvm.asm
//
//		JVM for JOP3
//
//	2001-10-24	first version works with Jopa (prime is running)
//	2001-10-31	download of bc and ram from serial line (init)
//	2001-11-30	change mem acces to direct
//	2001-11-31	change to new 'class file' (in memory)
//	2001-12-05	new shift loop
//				nop !befor! stsp to write correct A value
//	2001-12-06	init sp
//	2001-12-07	only one jbr, decoding in bcfetch, i2c
//				fixed download size
//	2001-12-08	changes for ldp, stp instruction coding (8 bit intruction set!)
//	2001-12-10	automatic load of bc from external memory if prog.
//				does not fit in internal ram
//	2002-01-16	imul, idiv, irem, ishr
//	2002-02-25	areturn
//	2002-03-22	use the booth hw multiplier
//	2002-03-24	new JOP instructions shr, shl, ushr
//				bc only in extern memory, autoincrement jpc on stbc
//	2002-05-10	dup2
//	2002-07-24	added special bytecodes jopsys_*
//	2002-07-26	sys_rd/wr* from invokestatic removed
//				method table => single word const
//				call JVM.f() for not implemented byte codes
//	2002-07-27	changed len field of method struct to 10 bit
//	2002-08-02	changed max_words from 4096 to 8192
//	2002-10-08	use JVM.java for new
//	2002-10-11	call JVM.java for anewarray
//	2002-10-21	added if(non)null, if_acmp
//	2002-12-02	use new instruction wait for mem io
//	2003-08-13	merged jvm.asm and jvmflash.asm, use C preprocessor
//	2003-08-14	changed jbc write to a single 32 bit write (jbc does byte stuff)
//	2003-09-11	jopsys function for save and restore of stack in RtThread.schedule()
//	2003-09-13	invokespecial still like invokestatic
//		Ein offenes Problem! Aber private geht jetzt.
//				jjp and jjhp now point to first method
//	2003-09-15	cbsf-a-load/store for String class (all array elements are one word)
//	2003-10-06	changed max_words from 8192 to 16384, and flash address for Java
//				program at 0x80000
//	2003-10-23	long load_n, store_n, const_n, l2i added, ldc2_w error corretion
//	2003-10-27	invokeinterface
//	2004-01-18	ldc_w, pop2; float load, store and return; NOT tested!
//	2004-02-07	null pointer check in xaload/xastore, put/getfield and invoke,
//				array check, div/rem moved to JVM.java
//	2004-02-12	added instruction ld_opd_8u and ld_opd_16u
//	2004-03-12	added support for long: lreturn, lload, lstore
//	2004-04-06	first two instructions nop because of change in fetch.vhd
//				stjpc to nxt pipeline is now one longer (simpler mux for jbc rdaddr)
//	2004-05-24	jopsys_invoke to call main() from Startup.boot()
//	2004-10-08	single instruction to start mul (with a and b as operands)
//	2004-12-11	Enhancements in array access
//	2004-09-16	new bc read hardware (jvm_call.inc)
//	2005-01-10	changes for bytecode cache (jvm_call.inc)
//	2005-02-05	include version number
//	2005-02-18	switch for simulation version
//	2005-04-27	dup_x2
//	2005-05-12	remove nops after mem rd/wr start. the 'io' wr
//				generates the first bsy cycle (extension.vhd)
//	2005-05-30	wishbone interface (extension.vhd and wb_top.vhd)
//	2005-06-13	move newarray to JVM.java
//				use indirection (handle) for objects and arrays
//	2005-06-14	added multianewarray to JVM.java, version is 
//				again without handles
//	2005-06-20  use indirection, GC info in class struct
//	2005-07-28	fix missing indirection bug in thread stack move (int2ext and ext2int)
//	2005-08-13	moved null pointer check in xaload/store to check the handle!
//	2005-08-16	new file/download format with a size field in the first word
//	2005-08-27	added boot from USB interface (dspio board)
//	2005-12-01	IO devices are memory mapped - no more stioa, stiod, ldiod
//	2005-12-20	Changed dspio devices (USB) to SimpCon
//	2006-01-11	Generate HW exception and invoke JVMHelp.exception()
//	2006-01-12	Additional register for int. memory addressing (ar)
//				Instructions: star, stmi, ldmi
//				removed stioa, stiod, and ldiod
//	2006-01-20	add get/put field/static _ref/_long
//	2006-01-22	add type info for newarray (for long)
//	2006-01-23	use offset instead of cp index for get/putfield
//	2006-06-15	enhanced memory/cache interface (less cycles)
//	2006-11-04	move mtab pointer and array length to the handle
//				little optimization in array load/store
//	2006-12-27	add a special bytecode for Peter's single path
//				programming
//	2006-12-29	2K ROM, laload, lastore enabled again, dup2_x1, dup2_x2
//	2006-12-30	add instanceof to invoke JVM.java with constant on TOS
//	2007-03-17	new VHDL structure: jopcpu and more records (SimpCon)
//	2007-04-14	iaload and iastore in hardware (mem_sc.vhd)
//	2007-05-28	putfield_ref and putstatic_ref in JVM.java
//  2007-06-01  added multiprocessor startup (CP)
//				aastore in JVM.java
//	2007-06-17	new instruction jopsys_memcpy, jopsys_cond_move disabled
//				speed-up ext2int and int2ext
//	2007-08-31	non wrapping stack pointer, version at new address (62)
//				start stack at 64 instead of 128
//	2007-09-02	new instructions for hardware floating point operation with FPU
//	2007-11-21	stack tracing enabled, more space in stack.vhd
//				use 33 bit for the comparison (compare bug for diff > 2^31 corrected)
//	2007-11-22	update for JOP CMP version (by CP)
//	2007-12-03	new interrupt logic
//	2008-02-19	WP: field access in HW
//	2008-02-20	IO modules after the memory controller (mem_sc) to keep HWO working
//	2008-02-24	Changed license to GPL
//	2008-03-03	Added scratchpad RAM
//	2008-03-04	correct MUX selection
//	2008-03-11	Interrupt enable also in bcfetch (bug fix)
//	2008-06-11	Remove offtbl adjustment nops
//	2008-06-24	moncnt starts with 0, new CMP scheduler
//	2008-06-25	WP: bug fix in cache controller
//	2008-07-03	WP: Fixed null pointer handling of invokexxx instructions
//	2008-07-13	MS: mapping of Native.put/getfield to jopsys version
//	2008-08-21	MS: Corrected data out enable in SRAM/Flash interface
//	2008-12-10	MS: static field access uses index as address
//	... no comments ...
//	2009-06-17	MS: Enable conditional move again
//	2009-06-26	WP: fixed invokesuper
//	2009-08-23	MS: start with typed memory access for data caches
//	2009-08-24	MS: use I/O port for null pointer and array exception
//	2009-09-05	MS: new unconditional jmp instruction
//	2009-11-17	MS: put/getfield in mmu uses bytecode operand directly for the index
//	2009-11-23	MS: put/getstatic support in mmu (bc operand as address)
//	2009-11-28	MS: pufield one cycle longer for object cache hit detection, first
//				working object cache with a single entry
//	2010-04-24	Peter Hilber: use microcode version of aastore for RTTM
//	2010-06-18	WP: lcmp is now in microcode
//	2010-06-22	WP: added typed memory instructions (for split cache):
//				stmrac	load a constant
//				stmraf	load through fully assoc. cache
//				stmwdf	store through fully assoc. cache
//	2010-10-28	MS: cinval, atmstart, atmend added
//	2011-01-07	MS: O$ with multiple objects and fields
//
//		idiv, irem	WRONG when one operand is 0x80000000
//			but is now in JVM.java

//
//	'special' constant for a version number
//	gets written in RAM at position 64
//	update it when changing .asm, .inc or .vhd files
//
version		= 20130708

//
//	start of stack area in the on-chip RAM
//
stack_init	= 64

//
//	io address are negativ memory addresses
//
//	BmbSys at 0xF0 (bipush -16..-1)
//	Boot device at 0xEE (bipush -18..-17)
//
io_cnt		=	-16
io_wd		=	-13
io_exc		=	-12
io_int_ena	=	-16
io_status	=	-18
io_uart		=	-17

exc_np		=	2
exc_ab		=	3
exc_mon     =   5

io_us_cnt	=	-15
io_lock = -11
io_cpu_id = -10
io_signal = -9

// USB boot aliases — same boot device address (0xEE-0xEF)
usb_status		=	-18
usb_data		=	-17

ua_rdrf		= 	2
ua_tdre		= 	1

// Serial download handshake bytes
rdy_byte	=	170		// 0xAA: FPGA sends "memory ready"
rdy_ack		=	85		// 0x55: Host acknowledges, start download
// Handshake timeout: ~500 ms between ready byte resends. The gap matters as
// much as the byte: it is what gives the receiver an idle line to frame on.
rdy_timeout_us	=	500000
// Sign bit, for testing the result of a wrap-safe 32-bit timestamp compare.
// Same value as 0x80000000, which is already in the ldi constant pool.
sign_mask	=	-2147483648

// BmbDiv I/O constants removed — idiv/irem now handled by IntegerComputeUnit via sthw

// Legacy FPU I/O constants (BmbFpu has been removed — FloatComputeUnit replaces it).
// These constants are retained for the _sw float handlers below, which remain in the
// superset ROM but are never selected by resolveJumpTable (no code path reaches them).
// The BmbFpu I/O peripheral (0xF0-0xF3) and its fadd_sw/fsub_sw/fmul_sw/fdiv_sw
// handlers were removed 2026-08-05. They had outlived the hardware by some time
// and were still selectable: "fadd = mc" passed validation, found an alternate,
// and wrote to addresses that no longer decoded. Software float for these four
// is the Java trap (SoftFloat32), or the FCU.

#ifdef FLASH
// Config flash SPI I/O registers — boot device at 0xEE-0xEF
// Same address as UART (mutually exclusive: serial boot OR flash boot)
io_cf_status	= -18
io_cf_data		= -17
#endif


//
//	first vars for start
//	keep order! these vars are accessed from Java progs.
//
	mp		?		// pointer to method struct
	cp		?		// pointer to constants
	heap	?		// start of heap

	jjp		?		// pointer to meth. table of Java JVM functions
	jjhp	?		// pointer to meth. table of Java JVM help functions

	lockcnt	?		// counter for lock

//
//	local vars
//
a			?
b			?
c			?
d			?
e			?
f			?

addr		?			// address used for bc load from flash
						// only in jvmflash.asm

//
//	JVM starts here.
//
jvm_start:
//	new fetch does NOT reset address of ROM =>
//		it starts with pc+1
			nop			// this gets never executed
			nop			// for shure during reset (perhaps two times executed)

			ldi	stack_init
			nop			// written in adr/read stage!
			stsp		// someting strange in stack.vhd A->B !!!

// TEST read after write

// ldi 1
// ldi 2
// ldi 3
// add
// add
// pop

//////////
// test mem interface
//
//			ldi 15
//
//			// this sequence takes 6 cycles with ram_cnt=3
//			stmra				// start read ext. mem
//			wait				// one for fetch
//			wait				// one for decode
//			ldmrd		 		// read ext. mem
//
//			ldi	32				// write data
//			ldi	16				// write address
//
//			// this sequence takes 6 cycles with ram_cnt=3
//			stmwa				// write ext. mem address
//			stmwd				// write ext. mem data
//			wait
//			wait
//
//			ldi 7
//			stmra				// start read ext. mem
//			wait				// one for fetch
//			wait				// one for decode
//			ldmrd		 		// read ext. mem
//
//			pop
//			pop
/////////
// test iaload
//			ldi	1
//			ldi 5
//			stald
//			pop
//			wait
//			wait
//			ldmrd
//			pop
//
//			nop
//			nop
//			nop
// test iastore
//			ldi 1
//			ldi 5
//			ldi 3
//			stast
//			pop
//			pop
//			wait
//			wait
/////////


// Checks whether the cpu_id != 0, waits and jumps then further down to the invoke of the boot!!!

			ldi io_cpu_id
			stmra
			wait
			wait
			ldmrd
			nop
			bz cpu0_load
			nop
			nop
			
cpux_loop:
			ldi io_signal
			stmra
			wait
			wait
			ldmrd
			nop
			bz cpux_loop
			nop
			nop
			ldi io_signal
			stmra
			wait
			wait
			ldmrd
			nop
// A ZERO HERE MEANS KEEP WAITING, NOT "BECOME CORE 0" — status item 133.
//
// This branch used to target cpu0_load, the SERIAL DOWNLOAD HANDSHAKE: it sends
// 0xAA and polls for the host's ACK, forever, with no exit. So a core above zero
// that read io_signal as nonzero once and as zero the second time was permanently
// hijacked into the downloader and never reached main(). On the Wukong SMP +
// stack-cache build that happened in 7 to 12 runs of every 21 to 31, and the probe
// caught core 1 executing rdy_poll before core 0 had even written the signal.
//
// Re-reading a held level is a reasonable debounce; the fault was in what the
// second sample DID with a zero. Sending it back to the spin makes the sequence
// "two consecutive nonzero reads to proceed", strictly stronger than the single
// read it replaced — and nothing in the release protocol wants the old target:
// no design decides a core should become the loader because a signal it already
// saw went away.
			bz cpux_loop
			nop
			nop

			jmp	cpux_boot
			nop
			nop

cpu0_load:
#ifdef SIMULATION
//
//	Main memory (ram) is loaded by the simulation.
//	Just set the heap pointer from the size field.
//
			ldi	0
			stmra
			wait
			wait
			ldmrd
			stm	heap
#else
//
//
//	download n words in extern ram (high byte first!)
//	Variable b accumulates XOR checksum of all words.
//	After download, checksum is sent back (4 bytes MSB-first).
//
			ldi	0
			stm	heap		// word counter (ram address)
			ldi	0
			stm	b			// XOR checksum = 0

#ifdef SERIAL
//
// Ready handshake (serial download only).
//
// After FPGA programming, DDR3 MIG calibration holds JOP in reset
// for several seconds. The host can't know when JOP is ready.
// Handshake: FPGA sends 0xAA periodically, host waits for 0xAA
// then sends 0x55. Both sides retry with timeouts.
//
// TX FIFO is guaranteed empty at boot, so no TX-ready check needed.
// Resend deadline on stack while polling (see rdy_send).
// Stack discipline: rdy_send enters/exits with empty stack.
//
// bz/bnz POP THEIR OPERAND -- status item 169. This loader used to pop the
// tested value a second time after both of rdy_got_byte's branches and both
// of ser_wait_ack's, and left three checksum bytes behind in ser_checksum.
// Every byte the handshake received, stray or the 0x55 itself, took one word
// off an empty stack, and Java started its stack that far down, on top of
// the constant table: ten stray bytes put a checksum byte over i2c's 65535.
// SerialBootStackTest holds SP at stack_init from the first 0xAA to cpux_boot.
//

rdy_send:
			// Send ready byte (0xAA) — TX FIFO empty at boot/retry
			ldi	rdy_byte
			ldi	io_uart
			stmwa
			stmwd
			wait
			wait

			// Resend deadline on stack: now + rdy_timeout_us.
			// This MUST be a real time interval, not an instruction count.
			// An instruction count scales with clock but not with baud, so on
			// a slow link it outruns the transmitter, the 16-deep TX FIFO
			// never drains, and the 0xAA frames go out back-to-back with no
			// idle time. A gapless 0xAA stream has three stable false framing
			// locks (0x35, 0x4D, 0x53) that a receiver cannot escape without
			// an idle gap — the A-E115FB at 115200 sat in the 0x4D lock
			// forever. The idle gap between ready bytes is what lets the
			// receiver frame correctly, so it has to be timed in microseconds.
			ldi	io_us_cnt
			stmra
			wait
			wait
			ldmrd
			ldi	rdy_timeout_us
			add

			// Poll UART RX for host ACK (0x55)
rdy_poll:
			ldi	io_status
			stmra
			ldi	ua_rdrf
			wait
			wait
			ldmrd
			and
			nop
			bnz	rdy_got_byte	// got a byte — check if ACK
			nop
			nop

			// No byte — has the deadline passed? Keep the deadline on the
			// stack and test the sign of (deadline - now). Wrap-safe: the
			// difference is a small countdown even when the 32-bit
			// microsecond counter wraps (every ~71 minutes).
			dup
			ldi	io_us_cnt
			stmra
			wait
			wait
			ldmrd
			sub					// deadline - now  (sub is NOS - TOS)
			ldi	sign_mask
			and
			nop
			bz	rdy_poll		// still positive — not expired yet
			nop
			nop
			pop					// deadline passed
			jmp	rdy_send		// timeout → resend 0xAA
			nop
			nop

rdy_got_byte:
			pop					// discard resend deadline
			ldi	io_uart
			stmra
			wait
			wait
			ldmrd

			// Is it 0x55 (ACK)? bz pops the XOR result, leaving the stack
			// empty on both paths.
			ldi	rdy_ack
			xor
			nop
			bz	rdy_done
			nop
			nop
			jmp	rdy_send		// not ACK: resend
			nop
			nop

rdy_done:

#endif // SERIAL

#ifdef FLASH
//
//	SPI flash setup: assert CS, send READ_DATA (0x03) + 3 address bytes
//	Flash offset is set via FLASH_ADDR_B2 preprocessor define:
//	  0x80 = 0x800000 (8 MB, Cyclone IV W25Q128 16 MB flash)
//	  0x24 = 0x240000 (2.25 MB, Artix-7 SST26VF032B 4 MB flash)
//
#ifndef FLASH_ADDR_B2
#define FLASH_ADDR_B2 128
#endif
// Clock divider is set by hardware init (cfgFlashClkDivInit per target).

// Flash reset sequence: RSTQIO + RSTEN + RST + wait
// On Artix-7 with diagnostic FSM, this is already handled in board-clock domain.
// Skip with SKIP_FLASH_RESET to test BmbConfigFlash READ_DATA in isolation.
#ifndef SKIP_FLASH_RESET

// RSTQIO (0xFF) — exit QPI mode if flash was left in it.
// Only needed for QPI-capable flash (e.g. SST26VF032B) that might be stuck
// in QPI mode.  W25Q128 on Cyclone IV has no QPI mode, so this is skipped
// by default.  Define FLASH_RSTQIO to enable if needed.
#ifdef FLASH_RSTQIO

// Assert CS for RSTQIO
			ldi	1
			ldi	io_cf_status
			stmwa
			stmwd
			wait
			wait

// Send 0xFF (RSTQIO in QPI mode, NOP in SPI mode)
			ldi	-1
			ldi	io_cf_data
			stmwa
			stmwd
			wait
			wait
cf_poll_rstqio:
			ldi	io_cf_status
			stmra
			ldi	1
			wait
			wait
			ldmrd
			and
			nop
			bnz	cf_poll_rstqio
			nop
			nop

// Deassert CS after RSTQIO
			ldi	0
			ldi	io_cf_status
			stmwa
			stmwd
			wait
			wait
#endif // FLASH_RSTQIO

// Software reset: RSTEN (0x66) + RST (0x99)
// Required on Artix-7: JTAG reprogramming can leave flash in undefined state.
// Harmless on all JEDEC-compliant SPI flash (W25Q128, SST26, etc.)

// Assert CS for RSTEN
			ldi	1
			ldi	io_cf_status
			stmwa
			stmwd
			wait
			wait

// Send RSTEN (0x66 = 102)
			ldi	102
			ldi	io_cf_data
			stmwa
			stmwd
			wait
			wait
cf_poll_rsten:
			ldi	io_cf_status
			stmra
			ldi	1
			wait
			wait
			ldmrd
			and
			nop
			bnz	cf_poll_rsten
			nop
			nop

// Deassert CS after RSTEN
			ldi	0
			ldi	io_cf_status
			stmwa
			stmwd
			wait
			wait

// Assert CS for RST
			ldi	1
			ldi	io_cf_status
			stmwa
			stmwd
			wait
			wait

// Send RST (0x99 = 153)
			ldi	153
			ldi	io_cf_data
			stmwa
			stmwd
			wait
			wait
cf_poll_rst:
			ldi	io_cf_status
			stmra
			ldi	1
			wait
			wait
			ldmrd
			and
			nop
			bnz	cf_poll_rst
			nop
			nop

// Deassert CS after RST
			ldi	0
			ldi	io_cf_status
			stmwa
			stmwd
			wait
			wait

// Wait for flash reset to complete (SST26 tRST max = 100 us)
// 1536 iterations, 7 cycles each = 10752 cycles = ~108 us at 100 MHz
			ldi	6
			ldi	8
			shl
cf_rst_wait:
			ldi	1
			sub
			dup
			nop
			bnz	cf_rst_wait
			nop
			nop
			pop

#endif // SKIP_FLASH_RESET

// Wait for flash ready (status bit 1 = SPI mux switched to BmbConfigFlash).
// On Artix-7, the board-clock diagnostic FSM resets the flash and reads
// JEDEC ID + data before handing SPI pins to BmbConfigFlash.  The microcode
// must not start flash I/O until the mux has switched.
cf_poll_ready:
			ldi	io_cf_status
			stmra
			ldi	2
			wait
			wait
			ldmrd
			and
			nop
			bz	cf_poll_ready
			nop
			nop

// Assert CS (write 1 to control register, bit0 = csAssert)
			ldi	1
			ldi	io_cf_status
			stmwa
			stmwd
			wait
			wait

// Send READ_DATA command (0x03)
			ldi	3
			ldi	io_cf_data
			stmwa
			stmwd
			wait
			wait
cf_poll_cmd:
			ldi	io_cf_status
			stmra
			ldi	1
			wait
			wait
			ldmrd
			and
			nop
			bnz	cf_poll_cmd
			nop
			nop

// Send address byte 2 (MSB of flash offset)
			ldi	FLASH_ADDR_B2
			ldi	io_cf_data
			stmwa
			stmwd
			wait
			wait
cf_poll_a2:
			ldi	io_cf_status
			stmra
			ldi	1
			wait
			wait
			ldmrd
			and
			nop
			bnz	cf_poll_a2
			nop
			nop

// Send address byte 1 (0x00)
			ldi	0
			ldi	io_cf_data
			stmwa
			stmwd
			wait
			wait
cf_poll_a1:
			ldi	io_cf_status
			stmra
			ldi	1
			wait
			wait
			ldmrd
			and
			nop
			bnz	cf_poll_a1
			nop
			nop

// Send address byte 0 (LSB = 0x00)
			ldi	0
			ldi	io_cf_data
			stmwa
			stmwd
			wait
			wait
cf_poll_a0:
			ldi	io_cf_status
			stmra
			ldi	1
			wait
			wait
			ldmrd
			and
			nop
			bnz	cf_poll_a0
			nop
			nop

// SPI flash now streams sequential data bytes on each dummy read
#endif

//
//	Variable a will be the length set by the first word.
//	Variable c is used to assemble the word from the
//	serial transmitted bytes.
//

xram_loop:
			ldi	4			// byte counter
ser4:
#ifdef FLASH
// ************** SPI flash byte read via BmbConfigFlash *********************
// Send dummy 0xFF to clock in one data byte
			ldi	-1
			ldi	io_cf_data
			stmwa
			stmwd
			wait
			wait
cf_poll_byte:
			ldi	io_cf_status
			stmra
			ldi	1
			wait
			wait
			ldmrd
			and
			nop
			bnz	cf_poll_byte
			nop
			nop
// Read received byte
			ldi	io_cf_data
			stmra
			wait
			wait
			ldmrd
// ************** end SPI flash byte read *********************
#else
#ifdef USB
// ************** change for load from USB interface *********************
			ldi	usb_status		// wait for byte from USB
			stmra
			ldi	ua_rdrf
			wait
			wait
			ldmrd
			and
			nop
			bz	ser4
			nop
			nop

			ldi	usb_data		// read byte from USB
			stmra
			wait
			wait
			ldmrd

//	We don't do the byte handshake on the USB connection.
//	The FTDI chip handles flow control.
//
//wait_usb_tx:
//			ldi	usb_status		// wait for TX-buffer ready
//			stmra
//			ldi	ua_tdre
//			wait
//			wait
//			ldmrd
//			and
//			nop
//			bz	wait_usb_tx
//			nop
//			nop
//
//			ldi	usb_data		// write byte to USB
//			stmwa
//			dup					// echo for down.c, 'handshake'
//			stmwd		
//			wait
//			wait

// ************** end change for load from USB interface *********************
#else
// ************** change for load from serial line *********************
			ldi	io_status		// wait for byte from uart
			stmra
			ldi	ua_rdrf
			wait
			wait
			ldmrd
			and
			nop
			bz	ser4
			nop
			nop

			ldi	io_uart			// read byte from uart
			stmra
			wait
			wait
			ldmrd
// No echo — host streams without waiting. Checksum sent after all words.
// ************** end change for load from serial line *********************
#endif
#endif

			ldm	c			// mem word
			ldi	8
			shl

			or				// set low byte with uart data
			stm c			// store 

			ldi	1			// decrement byte counter
			sub
			dup
			nop
			bnz	ser4
			nop
			nop
			pop				// remove byte counter

			ldm	heap
			stmwa				// write ext. mem address
			ldm	c
			stmwd				// write ext. mem data
			wait
			wait

#ifndef FLASH
// Accumulate XOR checksum: b = b ^ c (serial download only)
			ldm	b
			ldm	c
			xor
			stm	b
#endif

//****
// could be changed to load mp from ram and not from the first word!!!
//	cleaner
//****
			ldm	heap
			nop
			bnz	cnt_not_0
			nop
			nop
			ldm	c				// first data word is the size of the application
			stm a

cnt_not_0:
			ldm	heap		// mem counter
			ldi	1			// increment
			add
			stm heap

not_first:
			ldm	heap
			ldm	a
			xor
			nop
#ifdef FLASH
			bz	cf_done
#else
			bz	ser_checksum
#endif
			nop
			nop

			jmp	xram_loop
			nop
			nop

#ifndef FLASH
//
// Serial download complete — send XOR checksum (4 bytes MSB-first),
// then wait for ACK (0x00) or NACK (0xFF) from host.
// On NACK, reset and retry the entire download.
//
ser_checksum:
// Each byte is computed AFTER its TX-ready loop, straight into stmwd, so the
// stack is empty between bytes (bytes 3-1 used to be computed before the loop
// as well, and those copies were left on the stack -- item 169).
// Send checksum byte 3 (MSB)
ser_ck_tx3:
			ldi	io_status
			stmra
			ldi	ua_tdre
			wait
			wait
			ldmrd
			and
			nop
			bz	ser_ck_tx3
			nop
			nop
			ldi	io_uart
			stmwa
			ldm	b
			ldi	24
			shr
			ldi	255
			and
			stmwd
			wait
			wait

// Send checksum byte 2
ser_ck_tx2:
			ldi	io_status
			stmra
			ldi	ua_tdre
			wait
			wait
			ldmrd
			and
			nop
			bz	ser_ck_tx2
			nop
			nop
			ldi	io_uart
			stmwa
			ldm	b
			ldi	16
			shr
			ldi	255
			and
			stmwd
			wait
			wait

// Send checksum byte 1
ser_ck_tx1:
			ldi	io_status
			stmra
			ldi	ua_tdre
			wait
			wait
			ldmrd
			and
			nop
			bz	ser_ck_tx1
			nop
			nop
			ldi	io_uart
			stmwa
			ldm	b
			ldi	8
			shr
			ldi	255
			and
			stmwd
			wait
			wait

// Send checksum byte 0 (LSB)
ser_ck_tx0:
			ldi	io_status
			stmra
			ldi	ua_tdre
			wait
			wait
			ldmrd
			and
			nop
			bz	ser_ck_tx0
			nop
			nop
			ldi	io_uart
			stmwa
			ldm	b
			ldi	255
			and
			stmwd
			wait
			wait

// Wait for ACK/NACK byte from host
ser_wait_ack:
			ldi	io_status
			stmra
			ldi	ua_rdrf
			wait
			wait
			ldmrd
			and
			nop
			bz	ser_wait_ack
			nop
			nop

			ldi	io_uart
			stmra
			wait
			wait
			ldmrd			// ACK byte on stack

			nop
			bnz	ser_retry	// non-zero = NACK, retry (bnz pops the byte)
			nop
			nop
			jmp	cpux_boot	// ACK (0x00) = success, boot
			nop
			nop

ser_retry:
			ldi	0
			stm	heap		// reset word counter
			ldi	0
			stm	b			// reset checksum
			jmp	rdy_send	// re-handshake before retry
			nop
			nop
#endif

#ifdef FLASH
cf_done:
// Deassert CS (write 0 to control register)
			ldi	0
			ldi	io_cf_status
			stmwa
			stmwd
			wait
			wait
// Fall through to cpux_boot
#endif

#endif // SIMULATION


// jump to here with cpu_id other than 0

cpux_boot:
//
//	Load mp from the second word in ram.
//
			ldi	1
			stmra
			wait
			wait
			ldmrd
			stm	mp
//
//	ram is now loaded, heap points to free ram
//	load pointer to main struct and invoke
//
			ldm	mp			// pointer to 'special' pointer list
			ldi	1
			add
			dup

			stmra				// read jjp
			wait
			wait
			ldmrd			 	// read ext. mem
			stm	jjp

			ldi	1
			add
			stmra				// read jjhp
			wait
			wait
			ldmrd			 	// read ext. mem
			stm	jjhp

			ldm	mp			// pointer to pointer to main meth. struct
			jmp	invoke_main	// simulate invokestatic
			nop
			nop

///////////////////////////////////////////////////////////////////////////
//
//	begin of jvm code
//
///////////////////////////////////////////////////////////////////////////

///////////////////////////////////////////////////////////////////////////
//
//	some special instructions that use invoke
//
///////////////////////////////////////////////////////////////////////////

//
//	call com.jopdesign.sys.JMV.fxxx(int constant) for not implemented  byte codes.
//		... JVM in Java!
//		with constant on stack
//

new:
anewarray:
checkcast:
instanceof:

//
//	find address for JVM function
//
			ldjpc
			ldi	1
			sub
			stjpc				// get last byte code
			nop					// ???
			nop					// one more now (2004-04-06) ?
			ldm	jjp
			nop	opd
			ld_opd_8u
			ldi	255
			and
			dup
			add					// *2
			add					// jjp+2*bc
			stm	a				// save

//
//	get constant
//
			ldm	cp opd
			nop	opd
			ld_opd_16u
			add

			stmrac				// read ext. mem, mem_bsy comes one cycle later
			wait
			wait
			ldmrd		 		// read ext. mem

			ldm	a				// restore mp

//
//	invoke JVM.fxxx(int cons)
//
			jmp	invoke
			nop
			nop


newarray:
			nop opd
			ld_opd_8u
			stm a
			ldjpc
			ldi	2
			sub
			stjpc				// get last byte code
			nop					// ???
			nop					// one more now (2004-04-06) ?
			ldm	a
			ldm	jjp
			nop	opd
			ld_opd_8u
			ldi	255 
			and opd				// remove type info
			dup
			add					// *2
			add					// jjp+2*bc

// invoke JVM.fxxx();
			jmp	invoke			// simulate invokestatic with ptr to meth. str. on stack
			nop
			nop

//
//	call com.jopdesign.sys.JMV.fxxx(int index) for not implemented  byte codes.
//		... JVM in Java!
//		with index into constant pool on stack
//


putfield_ref:
#ifdef HW_PUTFIELD_REF
//
// Use hardware support for scope checks
//
			stpfr 			// start putfield index is taken from the BC operand
			nop	opd
			nop	opd			// get rid of second stack location
			wait
			wait
			pop nxt
#else
//
// Use the write barrier in JVM.java version of putfield_ref
//
//	find address for JVM function
//
			ldjpc
			ldi	1
			sub
			stjpc				// get last byte code
			nop					// ???
			nop					// one more now (2004-04-06) ?
			ldm	jjp
			nop	opd
			ld_opd_8u
			ldi	255
			and
			dup
			add					// *2
			add					// jjp+2*bc
			stm	a				// save

//
//	get index
//
			nop	opd
			nop	opd
			ld_opd_16u

			ldm	a				// restore mp

//
//	invoke JVM.fxxx(int index)
//
			jmp	invoke
			nop
			nop
//
//	this is an interrupt, (bytecode 0xf0)
//	call com.jopdesign.sys.JVMHelp.interrupt()	(
//		oder gleich eine f aus JVMHelp ????
//		... JVM in Java!
//
#endif

putstatic_ref:
#ifdef HW_PUTSTATIC_REF
//
//
			stpsr opd	// MMU uses bc opd
			nop opd
			wait
			wait
			nop nxt

#else
//	find address for JVM function
//
			ldjpc
			ldi	1
			sub
			stjpc				// get last byte code
			nop					// ???
			nop					// one more now (2004-04-06) ?
			ldm	jjp
			nop	opd
			ld_opd_8u
			ldi	255
			and
			dup
			add					// *2
			add					// jjp+2*bc
			stm	a				// save

//
//	get index
//
			nop	opd
			nop	opd
			ld_opd_16u

			ldm	a				// restore mp

//
//	invoke JVM.fxxx(int index)
//
			jmp	invoke
			nop
			nop
//
//	this is an interrupt, (bytecode 0xf0)
//	call com.jopdesign.sys.JVMHelp.interrupt()	(
//		oder gleich eine f aus JVMHelp ????
//		... JVM in Java!
//
sys_int:
			ldjpc				// correct wrong increment on jpc
			ldi	1				//    could also be done in bcfetch.vhd
			sub					//    but this is simpler :-)
			stjpc
			ldm	jjhp			// interrupt() is at offset 0
								// jjhp points in method table to first
								// method after methods inherited from Object

			jmp	invoke			// simulate invokestatic with ptr to meth. str. on stack
			nop
			nop
#endif

//
//	this is an exception, (bytecode 0xf1)
//	call com.jopdesign.sys.JVMHelp.except()	(
//
sys_exc:
			// The jpc correction that used to live here is now done in hardware
			// (BytecodeFetchStage: the increment is SUPPRESSED on the fetch that
			// takes an exception) — which is the option the original comment
			// here already suggested, "could also be done in bcfetch.vhd".
			//
			// It had to move. `ldjpc; ldi 1; sub; stjpc` computes the resume
			// address THROUGH THE OPERAND STACK, and the stack is not in a
			// defined state when an exception is taken mid-bytecode: the aborted
			// iaload had popped its operands, so a/b were refilled from
			// never-written stack RAM (0x12345678, the mem_ram.dat fill
			// pattern). The subtraction computed 0x1ec - 0x12345678 and stjpc
			// wrote its low 12 bits, landing jpc 2548 bytes outside the method.
			//
			// Kept as four nops ON PURPOSE: the instruction count fixes every
			// microcode address after this point, and the jump table is
			// generated from them. Reclaim them only with a full regeneration.
			nop
			nop
			nop
			nop
			ldm	jjhp			// interrupt() is at offset 0
								// jjhp points to first method after
								// Object methods (<init>,hashCode,equals,toString)
			ldi	8				// except() is the 5th method (index 4 * 2 words)
			add


			jmp	invoke			// simulate invokestatic with ptr to meth. str. on stack
			nop
			nop

//
//	call com.jopdesign.sys.JMV.fxxx() for not implemented  byte codes.
//		... JVM in Java!
//
sys_noim_entry:
sys_noim:
			ldjpc
			ldi	1
			sub
			stjpc				// get last byte code
			nop					// ???
			nop					// one more now (2004-04-06) ?
			ldm	jjp
			nop	opd
			ld_opd_8u
			ldi	255
			and
			dup
			add					// *2
			add					// jjp+2*bc

			jmp	invoke			// simulate invokestatic with ptr to meth. str. on stack
			nop
			nop

// ==========================================================================
// Hardware integer operations via ComputeUnitTop (ICU)
// Uses new decoupled interface: stop (push operand), sthw N (start), ldop (get result)
// Division by zero: falls through to Java for ArithmeticException.
// ==========================================================================
idiv:
			// Stack: ..., dividend, divisor (TOS=divisor)
			dup					// Stack: ..., dividend, divisor, divisor
			bnz idiv_nonzero	// bnz pops condition
			nop					// delay slot
			nop					// delay slot
			// divisor == 0: bnz popped dup, stack = ..., dividend, divisor
			// sys_noim expects original operands on stack
			jmp sys_noim_entry	// dispatch to Java f_idiv (handles ArithmeticException)
			nop
			nop
idiv_nonzero:
			// bnz already popped the dup copy
			// Stack: ..., dividend, divisor
			stop				// pop divisor -> CU opStack[0]
			stop				// pop dividend -> CU opStack[1]
			sthw 1				// start ICU idiv (unit=00, op=1)
			wait				// 1st wait: sets pcwait
			wait				// 2nd wait: pcwait+bsy → stall until CU done
			ldop nxt			// push quotient

irem:
			// Stack: ..., dividend, divisor (TOS=divisor)
			dup					// Stack: ..., dividend, divisor, divisor
			bnz irem_nonzero	// bnz pops condition
			nop					// delay slot
			nop					// delay slot
			// divisor == 0: bnz popped dup, stack = ..., dividend, divisor
			jmp sys_noim_entry	// dispatch to Java f_irem (handles ArithmeticException)
			nop
			nop
irem_nonzero:
			// bnz already popped the dup copy
			// Stack: ..., dividend, divisor
			stop				// pop divisor -> CU opStack[0]
			stop				// pop dividend -> CU opStack[1]
			sthw 2				// start ICU irem (unit=00, op=2)
			wait				// 1st wait: sets pcwait
			wait				// 2nd wait: pcwait+bsy → stall until CU done
			ldop nxt			// push remainder

//
//	invoke and return functions
//
#include "jvm_call.inc"

///////////////////////////////////////////////////////////////////////////
//
//	begin of simple bytecodes
//
///////////////////////////////////////////////////////////////////////////

nop:		nop nxt

iconst_m1:	ldi -1 nxt
fconst_0:
aconst_null:
iconst_0:	ldi 0 nxt
iconst_1:	ldi 1 nxt
iconst_2:	ldi 2 nxt
iconst_3:	ldi 3 nxt
iconst_4:	ldi 4 nxt
iconst_5:	ldi 5 nxt

bipush:		nop opd
			ld_opd_8s nxt

sipush:		nop opd
			nop opd
			ld_opd_16s nxt

ldc:		ldm	cp opd
			ld_opd_8u
			add
			stmrac				// read ext. mem, mem_bsy comes one cycle later
			wait
			wait
			ldmrd		 nxt	// read ext. mem

ldc_w:	
			ldm	cp opd
			nop	opd
			ld_opd_16u
			add
			stmrac				// read ext. mem, mem_bsy comes one cycle later
			wait
			wait
			ldmrd		 nxt	// read ext. mem

aload:
fload:
iload:		nop opd
			ld nxt

aload_0:
fload_0:
iload_0:	ld0 nxt
aload_1:
fload_1:
iload_1:	ld1 nxt
aload_2:
fload_2:
iload_2:	ld2 nxt
aload_3:
fload_3:
iload_3:	ld3 nxt


astore:
fstore:
istore:		nop opd
			st nxt

astore_0:
fstore_0:
istore_0:	st0 nxt
astore_1:
fstore_1:
istore_1:	st1 nxt
astore_2:
fstore_2:
istore_2:	st2 nxt
astore_3:
fstore_3:
istore_3:	st3 nxt


pop:		pop nxt
pop2:		pop
			pop	nxt
dup:		dup nxt
dup_x1:		stm	a
			stm	b
			ldm a
			ldm b
			ldm a nxt
dup_x2:		stm	a
			stm	b
			stm	c
			ldm a
			ldm c
			ldm b
			ldm a nxt
dup2:		stm	a
			stm	b
			ldm b
			ldm a
			ldm b
			ldm a nxt
dup2_x1:	stm	a
			stm	b
			stm	c
			ldm b
			ldm a
			ldm c
			ldm b
			ldm a nxt
dup2_x2:	stm	a
			stm	b
			stm	c
			stm	d
			ldm b
			ldm a
			ldm d
			ldm c
			ldm b
			ldm a nxt
swap:		stm	a		// not tested, javac does not generate it!
			stm	b
			ldm	a
			ldm	b nxt

iadd:		add nxt
isub:		sub nxt

ineg:
			ldi -1
			xor
			ldi 1
			add nxt

iand:		and nxt
ior:		or nxt
ixor:		xor nxt

ishl:		shl nxt
ishr:		shr nxt
iushr:		ushr nxt


imul:
imul_hw:
			stop				// pop value2 -> CU opStack[0]
			stop				// pop value1 -> CU opStack[1]
			sthw 0				// start ICU imul (unit=00, op=0)
			wait				// 1st wait: sets pcwait
			wait				// 2nd wait: pcwait+bsy → stall until CU done
			ldop nxt			// push result

			// DSP multiply (2-cycle, 1-cycle registered DSP in ALU)
			// Entry: TOS=value2, NOS=value1 (A=value2, B=value1)
			// Exit: push value1*value2 (low 32 bits)
imul_dsp:
			dspmul				// NOP: latch A*B in DSP result register
			lddsp nxt			// POP: sp--, A <- dspResult[31:0], return

			// Pure microcode shift-and-add multiply (alternate handler for imul: Microcode)
			// Used when IntegerComputeUnit is not instantiated.
			// Entry: TOS=b (multiplier), NOS=a (multiplicand)
			// Exit: push a*b (low 32 bits, signed-correct via two's complement)
imul_sw:
			stm	b			// b = TOS, pop. Stack: ..., a
			stm	a			// a = NOS, pop. Stack: ...
			ldi	0
			stm	c			// c = 0 (result accumulator)
			ldi	32			// loop counter. Stack: ..., 32
imul_loop:
			ldm	b			// Stack: ..., cnt, b
			ldi	1			// Stack: ..., cnt, b, 1
			and				// Stack: ..., cnt, (b&1)
			nop
			bz	imul_noadd
			nop
			nop
			ldm	c			// result += a
			ldm	a
			add
			stm	c			// Stack: ..., cnt
imul_noadd:
			ldm	a			// a <<= 1
			dup
			add
			stm	a			// Stack: ..., cnt
			ldm	b			// b >>>= 1
			ldi	1
			ushr
			stm	b			// Stack: ..., cnt
			ldi	1			// counter--
			sub				// Stack: ..., cnt-1
			dup				// Stack: ..., cnt-1, cnt-1
			nop
			bnz	imul_loop
			nop
			nop
			pop				// remove counter. Stack: ...
			ldm	c nxt		// push result


// 	moved to JVM.java
//
// idiv:
// 			stm	b
// 			stm	a
// 			ldm	a
//         	ldi	-2147483648		//  0x80000000
// 			and
// 			dup					// make a positiv
// 			nop
// 			bz	idiv_apos
// 			nop
// 			nop
// 			ldm	a
// 			ldi -1
// 			xor
// 			ldi 1
// 			add
// 			stm	a
// idiv_apos:
// 			ldm	b
//         	ldi	-2147483648		//  0x80000000
// 			and
// 			dup					// make b positiv
// 			nop
// 			bz	idiv_bpos
// 			nop
// 			nop
// 			ldm	b
// 			ldi -1
// 			xor
// 			ldi 1
// 			add
// 			stm	b
// idiv_bpos:
// 			xor					//	sign
// 			stm	e
// 
// 			ldi	0
// 			stm	c			//	c is quotient
// 			ldi	0
// 			stm	d			//	d is remainder
// 			ldi	32			//	loop counter
// idiv_loop:
// 			ldm	c
// 			dup
// 			add
// 			stm	c
// 			ldm	d
// 			dup
// 			add
// 			stm	d
// 			ldm	a
//         	ldi	-2147483648		//  0x80000000
// 			and
// 			nop
// 			bz	idiv_noor
// 			nop
// 			nop
// 			ldm	d
// 			ldi	1
// 			or
// 			stm	d
// idiv_noor:
// 			ldm	a
// 			dup
// 			add
// 			stm	a
// 			ldm	d
// 			ldm	b
// 			sub
//         	ldi	-2147483648		//  0x80000000
// 			and
// 			nop
// 			bnz	idiv_nosub
// 			nop
// 			nop
// 			ldm	d
// 			ldm	b
// 			sub
// 			stm	d
// 			ldm	c
// 			ldi	1
// 			or
// 			stm	c
// idiv_nosub:
// 
// 			ldi	1
// 			sub
// 			dup
// 			nop
// 			bnz	idiv_loop
// 			nop
// 			nop
// 			pop				// remove loop counter
// 			ldm	e
// 			nop
// 			bz	idiv_nosign
// 			nop
// 			nop
// 			ldm	c
// 			ldi -1
// 			xor
// 			ldi 1
// 			add	nxt
// idiv_nosign:
// 			ldm	c	nxt
// 
// irem:
// 			stm	b
// 			stm	a
// 			ldm	a
//         	ldi	-2147483648		//  0x80000000
// 			and
// 			dup					// make a positiv
// 			stm	e				//	sign
// 			nop
// 			bz	irem_apos
// 			nop
// 			nop
// 			ldm	a
// 			ldi -1
// 			xor
// 			ldi 1
// 			add
// 			stm	a
// irem_apos:
// 			ldm	b
//         	ldi	-2147483648		//  0x80000000
// 			and					// make b positiv
// 			nop
// 			bz	irem_bpos
// 			nop
// 			nop
// 			ldm	b
// 			ldi -1
// 			xor
// 			ldi 1
// 			add
// 			stm	b
// irem_bpos:
// 
// 			ldi	0
// 			stm	c			//	c is quotient
// 			ldi	0
// 			stm	d			//	d is remainder
// 			ldi	32			//	loop counter
// irem_loop:
// 			ldm	c
// 			dup
// 			add
// 			stm	c
// 			ldm	d
// 			dup
// 			add
// 			stm	d
// 			ldm	a
//         	ldi	-2147483648		//  0x80000000
// 			and
// 			nop
// 			bz	irem_noor
// 			nop
// 			nop
// 			ldm	d
// 			ldi	1
// 			or
// 			stm	d
// irem_noor:
// 			ldm	a
// 			dup
// 			add
// 			stm	a
// 			ldm	d
// 			ldm	b
// 			sub
//         	ldi	-2147483648		//  0x80000000
// 			and
// 			nop
// 			bnz	irem_nosub
// 			nop
// 			nop
// 			ldm	d
// 			ldm	b
// 			sub
// 			stm	d
// 			ldm	c
// 			ldi	1
// 			or
// 			stm	c
// irem_nosub:
// 
// 			ldi	1
// 			sub
// 			dup
// 			nop
// 			bnz	irem_loop
// 			nop
// 			nop
// 			pop				// remove loop counter
// 			ldm	e
// 			nop
// 			bz	irem_nosign
// 			nop
// 			nop
// 			ldm	d
// 			ldi -1
// 			xor
// 			ldi 1
// 			add	nxt
// irem_nosign:
// 			ldm	d	nxt
// 


iinc:
			ldvp opd
			ld_opd_8u
			add
			star opd
			ld_opd_8s
			ldmi
			add
			stmi nxt

i2c:
			ldi	65535
			and	nxt

ifnull:
ifnonnull:
ifeq:
ifne:
iflt:
ifge:
ifgt:
ifle:
			nop opd
			jbr opd
			pop
			nop nxt

if_acmpeq:
if_acmpne:
if_icmpeq:
if_icmpne:
if_icmplt:
if_icmpge:
if_icmpgt:
if_icmple:
			nop opd
			jbr opd
			pop
			pop nxt

goto:
			nop opd
			jbr opd
			nop
			nop nxt


getstatic_ref:
getstatic:				// address is in index (bc opd)
			stgs opd
			nop opd
			wait
			wait
			ldmrd nxt

jopsys_getstatic:
			stidx
			stgs
			wait
			wait
			ldmrd nxt

putstatic:				// address is in index (bc opd)
			stps opd	// MMU uses bc opd
			nop opd
			wait
			wait
			nop nxt

jopsys_putstatic:
			stidx
			stps
			wait
			wait
			nop nxt
		
getfield_ref:					// getfield for reference is the same
getfield:
			stgf opd			// let the HW do the work
			nop opd				// index is loaded from BC operand
			// could the opd go to the wait instruction?
			// No, it breaks wait :-(
			wait
			wait
			ldmrd nxt			// read result

jopsys_getfield:				// version from Native
			stidx
			stgf				// let the HW do the work
			wait
			wait
			ldmrd nxt			// read result

putfield:
			stpf 				// start putfield index is taken from the BC operand
			nop opd
			nop	opd				// get rid of second stack location
			wait
			wait
			pop nxt

			// TODO: change order between value and index in Native
jopsys_putfield:				// Version from Native
			stm a
			stidx
			ldm a
			stpf				// let the HW do the work
			wait
			wait
			pop nxt

arraylength:

			ldi	1
			add					// arrayref+1 (in handle)
			stmraf				// read ext. mem, mem_bsy comes one cycle later
			wait
			wait
			ldmrd		 nxt	// read ext. mem


#ifndef RTTM
//aastore: is now in JVM.java for the write barrier
#else
aastore:
#endif

#ifdef HW_AASTORE
			stastr
			pop
			pop
			wait
			wait
			nop nxt
#endif
			
bastore:
castore:
fastore:
iastore:
sastore:
			stast
			pop
			pop
			wait
			wait
			nop nxt

aaload:
baload:
caload:
faload:
iaload:
saload:
			stald
			pop
			wait
			wait
			ldmrd nxt

monitorenter:
			// disable interrupts
			ldi	io_int_ena
			stmwa				// write ext. mem address
			ldi	0
			stmwd				// write ext. mem data
			wait
			wait
			
			// increment lock count
			ldm	lockcnt
			ldi	1
			add
			stm	lockcnt
			
			// request the global lock
			ldi	io_lock
			stmwa				// write ext. mem address
			stmwd				// write ext. mem data
			wait
			wait
			
			// read value from islu
			ldi io_lock
			stmra
			wait
			wait
			ldmrd
			
			// if (value from islu == 0) exit
			nop
			nop
			bz monitorenter_ok
			nop
			nop
			
			// else throw exception
			ldi io_exc
			stmwa
			ldi exc_mon
			stmwd
			wait
			wait
			nop nxt
monitorenter_ok:        
			nop nxt

monitorexit:
			// write lock ref to islu
			ldi	io_cpu_id
			stmwa				// write ext. mem address
			stmwd				// write ext. mem data
			wait
			wait

			// decrement lock count
			ldm	lockcnt
			ldi	1
			sub
			dup
			stm	lockcnt
			
			// if (lock count != 0) exit
			bnz	monitorexit_no_ena
			nop
			nop
			
			// enable interrupts
			ldi	io_int_ena
			stmwa
			ldi 1
			stmwd				// write ext. mem data
			wait
			wait
monitorexit_no_ena:	nop nxt

//		
// long bytecodes
//
#include "jvm_long.inc"

//
// double bytecodes
//
#include "jvm_double.inc"



//****************

// special byte codes for native functions

//jopsys_rd:
//			stioa		// io-address
//			nop
//			ldiod	nxt	// read data
//
//jopsys_wr:
//			stioa		// io-address
//			nop
//			stiod	nxt	// write data

//
//	this sequence takes ram_cnt + 3 cycles
//	means ram_cnt-1 wait states (bsy)
//	nws = ram_cnt-1
//
//	or in other words 4+nws
//
//	For the 100MHz JOP version this sequnce takes
//	5 cycles.
//
//
jopsys_rd:
jopsys_rdmem:
			stmra				// read memory, mem_bsy comes one cycle later
			wait
			wait				// execute 1+nws
			ldmrd		 nxt	// read ext. mem


//
//	The wait states for the write are the same as
//	for the read: nws = ram_cnt-1
//
//	The sequence executes for 5+nws cycles - for the
//	100MHz version in 6 cycles
//
jopsys_wr:
jopsys_wrmem:
			stmwa				// store memory address
			stmwd				// store memory data
			wait
			wait				// execute 1+nws
			nop	nxt

jopsys_rdint:
			star			// address in ar
			nop				// due to pipelining
			ldmi nxt		// read value (ar indirect)

jopsys_wrint:
			star			// address in ar
			nop				// due to pipelining
			stmi nxt		// write value (ar indirect)

jopsys_getsp:
			ldsp		// one increment but still one to low ('real' sp is sp+2 because of registers)
			ldi	1		// 'real' sp			da sp auf rd adr zeigt
			add	nxt
jopsys_setsp:
			nop			// written in adr/read stage!
			stsp		// new sp
			pop			// flash tos, tos-1 (registers)
			pop	nxt		// sp must be two lower, points to rd adr
jopsys_getvp:
			ldvp	nxt
jopsys_setvp:
			stvp
			nop	nxt

// public static native void int2extMem(int intAdr, int extAdr, int cnt);

jopsys_int2ext:
			ldi	-1
			add
			stm c			// counter-1
			stmra			// read handle indirection
			stm	b			// intern address
			wait			// for the GC
			wait
			ldmrd
			stm	a			// extern address
			ldm	c			// keep counter on the stack

intext_loop:
			dup
			ldm	b
			add
			star
			dup
			ldm	a
			add
			stmwa
			ldmi
			stmwd
			dup
			wait
			wait

			bnz		intext_loop
			ldi	-1	// decrement in branch slot
			add

			pop	nxt	// remove counter

// public static native void ext2intMem(int extAdr, int intAdr, int cnt);

jopsys_ext2int:
			ldi	-1
			add
			stm c			// counter-1
			stm	b			// intern address
			stmra			// read handle indirection
			wait			// for the GC
			wait
			ldmrd
			stm	a			// extern address
			ldm	c			// keep counter on the stack

extint_loop:
			dup
			ldm	a
			add
			stmra
			dup
			ldm	b
			add
			star
			wait
			wait
			ldmrd			// read ext val
			stmi

			dup
			nop
			bnz		extint_loop
			ldi	-1	// decrement in branch slot
			add

			pop	nxt	// remove counter

//	public static native void memCopy(int src, int dest, int cnt);

jopsys_memcpy:
// 			ldi	-1
// 			add
// 			stm c	// counter-1
// 			stm b	// destination
// 			stm a	// source
// 			ldm	c	// keep counter on the stack

// memcpy_loop:
// 			dup
// 			ldm	a
// 			add
// 			stmra
// 			dup
// 			ldm	b
// 			add
// 			stmwa	// should be ok
// 			wait
// 			wait
// 			ldmrd
// 			stmwd
// 			dup
// 			wait
// 			wait

// 			bnz	memcpy_loop
// 			ldi	-1	// decrement in branch slot
// 			add

			stcp
			pop
			wait
			wait
			pop nxt



//
//	some conversions only need a nop!
//
jopsys_nop:
			nop	nxt

//jopsys_invoke: see invoke


jopsys_cond_move:
			nop		// one cycle for the condition
			bz		false_path
			stm		b
			stm		c
			ldm		c nxt
false_path:	ldm		b nxt

// invalidate cache coherent data cache
// if we would do it in a single cycle, would the
// invalidate signal come to late for the hit detection
// earlier in the pipeline?
jopsys_inval:
			cinval
			nop
			nop
			nop nxt

// ==========================================================================
// Long multiply via LongComputeUnit (LCU)
// ==========================================================================
lmul:
lmul_hw:
			// Stack: ..., a_hi, a_lo, b_hi, b_lo (TOS=b_lo)
			stop				// pop b_lo -> CU opStack[0]
			stop				// pop b_hi -> CU opStack[1]
			stop				// pop a_lo -> CU opStack[2]
			stop				// pop a_hi -> CU opStack[3]
			sthw 34				// start LCU lmul (unit=10, op=2)
			wait				// 1st wait: sets pcwait
			wait				// 2nd wait: pcwait+bsy → stall until CU done
			ldop				// push result_hi
			ldop nxt			// push result_lo

// ==========================================================================
// lmul using ICU imul_wide (3 partial products via CU interface)
// lmul(a1:a0 × b1:b0) → result_high:result_low
//   P0 = a0 × b0 (imul_wide: need both hi and lo)
//   P1 = a1 × b0 (imul: need only lo)
//   P2 = a0 × b1 (imul: need only lo)
//   result_low  = P0_low
//   result_high = P0_high + P1_low + P2_low
// Uses ICU op 3 (imul_wide) for P0, ICU op 0 (imul) for P1/P2
// ==========================================================================
lmul_sw:
			// Stack: ..., a1, a0, b1, b0 (TOS=b0)
			stm a				// a = b0, pop. Stack: ..., a1, a0, b1
			stm b				// b = b1, pop. Stack: ..., a1, a0
			dup					// Stack: ..., a1, a0, a0
			stm c				// c = a0, pop. Stack: ..., a1, a0

			// ---- P0 = a0 * b0 (imul_wide → 64-bit result) ----
			ldm a				// push b0. Stack: ..., a1, a0, b0
			stop				// opStack[0] = b0, pop. Stack: ..., a1, a0
			stop				// opStack[1] = a0, pop. Stack: ..., a1
			sthw 3				// ICU imul_wide (unit=00, op=0011)
			wait				// 1st wait: sets pcwait
			wait				// 2nd wait: pcwait+bsy → stall until done
			ldop				// push P0_hi. Stack: ..., a1, P0_hi
			stm d				// d = P0_hi, pop. Stack: ..., a1
			ldop				// push P0_lo. Stack: ..., a1, P0_lo
			stm e				// e = P0_lo, pop. Stack: ..., a1

			// ---- P1 = a1 * b0 (imul → 32-bit low result) ----
			ldm a				// push b0. Stack: ..., a1, b0
			stop				// opStack[0] = b0, pop. Stack: ..., a1
			stop				// opStack[1] = a1, pop. Stack: ...
			sthw 0				// ICU imul (unit=00, op=0000)
			wait
			wait
			ldop				// push P1_lo. Stack: ..., P1_lo
			ldm d				// push P0_hi. Stack: ..., P1_lo, P0_hi
			add					// Stack: ..., (P1_lo + P0_hi)
			stm d				// d = accum, pop. Stack: ...

			// ---- P2 = a0 * b1 (imul → 32-bit low result) ----
			ldm c				// push a0. Stack: ..., a0
			ldm b				// push b1. Stack: ..., a0, b1
			stop				// opStack[0] = b1, pop. Stack: ..., a0
			stop				// opStack[1] = a0, pop. Stack: ...
			sthw 0				// ICU imul (unit=00, op=0000)
			wait
			wait
			ldop				// push P2_lo. Stack: ..., P2_lo
			ldm d				// push accum. Stack: ..., P2_lo, accum
			add					// Stack: ..., result_high

			// Push result: high, low (long = high:low on JOP stack)
			ldm e nxt			// push result_low. Stack: ..., result_high, result_low


// ==========================================================================
// Floating point operations — FCU (compute unit) handlers.
//
// CU handlers (_hw): uses ComputeUnitTop via stop/sthw/wait/ldop
// There is no _sw for fadd/fsub/fmul/fdiv: the alternative is the Java trap
// (SoftFloat32). fneg, fcmpl and fcmpg DO have microcode — none needs the FCU.
// ==========================================================================

// ---------- fadd ----------
fadd:
fadd_hw:
			stop				// pop value2 -> CU opStack[0]
			stop				// pop value1 -> CU opStack[1]
			sthw 16				// start FCU fadd (unit=01, op=0)
			wait				// 1st wait: sets pcwait
			wait				// 2nd wait: pcwait+bsy → stall until CU done
			ldop nxt			// push result

// ---------- fsub ----------
fsub:
fsub_hw:
			stop				// pop value2 -> CU opStack[0]
			stop				// pop value1 -> CU opStack[1]
			sthw 17				// start FCU fsub (unit=01, op=1)
			wait				// 1st wait: sets pcwait
			wait				// 2nd wait: pcwait+bsy → stall until CU done
			ldop nxt			// push result

// ---------- fmul ----------
fmul:
fmul_hw:
			stop				// pop value2 -> CU opStack[0]
			stop				// pop value1 -> CU opStack[1]
			sthw 18				// start FCU fmul (unit=01, op=2)
			wait				// 1st wait: sets pcwait
			wait				// 2nd wait: pcwait+bsy → stall until CU done
			ldop nxt			// push result

// ---------- fdiv ----------
fdiv:
fdiv_hw:
			stop				// pop value2 -> CU opStack[0]
			stop				// pop value1 -> CU opStack[1]
			sthw 19				// start FCU fdiv (unit=01, op=3)
			wait				// 1st wait: sets pcwait
			wait				// 2nd wait: pcwait+bsy → stall until CU done
			ldop nxt			// push result

// ---------- fcmpl ----------
fcmpl:
fcmpl_hw:
			stop				// pop value2 -> CU opStack[0]
			stop				// pop value1 -> CU opStack[1]
			sthw 20				// start FCU fcmpl (unit=01, op=4)
			wait				// 1st wait: sets pcwait
			wait				// 2nd wait: pcwait+bsy → stall until CU done
			ldop nxt			// push int result (-1, 0, or 1)

// ---------- fcmpg ----------
fcmpg:
fcmpg_hw:
			stop				// pop value2 -> CU opStack[0]
			stop				// pop value1 -> CU opStack[1]
			sthw 21				// start FCU fcmpg (unit=01, op=5)
			wait				// 1st wait: sets pcwait
			wait				// 2nd wait: pcwait+bsy → stall until CU done
			ldop nxt			// push int result (-1, 0, or 1)

// ==========================================================================
// fcmpl_sw / fcmpg_sw — pure microcode float compare, no FCU
//
// Stack: ..., value1, value2 (TOS = value2)  ->  ..., result
//   value1 > value2 ->  1
//   value1 = value2 ->  0
//   value1 < value2 -> -1
//   either is NaN   -> -1 for fcmpl, +1 for fcmpg
//
// The two entry points differ only in the NaN result, which is stashed in f and
// used by the shared body — duplicating ~45 words would be cheap in ROM but not
// in maintenance.
//
// No new ldi constants. The serial build's constant pool is the binding one at
// 30 of 32 entries (ldi is 00110nnnnn, a hard 5-bit limit that cannot grow
// without an ISA change), while the ROM has ~2000 words free. So 0x7FFFFFFF and
// 0x7F800000 are derived from constants already in the pool rather than added
// to it: spend the abundant resource, not the scarce one.
//
// Why not compare the raw bits directly: as signed ints, IEEE-754 floats order
// correctly only when positive. For negatives the order reverses (-2.0 is
// 0xC0000000, -1.0 is 0xBF800000, so the more negative float is the LARGER
// signed int). Hence the compare below splits on sign and, for two negatives,
// compares magnitudes the other way round.
//
// Compared to the FCU (6 words, ~4 cycles) this is ~45 words and ~30 cycles,
// and compared to the Java trap (SoftFloat32, several hundred cycles) it is a
// large win. See item 19 in docs/current-status.md.
// ==========================================================================
fcmpl_sw:
			ldi -1
			stm f				// f = NaN result for fcmpl
			jmp fcmp_sw_body
			nop
			nop

fcmpg_sw:
			ldi 1
			stm f				// f = NaN result for fcmpg
			nop					// fall through

fcmp_sw_body:
			stm b				// b = value2
			stm a				// a = value1

			// c = 0x7FFFFFFF  (-1 >>> 1) — mask off the sign bit
			ldi -1
			ldi 1
			ushr
			stm c

			ldm a				// e = |value1|
			ldm c
			and
			stm e
			ldm b				// d = |value2|
			ldm c
			and
			stm d

			// c = 0x7F800000  ((255 << 24) >>> 1) — +Infinity, the NaN threshold
			ldi 255
			ldi 24
			shl
			ldi 1
			ushr
			stm c

			// NaN iff |x| > 0x7F800000. Test the sign of (0x7F800000 - |x|):
			// equal (Infinity) gives 0, which is correctly not NaN.
			ldm c
			ldm e
			sub
			ldi 31
			shr					// 0, or -1 if value1 is NaN
			ldm c
			ldm d
			sub
			ldi 31
			shr					// 0, or -1 if value2 is NaN
			or
			nop
			bz fcmp_sw_ordered
			nop
			nop
			ldm f nxt			// NaN: -1 for fcmpl, +1 for fcmpg

fcmp_sw_ordered:
			// +0.0 and -0.0 must compare equal, but they differ in the sign bit
			// and would otherwise fall into the differing-signs case below.
			// |v1| | |v2| is zero only when both are a zero of either sign.
			ldm e
			ldm d
			or
			nop
			bnz fcmp_sw_nonzero
			nop
			nop
			ldi 0 nxt

fcmp_sw_nonzero:
			ldm a				// c = sign(value1), 0 or -1
			ldi 31
			shr
			stm c
			ldm b				// b = sign(value2); value2 itself is done with
			ldi 31
			shr
			stm b
			ldm c
			ldm b
			xor
			nop
			bz fcmp_sw_samesign
			nop
			nop
			// Signs differ and they are not both zero, so the negative one is
			// the smaller. c is sign(value1): -1 -> value1 < value2 -> -1.
			ldm c
			ldi 1
			or nxt

fcmp_sw_samesign:
			// Both operands are known non-NaN and not both zero, and
			// |x| <= 0x7F800000 < 2^31, so these subtractions cannot overflow —
			// unlike a difference of the raw bit patterns would.
			ldm c
			nop
			bnz fcmp_sw_bothneg
			nop
			nop
			ldm e				// both positive: larger magnitude is larger
			ldm d
			sub
			stm a
			jmp fcmp_sw_result
			nop
			nop

fcmp_sw_bothneg:
			ldm d				// both negative: larger magnitude is smaller
			ldm e
			sub
			stm a

fcmp_sw_result:
			ldm a
			nop
			bnz fcmp_sw_signres
			nop
			nop
			ldi 0 nxt

fcmp_sw_signres:
			ldm a
			ldi 31
			shr					// -1 if negative, 0 if positive
			ldi 1
			or nxt				// -1 | 1 = -1 ; 0 | 1 = 1

// ---------- i2f ----------
i2f:
i2f_hw:
			stop				// pop int value -> CU opStack[0]
			sthw 22				// start FCU i2f (unit=01, op=6)
			wait				// 1st wait: sets pcwait
			wait				// 2nd wait: pcwait+bsy → stall until CU done
			ldop nxt			// push float result

// ---------- f2i ----------
f2i:
f2i_hw:
			stop				// pop float value -> CU opStack[0]
			sthw 23				// start FCU f2i (unit=01, op=7)
			wait				// 1st wait: sets pcwait
			wait				// 2nd wait: pcwait+bsy → stall until CU done
			ldop nxt			// push int result

// ---------- fneg (pure microcode, no HW/IO variants needed) ----------
// fneg_sw aliases the same address rather than duplicating two instructions.
// Without the _sw label, resolveJumpTable's useAlt has no alternate to select
// and rejects fneg = mc -- even though the default handler here IS the software
// implementation. Costs zero ROM words: two labels, one address.
fneg:
fneg_sw:
			ldi -2147483648	// 0x80000000
			xor nxt			// XOR sign bit, done (pure microcode, no CU)

//
//	GC stop-the-world safepoint, bytecode 0xf2 -- status item 165.
//
//	A GC halt reaches a core as `bsy`, and the fetch stage freezes on `bsy`
//	only at a `wait`. Bytecodes that touch no memory have none, so a core
//	running them kept executing through another core's collection; on a
//	build without a stack cache the collector's root scan then took over its
//	stack-RAM read port and corrupted its locals.
//
//	While a GC halt holds this core, BytecodeFetchStage dispatches HERE in
//	place of the next bytecode, without advancing jpc (as for sys_exc). The
//	halt keeps bsy high, so the second wait holds the core at this bytecode
//	boundary until the collector releases the world, and `nxt` then
//	dispatches the bytecode that was waiting. A core is therefore stopped
//	within one bytecode of the halt, at a point where every reference it
//	holds is in its stack or in A and B.
//
//	At the END of the file on purpose: appending moves no other microcode
//	address, so the jump table and every address a test or a log quotes stay
//	valid.
//
sys_gcstop:
			wait
			wait
			nop	nxt
