peteryates1/jop-spinalhdl/fpga/ecp5_dp16kd.v

// ECP5 DP16KD block RAM, with the clock-to-out yosys leaves out (status item
// 175). fpga/ecp5.mk reads this over yosys's own model, after synth_ecp5's
// `begin` step, for every JOP board flow on the ECP5.
//
// WHY. yosys's DP16KD is a blackbox with no timing, so ABC9 takes its outputs
// as arriving with the clock, like a flop's. nextpnr (speed 6) has them 5.8 ns
// after it. ABC9 maps for delay and then recovers area on every path up to one
// global ceiling, the slowest path it can see -- so a path that starts at a
// RAM is deepened until it matches whatever unrelated flop-to-flop logic is
// slowest. On the i5 that path is JOP's critical one (bytecode RAM -> jump
// table -> microcode ROM address), and adding Ethernet moved the build by
// 9 MHz without touching the fetch RTL: 13 LUT levels without, 10 with.
//
// THE VALUE is the RAM's lateness in ABC9's units, not nextpnr's. A flop's
// clock-to-out is 0.5 ns in nextpnr and 0 in yosys's model, so the RAM is
// 5.3 ns later than a flop. ABC9 prices a LUT level at 141-379 ps plus the
// 300 ps wire delay synth_ecp5 gives it (-W 300); routed, a level costs about
// 1.3 ns. 5.3 ns is therefore about four levels, about 2.5 ns to ABC9.
// Measured on all four i5 presets over nextpnr seeds 1-8 (item 175): of 2000,
// 2500 and 3000 ps, only 2500 raised every preset's mean AND its worst seed,
// and the means differ by less than the seed spread. The physical 5300 ps
// over-weights the RAM, and ABC9 deepens the flop paths instead.
//
// yosys's ECP5 RAM mapping only ever instantiates DP16KD with REGMODE "NOREG"
// (brams_map.v), which is what this delay is for; an output-registered RAM
// would be far earlier.
//
// Everything from `(* blackbox *)` down to `specify` is yosys 0.52's own
// declaration (techlibs/ecp5/cells_sim.v, ISC licence), byte for byte, so that
// every parameter synth_ecp5's mapping sets still exists:
// .github/scripts/check-ecp5-bram-timing.sh holds it to the installed yosys.
(* blackbox *)
module DP16KD(
  input DIA17, DIA16, DIA15, DIA14, DIA13, DIA12, DIA11, DIA10, DIA9, DIA8, DIA7, DIA6, DIA5, DIA4, DIA3, DIA2, DIA1, DIA0,
  input ADA13, ADA12, ADA11, ADA10, ADA9, ADA8, ADA7, ADA6, ADA5, ADA4, ADA3, ADA2, ADA1, ADA0,
  input CEA, OCEA, CLKA, WEA, RSTA,
  input CSA2, CSA1, CSA0,
  output DOA17, DOA16, DOA15, DOA14, DOA13, DOA12, DOA11, DOA10, DOA9, DOA8, DOA7, DOA6, DOA5, DOA4, DOA3, DOA2, DOA1, DOA0,

  input DIB17, DIB16, DIB15, DIB14, DIB13, DIB12, DIB11, DIB10, DIB9, DIB8, DIB7, DIB6, DIB5, DIB4, DIB3, DIB2, DIB1, DIB0,
  input ADB13, ADB12, ADB11, ADB10, ADB9, ADB8, ADB7, ADB6, ADB5, ADB4, ADB3, ADB2, ADB1, ADB0,
  input CEB, OCEB, CLKB, WEB, RSTB,
  input CSB2, CSB1, CSB0,
  output DOB17, DOB16, DOB15, DOB14, DOB13, DOB12, DOB11, DOB10, DOB9, DOB8, DOB7, DOB6, DOB5, DOB4, DOB3, DOB2, DOB1, DOB0
);
	parameter DATA_WIDTH_A = 18;
	parameter DATA_WIDTH_B = 18;

	parameter REGMODE_A = "NOREG";
	parameter REGMODE_B = "NOREG";

	parameter RESETMODE = "SYNC";
	parameter ASYNC_RESET_RELEASE = "SYNC";

	parameter CSDECODE_A = "0b000";
	parameter CSDECODE_B = "0b000";

	parameter WRITEMODE_A = "NORMAL";
	parameter WRITEMODE_B = "NORMAL";

	parameter DIA17MUX = "DIA17";
	parameter DIA16MUX = "DIA16";
	parameter DIA15MUX = "DIA15";
	parameter DIA14MUX = "DIA14";
	parameter DIA13MUX = "DIA13";
	parameter DIA12MUX = "DIA12";
	parameter DIA11MUX = "DIA11";
	parameter DIA10MUX = "DIA10";
	parameter DIA9MUX = "DIA9";
	parameter DIA8MUX = "DIA8";
	parameter DIA7MUX = "DIA7";
	parameter DIA6MUX = "DIA6";
	parameter DIA5MUX = "DIA5";
	parameter DIA4MUX = "DIA4";
	parameter DIA3MUX = "DIA3";
	parameter DIA2MUX = "DIA2";
	parameter DIA1MUX = "DIA1";
	parameter DIA0MUX = "DIA0";
	parameter ADA13MUX = "ADA13";
	parameter ADA12MUX = "ADA12";
	parameter ADA11MUX = "ADA11";
	parameter ADA10MUX = "ADA10";
	parameter ADA9MUX = "ADA9";
	parameter ADA8MUX = "ADA8";
	parameter ADA7MUX = "ADA7";
	parameter ADA6MUX = "ADA6";
	parameter ADA5MUX = "ADA5";
	parameter ADA4MUX = "ADA4";
	parameter ADA3MUX = "ADA3";
	parameter ADA2MUX = "ADA2";
	parameter ADA1MUX = "ADA1";
	parameter ADA0MUX = "ADA0";
	parameter CEAMUX = "CEA";
	parameter OCEAMUX = "OCEA";
	parameter CLKAMUX = "CLKA";
	parameter WEAMUX = "WEA";
	parameter RSTAMUX = "RSTA";
	parameter CSA2MUX = "CSA2";
	parameter CSA1MUX = "CSA1";
	parameter CSA0MUX = "CSA0";
	parameter DOA17MUX = "DOA17";
	parameter DOA16MUX = "DOA16";
	parameter DOA15MUX = "DOA15";
	parameter DOA14MUX = "DOA14";
	parameter DOA13MUX = "DOA13";
	parameter DOA12MUX = "DOA12";
	parameter DOA11MUX = "DOA11";
	parameter DOA10MUX = "DOA10";
	parameter DOA9MUX = "DOA9";
	parameter DOA8MUX = "DOA8";
	parameter DOA7MUX = "DOA7";
	parameter DOA6MUX = "DOA6";
	parameter DOA5MUX = "DOA5";
	parameter DOA4MUX = "DOA4";
	parameter DOA3MUX = "DOA3";
	parameter DOA2MUX = "DOA2";
	parameter DOA1MUX = "DOA1";
	parameter DOA0MUX = "DOA0";
	parameter DIB17MUX = "DIB17";
	parameter DIB16MUX = "DIB16";
	parameter DIB15MUX = "DIB15";
	parameter DIB14MUX = "DIB14";
	parameter DIB13MUX = "DIB13";
	parameter DIB12MUX = "DIB12";
	parameter DIB11MUX = "DIB11";
	parameter DIB10MUX = "DIB10";
	parameter DIB9MUX = "DIB9";
	parameter DIB8MUX = "DIB8";
	parameter DIB7MUX = "DIB7";
	parameter DIB6MUX = "DIB6";
	parameter DIB5MUX = "DIB5";
	parameter DIB4MUX = "DIB4";
	parameter DIB3MUX = "DIB3";
	parameter DIB2MUX = "DIB2";
	parameter DIB1MUX = "DIB1";
	parameter DIB0MUX = "DIB0";
	parameter ADB13MUX = "ADB13";
	parameter ADB12MUX = "ADB12";
	parameter ADB11MUX = "ADB11";
	parameter ADB10MUX = "ADB10";
	parameter ADB9MUX = "ADB9";
	parameter ADB8MUX = "ADB8";
	parameter ADB7MUX = "ADB7";
	parameter ADB6MUX = "ADB6";
	parameter ADB5MUX = "ADB5";
	parameter ADB4MUX = "ADB4";
	parameter ADB3MUX = "ADB3";
	parameter ADB2MUX = "ADB2";
	parameter ADB1MUX = "ADB1";
	parameter ADB0MUX = "ADB0";
	parameter CEBMUX = "CEB";
	parameter OCEBMUX = "OCEB";
	parameter CLKBMUX = "CLKB";
	parameter WEBMUX = "WEB";
	parameter RSTBMUX = "RSTB";
	parameter CSB2MUX = "CSB2";
	parameter CSB1MUX = "CSB1";
	parameter CSB0MUX = "CSB0";
	parameter DOB17MUX = "DOB17";
	parameter DOB16MUX = "DOB16";
	parameter DOB15MUX = "DOB15";
	parameter DOB14MUX = "DOB14";
	parameter DOB13MUX = "DOB13";
	parameter DOB12MUX = "DOB12";
	parameter DOB11MUX = "DOB11";
	parameter DOB10MUX = "DOB10";
	parameter DOB9MUX = "DOB9";
	parameter DOB8MUX = "DOB8";
	parameter DOB7MUX = "DOB7";
	parameter DOB6MUX = "DOB6";
	parameter DOB5MUX = "DOB5";
	parameter DOB4MUX = "DOB4";
	parameter DOB3MUX = "DOB3";
	parameter DOB2MUX = "DOB2";
	parameter DOB1MUX = "DOB1";
	parameter DOB0MUX = "DOB0";

	parameter WID = 0;

	parameter GSR = "ENABLED";

	parameter INITVAL_00 = 320'h00000000000000000000000000000000000000000000000000000000000000000000000000000000;
	parameter INITVAL_01 = 320'h00000000000000000000000000000000000000000000000000000000000000000000000000000000;
	parameter INITVAL_02 = 320'h00000000000000000000000000000000000000000000000000000000000000000000000000000000;
	parameter INITVAL_03 = 320'h00000000000000000000000000000000000000000000000000000000000000000000000000000000;
	parameter INITVAL_04 = 320'h00000000000000000000000000000000000000000000000000000000000000000000000000000000;
	parameter INITVAL_05 = 320'h00000000000000000000000000000000000000000000000000000000000000000000000000000000;
	parameter INITVAL_06 = 320'h00000000000000000000000000000000000000000000000000000000000000000000000000000000;
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
		(posedge CLKB => (DOB0 : DIB0)) = 2500;
		(posedge CLKB => (DOB1 : DIB1)) = 2500;
		(posedge CLKB => (DOB2 : DIB2)) = 2500;
		(posedge CLKB => (DOB3 : DIB3)) = 2500;
		(posedge CLKB => (DOB4 : DIB4)) = 2500;
		(posedge CLKB => (DOB5 : DIB5)) = 2500;
		(posedge CLKB => (DOB6 : DIB6)) = 2500;
		(posedge CLKB => (DOB7 : DIB7)) = 2500;
		(posedge CLKB => (DOB8 : DIB8)) = 2500;
		(posedge CLKB => (DOB9 : DIB9)) = 2500;
		(posedge CLKB => (DOB10 : DIB10)) = 2500;
		(posedge CLKB => (DOB11 : DIB11)) = 2500;
		(posedge CLKB => (DOB12 : DIB12)) = 2500;
		(posedge CLKB => (DOB13 : DIB13)) = 2500;
		(posedge CLKB => (DOB14 : DIB14)) = 2500;
		(posedge CLKB => (DOB15 : DIB15)) = 2500;
		(posedge CLKB => (DOB16 : DIB16)) = 2500;
		(posedge CLKB => (DOB17 : DIB17)) = 2500;
	endspecify
endmodule
