peteryates1/jop-spinalhdl/fpga/max1000/max1000_pll.v

// MAX1000 PLL stub for fit-check (replace with Quartus altpll IP for real build)
// 12 MHz input -> 80 MHz system + 80 MHz SDRAM (phase-shifted)
module max1000_pll (
    input  inclk0,
    input  areset,
    output c0,      // 80 MHz system clock
    output c1,      // 80 MHz SDRAM clock (phase-shifted)
    output locked
);

// Quartus will replace this with altpll megafunction.
// For synthesis fit-check, just pass through.
assign c0 = inclk0;
assign c1 = inclk0;
assign locked = ~areset;

endmodule
