peteryates1/jop-spinalhdl/fpga/scripts/hw_verify.py

#!/usr/bin/env python3
"""
Put a build on real hardware and record what happened.

  fpga/scripts/hw_verify.py <preset> [args...] [--app <name>] [--runs N]

Step 5 of the conversion loop. Steps 1-4 (move to build/, generate constraints,
cold-build, delete the hand-written file) can only prove that nothing CHANGED --
they compare artifacts. They cannot prove that something still WORKS when a
change was intended, and every genuinely new artifact this project has produced
recently had no byte-identical predecessor to compare against.

WHY IT IS A SCRIPT AND NOT A PROCEDURE. Three boards were verified by hand in
one session and each got a different incantation: one programmed a stale
bitstream from the pre-move path, one used a bare `-c dirtyJtag` with TWO
dirtyJtag probes attached (which takes whichever enumerated first -- possibly
the other board), and one used a guessed console alias that resolved to nothing
and was reported as a broken board. Board facts restated at the point of use,
three times, three different ways.

Everything board-specific comes from HwVerifyDescriptor (the config) and the two
registries, which resolve by SERIAL because port paths move on every replug.

REFUSES rather than defaults. An unresolvable alias aborts. The failure mode
being avoided is an empty string flowing into a device path and the run looking
like a dead board.

ONE RUN IS A SAMPLE, NOT A VERDICT. A Wukong SDR build failed 1 run in 6 on
2026-08-24 and the cause was never found (status item 63). Results are appended
to <config>/hw_verify.log as one line per run so a flake stays visible instead
of being averaged into a boolean.
"""

import argparse, os, re, subprocess, sys, time
import jop_setup  # this host's tools (setup/host.toml); same directory
from datetime import datetime, timezone

ROOT = os.path.dirname(os.path.dirname(os.path.dirname(os.path.abspath(__file__))))
SCRIPTS = os.path.join(ROOT, "fpga", "scripts")


def die(msg):
    print(f"hw_verify: {msg}", file=sys.stderr)
    sys.exit(2)


def descriptor(preset, extra):
    """Ask the config what this preset needs. sbt logs a forked process's stdout
    at INFO, so the prefix is stripped; `sbt -error` would suppress the answer
    along with the noise."""
    cmd = ["sbt", f'runMain jop.generate.HwVerifyDescriptorMain {preset} {" ".join(extra)}'.strip()]
    out = subprocess.run(cmd, cwd=ROOT, capture_output=True, text=True).stdout
    d = {}
    for line in out.splitlines():
        line = line[7:] if line.startswith("[info] ") else line
        if re.fullmatch(r"[A-Z_]+=.*", line):
            k, v = line.split("=", 1)
            d[k] = v
    if "ENTITY" not in d:
        die(f"could not read a descriptor for preset '{preset}'.\n{out[-2000:]}")
    return d


def resolve(tool, flag, alias, what):
    r = subprocess.run([os.path.join(SCRIPTS, tool), flag, alias],
                       capture_output=True, text=True)
    val = r.stdout.strip()
    if r.returncode != 0 or not val:
        die(f"{what} alias '{alias}' did not resolve via {tool} {flag}.\n"
            f"  {r.stderr.strip() or 'no output'}\n"
            f"  Refusing to continue -- an unresolved alias reads as a dead board.")
    return val


def stale_sources(image, src_dirs, limit=5, exts=(".java", ".properties")):
    """Sources newer than the image that is about to be downloaded.

    hw_verify NEVER REBUILDS: it downloads whatever .jop is present. On
    2026-09-14 that ran an image built four hours before its source was edited,
    and the run reported -- credibly -- that a freshly added test vehicle
    provoked nothing. The rebuilt image reported the violation on its first
    round.

    A stale image fails in the most expensive direction. It does not error; it
    produces a clean, plausible result for code that was never executed, and
    nothing in the transcript says which image ran. The project's own note on
    this is "verify against the emitted .jop, not the exit code" -- this is
    that check, done by the tool instead of by memory.
    """
    try:
        img = os.path.getmtime(image)
    except OSError:
        return []
    newer = []
    for d in src_dirs:
        for dirpath, _, files in os.walk(d):
            for f in files:
                if not f.endswith(exts):
                    continue
                p = os.path.join(dirpath, f)
                try:
                    if os.path.getmtime(p) > img:
                        newer.append(os.path.relpath(p, ROOT))
                except OSError:
                    pass
    return sorted(newer)[:limit]


# Library trees an app is built with (EXTRA_SRC), and the packages they hold.
LIBRARY_SOURCES = (
    ("java/net/src", ("com.jopdesign.net.", "java.net.")),
    ("java/fat32/src", ("com.jopdesign.fat32.",)),
)


def linked_library_dirs(image):
    """The library source trees an app image was built from.

    NetTest and HttpServer are built with EXTRA_SRC=../../net/src, and the
    stale check looked only at the app's and the runtime's sources: on
    2026-11-10 the stack was being changed under a NetTest that would have run
    unrebuilt -- the old stack, with a clean verdict. JOPizer's link map,
    <image>.link.txt, names every class the image holds. Without one, every
    tree: a rebuild costs less than a run of code that is not in the image.
    """
    try:
        with open(image + ".link.txt") as f:
            linked = f.read()
    except OSError:
        return [os.path.join(ROOT, d) for d, _ in LIBRARY_SOURCES]
    return [os.path.join(ROOT, d) for d, pkgs in LIBRARY_SOURCES
            if any(p in linked for p in pkgs)]


def find_bitstream(cfg_dir, tool=None):
    """The file to program, in the format the chosen TOOL can actually read.

    openFPGALoader REFUSES a .sof -- "please use rbf or svf file" -- so an
    Altera board programmed by openFPGALoader needs the .rbf that quartus_cpf
    produces beside it. Ignoring the tool here made the CYC5000 fail with
    "Failed to claim FPGA device: Error: wrong file", which reads like a probe
    problem and is a file-format one.
    """
    exts = (".rbf", ".sof", ".bit") if tool == "openfpgaloader" else (".sof", ".bit")
    hits = []
    for dirpath, _, files in os.walk(cfg_dir):
        for f in files:
            if f.endswith(exts):
                hits.append(os.path.join(dirpath, f))
    # Prefer the first extension the tool can read, rather than tripping the
    # "more than one bitstream" guard on a directory that legitimately holds
    # both a .sof and the .rbf converted from it.
    for e in exts:
        pref = [h for h in hits if h.endswith(e)]
        if pref:
            hits = pref
            break
    if not hits:
        die(f"no {'/'.join(exts)} under {cfg_dir} -- build it first")
    if len(hits) > 1:
        die("more than one bitstream under {}:\n  {}".format(cfg_dir, "\n  ".join(hits)))
    return hits[0]


def program(d, bitstream):
    if d["PROGRAM_TOOL"] == "quartus":
        cable = resolve("jtag_probe_map", "--cable", d["PROBE_ALIAS"], "JTAG probe")
        cdf = os.path.splitext(bitstream)[0] + ".cdf"
        if not os.path.exists(cdf):
            # quartus_pgm can take the .sof directly with an explicit operation.
            op = f"p;{bitstream}"
            cmd = ["quartus_pgm", "-c", cable, "-m", "JTAG", "-o", op]
        else:
            cmd = ["quartus_pgm", "-c", cable, "-m", "JTAG", cdf]
        # Where this host keeps Quartus 25.1 is the setup's (setup/host.toml).
        qdir = os.environ.get("QUARTUS_BIN")
        if not qdir:
            try:
                qdir = os.path.join(jop_setup.host("quartus", "25.1"), "bin")
            except jop_setup.SetupError as e:
                die(f"{e}\n  (or set QUARTUS_BIN)")
        cmd[0] = os.path.join(qdir, "quartus_pgm")
    else:
        cmd = ["sudo", "openFPGALoader"]
        if d.get("LOADER_BOARD"):
            cmd += ["-b", d["LOADER_BOARD"]]
        else:
            cmd += ["-c", d["LOADER_CABLE"]]
        # SELECT THE PROBE IN BOTH BRANCHES. This used to guard only the -c
        # path, on the reasoning that two dirtyJtag probes are attached. But
        # TWO FTDI PROBES are attached too -- the CYC5000's Arrow blaster and
        # the Alchitry Au's FT2232H are both 0403:6010 -- and a bare
        # `-b cyc5000` takes whichever enumerated first. On 2026-09-11 that was
        # the Alchitry: `--detect` reported "manufacturer xilinx, family artix
        # a7 35t" while the recipe was aiming a Cyclone V .rbf at it. It failed
        # with "Read ID failed / SPI flash write failed", which reads like a
        # dead CYC5000 and is not.
        #
        # --busdev-num works for FTDI as well as dirtyJtag with the patched
        # loader in /usr/local/bin; verified selecting 0x2b150dd (Cyclone V)
        # rather than 0x362d093 (Artix-7) on the shared vid:pid.
        busdev = resolve("jtag_probe_map", "--busdev", d["PROBE_ALIAS"], "JTAG probe")
        cmd += ["--busdev-num", busdev]
        cmd += [bitstream]
    r = subprocess.run(cmd, cwd=ROOT, capture_output=True, text=True)
    if r.returncode != 0:
        die("programming failed:\n" + (r.stderr or r.stdout)[-2000:])


def monitor_only(d, timeout):
    """Just listen. A standalone exerciser has no .jop and no download step --
    it starts running the moment the FPGA is configured, so the only thing to do
    is read what it says."""
    tty = resolve("usb_serial_map", "--by-id", d["CONSOLE_ALIAS"], "console")
    import serial  # only needed on this path
    port = serial.Serial(tty, int(d["BAUD"]), timeout=1)
    buf, t0 = b"", time.time()
    while time.time() - t0 < timeout:
        buf += port.read(4096)
    port.close()
    return buf.decode("ascii", errors="replace")


def run_app(d, jop, timeout):
    tty = resolve("usb_serial_map", "--by-id", d["CONSOLE_ALIAS"], "console")
    cmd = ["python3", os.path.join(SCRIPTS, "download.py"), "-e", jop, tty, d["BAUD"]]
    try:
        r = subprocess.run(cmd, cwd=ROOT, capture_output=True, text=True, timeout=timeout)
        out = r.stdout + r.stderr
    except subprocess.TimeoutExpired as e:
        # Expected: -e monitors until killed. Whatever arrived is the result.
        out = (e.stdout or b"").decode(errors="replace") + (e.stderr or b"").decode(errors="replace")
    return out


# A soak reports progress, not a verdict. GcStressTest prints one line per
# round: "R345124 f=5313644" -- a round counter and the free-memory count.
PROGRESS_RE = r"R(?P<round>\d+)\s+f=(?P<free>\d+)"


def judge_soak(out, min_rounds, drift, pattern=PROGRESS_RE):
    """Did it get far enough, and is memory being reclaimed?

    Written because the alternative was `--expect-text "R"`, which matches
    almost any output and passed while proving nothing. A soak asks two
    questions a substring cannot answer: did it REACH a meaningful number of
    rounds, and is the heap holding level?

    WHAT "LEVEL" MEANS, and the first version of this got it wrong. Free memory
    under a GC is SAWTOOTH -- it climbs when a collection runs and falls as
    objects allocate. The real i5 soak moves over a 130 KB band across 567
    distinct values, all of it healthy. Testing `max - min` therefore called a
    working collector a leak.

    What a leak actually looks like is the FLOOR dropping: each cycle reclaims a
    little less than the last. So compare the low-water mark of an early window
    against a late one. Oscillation inside a band is fine; a band that sinks is
    not.

    BUT THE SAWTOOTH IS NOT ALWAYS THERE, and saying it is hid a finding for a
    fortnight. Five of the six attached boards produce a series that NEVER rises
    -- zero upward steps in 1.4 M samples -- while demonstrably reclaiming
    memory: `GcStressTest` puts ~500 MB through a 5.46 MB heap. On those boards
    `GC.freeMemory()` (`allocPtr - copyPtr`) simply does not observe the
    collections, so "band" and "floor" describe an instrument, not a heap.
    Item 64 reasoned about a 0.42 B/round leak inside a band of exactly zero.

    So the verdict states WHICH SHAPE IT SAW. A tolerance tuned for a sawtooth
    is not evidence about a staircase, and a one-line verdict that calls both
    "sawtooth band" is how the difference stayed invisible -- the soak lines
    read "sawtooth band 135936" for series that never once went up.
    """
    # COMPLETE LINES ONLY. A soak that ends on a timeout is cut mid-line, and
    # the tail is a VALID-LOOKING partial record: `R356153 f=5` is what
    # `R356153 f=5311228` looks like when the read stops. That 5 then became the
    # low-water mark and the judge reported "free floor fell 5378551 bytes --
    # possible leak" on a board whose free memory had not moved. A parser that
    # accepts a truncated record invents the worst datum in the set, because a
    # truncated number is always SMALLER than the real one -- so this fails in
    # exactly one direction: false leaks, never missed ones.
    #
    # Anchoring each match to a following newline drops the partial tail and
    # nothing else.
    samples = [(int(m.group("round")), int(m.group("free")))
               for m in re.finditer(pattern + r"(?=\s*\n)", out)]
    if not samples:
        return False, "no progress lines matched -- did the app run?"

    # AND THE MIDDLE CAN BE CORRUPT TOO, which the anchor above does not cover.
    # A UART capture can splice: on wukongFull 2026-09-14 a chunk was replayed
    # and the join left one short record WITH a newline after it --
    #     R704395 f=261779028
    #     R704396 f=2            <- truncated, newline follows
    #     R704395 f=261779028    <- round goes BACKWARDS
    # -- and that 2 became the low-water mark, reporting "free floor fell
    # 261900882 bytes" on a board whose free memory had moved by 122 KB.
    #
    # Two rules, both about the STREAM rather than the heap:
    #   rounds advance     GcStressTest prints them strictly increasing, so a
    #                      record that does not advance is a replay, not data.
    #   no lone cliff      a truncated decimal is a PREFIX, so it is smaller by
    #                      orders of magnitude. This workload moves free by
    #                      ~1.5 KB per round, so a single sample below half its
    #                      predecessor is corruption. A real collection raises
    #                      free; it never divides it.
    #
    # And a lost burst can MERGE two lines into a record whose round runs
    # AHEAD -- the A-E115FB soak, 2026-10-12: "R53097", then "R53053100"
    # ("R530" + "53100"), then "R53101". Taken as the new high-water mark, it
    # made every later record look like a replay: 98 % of 3.37 M samples were
    # dropped, and the floor was judged on what was left. So two more rules
    # run first, each on one record and its raw neighbours:
    #   32 bits            the counter is a Java int; a longer number is a merge
    #   lone outlier       a record out of order with two neighbours that agree
    #                      with each other is the corrupt one. (A replay is not
    #                      an outlier: its neighbours disagree too, and the
    #                      advance rule below drops it.)
    # The free value gets the same two: the soak also printed
    # "R137554 f=10673444956" between two records of f=1067344956. A value that
    # GREW passes the cliff rule below, which only catches shrinking, and then
    # every real record after it reads as "below half". A free value more than
    # double or under half of two neighbours that agree to 1 % is the merge or
    # the truncation, not a collection: a real recovery agrees with the record
    # after it.
    rs = [r for r, _ in samples]
    fs = [f for _, f in samples]
    dropped = 0
    plausible = []
    for i, (r, f) in enumerate(samples):
        inner = 0 < i < len(samples) - 1
        lone_r = inner and rs[i - 1] < rs[i + 1] and not rs[i - 1] < r < rs[i + 1]
        lone_f = (inner and abs(fs[i - 1] - fs[i + 1]) * 100 <= fs[i - 1]
                  and (f * 2 < fs[i - 1] or f > fs[i - 1] * 2))
        if r > 0x7FFFFFFF or f > 0x7FFFFFFF or lone_r or lone_f:
            dropped += 1
            continue
        plausible.append((r, f))
    clean, last_r, last_f = [], -1, None
    for r, f in plausible:
        if r <= last_r or (last_f is not None and f * 2 < last_f):
            dropped += 1
            continue
        clean.append((r, f)); last_r, last_f = r, f
    if clean:
        samples = clean

    rounds = max(r for r, _ in samples)
    if rounds < min_rounds:
        return False, f"reached round {rounds}, wanted at least {min_rounds}"

    # Skip the first tenth: the heap settles before it is meaningfully level.
    warm = samples[len(samples) // 10:] or samples
    if len(warm) < 4:
        return True, f"{rounds} rounds (too few samples to judge the floor)"

    half = len(warm) // 2
    early_floor = min(f for _, f in warm[:half])
    late_floor = min(f for _, f in warm[half:])
    drop = early_floor - late_floor
    if drop > drift:
        return False, (f"free floor fell {drop} bytes ({early_floor} -> "
                       f"{late_floor}) between rounds {warm[0][0]} and "
                       f"{warm[-1][0]}, allowed {drift} -- possible leak")

    band = max(f for _, f in warm) - min(f for _, f in warm)
    # Count the recoveries. A collection shows up as free memory going UP; a
    # series with none of them is a staircase however wide its min-to-max
    # spread, and calling that spread a "band" invites exactly the reading
    # item 64 made.
    ups = sum(1 for i in range(1, len(warm)) if warm[i][1] > warm[i - 1][1])
    shape = (f"sawtooth band {band} over {ups} recoveries" if ups
             else f"MONOTONE: free never rose in {len(warm)} samples, spread {band}")
    noise = f", {dropped} corrupt record(s) dropped" if dropped else ""
    return True, (f"{rounds} rounds, floor steady at {late_floor} "
                  f"(drop {drop}, {shape}{noise})")


def judge(out):
    """Count what the JVM said. `ok` lines and an explicit exit are the signal;
    a test name containing 'Exception' is not a failure, which is why this
    matches 'fail' as a word rather than searching for scary substrings."""
    ok = len(re.findall(r"\bok\s*$", out, re.M))
    # `failed` AND `fail`. The original pattern required no letter after "fail",
    # to avoid flagging a test NAMED for an exception -- but DoAll.java:149
    # prints " failed!" on every failing test, and `fail` followed by `ed` fails
    # that trailing boundary. So the one word this needed to catch was the one
    # word it could not, and every hardware run reported fail=0 by
    # construction. Found 2026-09-15: DeepRecursion failed on the DB V5 and
    # hw_verify printed "ok=68 fail=0 ... PASS" while the console said
    # "DeepRecursion failed!".
    #
    # The suffixes are enumerated rather than left open (`fail\w*`) so a test
    # named for an exception still does not match -- test_a_test_named_for_an_
    # exception_is_not_a_failure is the control.
    fails = len(re.findall(r"(?<![A-Za-z])fail(?:ed|ure|s)?(?![A-Za-z])", out, re.I))
    exited = "JVM exit!" in out
    crashed = out.count("Uncaught exception")
    return ok, fails, exited, crashed


# "DoAll: 68 tests" -- the app's own statement of how many tests it runs.
ANNOUNCE_RE = re.compile(r"^\s*\w+: (\d+) tests\s*$", re.M)


def judge_count(out, expect_ok=None):
    """Verdict for an app that prints one `ok` line per test (DoAll).

    THE BAR COMES FROM THE APP. `--expect-ok` defaulted to 66, the suite's size
    when the default was written; DoAll grew to 68 and the default did not, so
    a run in which two tests printed nothing still passed. DoAll now prints
    "DoAll: N tests" (N = tc.length) before it starts, and every announced test
    must print `ok`. --expect-ok can raise that bar, never lower it: a flag
    written into a doc goes stale exactly as the default did. With neither, no
    number of `ok` lines is a pass.
    """
    ok, fails, exited, crashed = judge(out)
    m = ANNOUNCE_RE.search(out)
    counts = [n for n in (int(m.group(1)) if m else None, expect_ok) if n is not None]
    if not counts:
        return False, "no-count (the app announced none; pass --expect-ok)"
    want = max(counts)
    return ok >= want and fails == 0 and crashed == 0, f"want={want}"


# --------------------------------------------------------------------------
# Timing, read from the report that sits beside the bitstream.
#
# WHY THIS IS HERE. This script read the console and NOTHING else, so it could
# not tell a real pass from a lucky one. On 2026-08-26 `ep4cgx150BramSerial`
# printed `Hello World!` and was recorded as a hardware pass; it misses setup by
# 2.544 ns. This project's own rule is that a pass on a violated bitstream
# proves nothing -- it can misbehave arbitrarily and the failure is
# intermittent -- and the rule was applied correctly to the Wukong's violated
# flows an hour earlier, then skipped here. A judgement that depends on
# remembering to look something up is one that will be skipped again.
#
# The report is always next to the bitstream. Reading it costs nothing.
# --------------------------------------------------------------------------

def _quartus_timing(path):
    """Worst setup slack over every corner in a .sta.rpt.

    Takes the MINIMUM across corners rather than a named one. Quartus reports
    Slow 100C first and it is usually worst, but `usually` is not `always` --
    Slow -40C wins on some designs -- and picking a corner by name is how a
    board gets called clean on the strength of the wrong table."""
    corner, worst, in_tbl = None, None, False
    for line in open(path, errors="replace"):
        # Substring test BEFORE the regex. A DDR2 report is 297k lines of very
        # wide tables, and `(.+?)` backtracking across them took 2m09s -- which
        # reads as a hang, on a script whose whole job is to fail fast.
        m = (re.match(r"^;\s*(.+?)\s+Model Setup Summary\s*;", line)
             if "Model Setup Summary" in line else None)
        if m:
            corner, in_tbl = m.group(1), True
            continue
        if in_tbl:
            if not line.startswith((";", "+")):
                in_tbl = False
                continue
            cells = [c.strip() for c in line.split(";")]
            if len(cells) >= 4:
                try:
                    slack = float(cells[2])
                except ValueError:
                    continue
                if worst is None or slack < worst[0]:
                    worst = (slack, corner, cells[1])
    if worst is None:
        return None, "no setup summary in .sta.rpt"
    slack, corner, clk = worst
    verdict = "MET" if slack >= 0 else "VIOLATED"
    return verdict, f"setup {slack:+.3f} ns ({corner}, {clk})"


def _vivado_timing(path):
    for line in open(path, errors="replace"):
        m = re.search(r"Timing:\s+(MET|VIOLATED)\s*(\(.*\))?", line)
        if m:
            return m.group(1), (m.group(2) or "").strip("() ")
    return None, "no Timing line in fit_summary.txt"


def _nextpnr_timing(path):
    """LAST verdict per clock, never the first.

    nextpnr prints Fmax twice: a post-PLACE estimate and the post-ROUTE result,
    and they disagree -- 32.56 MHz FAIL then 49.40 MHz PASS for the same clock
    on the i5. Grepping the first one invented a board failure and two
    conclusions drawn from it."""
    seen = {}
    for line in open(path, errors="replace"):
        m = re.search(r"Max frequency for clock\s+'([^']+)':\s*"
                      r"([\d.]+)\s*MHz\s*\((PASS|FAIL) at ([\d.]+) MHz\)", line)
        if m:
            seen[m.group(1)] = (m.group(3), m.group(2), m.group(4))
    if not seen:
        return None, "no Max frequency line in nextpnr log"
    bad = [(c, v) for c, v in seen.items() if v[0] == "FAIL"]
    if bad:
        c, (_, got, want) = bad[0]
        return "VIOLATED", f"{c} {got} MHz < {want} MHz (post-route)"
    worst = min(seen.items(), key=lambda kv: float(kv[1][1]) - float(kv[1][2]))
    c, (_, got, want) = worst
    return "MET", f"{c} {got} MHz >= {want} MHz (post-route)"


def timing_status(cfg_dir):
    """(verdict, detail) -- verdict is 'MET', 'VIOLATED' or None if unknown."""
    for sub, pat, fn in (("quartus/output_files", ".sta.rpt", _quartus_timing),
                         ("vivado/build", "fit_summary.txt", _vivado_timing),
                         ("nextpnr", ".log", _nextpnr_timing)):
        d = os.path.join(cfg_dir, sub)
        if not os.path.isdir(d):
            continue
        hits = sorted(f for f in os.listdir(d) if f.endswith(pat))
        if hits:
            return fn(os.path.join(d, hits[0]))
    return None, "no timing report found"


def main():
    ap = argparse.ArgumentParser()
    ap.add_argument("preset")
    ap.add_argument("args", nargs="*")
    ap.add_argument("--app", default="JvmTests/DoAll")
    # Exercisers have no .jop: they run as soon as the FPGA is configured.
    ap.add_argument("--no-app", action="store_true",
                    help="program and monitor only -- for standalone exercisers")
    ap.add_argument("--runs", type=int, default=1)
    ap.add_argument("--expect-ok", type=int, default=None,
                    help="ok lines required; DoAll announces its own count, "
                         "and this can only raise it")
    # Not every app reports as a count of `ok` lines. SmpGcTest prints one
    # verdict, "SMPGC OK", and it is the ONLY test that runs all cores --
    # nothing in JvmTests writes IO_SIGNAL, so DoAll runs on core 0 whatever
    # cpuCnt says. An SMP build verified with DoAll would prove nothing about
    # the other cores.
    ap.add_argument("--expect-text", default=None)
    # Soak mode. `--expect-text` cannot express "got far enough and did not
    # leak", which is the only thing a GC soak is actually asserting.
    ap.add_argument("--min-rounds", type=int, default=None,
                    help="soak: require the round counter to reach at least N")
    ap.add_argument("--max-free-drift", type=int, default=0,
                    help="soak: bytes the free FLOOR may fall (a sawtooth band is fine)")
    ap.add_argument("--progress-re", default=PROGRESS_RE,
                    help="soak: regex with named groups 'round' and 'free'")
    ap.add_argument("--timeout", type=int, default=300)
    # Which physical unit (status item 174, step 4): a name from
    # setup/units.toml. Needed when an assembly has several units; the
    # image then comes from that unit's own Java tree (JOP_INSTANCE=).
    ap.add_argument("--instance", default=None,
                    help="board instance name, e.g. jop-i5-1")
    # An escape hatch, not a default. Running a violated bitstream on
    # purpose is legitimate -- to see HOW it fails, or to measure a
    # board while a fix is in flight. Claiming the result as a pass
    # afterwards is not, so the log line records the override.
    ap.add_argument("--allow-violated", action="store_true",
                    help="run even though the build misses timing")
    a = ap.parse_args()

    d = descriptor(a.preset, list(a.args) + (["--instance", a.instance] if a.instance else []))
    for key in ("PROBE_ALIAS", "CONSOLE_ALIAS"):
        if key not in d:
            die(f"board '{d['BOARD']}' has no {key}: no board instance covers this unit.\n"
                f"  Add one to setup/units.toml (or $JOP_SETUP/units.toml):\n"
                f"  probe, console, loader. This board cannot be\n"
                f"  hardware-verified until then.")

    cfg_dir = os.path.join(ROOT, d["CONFIG_DIR"])
    bitstream = find_bitstream(cfg_dir, d.get("PROGRAM_TOOL"))

    # THE BITSTREAM MUST NOT BE OLDER THAN THE RTL EITHER (2026-09-14).
    # `make all` rebuilds the .sof; only `make program` regenerates the .rbf,
    # and find_bitstream PREFERS the .rbf for openFPGALoader. The CYC5000 spent
    # an afternoon looking like a software hang -- IO_GC_HALTED read 0 where an
    # identical board read 1, with byte-identical RTL and the same .jop --
    # because the register being polled did not exist in the three-day-old
    # bitstream on the chip. DoAll passed on it, which is what made it look like
    # a software bug rather than a stale artefact.
    stale_bits = stale_sources(bitstream, [os.path.join(cfg_dir, "rtl")],
                               exts=(".v", ".vhd"))
    if stale_bits:
        die("the bitstream is OLDER than the RTL it was built from -- this run\n"
            "  would test a chip that does not contain the design:\n"
            "    bitstream {}\n"
            "    newer     {}\n"
            "  rebuild it. Note `make all` may refresh only the .sof: the .rbf\n"
            "  is regenerated by the program target, and openFPGALoader reads\n"
            "  the .rbf."
            .format(os.path.relpath(bitstream, ROOT), "\n              ".join(stale_bits)))

    tv, td = timing_status(cfg_dir)
    if tv == "VIOLATED" and not a.allow_violated:
        die(f"{a.preset} MISSES TIMING -- {td}\n"
            f"  A pass on a violated bitstream proves nothing: it can misbehave\n"
            f"  arbitrarily and the failure is intermittent, so a green run is\n"
            f"  not evidence the design works.\n"
            f"  Fix the timing, or pass --allow-violated to run it anyway (the\n"
            f"  log will record that the result is not a verification).")
    if tv is None:
        print(f"hw_verify: WARNING -- timing unknown ({td}). "
              f"This run cannot be counted as a verification.", file=sys.stderr)
    jop = None
    if not a.no_app:
        # The descriptor says where this unit's images are: its own Java tree
        # when an instance is named, the preset's otherwise.
        java_dir = os.path.join(ROOT, d["JAVA_DIR"]) if "JAVA_DIR" in d else os.path.join(cfg_dir, "java")
        jop = os.path.join(java_dir, "apps", a.app + ".jop")
        inst = f" JOP_INSTANCE={a.instance}" if a.instance else ""
        if not os.path.exists(jop):
            die(f"no image at {jop} -- build it with:\n"
                f"  make -C java JOP_PRESET={a.preset}{inst} tools runtime\n"
                f"  make -C java/apps/{a.app.split('/')[0]} JOP_PRESET={a.preset}{inst} clean\n"
                f"  make -C java/apps/{a.app.split('/')[0]} JOP_PRESET={a.preset}{inst}\n"
                f"(BUILDTREE=1 was the opt-in for the old dual layout; there is\n"
                f" only one layout now and the variable no longer exists.)")
        # PRESET PLUS ITS ARGS. `ep4cgx150Smp 8 50` and `ep4cgx150Smp` are
        # different configs with different build directories, so a hint naming
        # only the preset rebuilds the wrong one -- and the next run would then
        # still be stale, with the message insisting it had been fixed.
        cfg = " ".join([a.preset] + list(a.args)) + inst
        app_dir = os.path.join(ROOT, "java", "apps", a.app.split("/")[0], "src")
        rt_dir  = os.path.join(ROOT, "java", "runtime", "src")
        stale = stale_sources(jop, [d for d in (app_dir, rt_dir) if os.path.isdir(d)]
                              + linked_library_dirs(jop))
        if stale:
            die("the app image is OLDER than its source -- this run would test\n"
                "  code that is not in it, and would look like a clean result:\n"
                "    image  {}\n"
                "    newer  {}\n"
                "  rebuild first:\n"
                "    make -C java runtime JOP_PRESET=\"{}\"\n"
                "    make -C java/apps/{} clean JOP_PRESET=\"{}\"\n"
                "    make -C java/apps/{} JOP_PRESET=\"{}\""
                .format(os.path.relpath(jop, ROOT), "\n           ".join(stale),
                        cfg, a.app.split("/")[0], cfg,
                        a.app.split("/")[0], cfg))

    log = os.path.join(cfg_dir, "hw_verify.log")
    passes = 0
    for i in range(1, a.runs + 1):
        program(d, bitstream)
        out = monitor_only(d, a.timeout) if a.no_app else run_app(d, jop, a.timeout)
        ok, fails, exited, crashed = judge(out)
        detail = ""
        if a.min_rounds is not None:
            good, detail = judge_soak(out, a.min_rounds, a.max_free_drift,
                                      a.progress_re)
            good = good and crashed == 0
        elif a.expect_text:
            # The expected text is necessary, not sufficient. Without the
            # `fails` term a run where T1 failed and T3 passed still went green,
            # because the string it was told to look for was present.
            good = a.expect_text in out and fails == 0 and crashed == 0
        else:
            good, detail = judge_count(out, a.expect_ok)
        passes += good
        # Keep the console text for EVERY run, pass or fail. A bare "PASS" with
        # nothing behind it is not evidence, and this is the only record that
        # the board actually said what the verdict claims.
        transcript = os.path.join(cfg_dir, f"hw_verify.run{i}.txt")
        with open(transcript, "w") as f:
            f.write(out)

        tstr = (f"timing={tv or 'unknown'}"
                + ("!OVERRIDDEN" if tv == "VIOLATED" else ""))
        line = (f"{datetime.now(timezone.utc).isoformat(timespec='seconds')} "
                f"{a.preset} {'@' + d['INSTANCE'] + ' ' if 'INSTANCE' in d else ''}"
                f"{'(no app)' if a.no_app else a.app} run={i}/{a.runs} "
                f"{'expect=' + repr(a.expect_text) + ' ' if a.expect_text else ''}"
                f"{detail + ' ' if detail else ''}"
                f"ok={ok} fail={fails} exit={exited} crash={crashed} {tstr} "
                f"{'PASS' if good else 'FAIL'}")
        with open(log, "a") as f:
            f.write(line + "\n")
        print(line)
        if not good:
            # Strip the downloader's progress bar before showing the tail.
            # It redraws with \r, so `splitlines()[-15:]` returns fifteen
            # copies of the bar and hides the actual failure -- which cost two
            # re-runs of ep4cgx150HwFloat before the transcript was read
            # directly and said `bytecode 114 not implemented` all along.
            lines = [l for l in out.replace("\r", "\n").splitlines()
                     if l.strip() and not l.lstrip().startswith("[")]
            tail = "\n".join(lines[-15:])
            print(f"--- last output ---\n{tail}\n-------------------")

    # NAME THE TRANSCRIPTS, not just the index. hw_verify.log is one line per
    # run by design; someone reading only that concluded the console output was
    # discarded, filed it as a defect, and reprogrammed a board to "recover"
    # text that was already on disk (status item 114). The evidence is useless
    # if the summary does not say where it is.
    tpat = os.path.relpath(os.path.join(cfg_dir, "hw_verify.run<N>.txt"), ROOT)
    print(f"\n{a.preset}: {passes}/{a.runs} passed   (log: {os.path.relpath(log, ROOT)})")
    print(f"  console transcript per run: {tpat}")
    if tv != "MET":
        print(f"NOT A VERIFICATION -- timing {tv or 'unknown'} ({td}). "
              f"The board ran; that is all this shows.")
    sys.exit(0 if passes == a.runs else 1)


if __name__ == "__main__":
    main()
