peteryates1/jop-spinalhdl/java/apps/JvmTests/src/jvm/DeepThrow.java

/*
  THROW FROM A STACK DEEPER THAN THE RESIDENT WINDOW — status item 133.

  WHAT THIS IS FOR. `f_athrow` unwinds frame by frame, reading each frame's
  saved pc/vp/cp/mp out of the stack:

      JVM.java:742  int fp = Native.getSP()-4;
      JVM.java:743  while (fp > Const.STACK_OFF+5) {
      JVM.java:745      int pc = Native.rdIntMem(fp+1)-1;
      JVM.java:746      int vp = Native.rdIntMem(fp+2);
      JVM.java:747      int cp = Native.rdIntMem(fp+3);
      JVM.java:748      int mp = Native.rdIntMem(fp+4);

  `Native.rdIntMem` addresses through AR: `jopsys_rdint` is `star / nop / ldmi`
  (asm/src/jvm.asm:2190-2193), and `star` (0x01a) latches AR. The stack cache
  rotates only on `smuxSignal`, and `selSmux = 3` — the case that routes an
  address rather than SP — is selected by exactly ONE instruction, `stsp` (0x01b,
  DecodeStage.scala:397). `star` is not it, and AR appears nowhere in the
  rotation controller (StackStage.scala:700-1000).

  So an AR-addressed read outside the resident window does not rotate. It
  returns ZERO — `ramDout := 0` is the mux default (StackStage.scala:511) — and
  the matching write is dropped (:622-631). `spOv` is keyed on `sp` alone
  (:1215-1222), so nothing faults. The unwind reads zeros for pc/vp/cp/mp and
  keeps going.

  WHY THE EXISTING TEST CANNOT SEE IT. `AthrowTest` is FLAT: its throws happen a
  couple of frames deep, so SP never approaches 639 and no bank has ever been
  rebased. The whole stack is resident and the unwind is correct. The resident
  window is 576 words (3 banks x 192 above 64 of scratch, bases 64/256/448), so
  the fault begins only once SP has exceeded 639 and a rotation has moved the
  window up.

  WHAT THIS DOES. Recurses with wide-ish frames until SP is well past 639 — the
  same shape as DeepRecursion, which measures maxSp 1905 at 200 levels — and
  THEN throws, so the unwind has to cross frames that are no longer resident.

  HOW IT CAN FAIL. Several ways, and all of them are informative:
    - the exception is not caught by the right handler (pc/mp read as 0, so the
      handler search runs against the wrong method)
    - it is reported uncaught
    - the machine wedges, which in DeepAll looks like "DeepThrow" and then
      silence — item 133 records that a non-cache board does exactly that when
      the stack overflows, because spOv was not wired
  A PASS means the unwind survived a non-resident stack, which would refute the
  RTL reading above and is worth knowing just as much.

  It lives in DeepAll rather than DoAll for the reason DeepAll exists: without a
  stack cache this depth overflows a 192-word usable stack and hangs.
*/
package jvm;

import com.jopdesign.sys.Native;
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
